PorterMatt/CherenkovDetector/PICAP (Jim Connell)/PICAP Documents/Soild State detector tests/IMG-20120413-00055.jpg

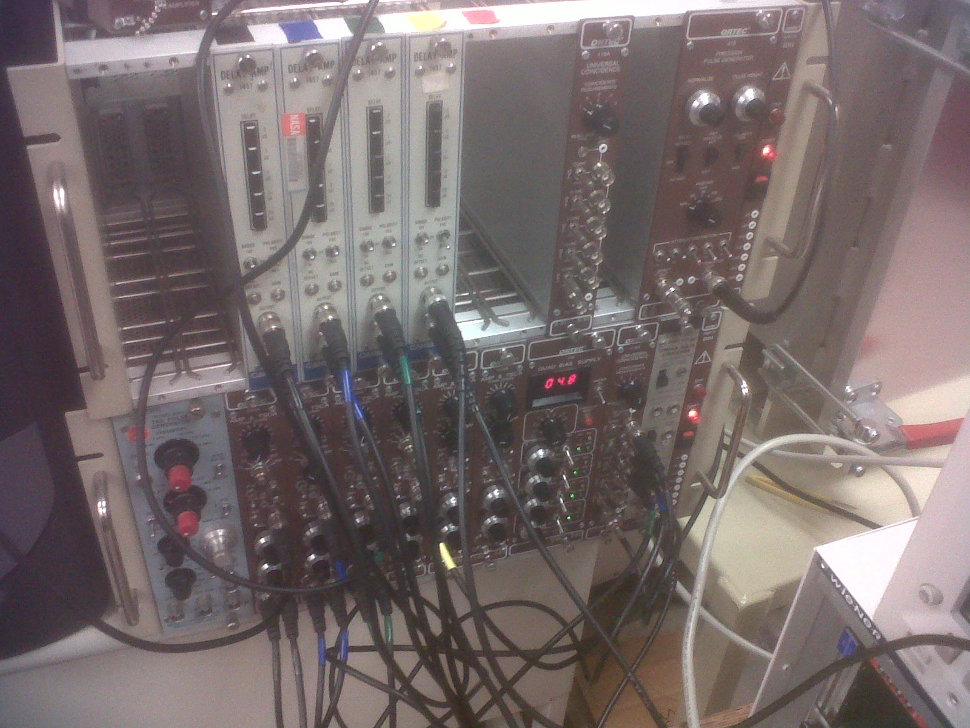
PICAP (Jim Connell)/PICAP Documents/Soild State detector tests/IMG-20120413-00055.jpg
