PorterMatt/CherenkovDetector/README.md

Cherenkov Light Detector. Matthew Porter
