PorterMatt/CherenkovDetector/PICAP (Jim Connell)/PICAP Documents/Reports and Presentations/PICAP review presentaion (2).pptx

## PICAP Design review

Brendan Bickford

## Outline

- Advisors
- Background
- Design specifications
- Concept Instrumentation
- Design Assemblies

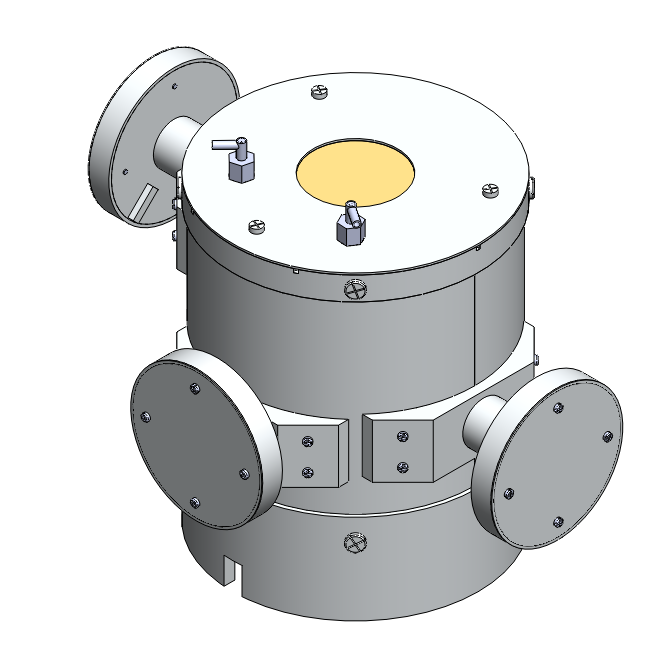
[picture p72: figure]

## Advisors

Advisors:
- Dr. May-Win Thein
- Dr. James Connell
- Dr. Clifford Lopate
Grad student:
Dan Tran

## Background

Positron Identification by Coincidental Annihilation Photons
- New design for detecting and distinguishing energetic particles (positions & negatrons)
- Project goal: Build and test a proof of principle prototype telescope

## Design Criteria and constrains

- Minimize mass within design constraints
- Specific placement and size for solid state detectors and scintillation material
- Provide efficient particle detection (structure limitations)
- Provide a working proof of principle prototype for this new detection method
- This means
- Faraday cage required
- Eliminate cross talk between scintillators
- Exclude light
- Purge ports for solid state detectors

## Flight vs. Prototype

- Conductive epoxy simple pieces rather then hog complex pieces from stock
- Custom off the self parts
- Minimize weight within budget, knowing this could be reproduced with less weight but at higher cost

## Instrument concept

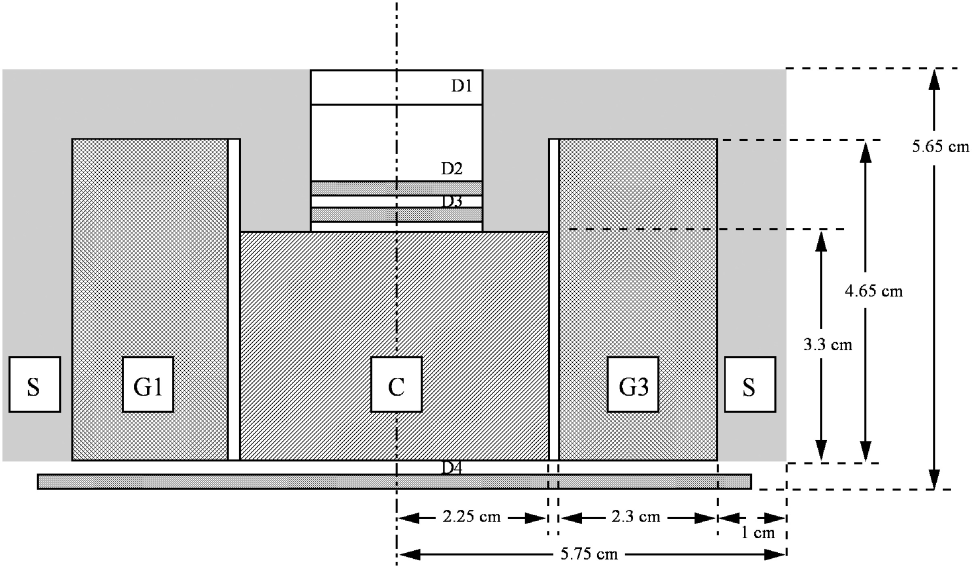
[picture p73: figure]

Cross section view of proposed design
C- Plastic scintillation material
G- Heavy scintillation material
D- Solid state detectors
S- Plastic scintillation material

## Instrument concept

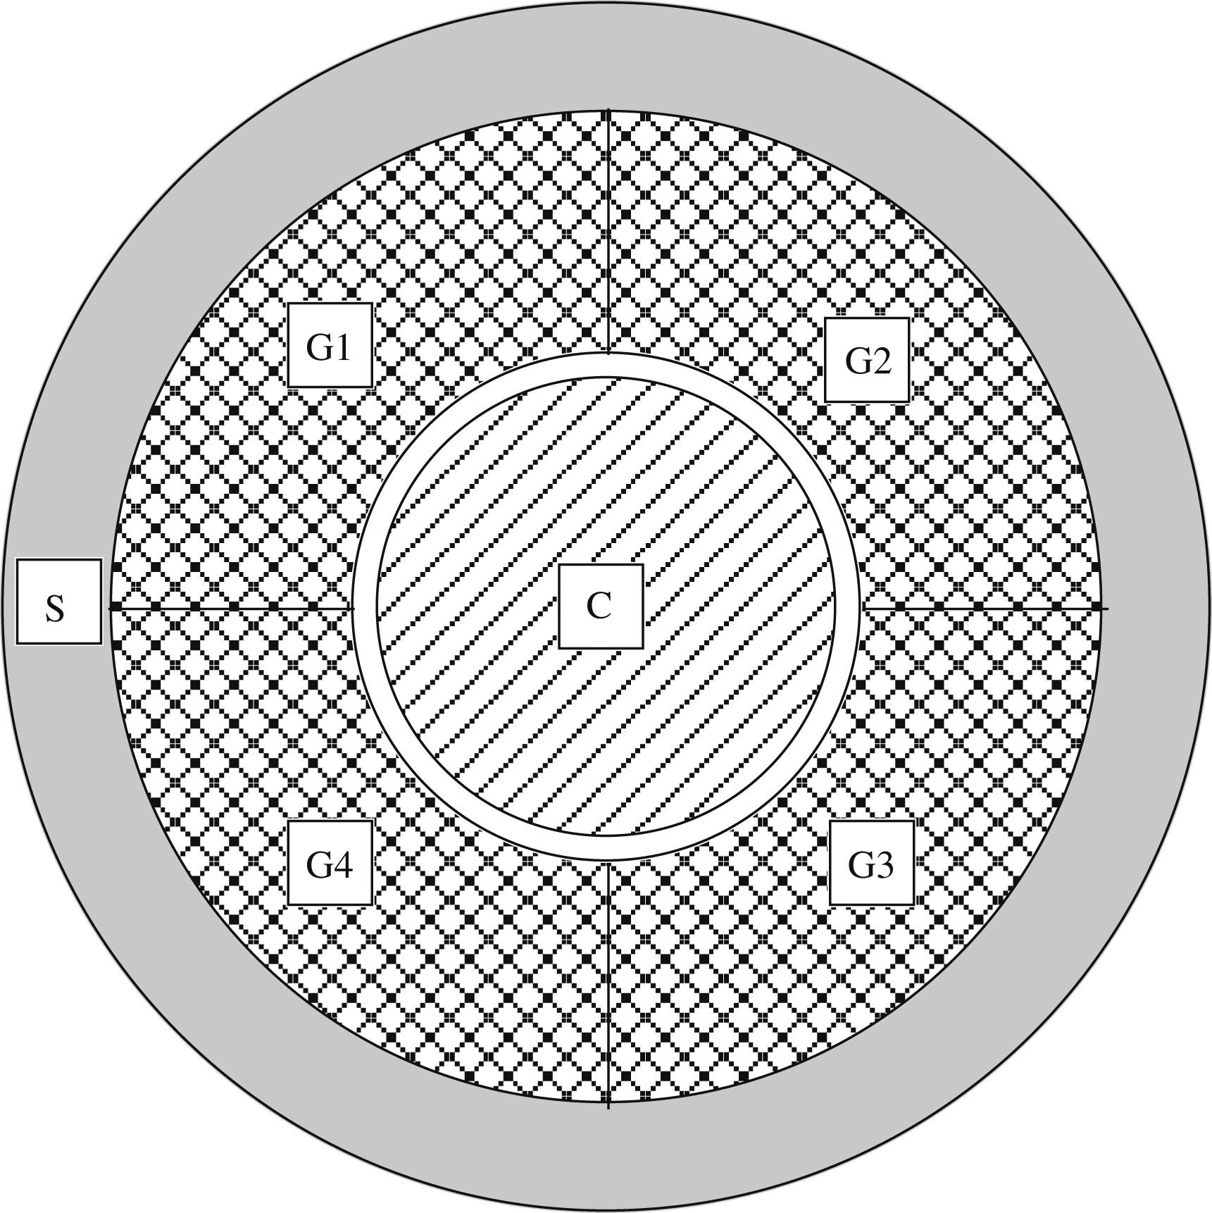
[picture p74: figure]

Top view proposed design
  - C- Plastic scintillation material
  - G- Heavy scintillation material
  - D- Solid state detectors
  - S- Plastic scintillation material

## Concept vs. Design

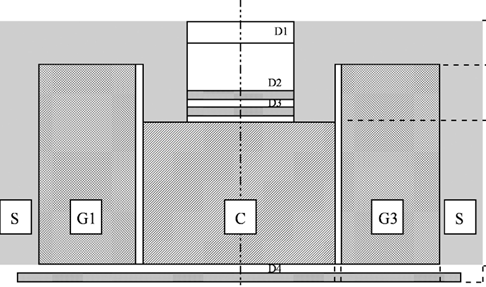
[picture p75: figure]

Cross section view
  - C- Plastic scintillation material
  - G- Heavy scintillation material
  - D- Solid state detectors
  - S- Plastic scintillation material

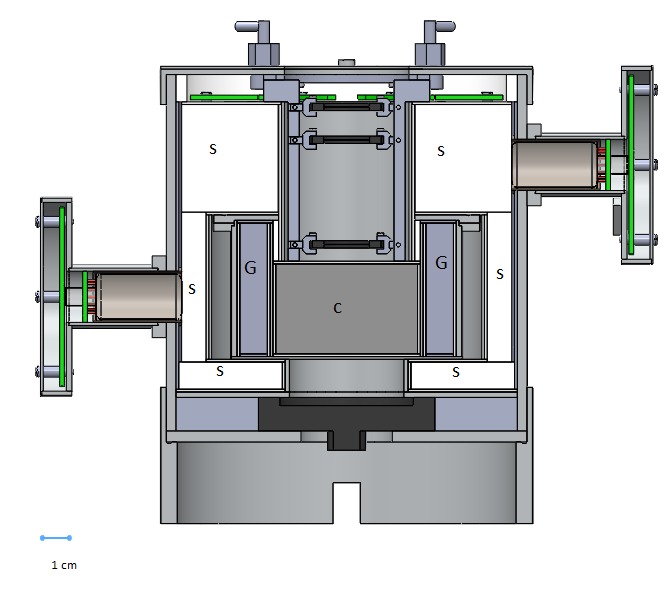
[picture p76: figure]

## Concept vs. Final design

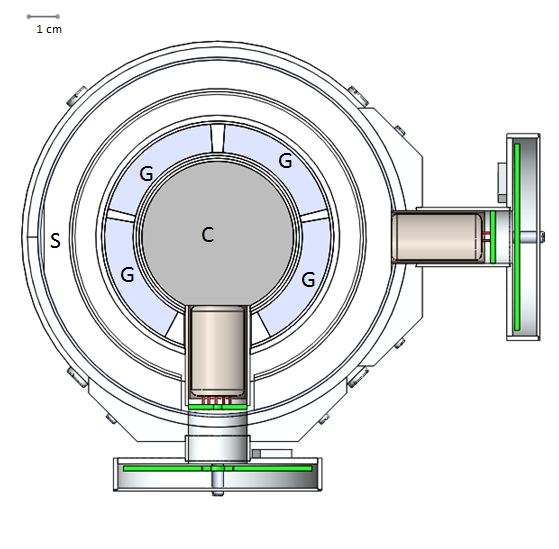
[picture p77: figure]

C- Plastic scintillation material
G- Heavy scintillation material
D- Solid state detectors
S- Plastic scintillation material

## Dimensions

Total Height | 16.78 cm
Total width | 22.47 cm
Total mass | 3.3 kg
Total Volume | 1985 cm^2

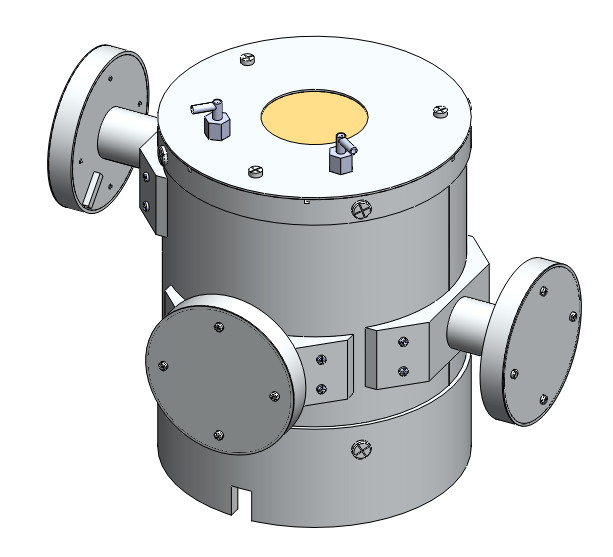
[picture p78: figure]

## Photomultiplier tube assembly

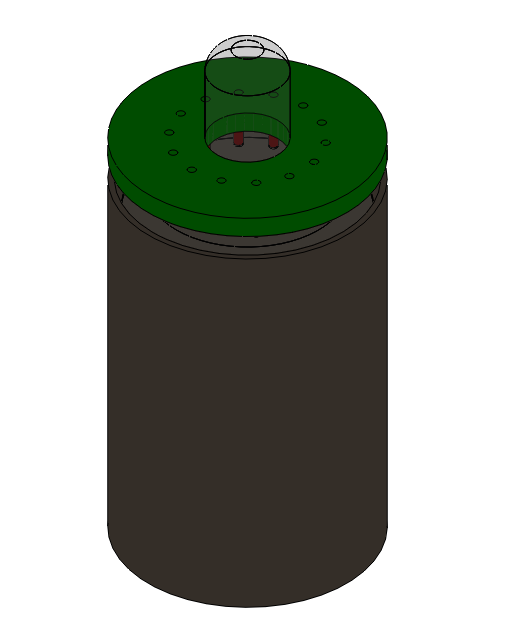
[picture p79: figure]

Red- Active components
Blue- Teflon
Black- Other

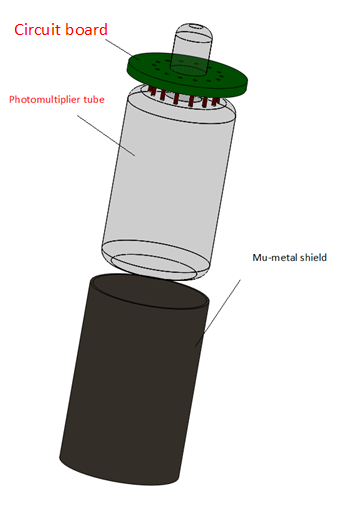
[picture p80: figure]

## Scintillator assembly

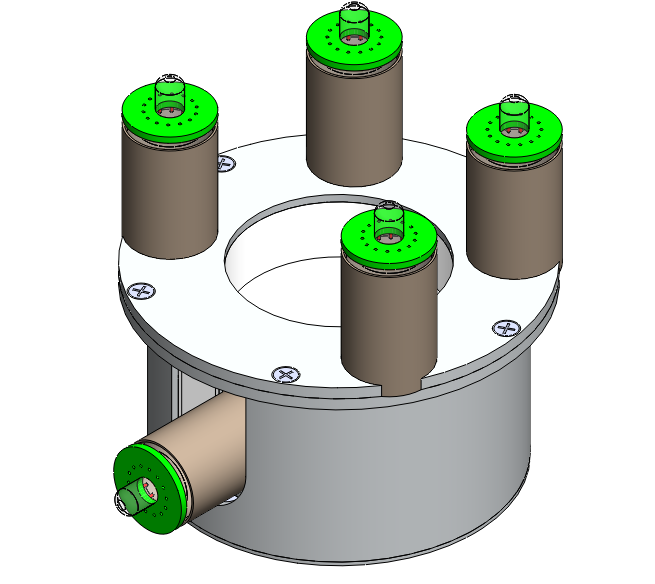
[picture p81: figure]

## Slide 14

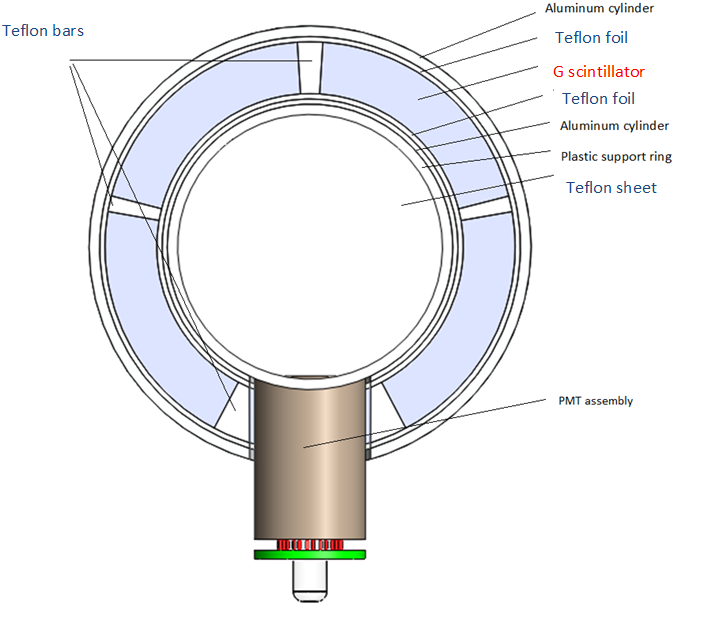
[picture p82: figure]

Scintillator assembly - top view cross section

## Slide 15

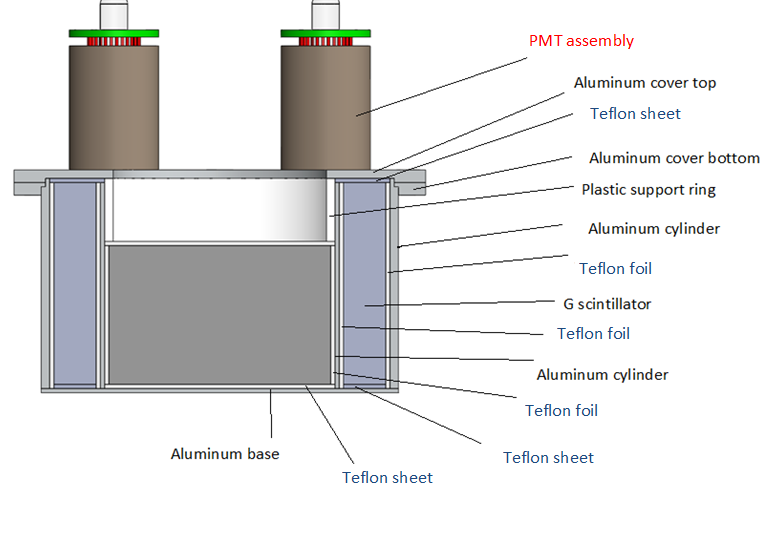
[picture p83: figure]

Scintillator assembly - center cross section

## Top Anti coincidence shield

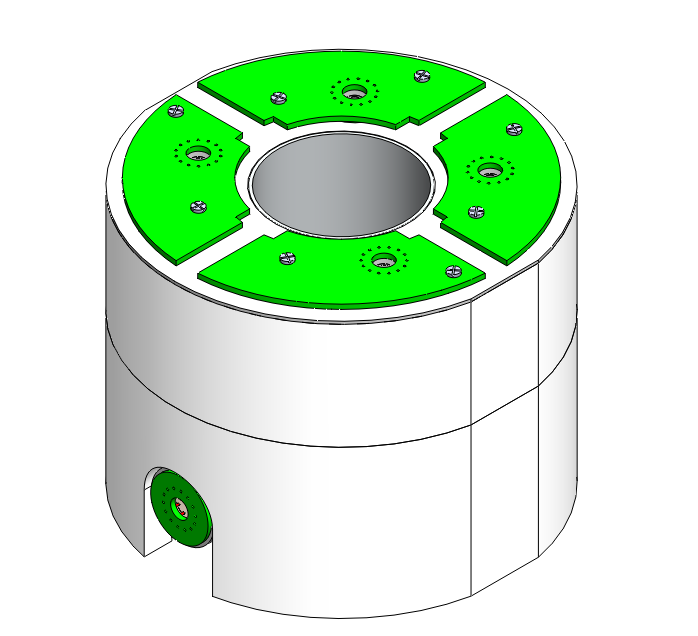
[picture p84: figure]

## Slide 17

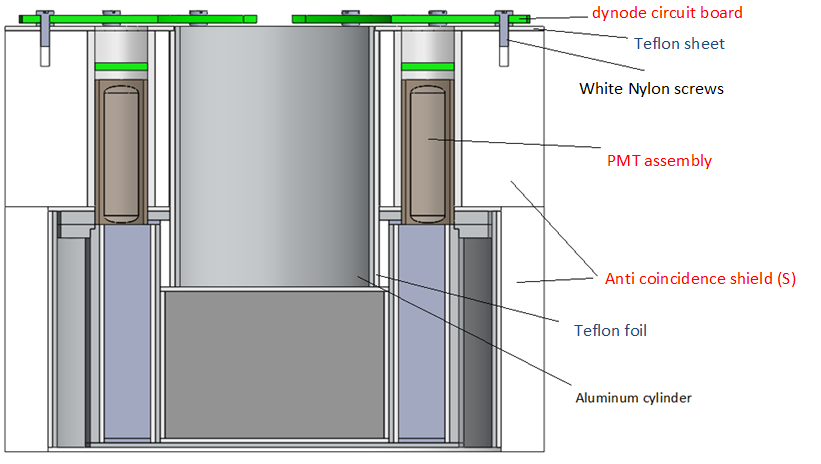
[picture p85: figure]

Anti coincidence shield – center cross section

## Slide 18

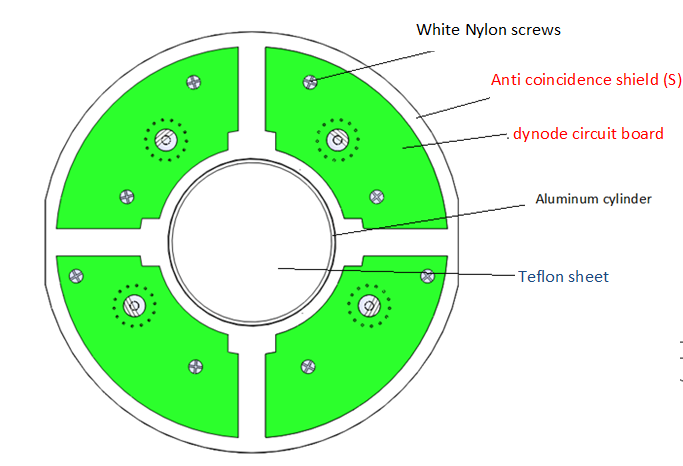
[picture p86: figure]

Anti coincidence shield - top view

Top view

## Cover assembly

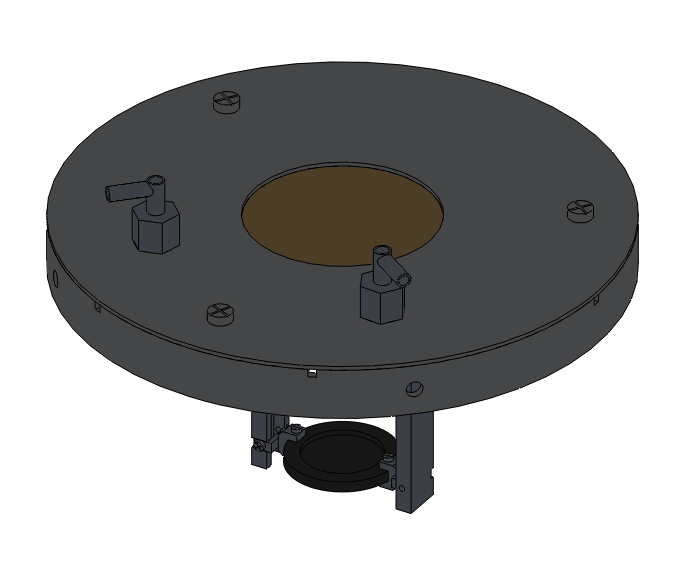
[picture p87: figure]

## Slide 20

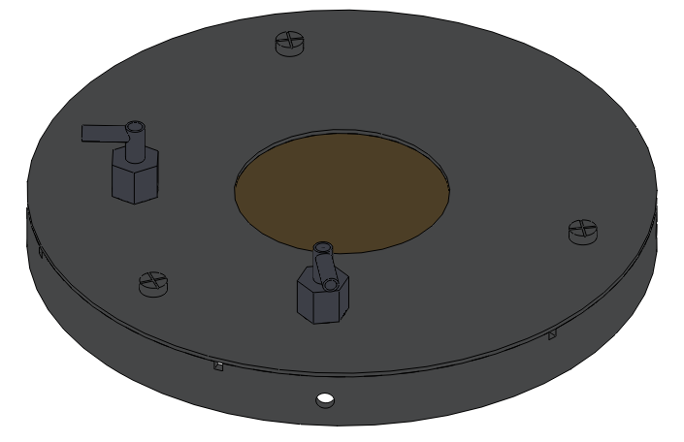
[picture p88: figure]

Cover and brass foil

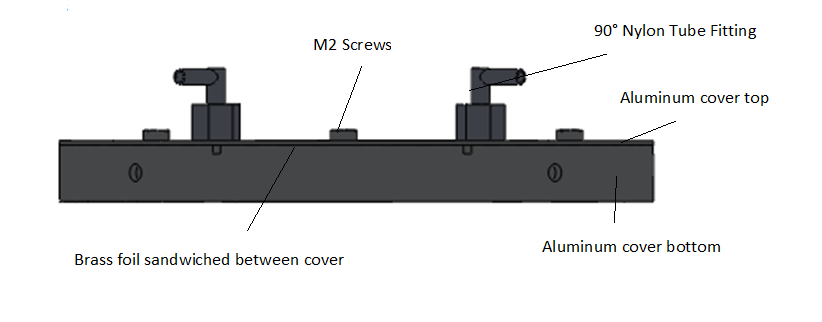
[picture p89: figure]

Cover and brass foil - side view

## Slide 21

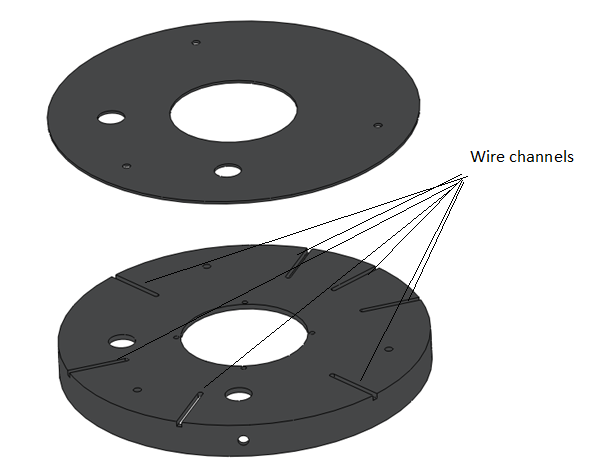
[picture p90: figure]

Cover - exploded view

## Slide 22

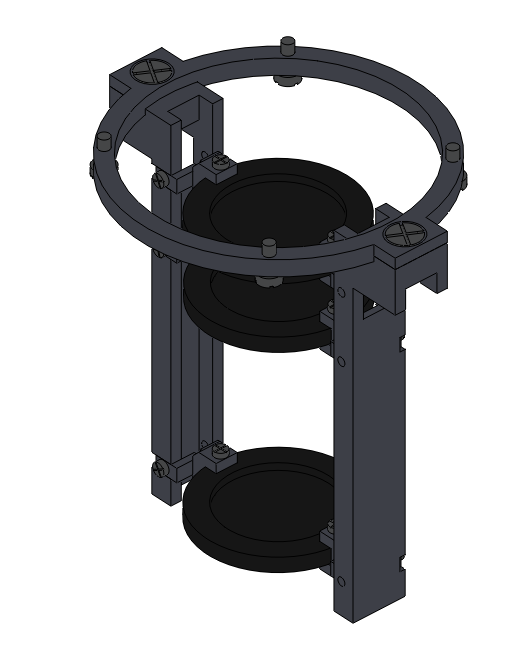
[picture p91: figure]

Solid state detector column assembly

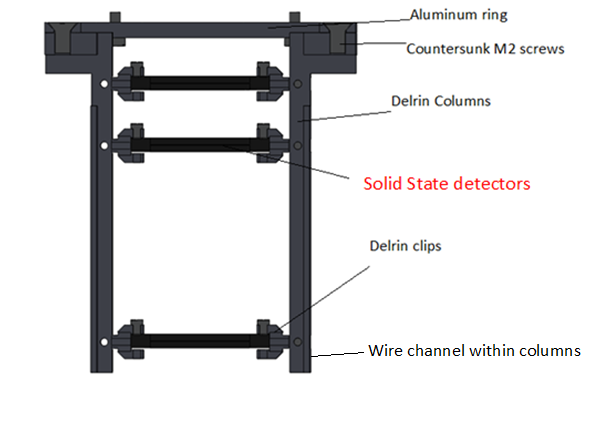
[picture p92: figure]

Center Cross section

## Base Assembly

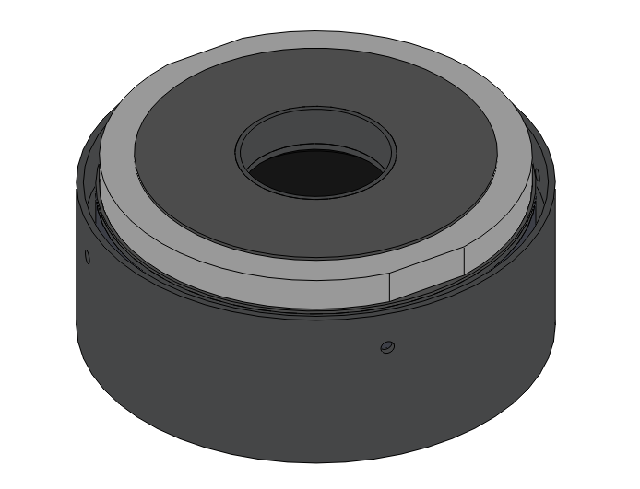
[picture p93: figure]

## Slide 24

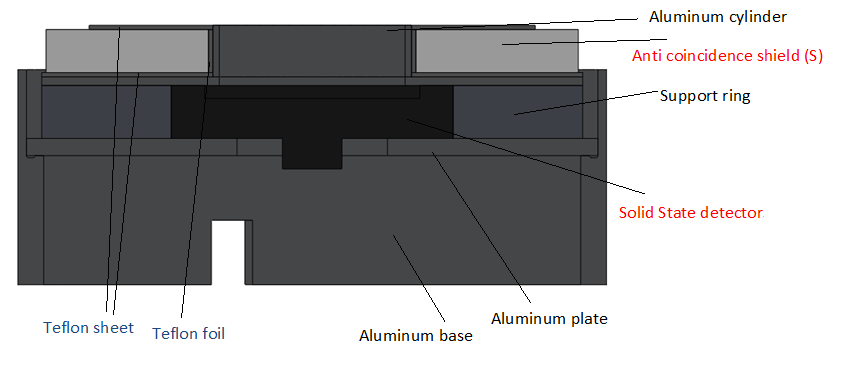
[picture p94: figure]

Base Assembly - center cross section

## Cylinder assembly

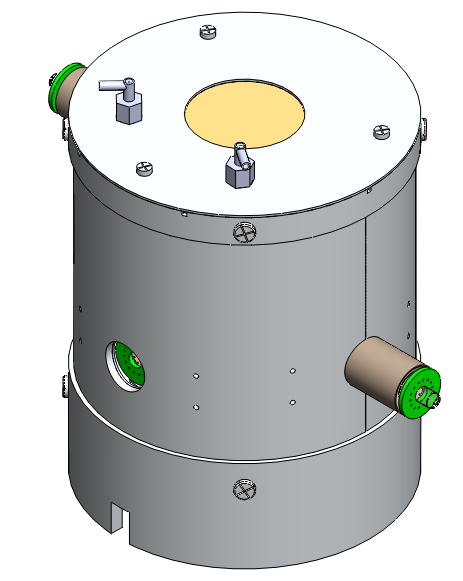
[picture p95: figure]

## Slide 26

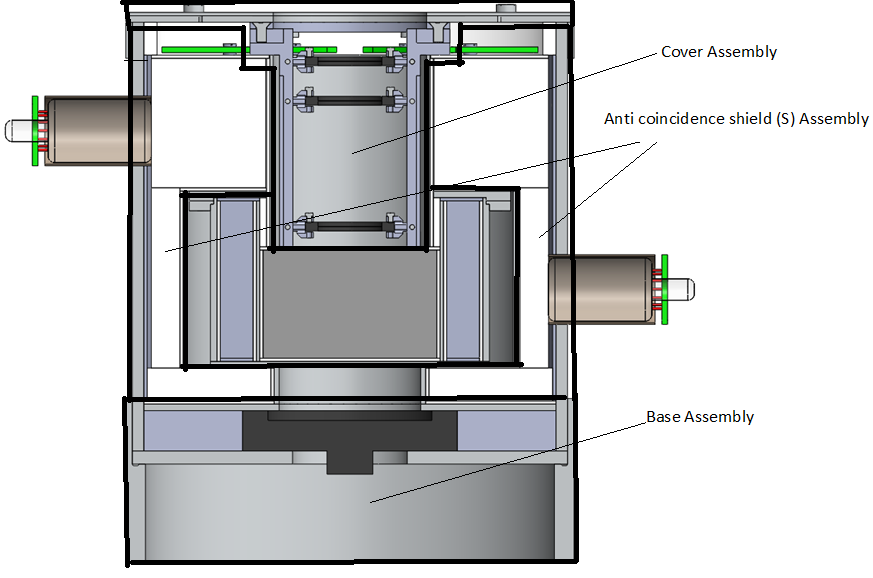
[picture p96: figure]

Cross section

Cylinder assembly - center cross section

## Photomultiplier tube support assembly

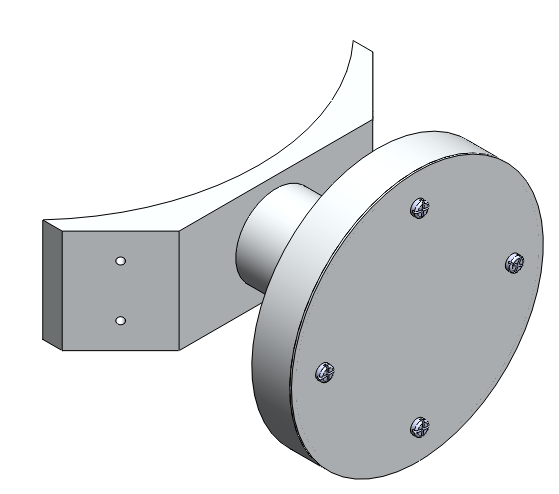
[picture p97: figure]

## Slide 28

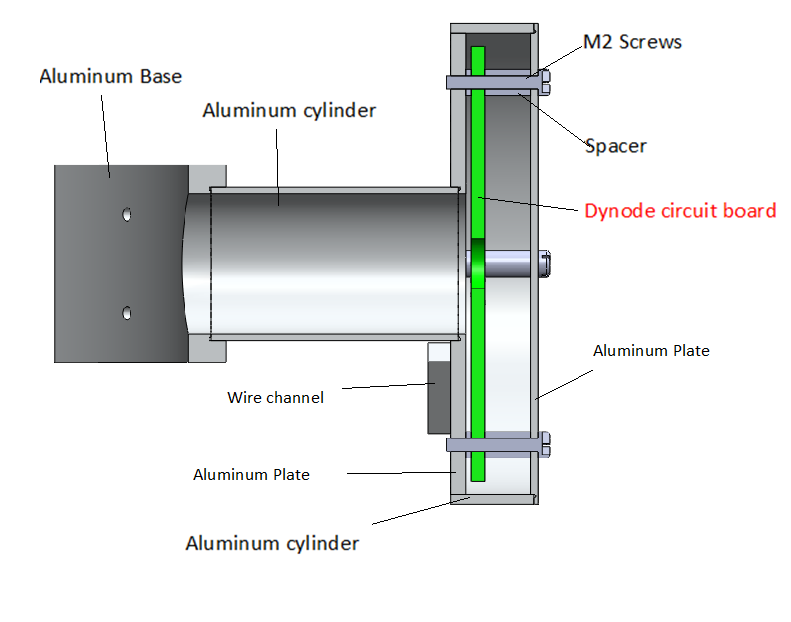
[picture p98: figure]

Photomultiplier tube support assembly – Center cross section

Top view

## Final assembly
