PorterMatt/CherenkovDetector/PICAP (Jim Connell)/PICAP Documents/Quotes/Proteus BGO.docx

Hello Brendan,

In our case, the tolerance change would only marginally affect the price, $2,050/piece. I am travelling, but will send a formal proposal over the weekend.

Thanks.

Best regards……….Philip

Philip Parkhurst

Proteus, Inc.

120 Senlac Hills Drive

Chagrin Falls, OH 44022 USA

440-247-1601

Cell: 216-470-2120

Fax:440-247-1602
