PorterMatt/CherenkovDetector/PICAP (Jim Connell)/PICAP Documents/Reports and Presentations/PICAP review presentaion.pdf

# PICAP

# Design review

# Brendan Bickford

# Outline

## - Advisors - Background - Design specifications

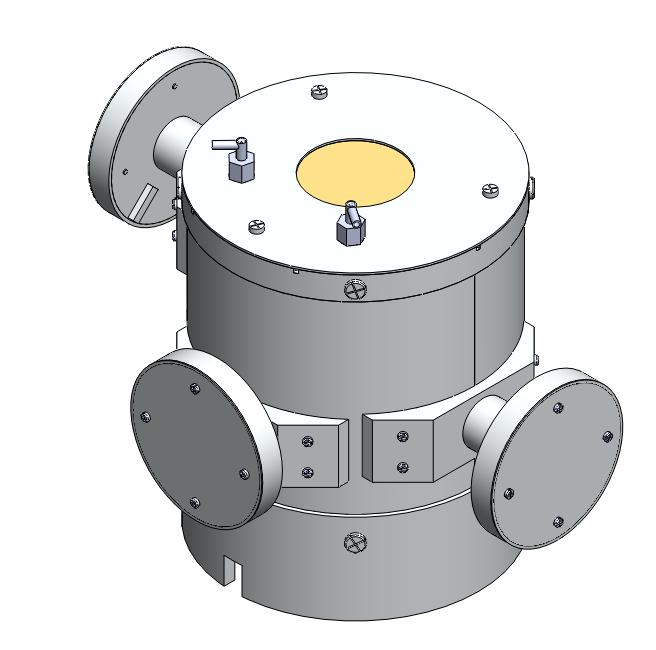
[picture p102: figure]

## - Concept Instrumentation - Design Assemblies

# Advisors

# Advisors: - Dr. May-Win Thein - Dr. James Connell - Dr. Clifford Lopate Grad student: Dan Tran

# Background

## Positron Identification by Coincidental Annihilation Photons

## - New design for detecting and distinguishing energetic particles (positrons & negatrons)

## - Project goal: Build and test a proof of principle prototype telescope

# Design Criteria and constrains

## - Minimize mass within design constraints - Specific placement and size for solid state detectors and scintillation material - Provide efficient particle detection (structure limitations) - Provide a working proof of principle prototype for this new detection method

## - This means - Faraday cage required - Eliminate cross talk between scintillators - Exclude light

- Purge ports for solid state detectors | 5

# Flight vs. Prototype

# - Conductive epoxy simple pieces rather then machine complex pieces from stock - Custom off the self parts - Minimize weight within budget, knowing this could be reproduced with less weight but at higher cost

# Instrument concept

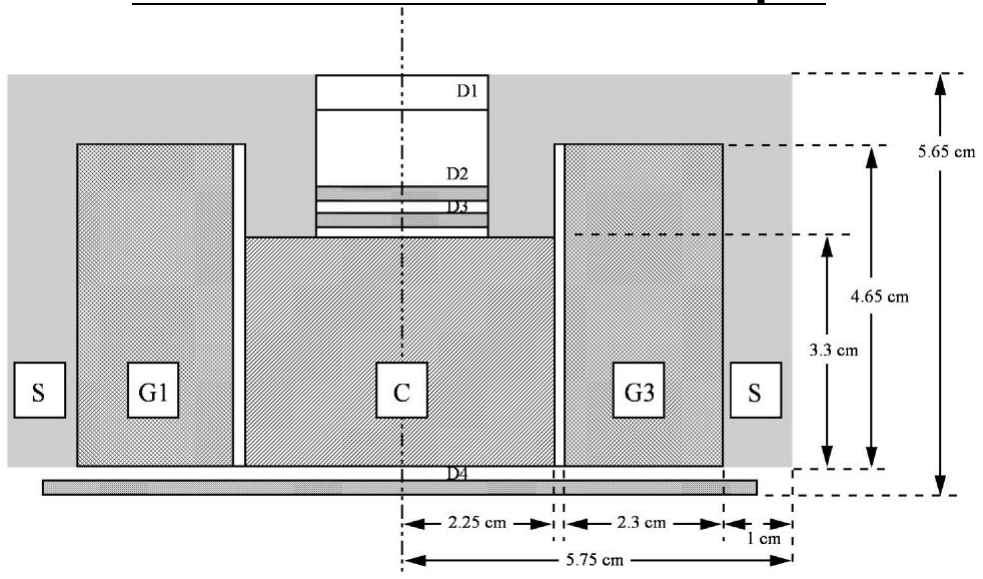
[picture p103: figure]

Cross section view of proposed design C- Plastic scintillation material G- Heavy scintillation material D- Solid state detectors
S- Plastic scintillation material

# Instrument concept

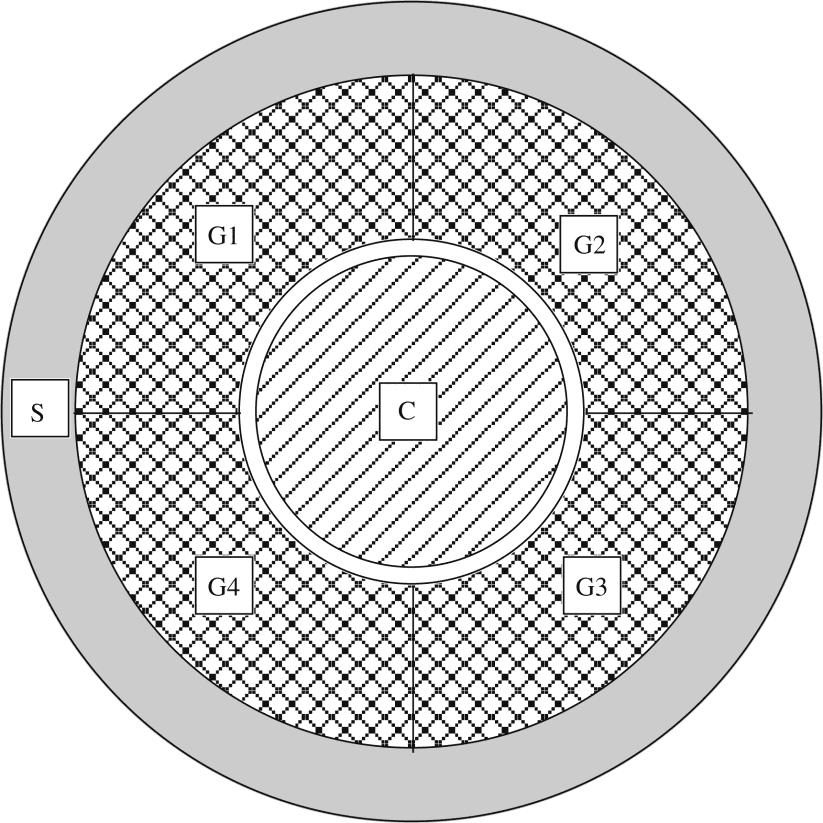
[picture p104: figure]

Top view proposed design
– C- Plastic scintillation material – G- Heavy scintillation material – D- Solid state detectors
– S- Plastic scintillation material

# Concept vs. Design

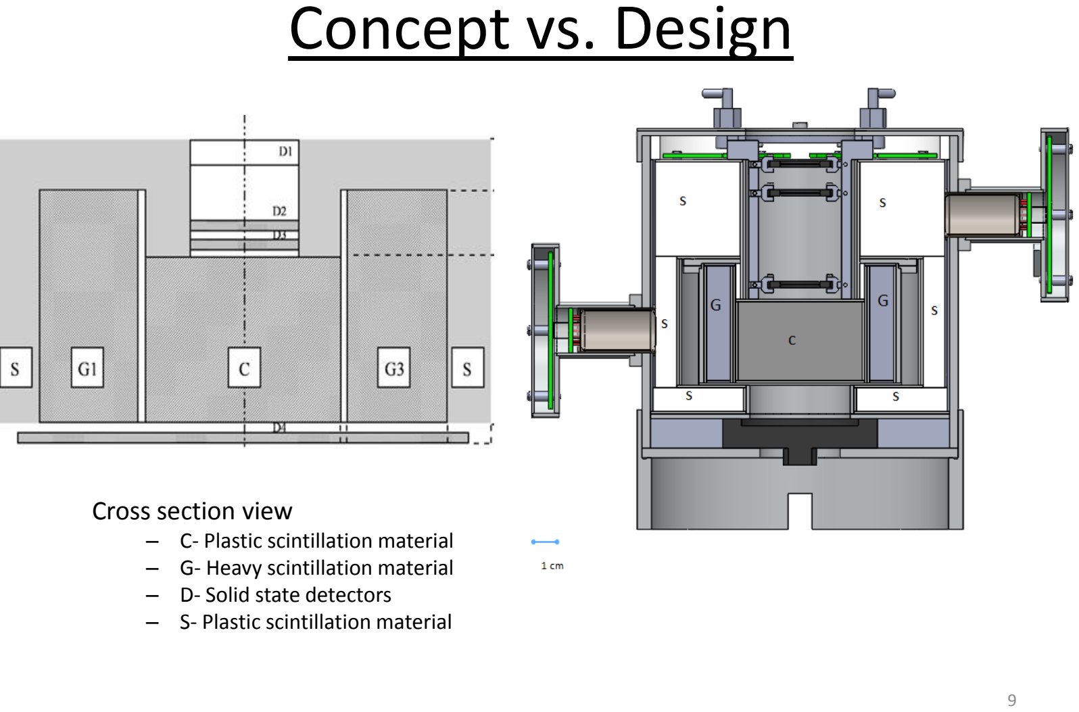
[picture p105: page 9]

Cross section view
– C- Plastic scintillation material – G- Heavy scintillation material – D- Solid state detectors
– S- Plastic scintillation material

# Concept vs. Final design

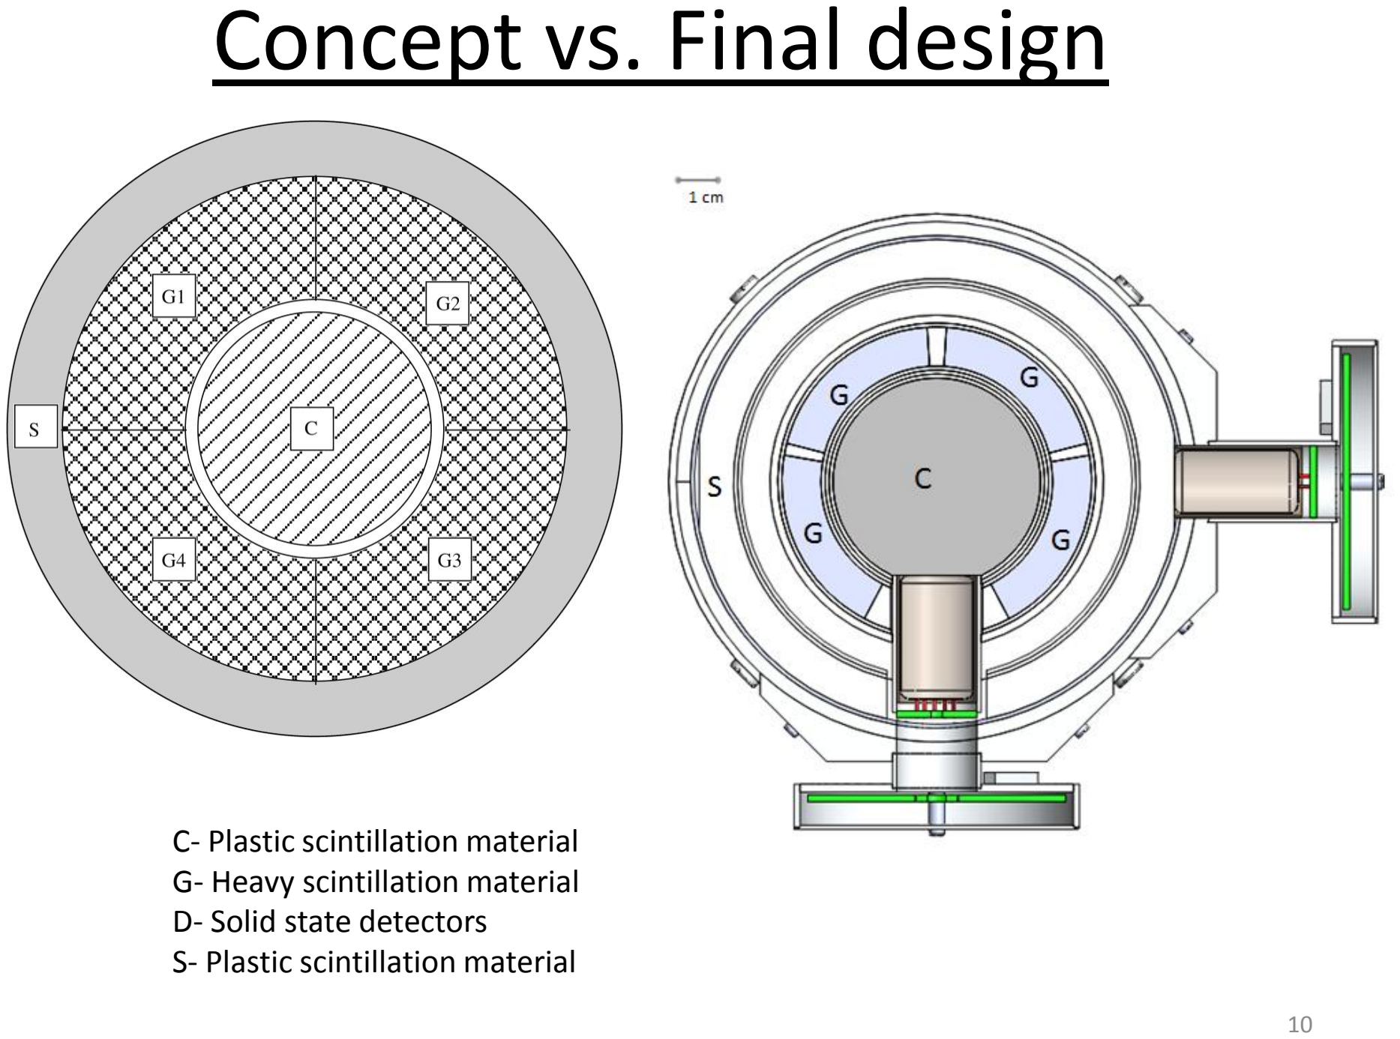
[picture p106: page 10]

C- Plastic scintillation material G- Heavy scintillation material D- Solid state detectors
S- Plastic scintillation material

# Dimensions

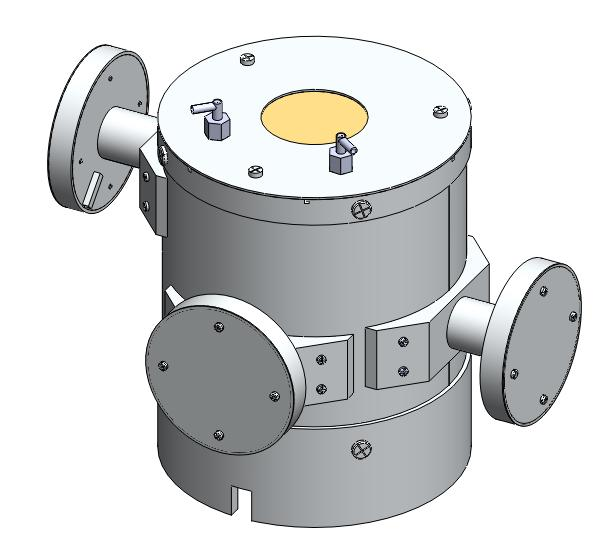
[picture p107: figure]

Total Height | 16.78 cm
Total width | 22.47 cm
Total mass | 3.3 kg
Total Volume | 1985 cm^3

# Photomultiplier tube assembly

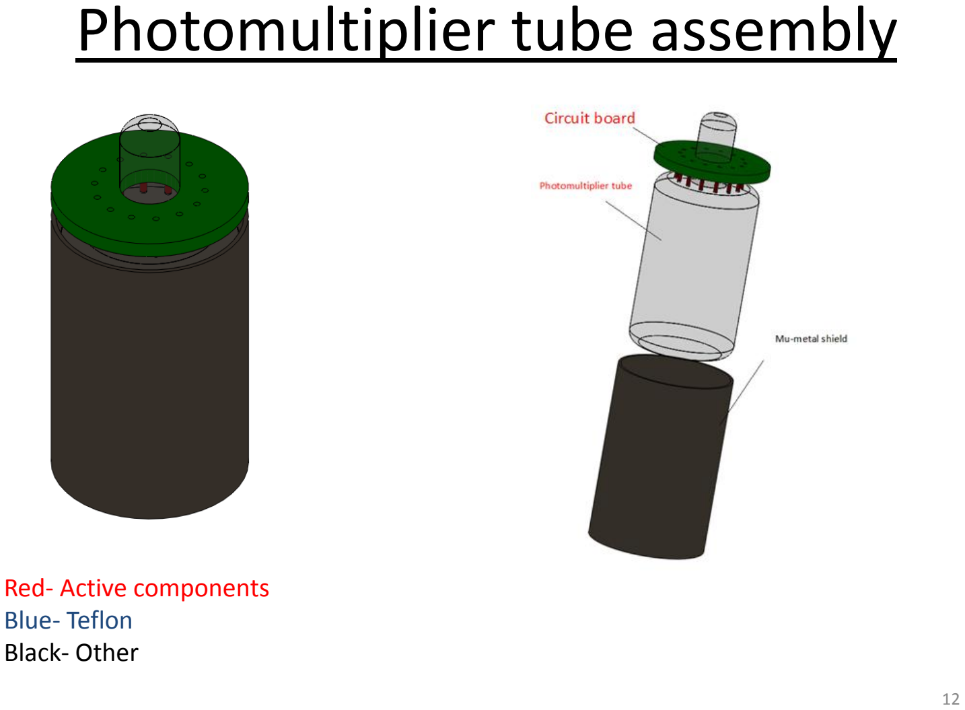
[picture p108: page 12]

Red- Active components
Blue- Teflon
Black- Other

# Scintillator assembly

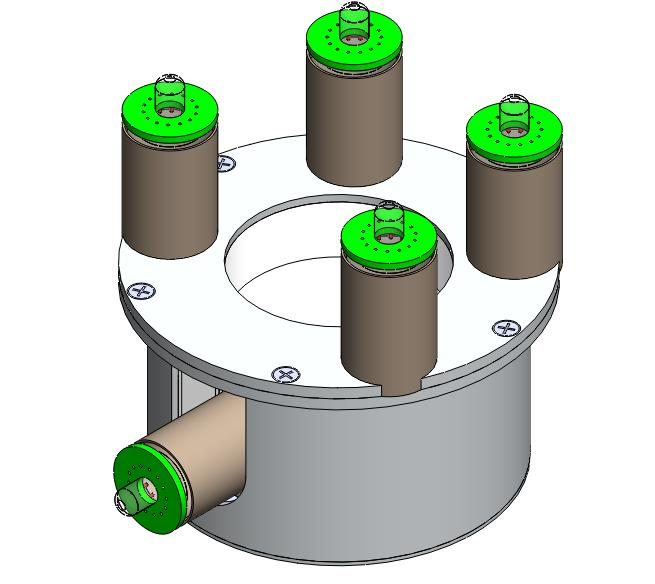
[picture p109: figure]
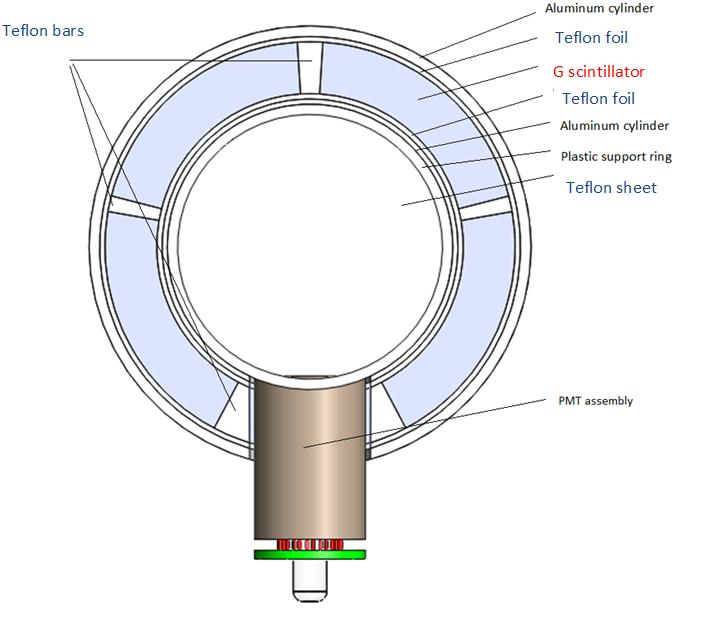
[picture p110: page 14]

Scintillator assembly - top view cross section | 14


Scintillator assembly - center cross section

# Top Anti coincidence shield

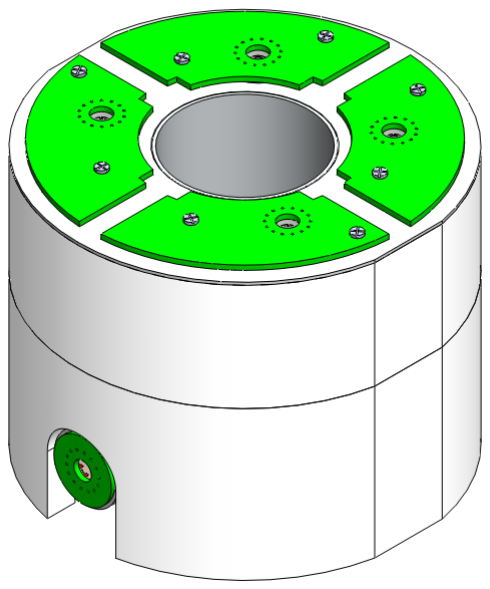
[picture p111: figure]


Anti coincidence shield – center cross section

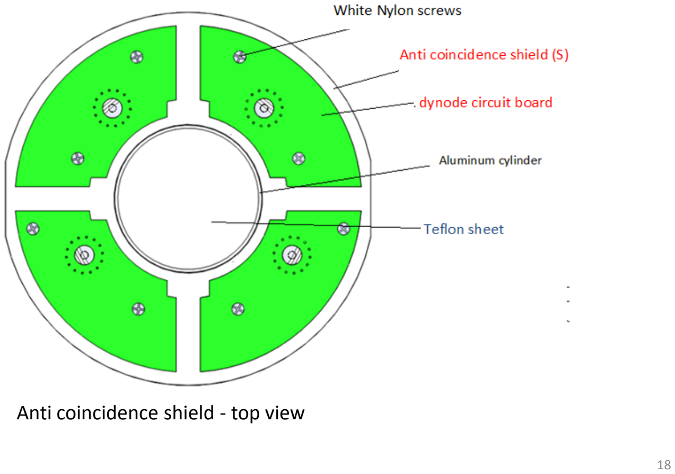
[picture p112: page 18]

Top view

Anti coincidence shield - top view

# Cover assembly

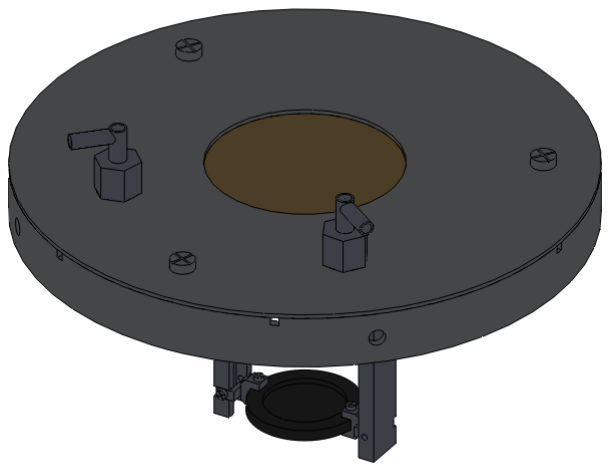
[picture p113: figure]
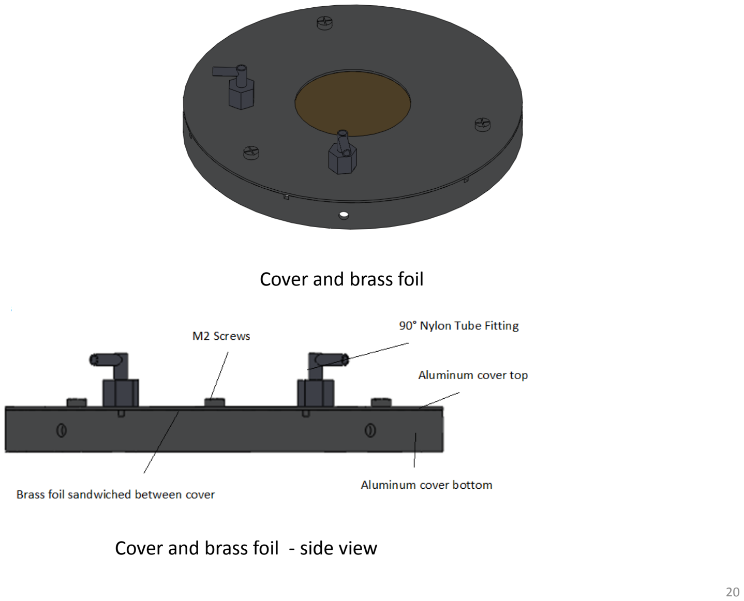
[picture p114: page 20]

Cover and brass foil - side view

Cover and brass foil

Cover

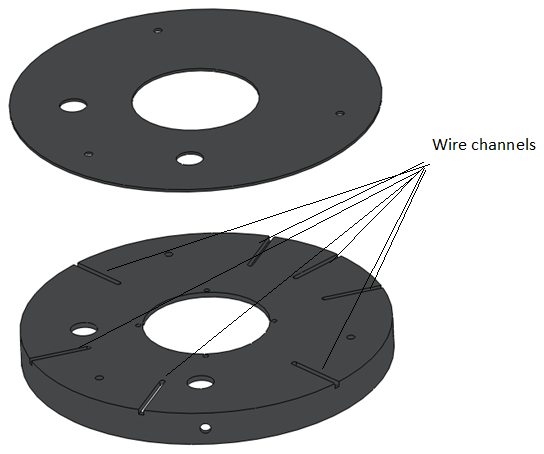
[picture p115: figure]

- exploded view

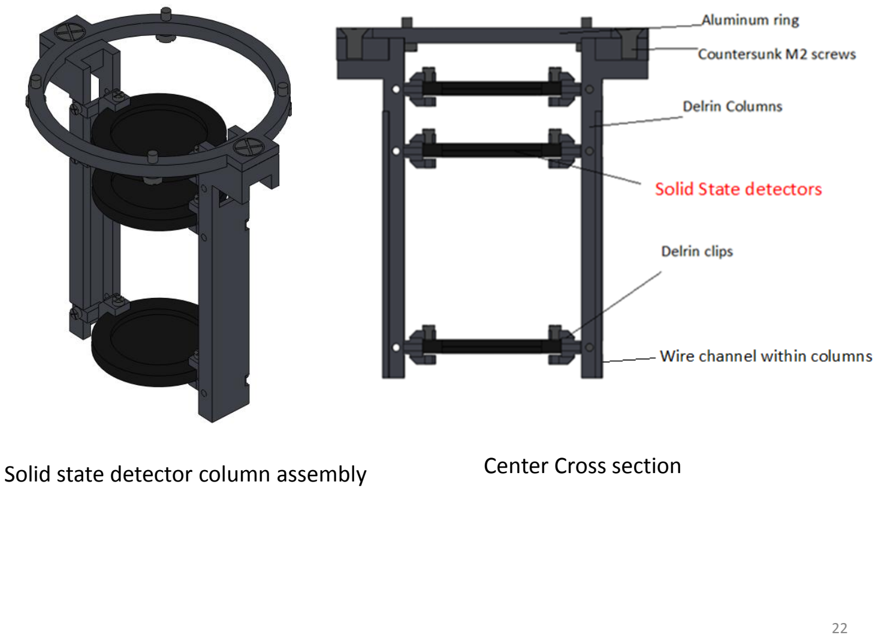
[picture p116: page 22]

Center Cross section
Solid state detector column assembly

# Base Assembly

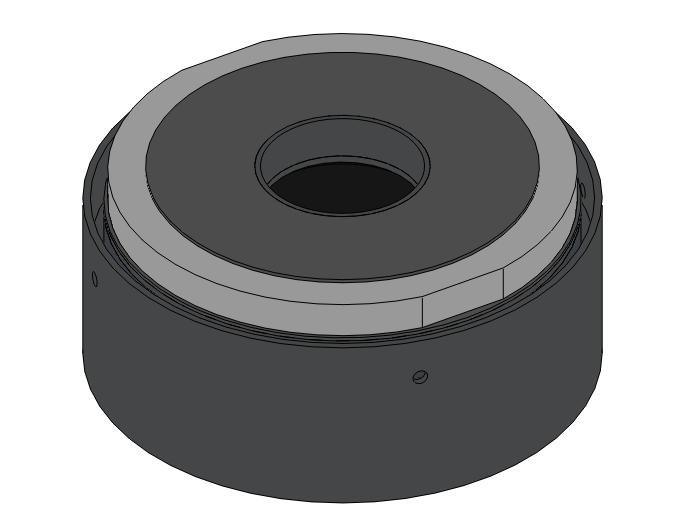
[picture p117: figure]


Base Assembly - center cross section

# Cylinder assembly

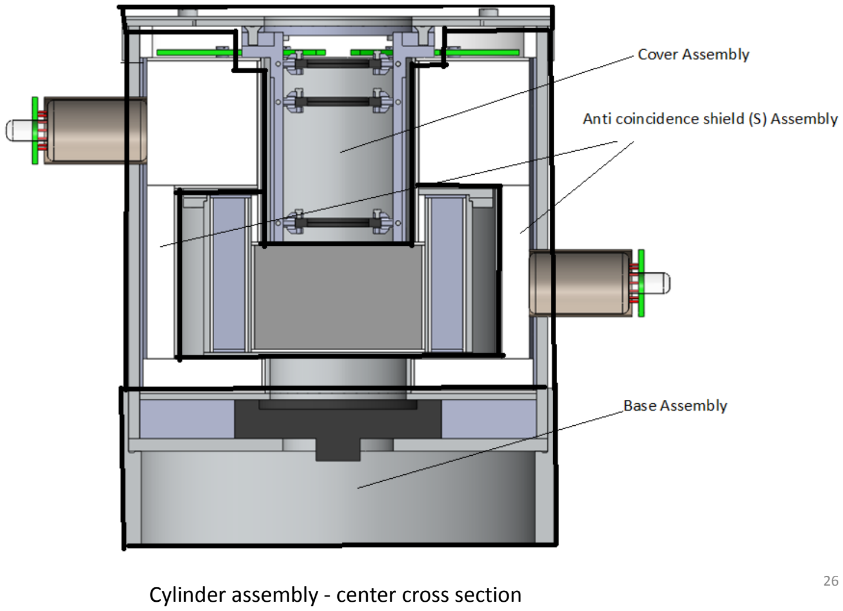
[picture p118: page 26]

Cross section

Cylinder assembly

- center cross section

# Photomultiplier tube support assembly

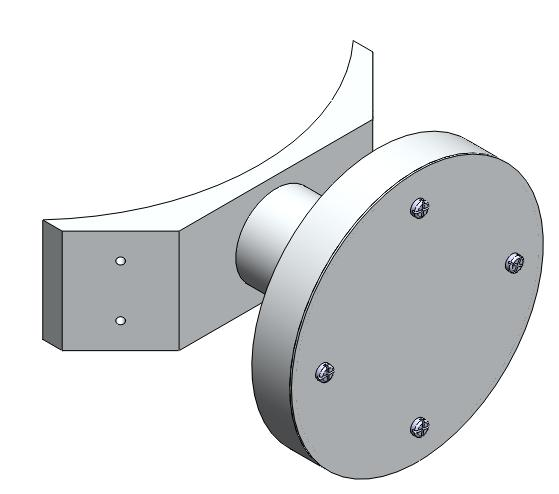
[picture p119: figure]
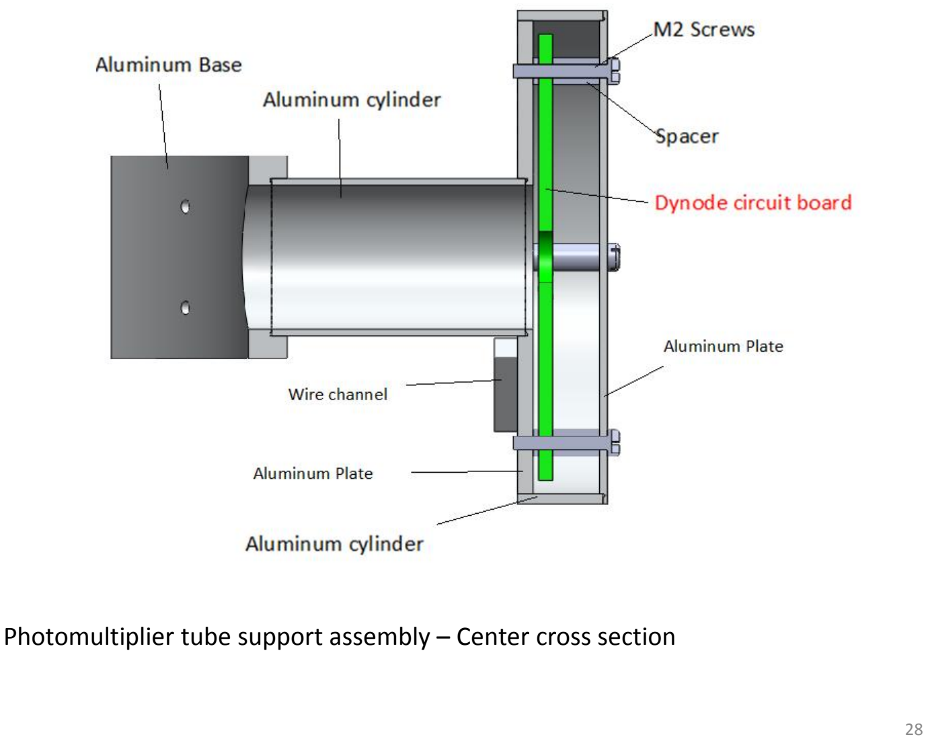
[picture p120: page 28]

Top view

Photomultiplier tube support assembly – Center cross section

# Final assembly
