PorterMatt/CherenkovDetector/Capture.JPG

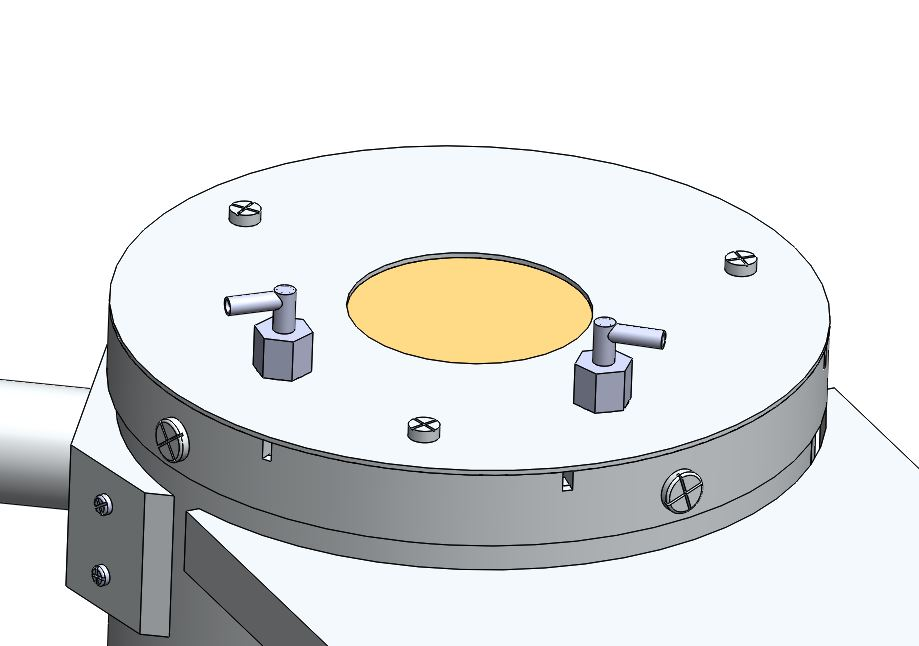
Capture.JPG
