PorterMatt/CherenkovDetector/Lightbox_1.JPG

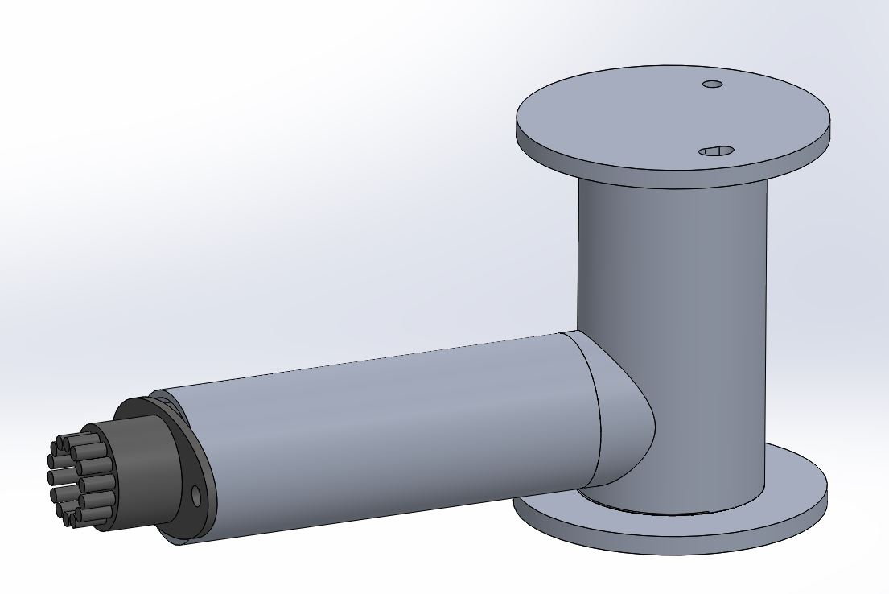
Lightbox_1.JPG
