PorterMatt/CherenkovDetector/Lightbox_2.JPG

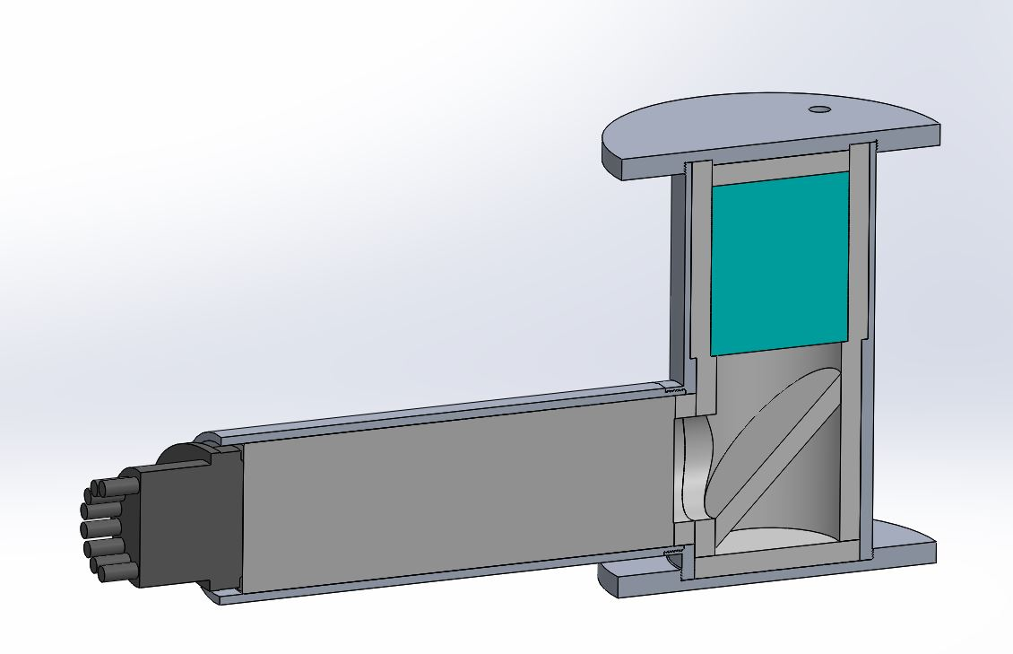
Lightbox_2.JPG
