PorterMatt/CherenkovDetector/Lightbox_3.JPG

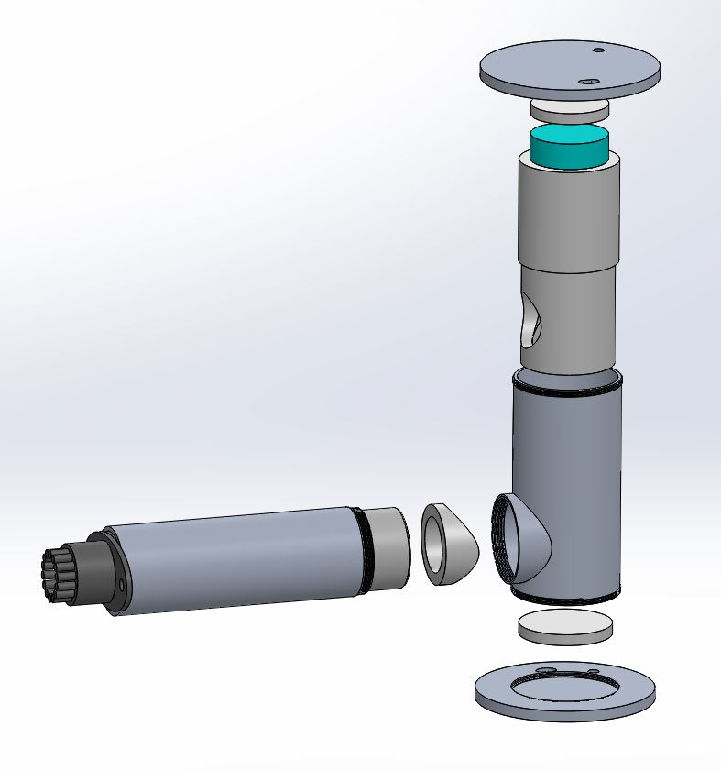
Lightbox_3.JPG
