PorterMatt/CherenkovDetector/LightPulser/Source_2/IMG_5587.jpg

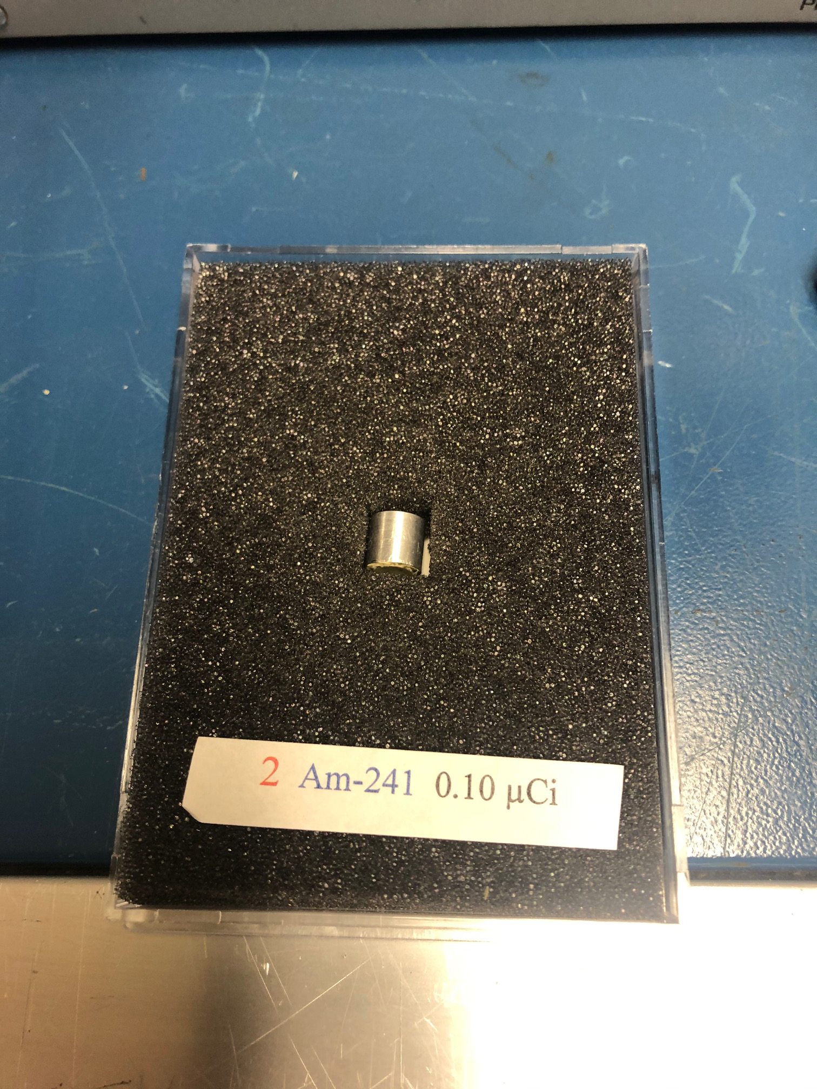
LightPulser/Source_2/IMG_5587.jpg
