PorterMatt/CherenkovDetector/LightPulser/Source_2/IMG_5588.jpg

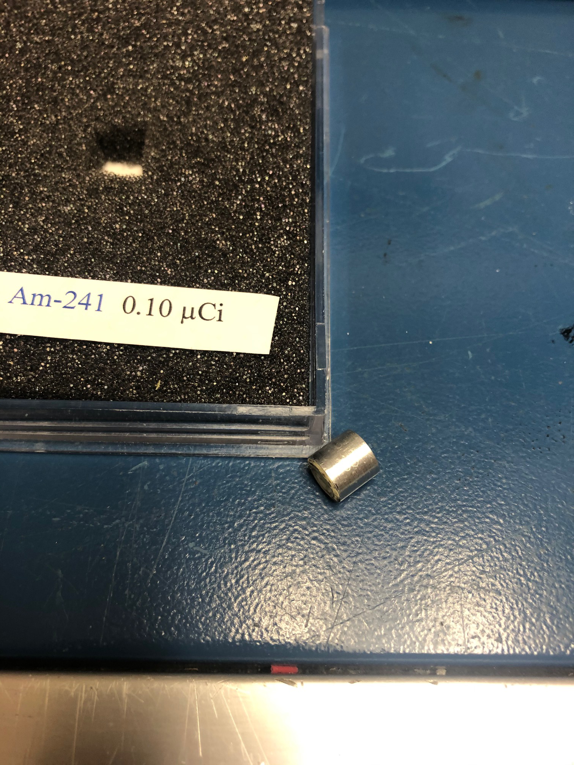
LightPulser/Source_2/IMG_5588.jpg
