PorterMatt/CherenkovDetector/LightPulser/Source_2/IMG_5589.jpg

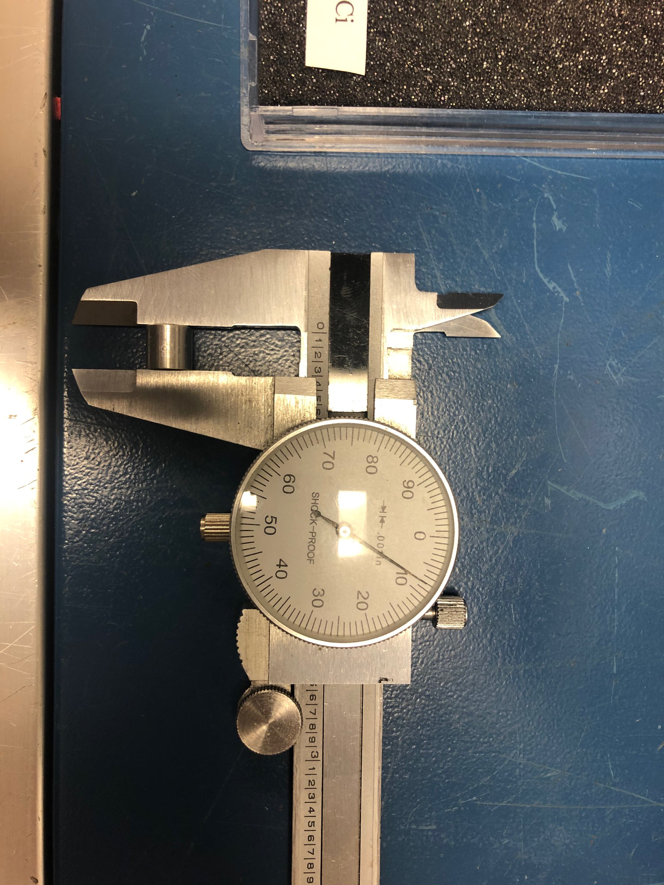
LightPulser/Source_2/IMG_5589.jpg
