PorterMatt/CherenkovDetector/LightPulser/Source_2/IMG_5590.jpg

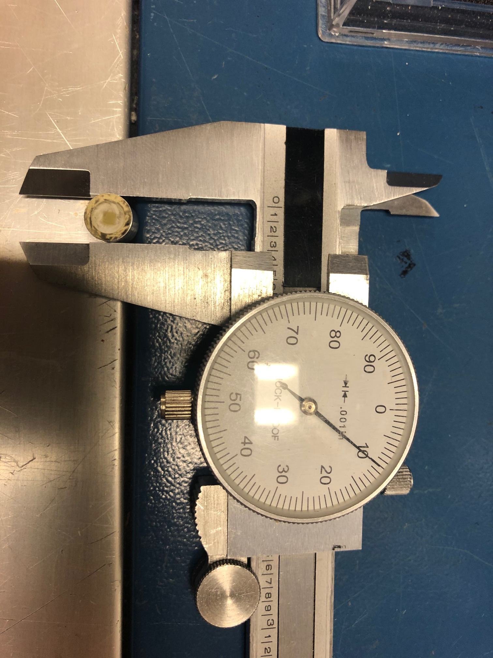
LightPulser/Source_2/IMG_5590.jpg
