PorterMatt/CherenkovDetector/LightPulser/Source_36/IMG_5591.jpg

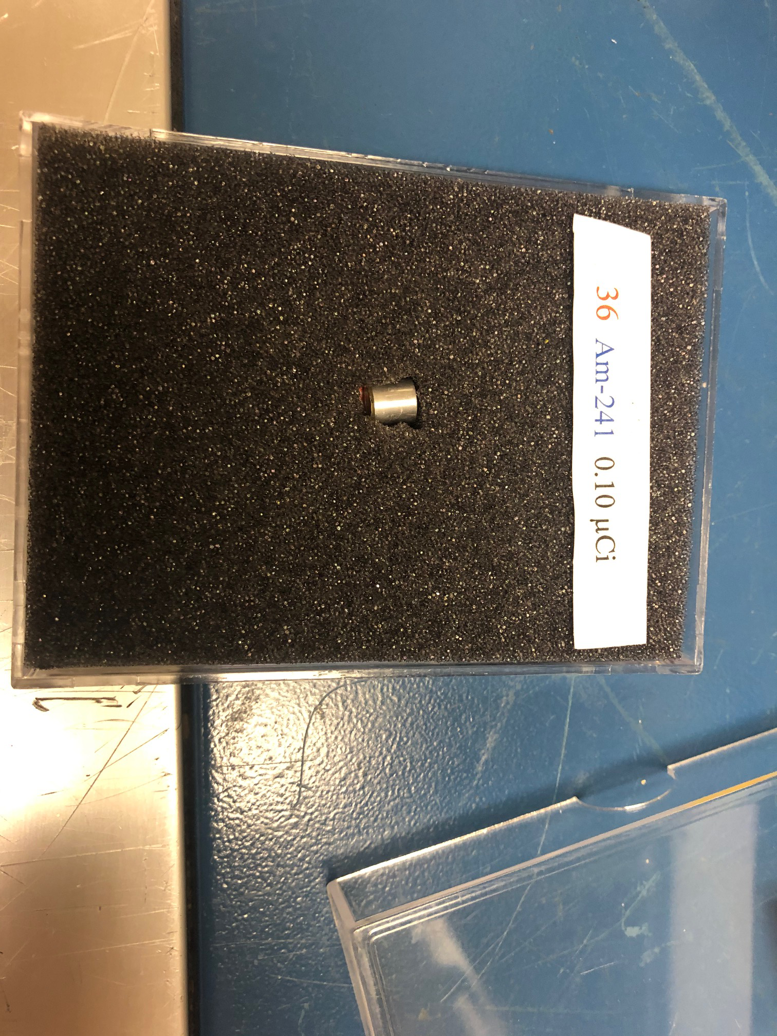
LightPulser/Source_36/IMG_5591.jpg
