PorterMatt/CherenkovDetector/LightPulser/Source_36/IMG_5592.jpg

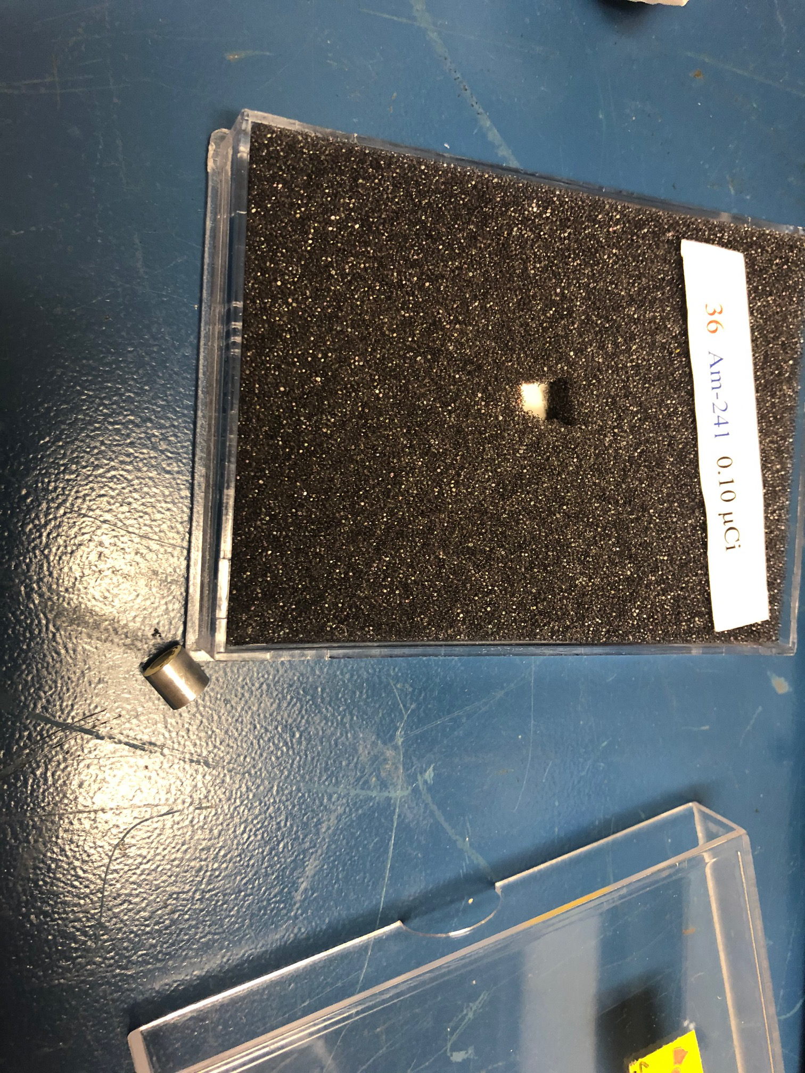
LightPulser/Source_36/IMG_5592.jpg
