PorterMatt/CherenkovDetector/LightPulser/Source_36/IMG_5593.jpg

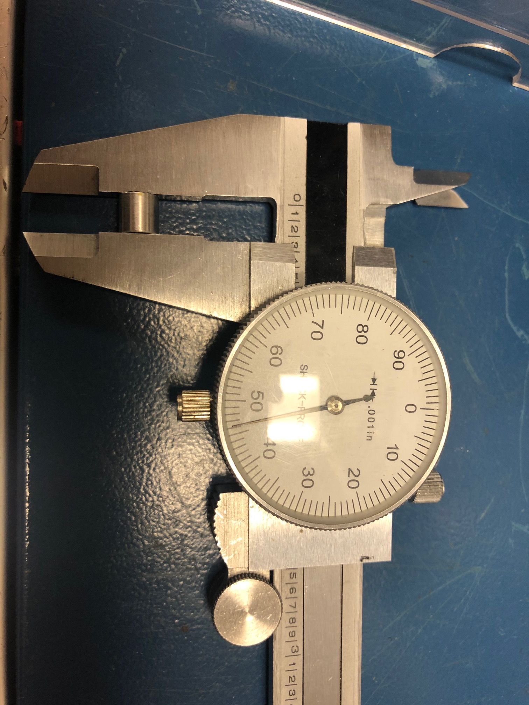
LightPulser/Source_36/IMG_5593.jpg
