PorterMatt/CherenkovDetector/LightPulser/Source_36/IMG_5594.jpg

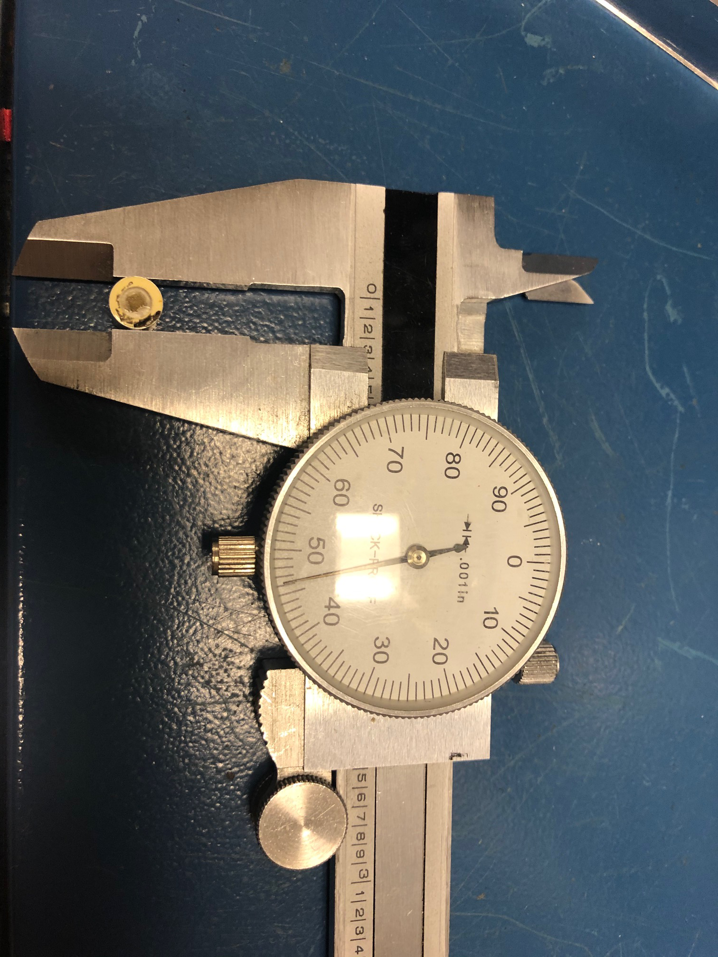
LightPulser/Source_36/IMG_5594.jpg
