PorterMatt/CherenkovDetector/LightPulser/Source_37/IMG_5596.jpg

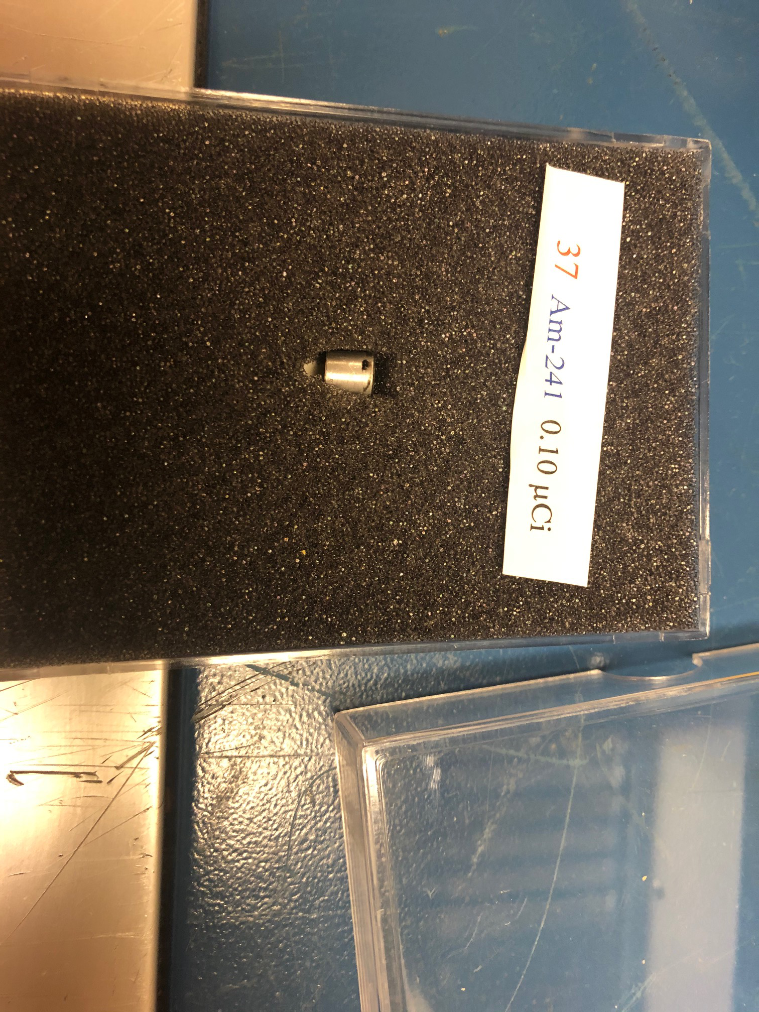
LightPulser/Source_37/IMG_5596.jpg
