PorterMatt/CherenkovDetector/LightPulser/Source_37/IMG_5597.jpg

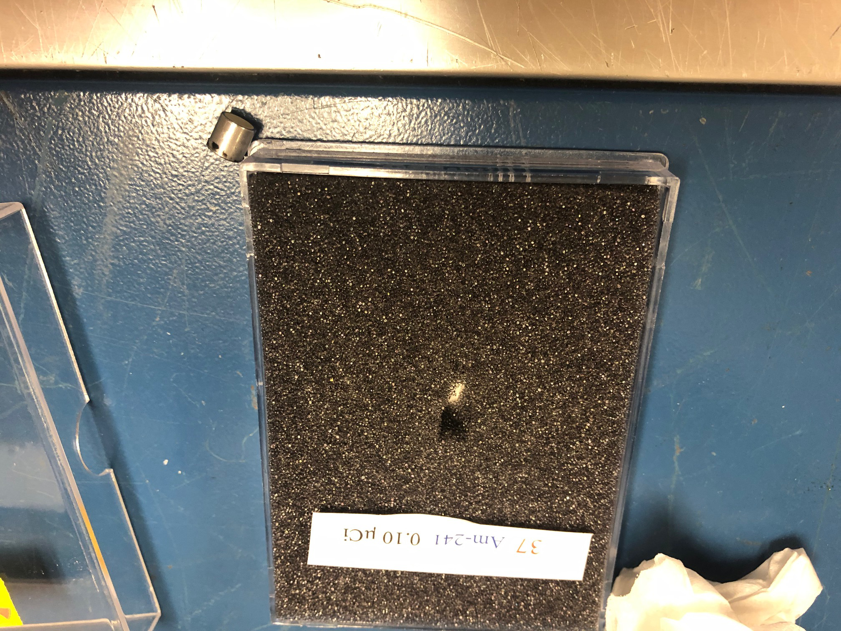
LightPulser/Source_37/IMG_5597.jpg
