PorterMatt/CherenkovDetector/LightPulser/Source_37/IMG_5598.jpg

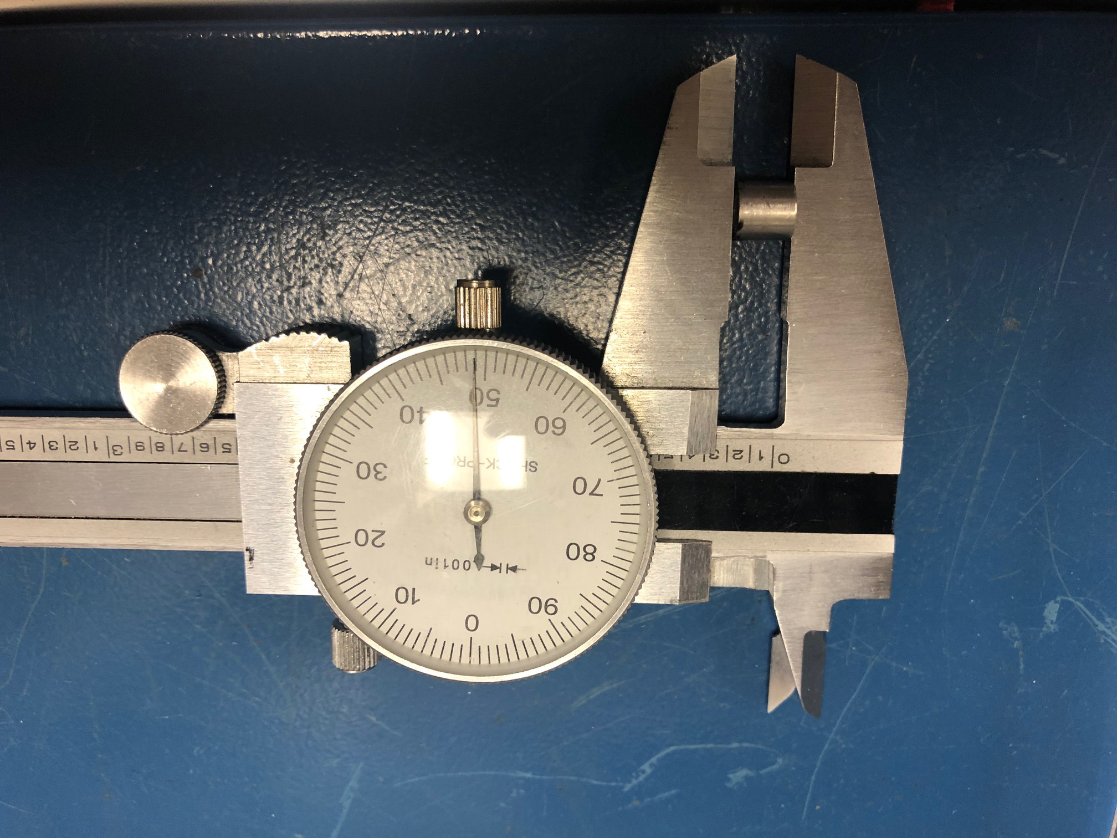
LightPulser/Source_37/IMG_5598.jpg
