PorterMatt/CherenkovDetector/LightPulser/Source_37/IMG_5599.jpg

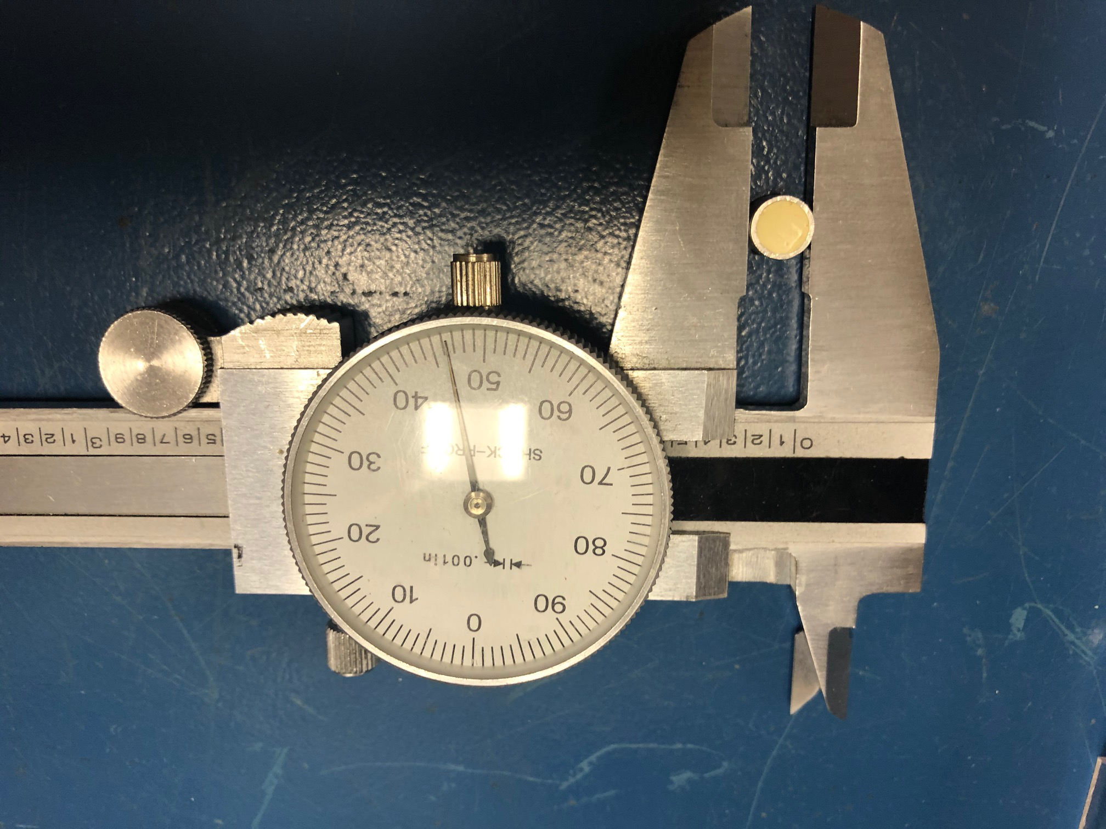
LightPulser/Source_37/IMG_5599.jpg
