PorterMatt/CherenkovDetector/PeerReview1.JPG

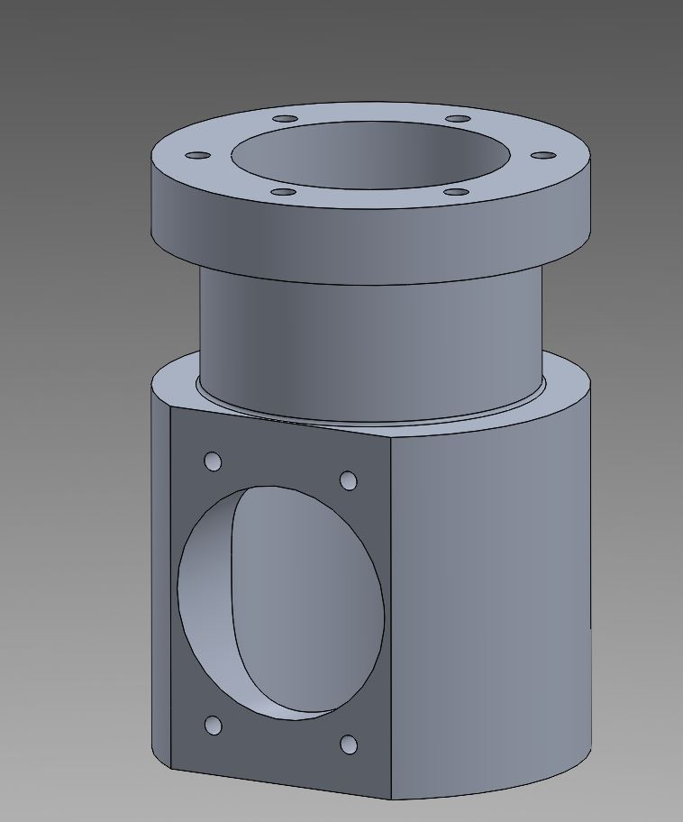
PeerReview1.JPG
