PorterMatt/CherenkovDetector/PeerReview2.JPG

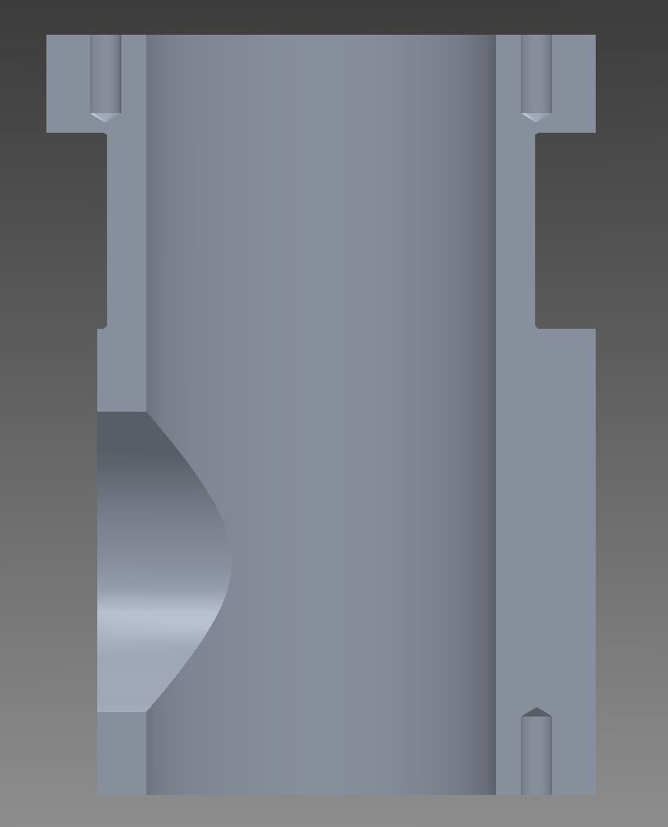
PeerReview2.JPG
