PorterMatt/CherenkovDetector/PeerReview3.JPG

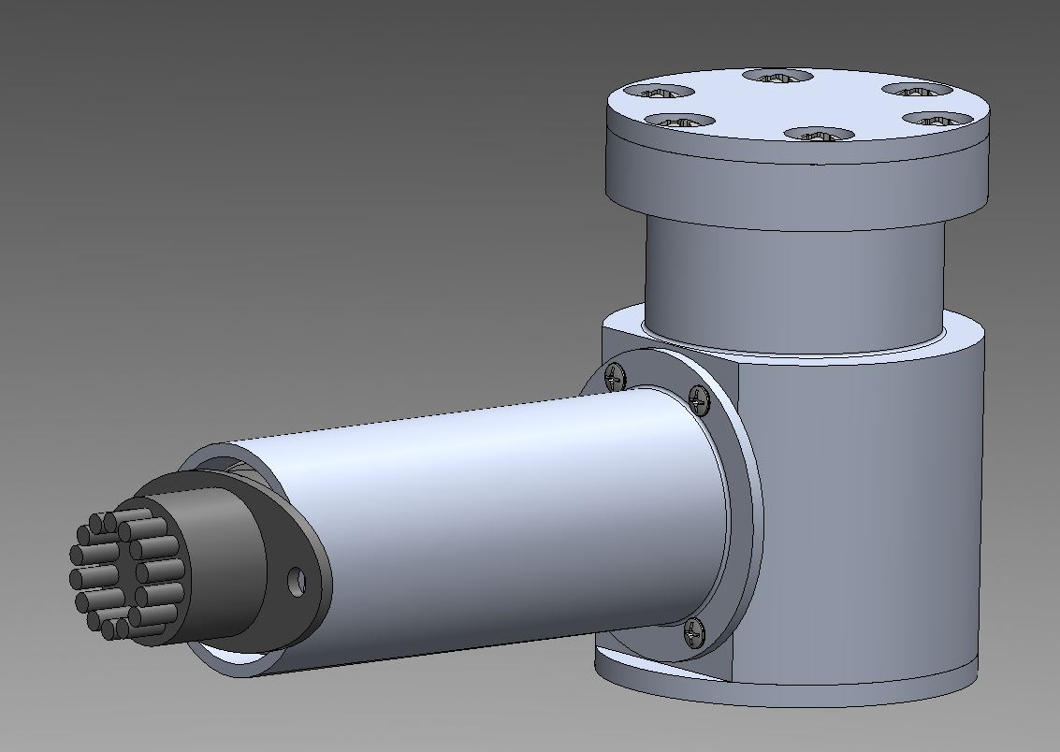
PeerReview3.JPG
