PorterMatt/CherenkovDetector/PeerReviewFinal1.JPG

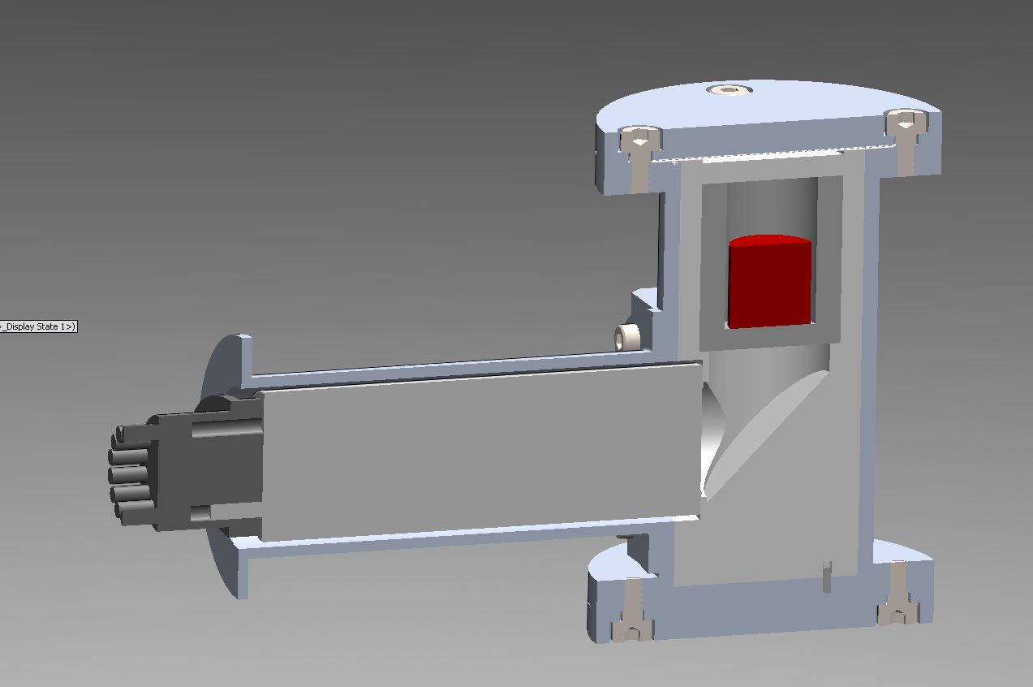
PeerReviewFinal1.JPG
