PorterMatt/CherenkovDetector/PeerReviewFinal2.JPG

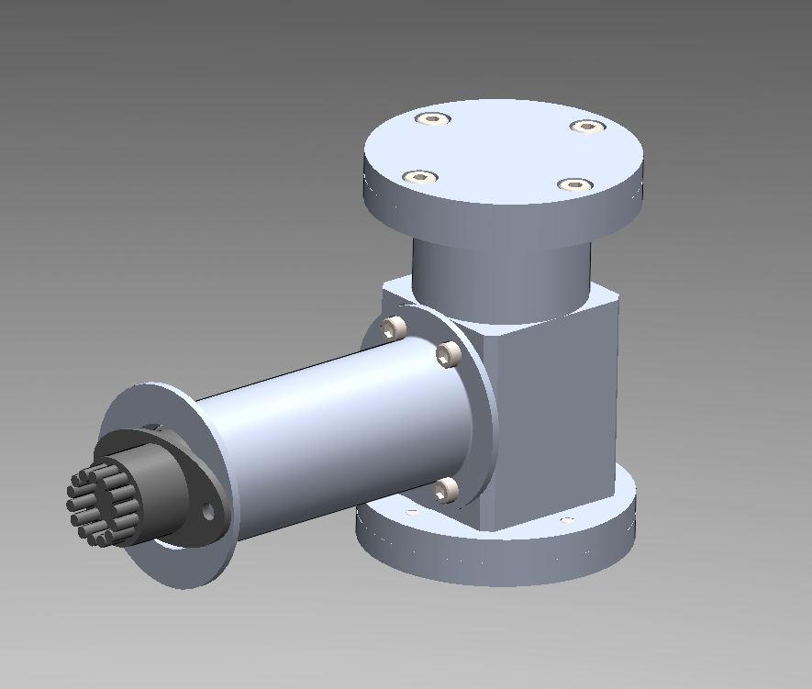
PeerReviewFinal2.JPG
