PorterMatt/CherenkovDetector/PICAP (Jim Connell)/PICAP Documents/PICAP PICS/IMAG0001.jpg

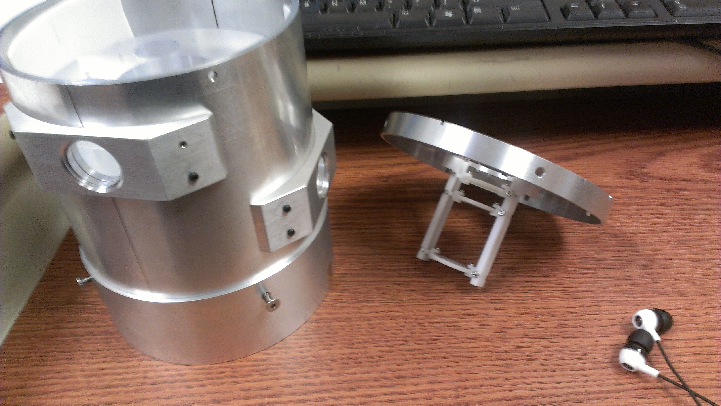
PICAP (Jim Connell)/PICAP Documents/PICAP PICS/IMAG0001.jpg
