PorterMatt/CherenkovDetector/PICAP (Jim Connell)/PICAP Documents/PICAP PICS/IMAG0002.jpg

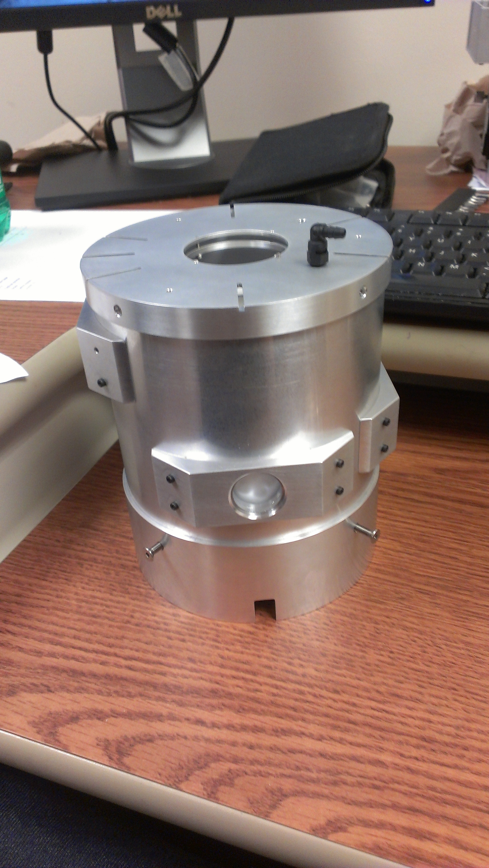
PICAP (Jim Connell)/PICAP Documents/PICAP PICS/IMAG0002.jpg
