PorterMatt/CherenkovDetector/PICAP (Jim Connell)/PICAP Documents/PICAP PICS/IMAG0003.jpg

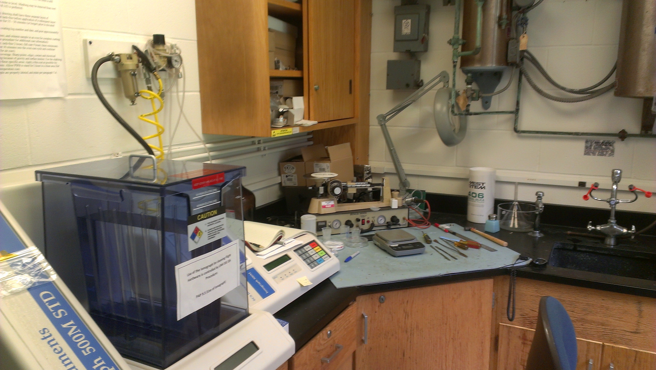
PICAP (Jim Connell)/PICAP Documents/PICAP PICS/IMAG0003.jpg
