PorterMatt/CherenkovDetector/PICAP (Jim Connell)/PICAP Documents/PICAP PICS/IMAG0004.jpg

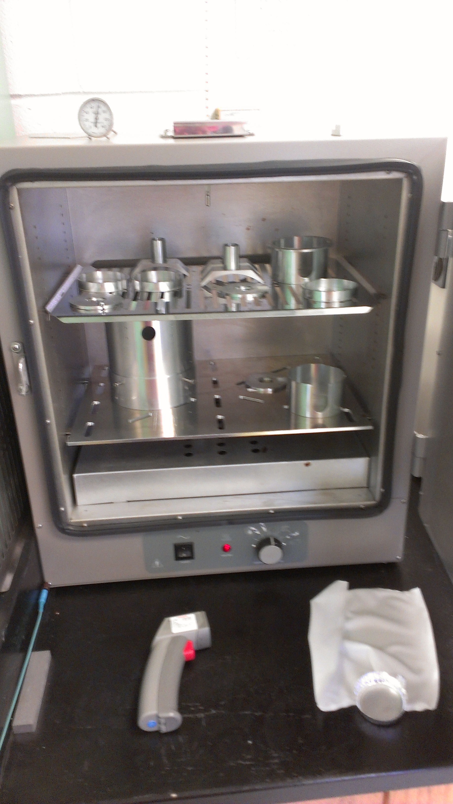
PICAP (Jim Connell)/PICAP Documents/PICAP PICS/IMAG0004.jpg
