PorterMatt/CherenkovDetector/PICAP (Jim Connell)/PICAP Documents/PICAP PICS/IMAG0005 (2).jpg

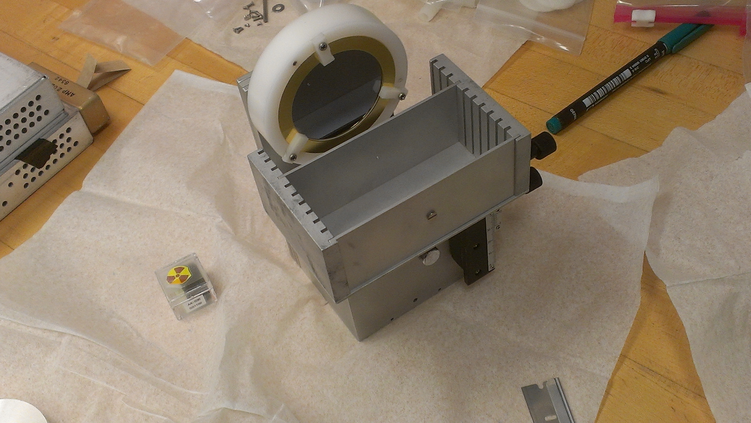
PICAP (Jim Connell)/PICAP Documents/PICAP PICS/IMAG0005 (2).jpg
