PorterMatt/CherenkovDetector/PICAP (Jim Connell)/PICAP Documents/PICAP PICS/IMAG0005.jpg

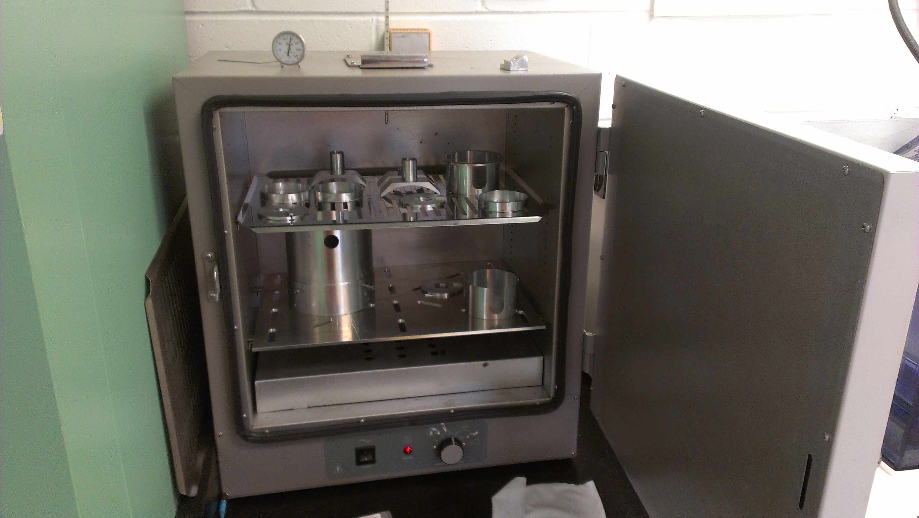
PICAP (Jim Connell)/PICAP Documents/PICAP PICS/IMAG0005.jpg
