PorterMatt/CherenkovDetector/PICAP (Jim Connell)/PICAP Documents/PICAP PICS/IMAG0006.jpg

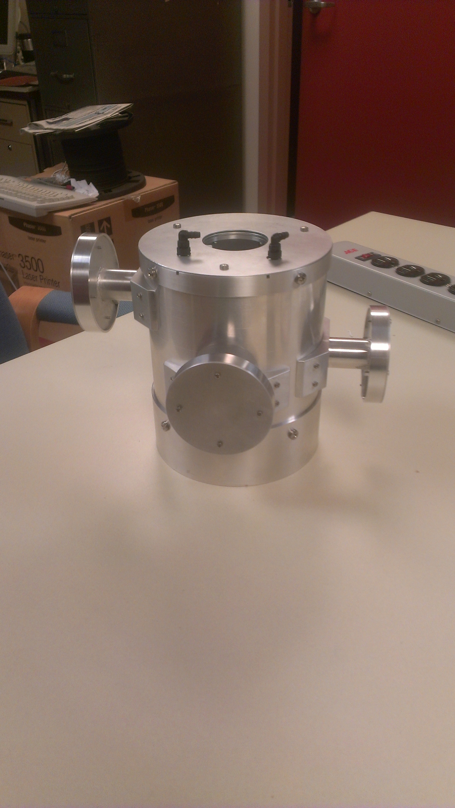
PICAP (Jim Connell)/PICAP Documents/PICAP PICS/IMAG0006.jpg
