PorterMatt/CherenkovDetector/PICAP (Jim Connell)/PICAP Documents/PICAP PICS/IMAG0007.jpg

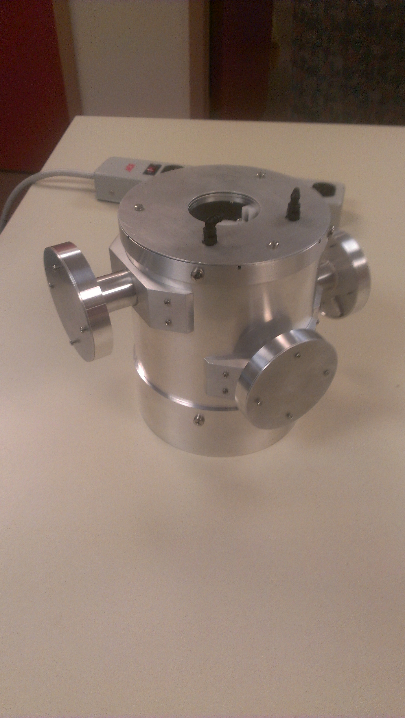
PICAP (Jim Connell)/PICAP Documents/PICAP PICS/IMAG0007.jpg
