PorterMatt/CherenkovDetector/PICAP (Jim Connell)/PICAP Documents/PICAP PICS/IMAG0008.jpg

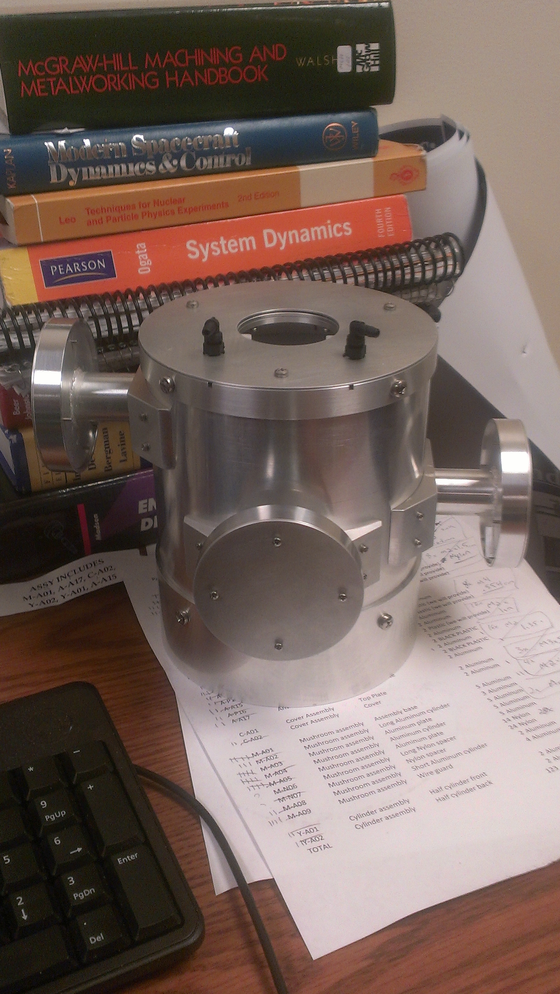
PICAP (Jim Connell)/PICAP Documents/PICAP PICS/IMAG0008.jpg
