PorterMatt/CherenkovDetector/PICAP (Jim Connell)/PICAP Documents/PICAP PICS/IMAG0009.jpg

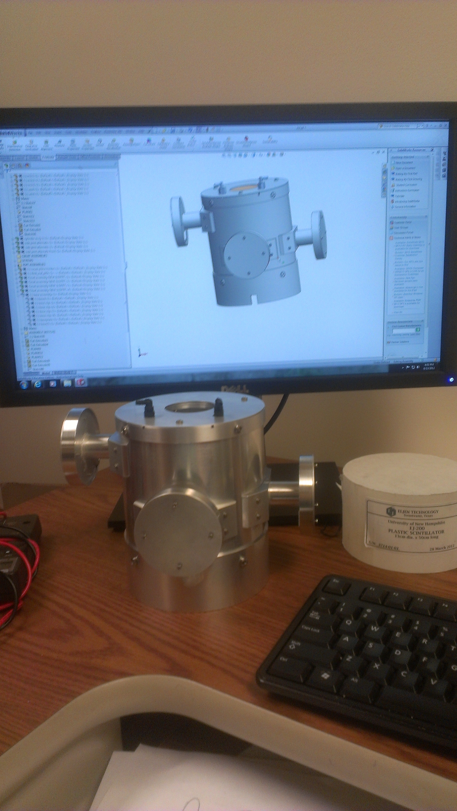
PICAP (Jim Connell)/PICAP Documents/PICAP PICS/IMAG0009.jpg
