PorterMatt/CherenkovDetector/PICAP (Jim Connell)/PICAP Documents/PICAP PICS/IMAG0010.jpg

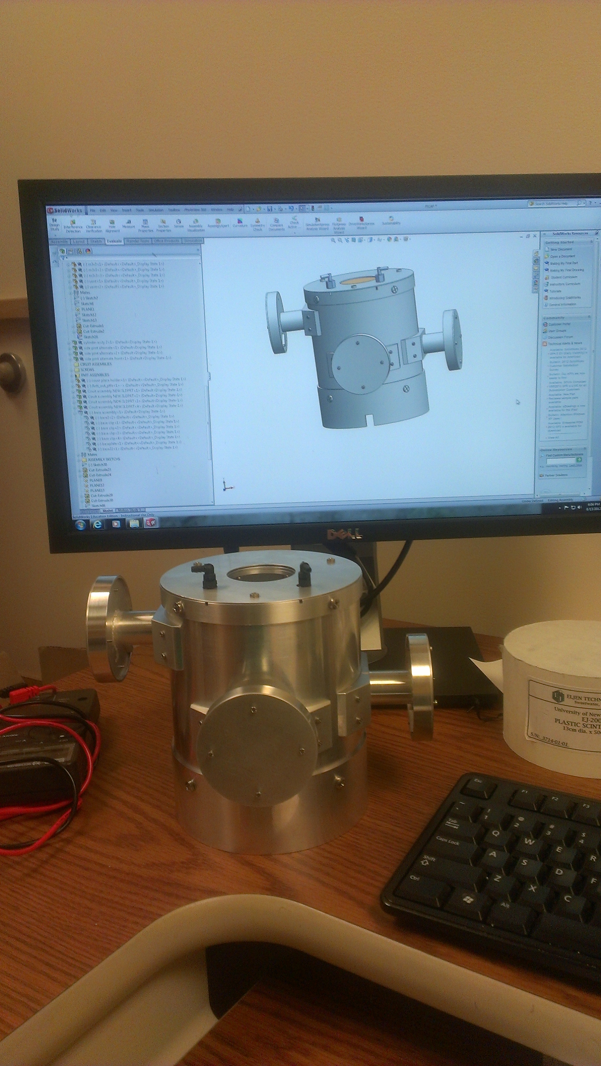
PICAP (Jim Connell)/PICAP Documents/PICAP PICS/IMAG0010.jpg
