PorterMatt/CherenkovDetector/PICAP (Jim Connell)/PICAP Documents/PICAP PICS/IMAG0011.jpg

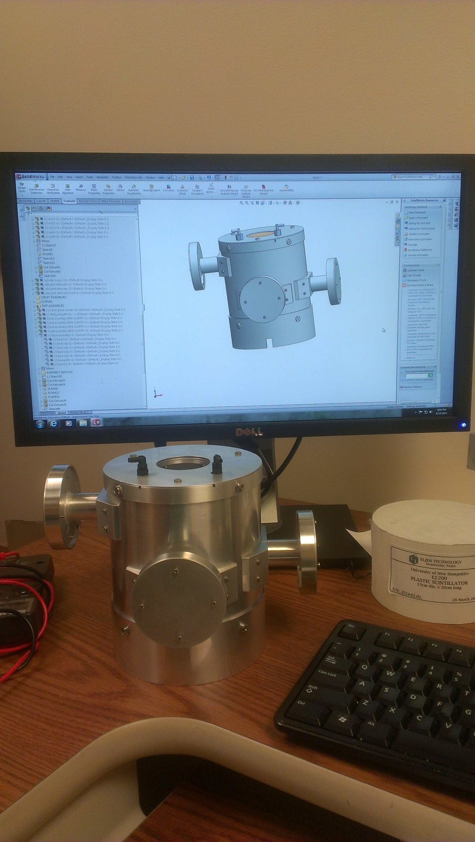
PICAP (Jim Connell)/PICAP Documents/PICAP PICS/IMAG0011.jpg
