PorterMatt/CherenkovDetector/PICAP (Jim Connell)/PICAP Documents/PICAP PICS/IMAG0012.jpg

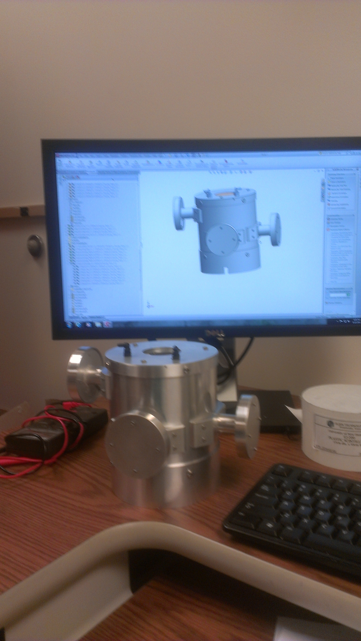
PICAP (Jim Connell)/PICAP Documents/PICAP PICS/IMAG0012.jpg
