PorterMatt/CherenkovDetector/PICAP (Jim Connell)/PICAP Documents/PICAP PICS/IMAG0013.jpg

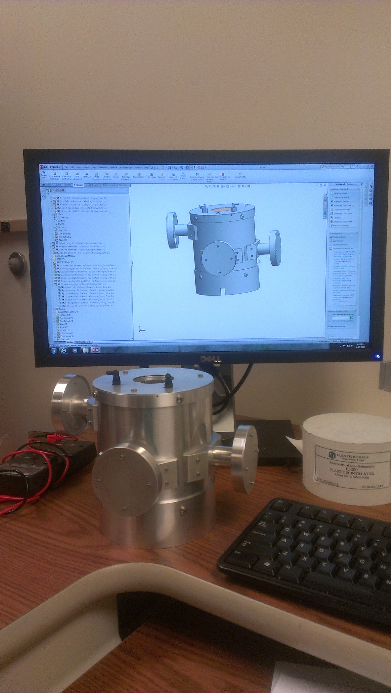
PICAP (Jim Connell)/PICAP Documents/PICAP PICS/IMAG0013.jpg
