PorterMatt/CherenkovDetector/PICAP (Jim Connell)/PICAP Documents/PICAP PICS/IMAG0014.jpg

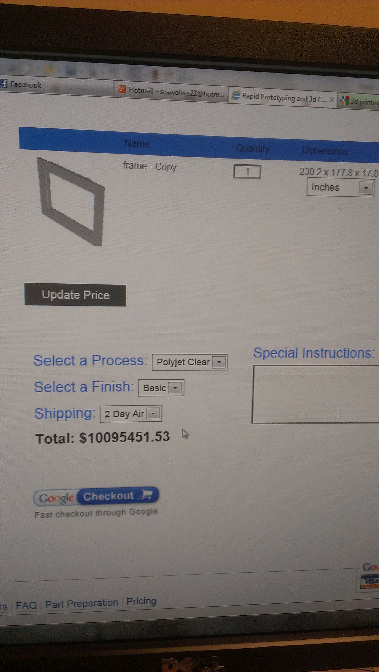
PICAP (Jim Connell)/PICAP Documents/PICAP PICS/IMAG0014.jpg
