PorterMatt/CherenkovDetector/PICAP (Jim Connell)/PICAP Documents/PICAP PICS/IMAG0015.jpg

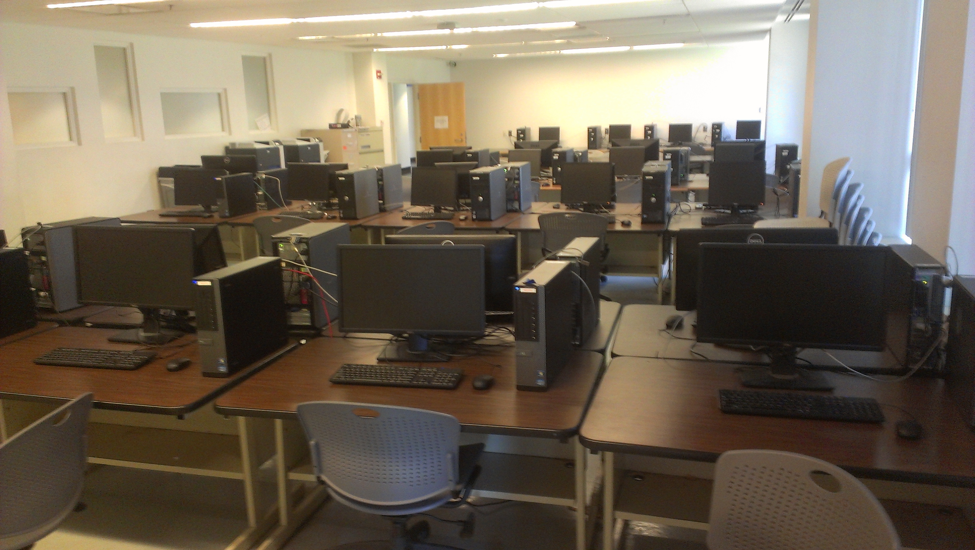
PICAP (Jim Connell)/PICAP Documents/PICAP PICS/IMAG0015.jpg
