PorterMatt/CherenkovDetector/PICAP (Jim Connell)/PICAP Documents/PICAP PICS/IMAG0016.jpg

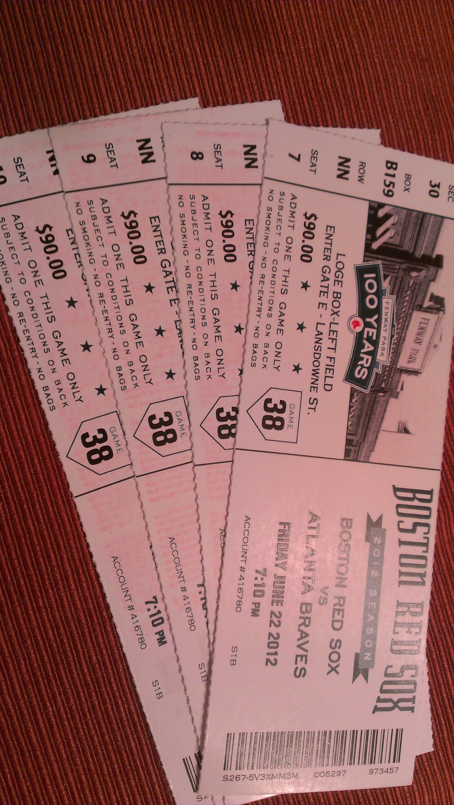
PICAP (Jim Connell)/PICAP Documents/PICAP PICS/IMAG0016.jpg
