PorterMatt/CherenkovDetector/PICAP (Jim Connell)/PICAP Documents/PICAP PICS/IMAG0017.jpg

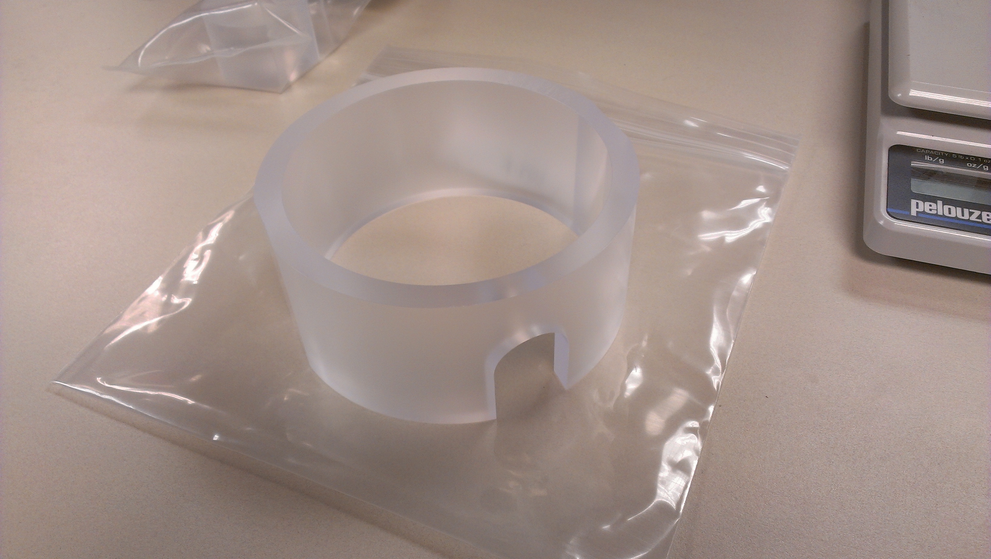
PICAP (Jim Connell)/PICAP Documents/PICAP PICS/IMAG0017.jpg
