PorterMatt/CherenkovDetector/PICAP (Jim Connell)/PICAP Documents/PICAP PICS/IMAG0018 (2).jpg

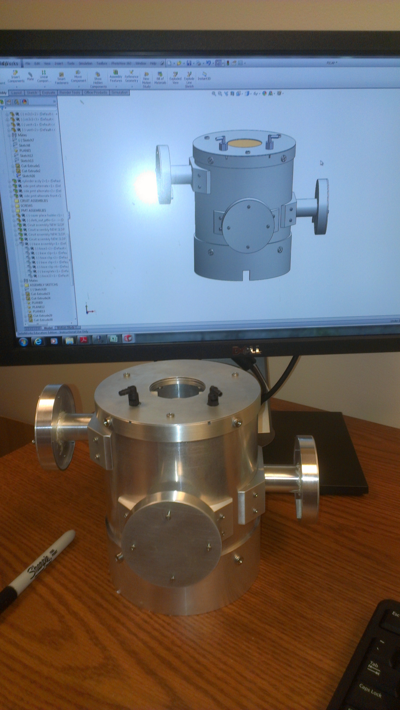
PICAP (Jim Connell)/PICAP Documents/PICAP PICS/IMAG0018 (2).jpg
