PorterMatt/CherenkovDetector/PICAP (Jim Connell)/PICAP Documents/PICAP PICS/IMAG0019.jpg

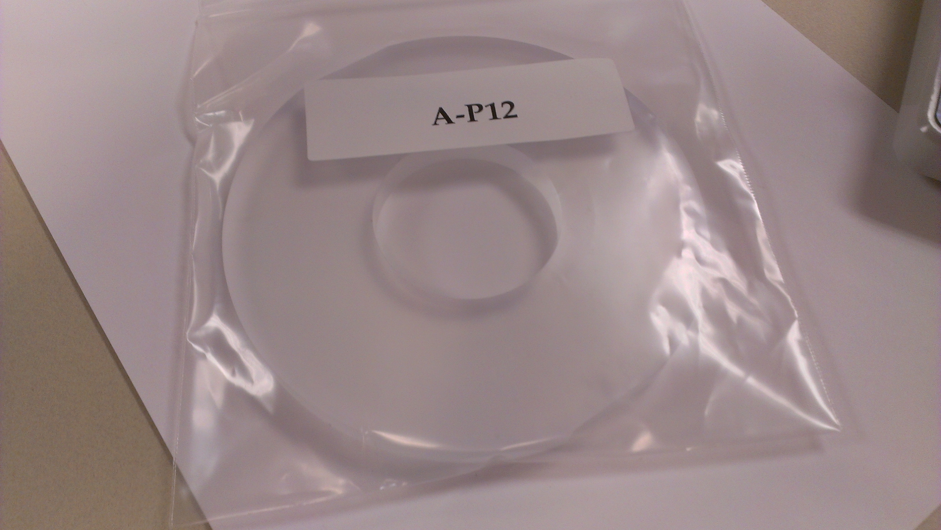
PICAP (Jim Connell)/PICAP Documents/PICAP PICS/IMAG0019.jpg
