PorterMatt/CherenkovDetector/PICAP (Jim Connell)/PICAP Documents/PICAP PICS/IMAG0020 (2).jpg

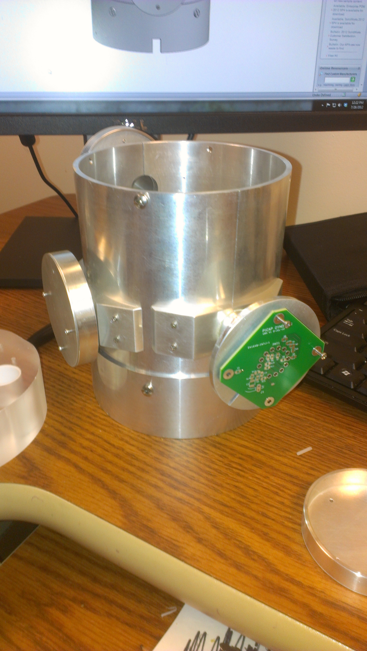
PICAP (Jim Connell)/PICAP Documents/PICAP PICS/IMAG0020 (2).jpg
