PorterMatt/CherenkovDetector/PICAP (Jim Connell)/PICAP Documents/PICAP PICS/IMAG0020 (3).jpg

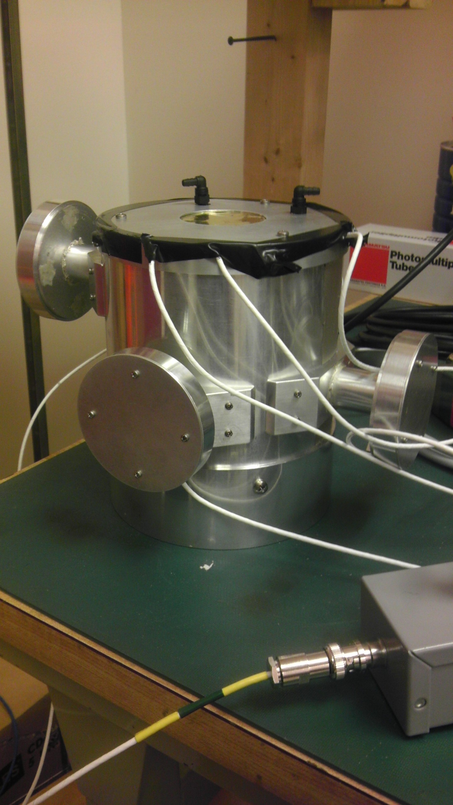
PICAP (Jim Connell)/PICAP Documents/PICAP PICS/IMAG0020 (3).jpg
