PorterMatt/CherenkovDetector/PICAP (Jim Connell)/PICAP Documents/PICAP PICS/IMAG0021 (2).jpg

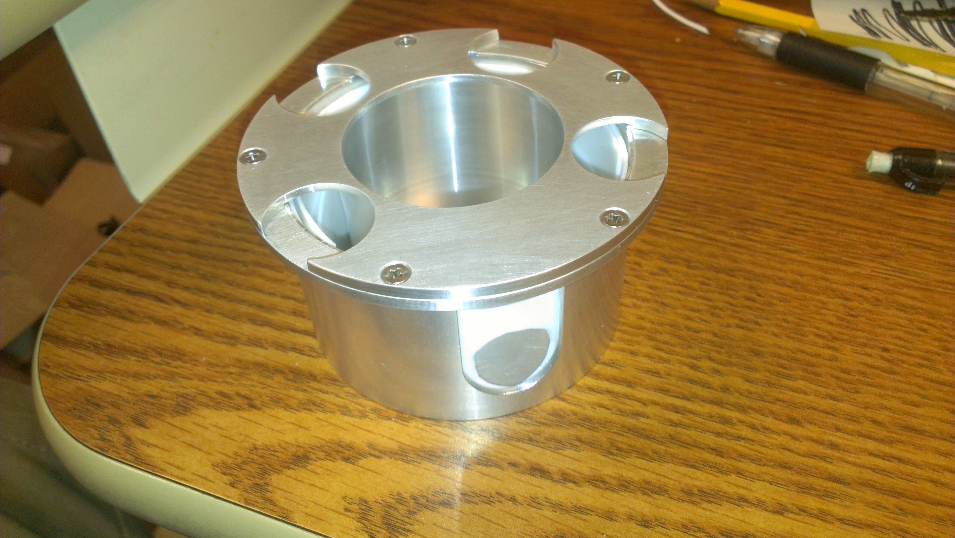
PICAP (Jim Connell)/PICAP Documents/PICAP PICS/IMAG0021 (2).jpg
