PorterMatt/CherenkovDetector/PICAP (Jim Connell)/PICAP Documents/PICAP PICS/IMAG0021.jpg

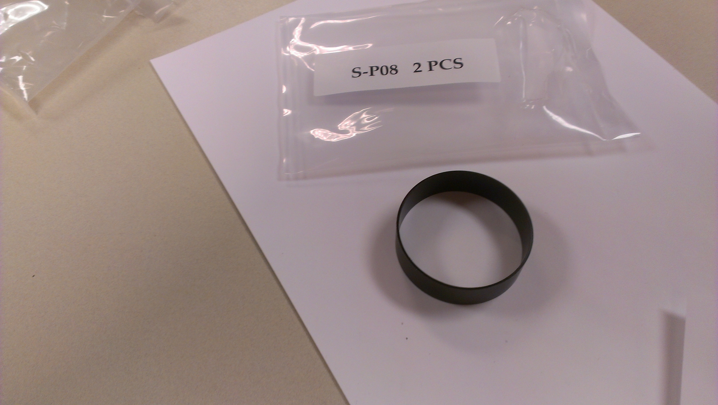
PICAP (Jim Connell)/PICAP Documents/PICAP PICS/IMAG0021.jpg
