PorterMatt/CherenkovDetector/PICAP (Jim Connell)/PICAP Documents/PICAP PICS/IMAG0022 (3).jpg

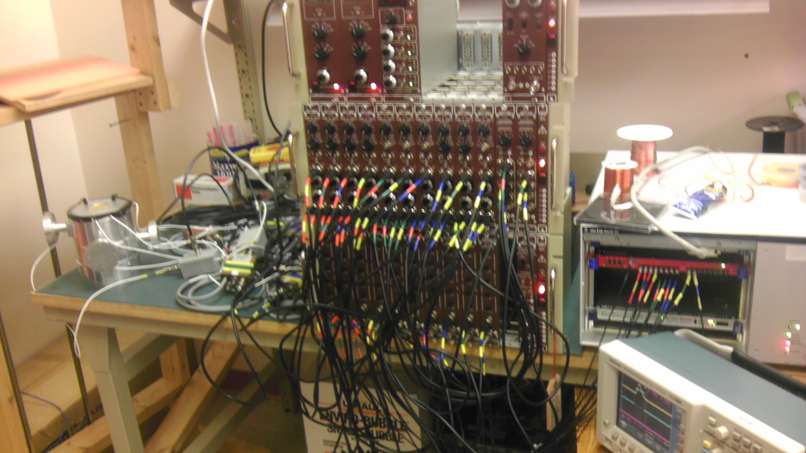
PICAP (Jim Connell)/PICAP Documents/PICAP PICS/IMAG0022 (3).jpg
