PorterMatt/CherenkovDetector/PICAP (Jim Connell)/PICAP Documents/PICAP PICS/IMAG0022.jpg

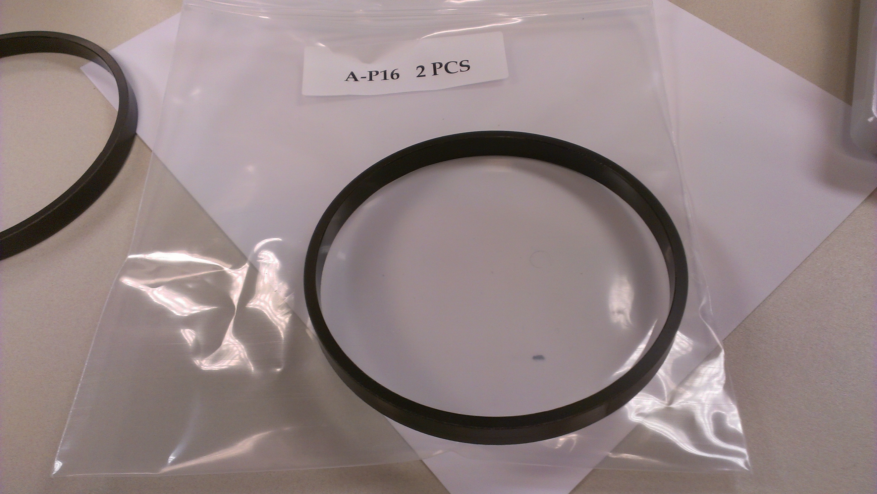
PICAP (Jim Connell)/PICAP Documents/PICAP PICS/IMAG0022.jpg
