PorterMatt/CherenkovDetector/PICAP (Jim Connell)/PICAP Documents/PICAP PICS/IMAG0023 (2).jpg

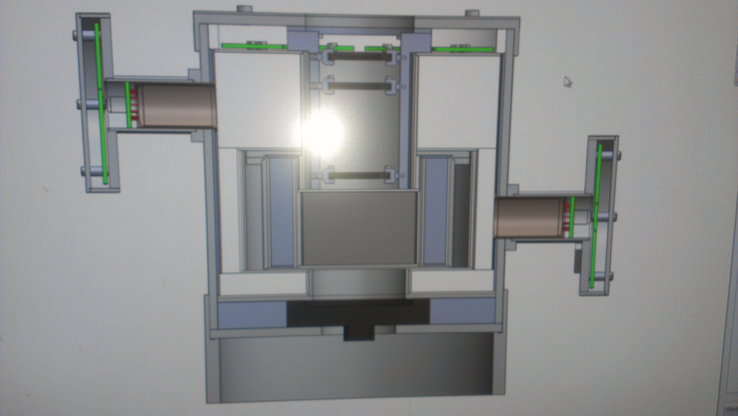
PICAP (Jim Connell)/PICAP Documents/PICAP PICS/IMAG0023 (2).jpg
