PorterMatt/CherenkovDetector/PICAP (Jim Connell)/PICAP Documents/PICAP PICS/IMAG0025.jpg

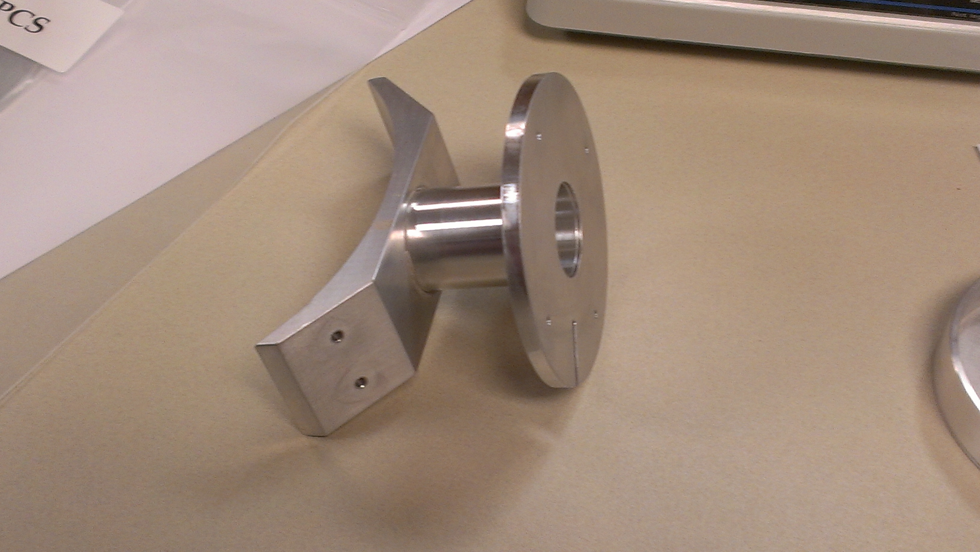
PICAP (Jim Connell)/PICAP Documents/PICAP PICS/IMAG0025.jpg
