PorterMatt/CherenkovDetector/PICAP (Jim Connell)/PICAP Documents/PICAP PICS/IMAG0026.jpg

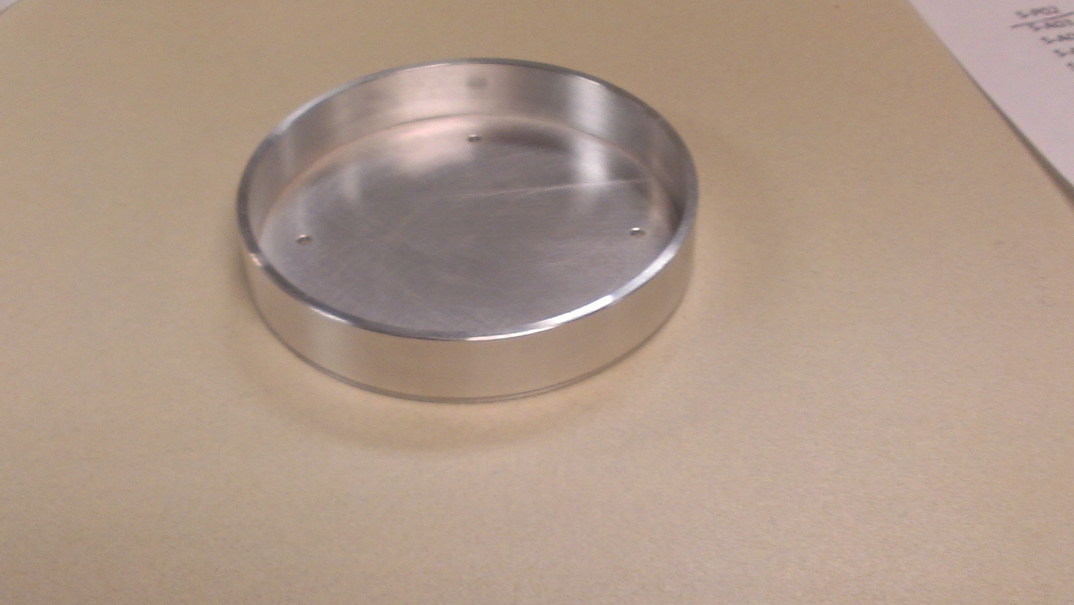
PICAP (Jim Connell)/PICAP Documents/PICAP PICS/IMAG0026.jpg
