PorterMatt/CherenkovDetector/PICAP (Jim Connell)/PICAP Documents/PICAP PICS/IMAG0027 (2).jpg

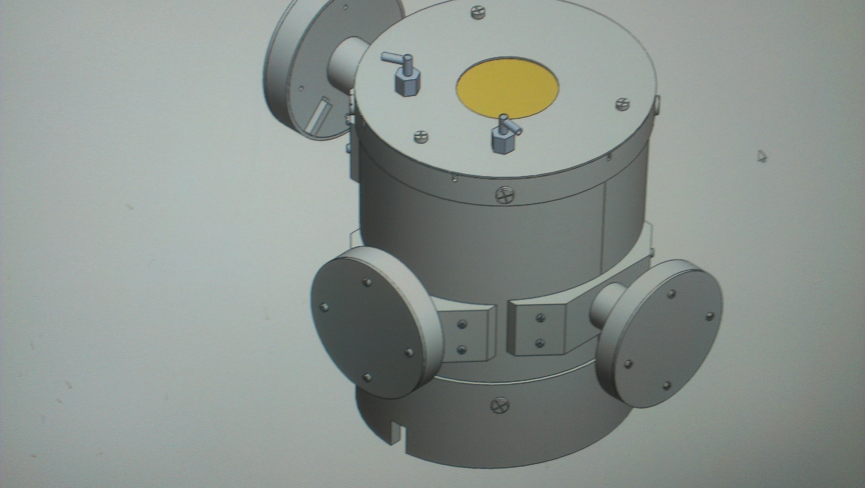
PICAP (Jim Connell)/PICAP Documents/PICAP PICS/IMAG0027 (2).jpg
