PorterMatt/CherenkovDetector/PICAP (Jim Connell)/PICAP Documents/PICAP PICS/IMAG0027.jpg

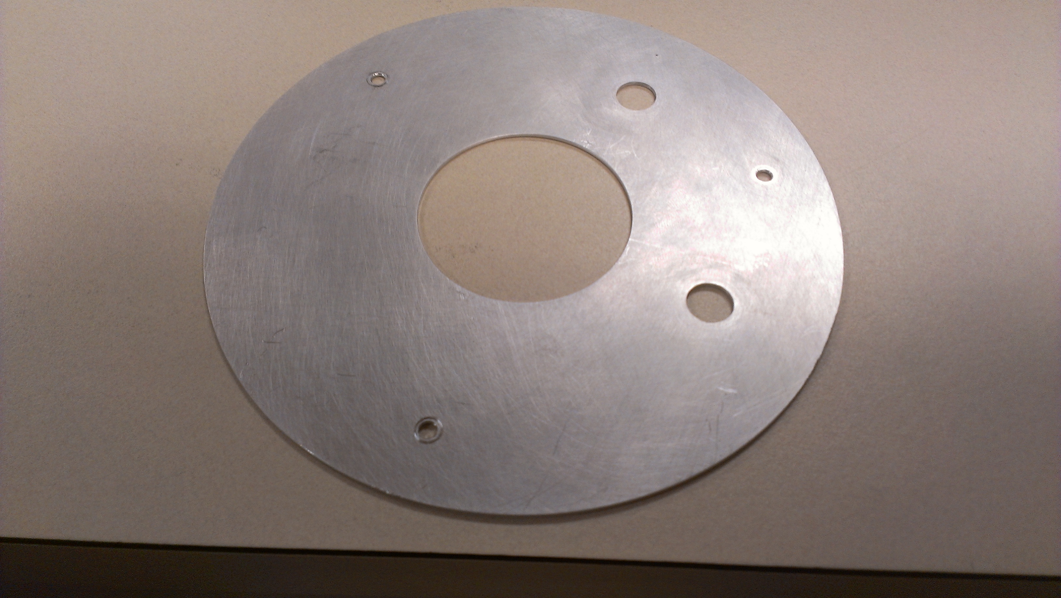
PICAP (Jim Connell)/PICAP Documents/PICAP PICS/IMAG0027.jpg
