PorterMatt/CherenkovDetector/PICAP (Jim Connell)/PICAP Documents/PICAP PICS/IMAG0028.jpg

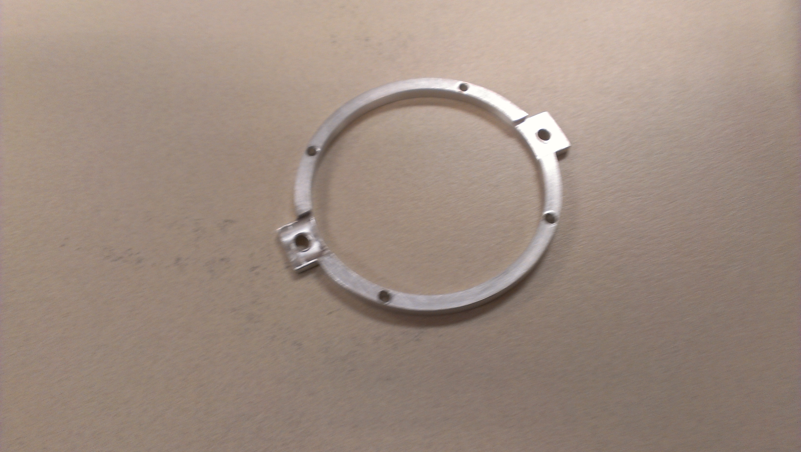
PICAP (Jim Connell)/PICAP Documents/PICAP PICS/IMAG0028.jpg
