PorterMatt/CherenkovDetector/PICAP (Jim Connell)/PICAP Documents/PICAP PICS/IMAG0029.jpg

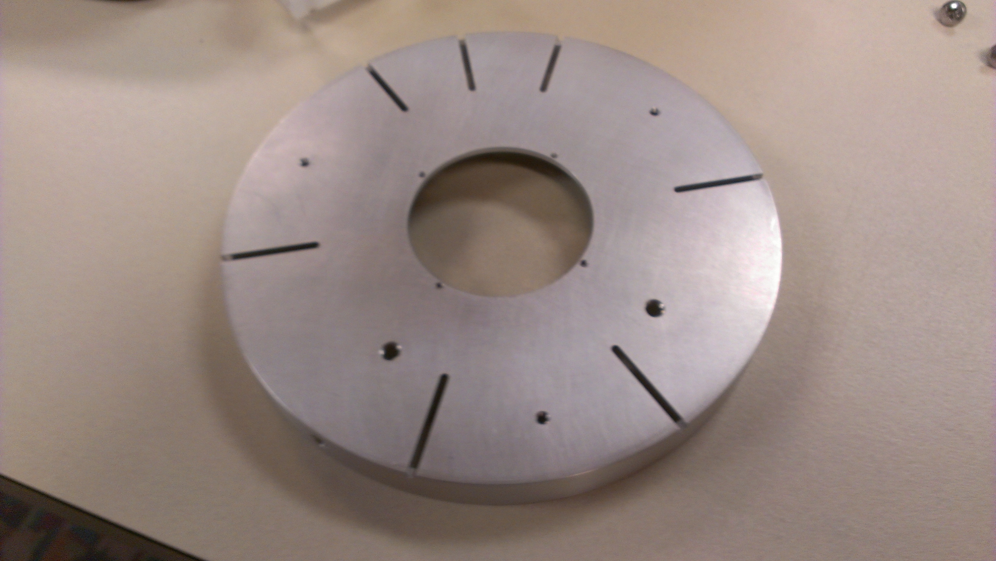
PICAP (Jim Connell)/PICAP Documents/PICAP PICS/IMAG0029.jpg
