PorterMatt/CherenkovDetector/PICAP (Jim Connell)/PICAP Documents/PICAP PICS/IMAG0030.jpg

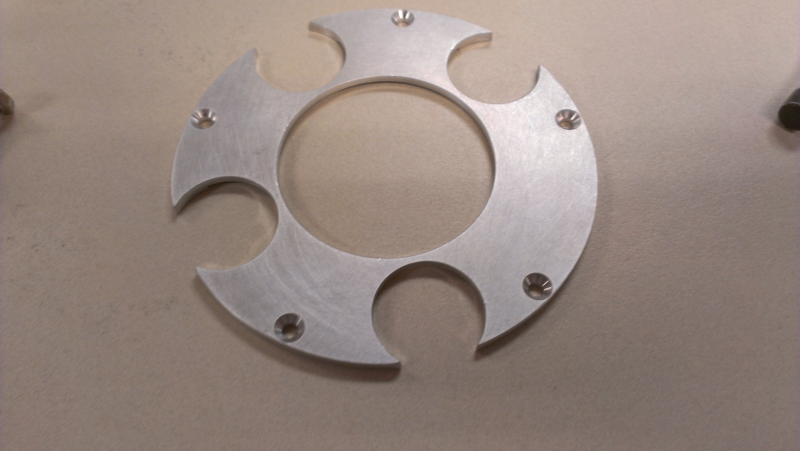
PICAP (Jim Connell)/PICAP Documents/PICAP PICS/IMAG0030.jpg
