PorterMatt/CherenkovDetector/PICAP (Jim Connell)/PICAP Documents/PICAP PICS/IMAG0031.jpg

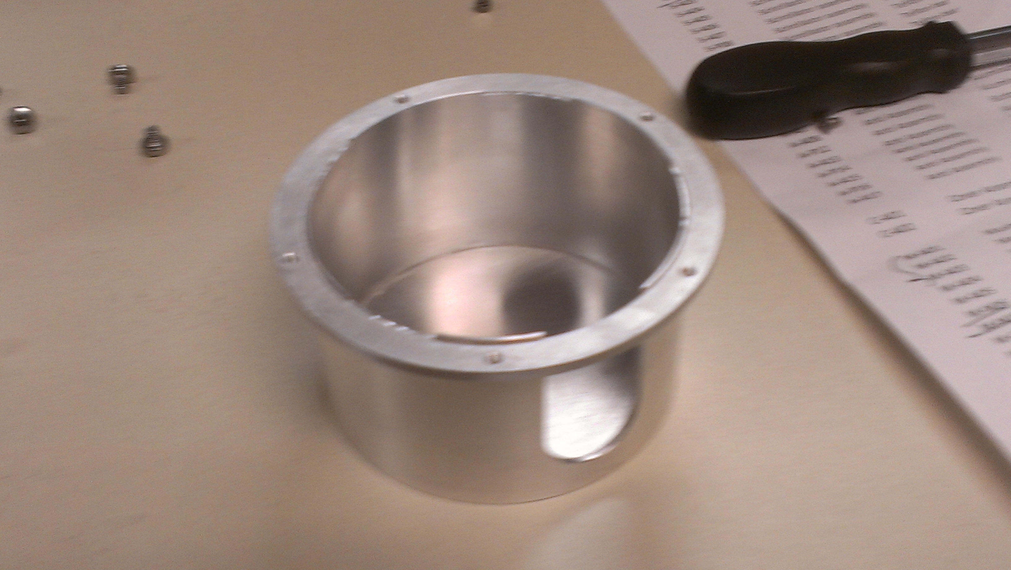
PICAP (Jim Connell)/PICAP Documents/PICAP PICS/IMAG0031.jpg
