PorterMatt/CherenkovDetector/PICAP (Jim Connell)/PICAP Documents/PICAP PICS/IMAG0035.jpg

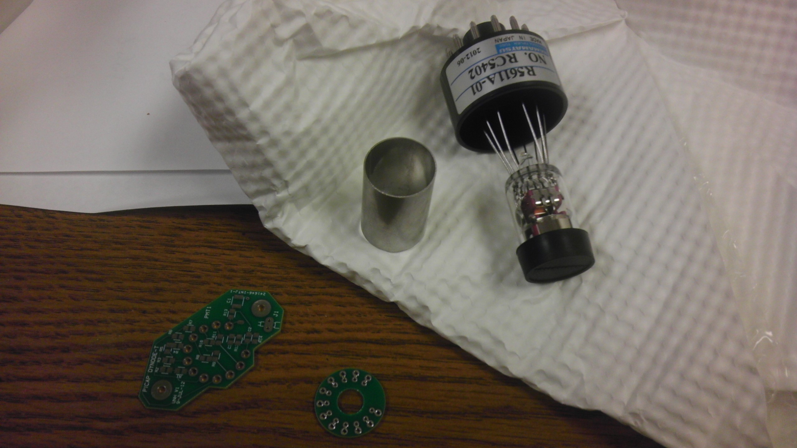
PICAP (Jim Connell)/PICAP Documents/PICAP PICS/IMAG0035.jpg
