PorterMatt/CherenkovDetector/PICAP (Jim Connell)/PICAP Documents/PICAP PICS/IMAG0041.jpg

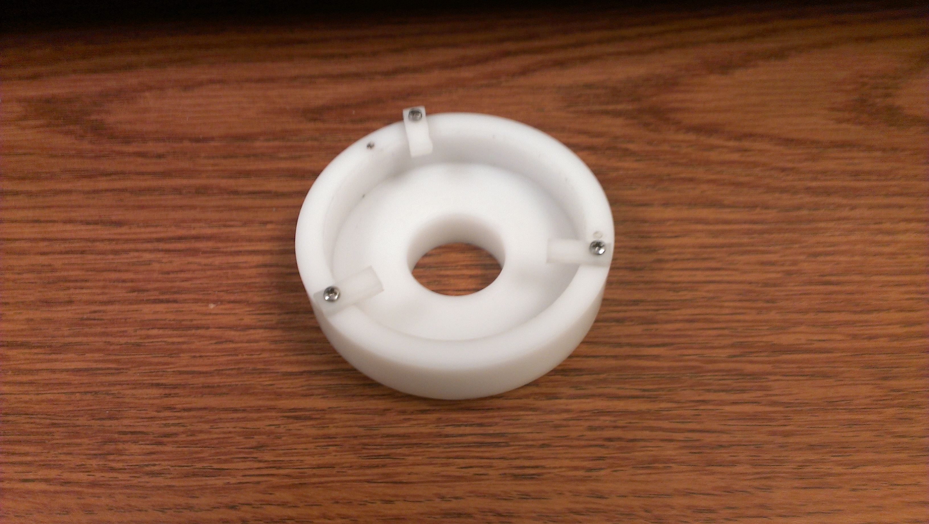
PICAP (Jim Connell)/PICAP Documents/PICAP PICS/IMAG0041.jpg
