PorterMatt/CherenkovDetector/PICAP (Jim Connell)/PICAP Documents/PICAP PICS/IMAG0042.jpg

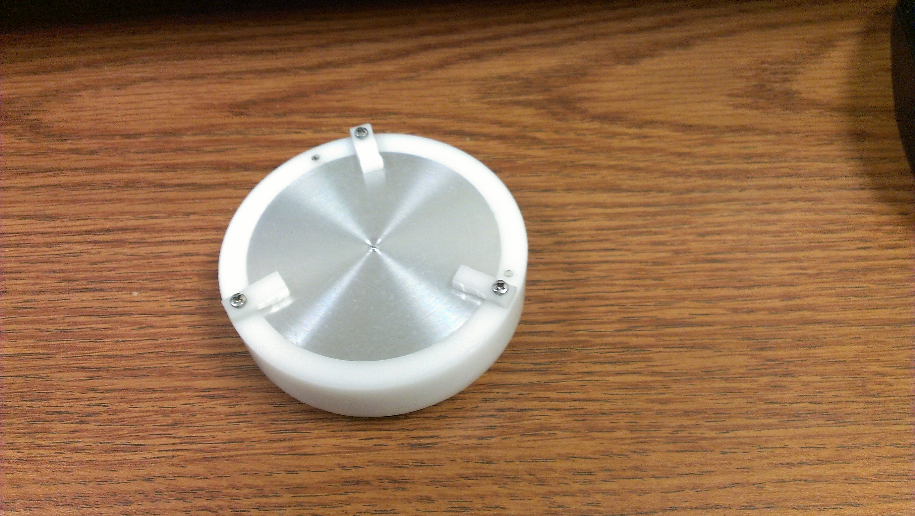
PICAP (Jim Connell)/PICAP Documents/PICAP PICS/IMAG0042.jpg
