PorterMatt/CherenkovDetector/PICAP (Jim Connell)/PICAP Documents/PICAP PICS/IMAG0043.jpg

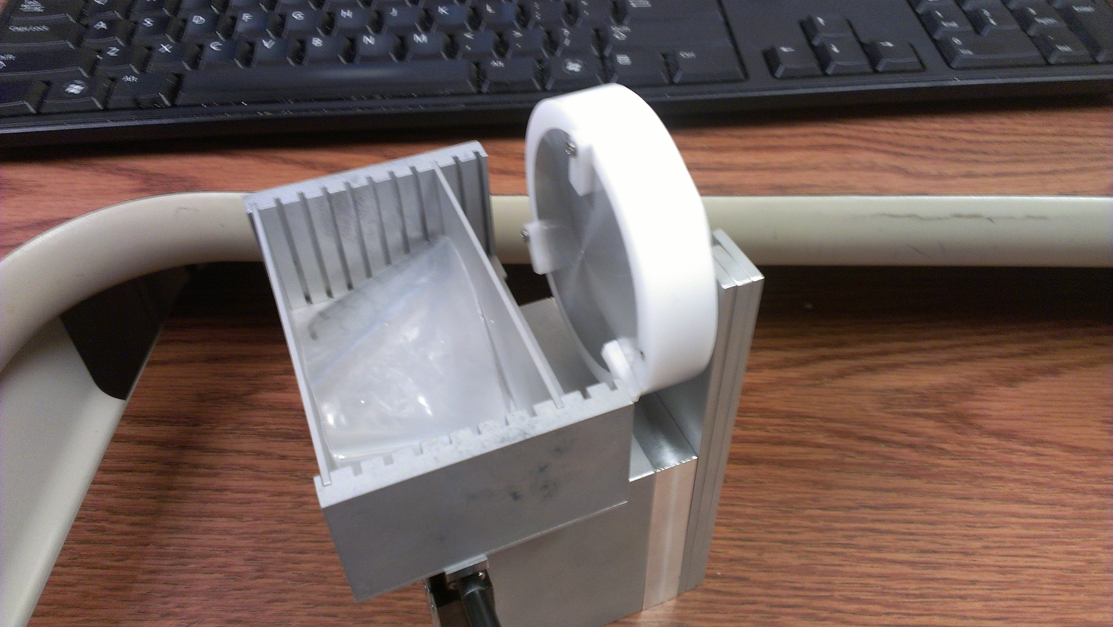
PICAP (Jim Connell)/PICAP Documents/PICAP PICS/IMAG0043.jpg
