PorterMatt/CherenkovDetector/PICAP (Jim Connell)/PICAP Documents/PICAP PICS/IMAG0044.jpg

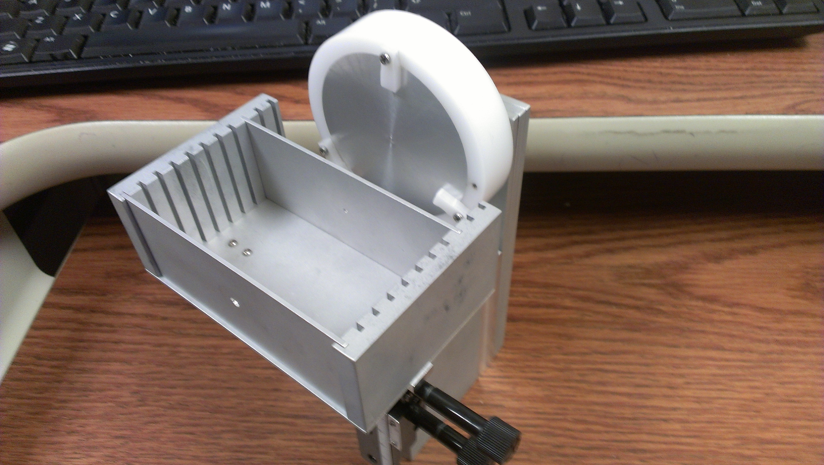
PICAP (Jim Connell)/PICAP Documents/PICAP PICS/IMAG0044.jpg
