PorterMatt/CherenkovDetector/PICAP (Jim Connell)/PICAP Documents/PICAP PICS/IMAG0045.jpg

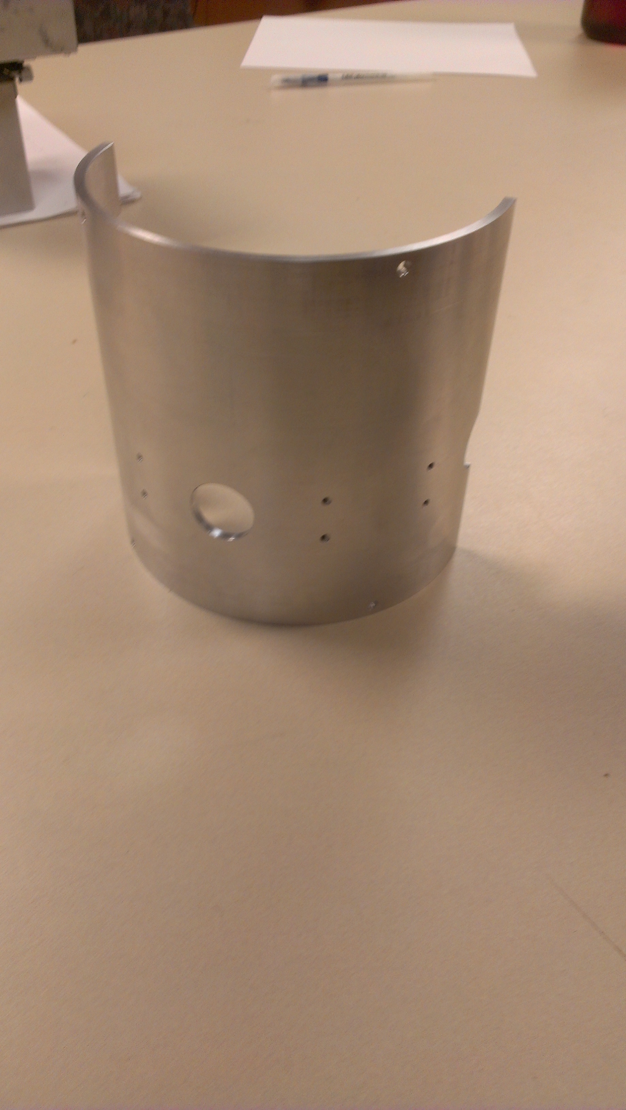
PICAP (Jim Connell)/PICAP Documents/PICAP PICS/IMAG0045.jpg
