PorterMatt/CherenkovDetector/PICAP (Jim Connell)/PICAP Documents/PICAP PICS/IMAG0046.jpg

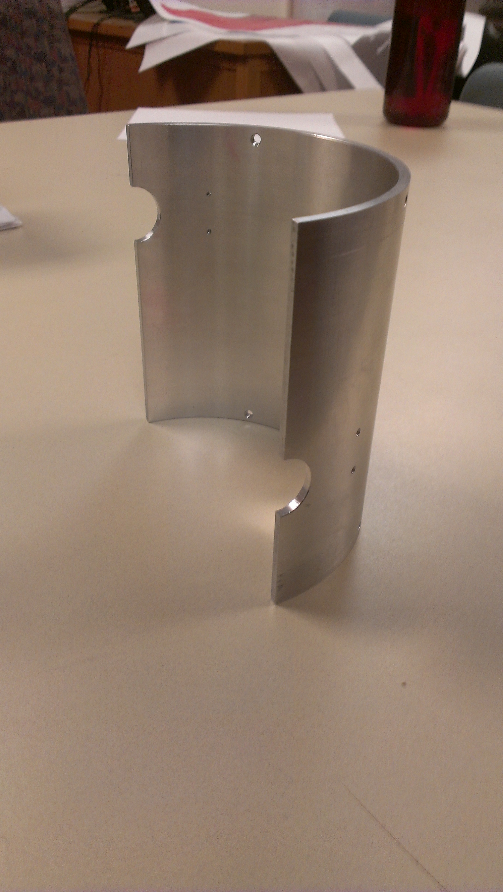
PICAP (Jim Connell)/PICAP Documents/PICAP PICS/IMAG0046.jpg
