PorterMatt/CherenkovDetector/PICAP (Jim Connell)/PICAP Documents/PICAP PICS/IMAG0047.jpg

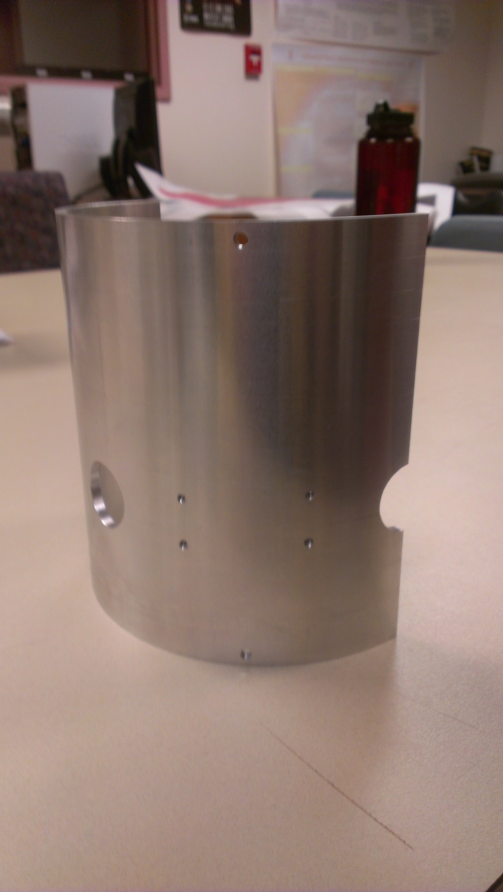
PICAP (Jim Connell)/PICAP Documents/PICAP PICS/IMAG0047.jpg
