PorterMatt/CherenkovDetector/PICAP (Jim Connell)/PICAP Documents/PICAP PICS/IMAG0048.jpg

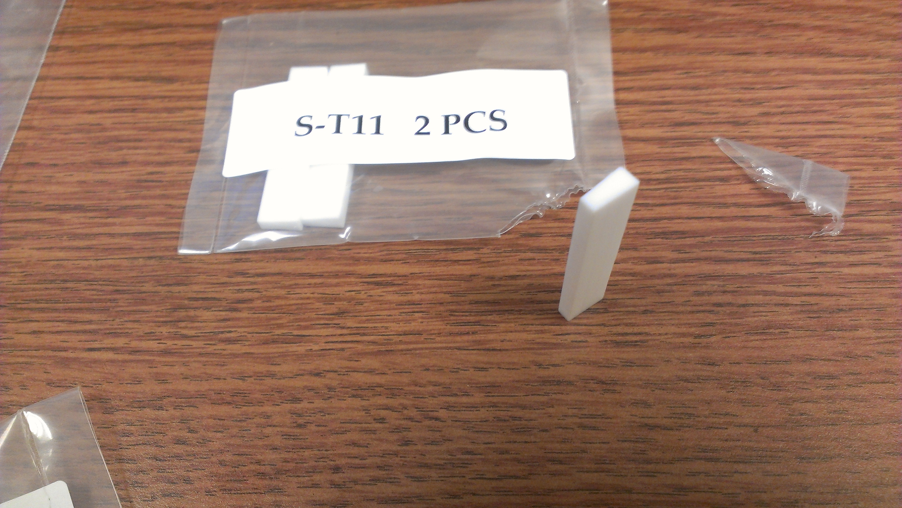
PICAP (Jim Connell)/PICAP Documents/PICAP PICS/IMAG0048.jpg
