PorterMatt/CherenkovDetector/PICAP (Jim Connell)/PICAP Documents/PICAP PICS/IMAG0049.jpg

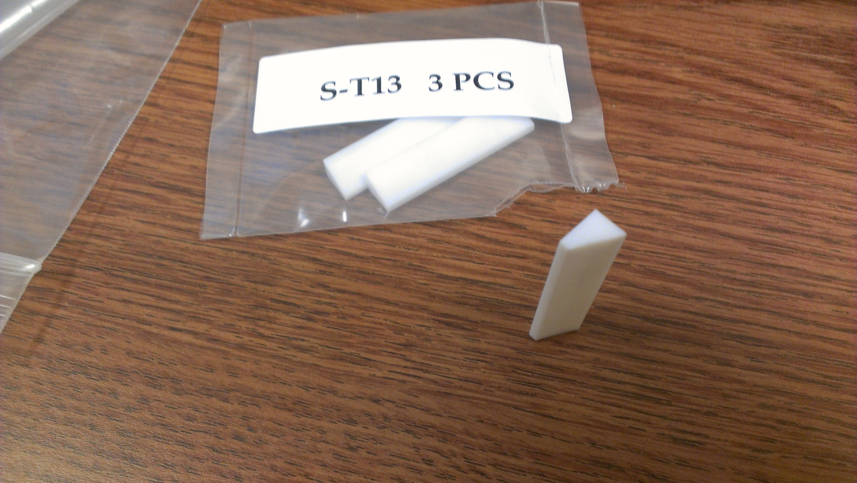
PICAP (Jim Connell)/PICAP Documents/PICAP PICS/IMAG0049.jpg
