PorterMatt/CherenkovDetector/PICAP (Jim Connell)/PICAP Documents/PICAP PICS/IMAG0050.jpg

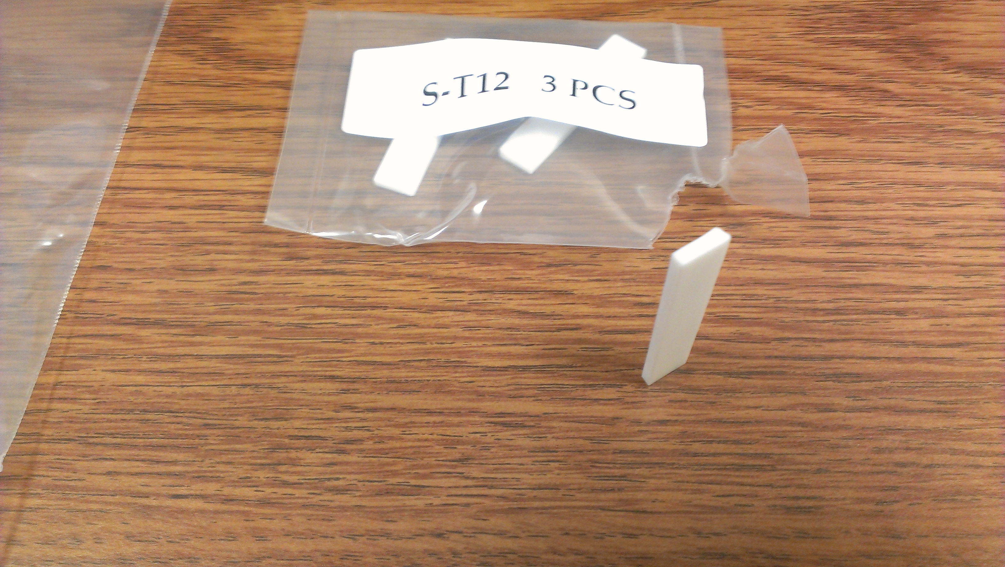
PICAP (Jim Connell)/PICAP Documents/PICAP PICS/IMAG0050.jpg
