PorterMatt/CherenkovDetector/PICAP (Jim Connell)/PICAP Documents/PICAP PICS/IMG-20120525-00066.jpg

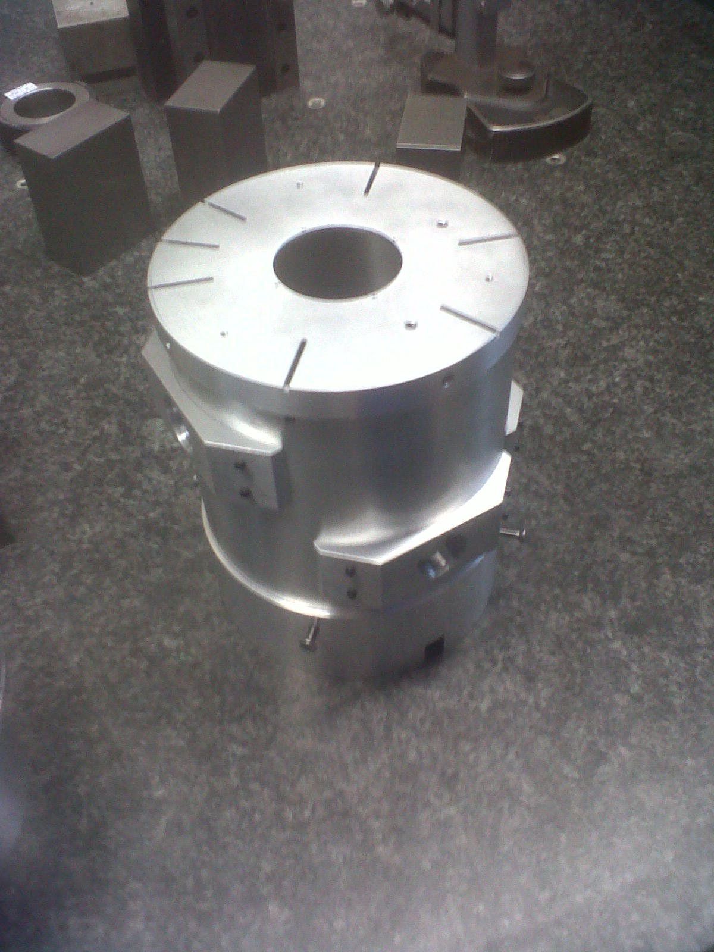
PICAP (Jim Connell)/PICAP Documents/PICAP PICS/IMG-20120525-00066.jpg
