PorterMatt/CherenkovDetector/PICAP (Jim Connell)/PICAP Documents/PICAP PICS/IMG-20120525-00068.jpg

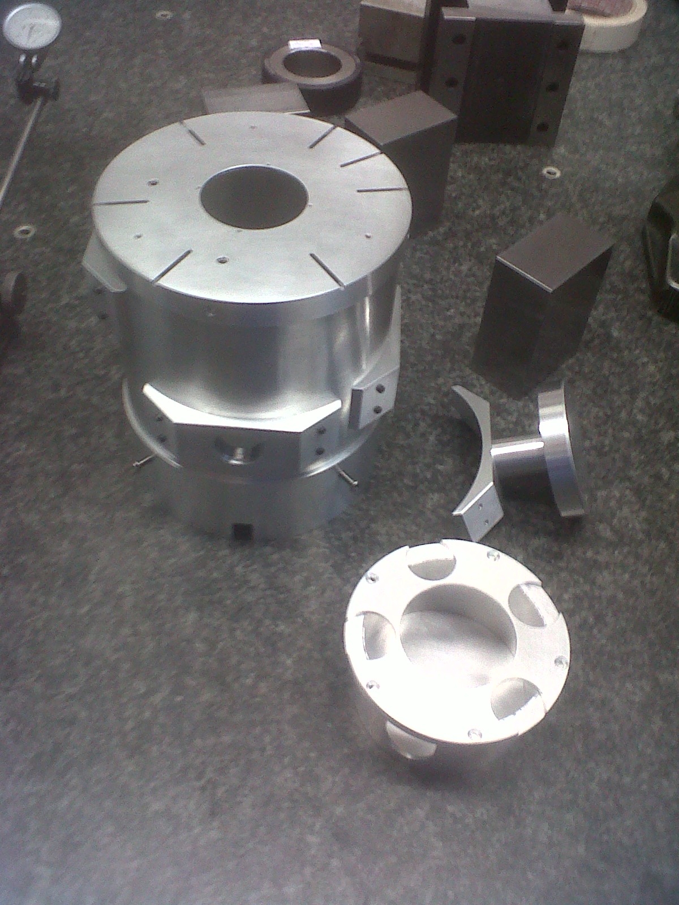
PICAP (Jim Connell)/PICAP Documents/PICAP PICS/IMG-20120525-00068.jpg
