PorterMatt/CherenkovDetector/PICAP (Jim Connell)/PICAP Documents/PICAP PICS/PICAP .JPG

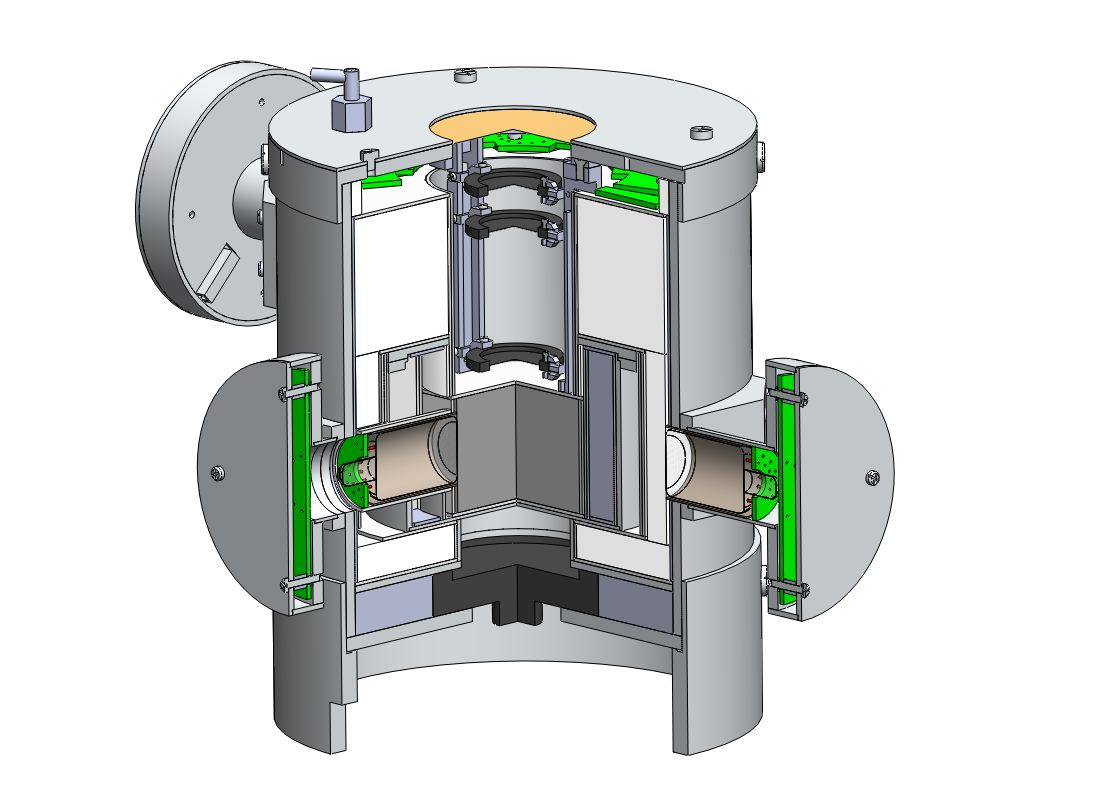
PICAP (Jim Connell)/PICAP Documents/PICAP PICS/PICAP .JPG
