PorterMatt/CherenkovDetector/PICAP (Jim Connell)/PICAP Documents/PICAP PICS/picap.PNG

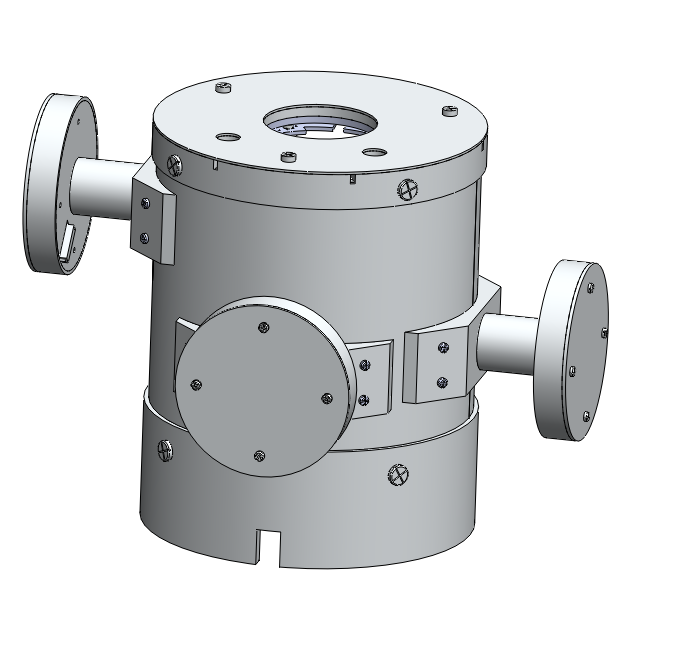
PICAP (Jim Connell)/PICAP Documents/PICAP PICS/picap.PNG
