PorterMatt/CherenkovDetector/Screenshots/Adhesive.JPG

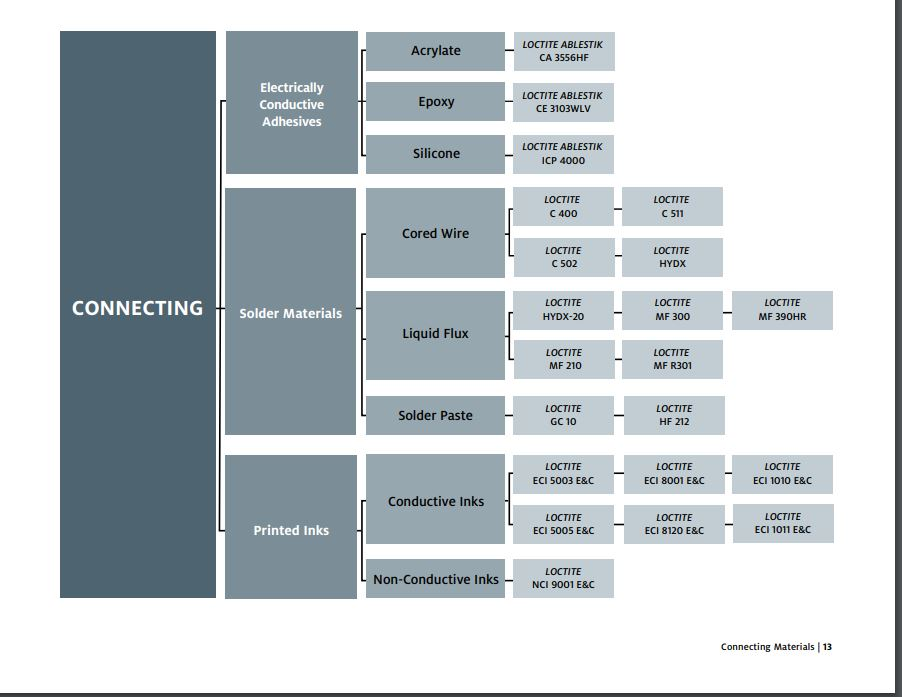
Screenshots/Adhesive.JPG
