PorterMatt/CherenkovDetector/Screenshots/Capture1.JPG

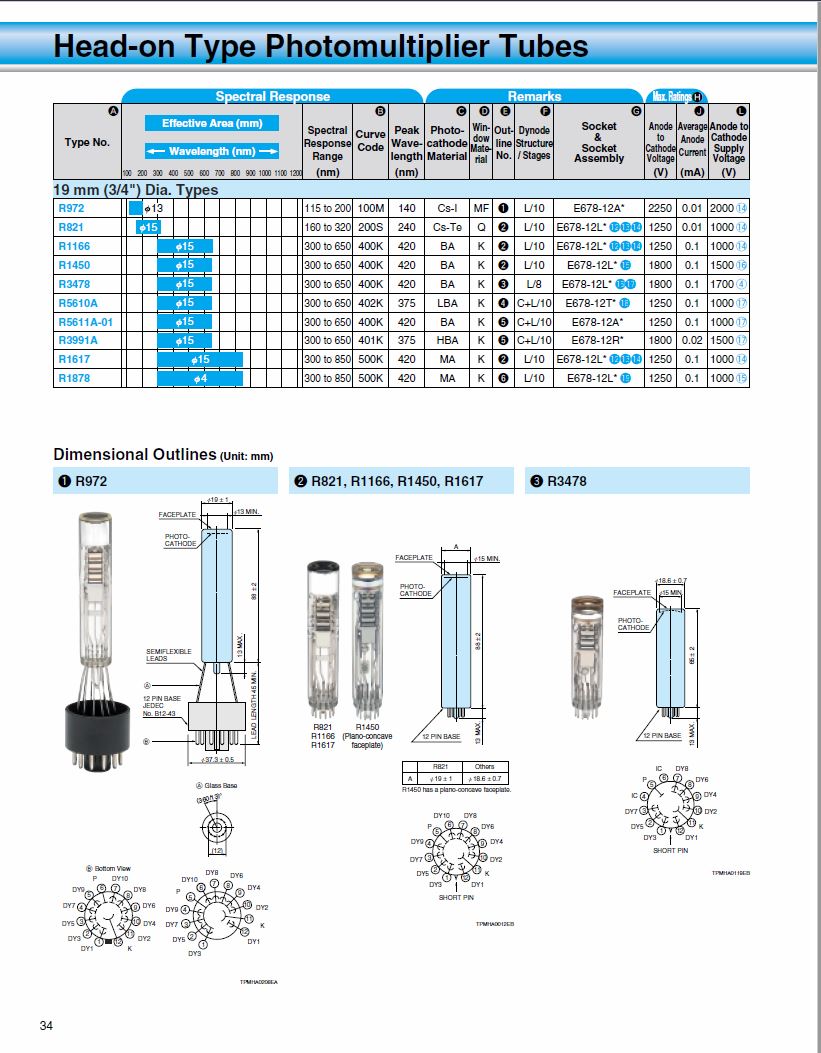
Screenshots/Capture1.JPG
