PorterMatt/CherenkovDetector/Screenshots/Capture3.JPG

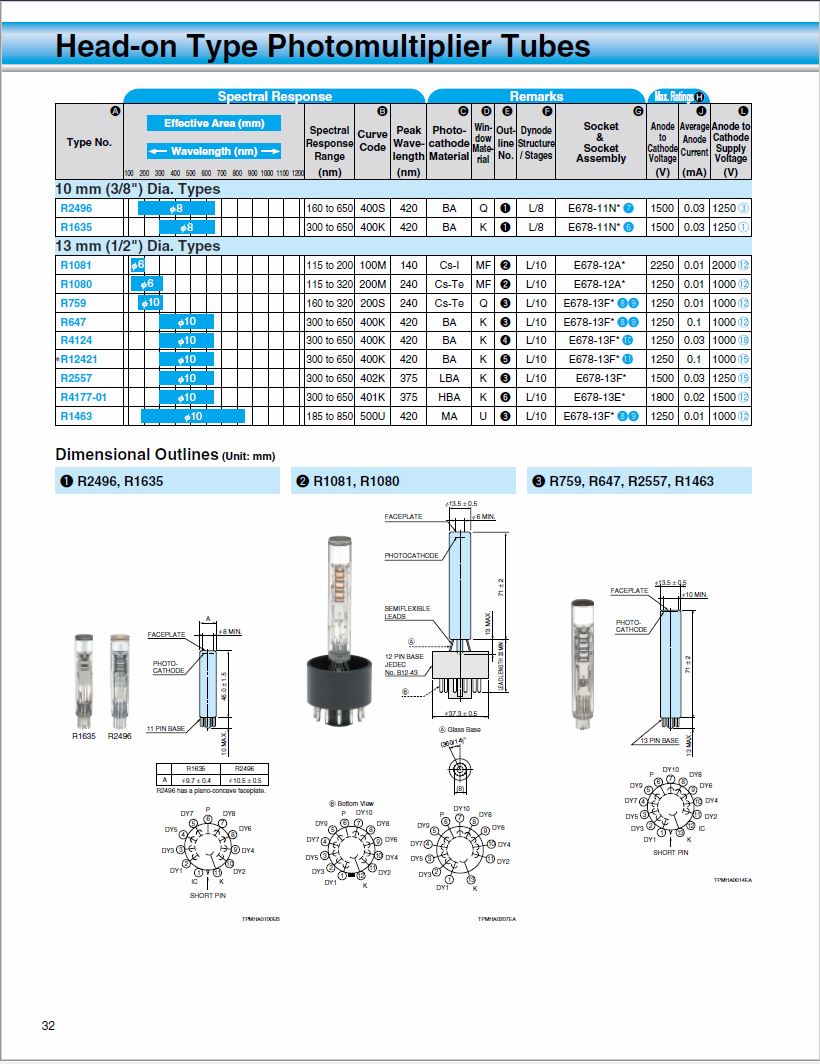
Screenshots/Capture3.JPG
