PorterMatt/CherenkovDetector/Screenshots/Capture.JPG

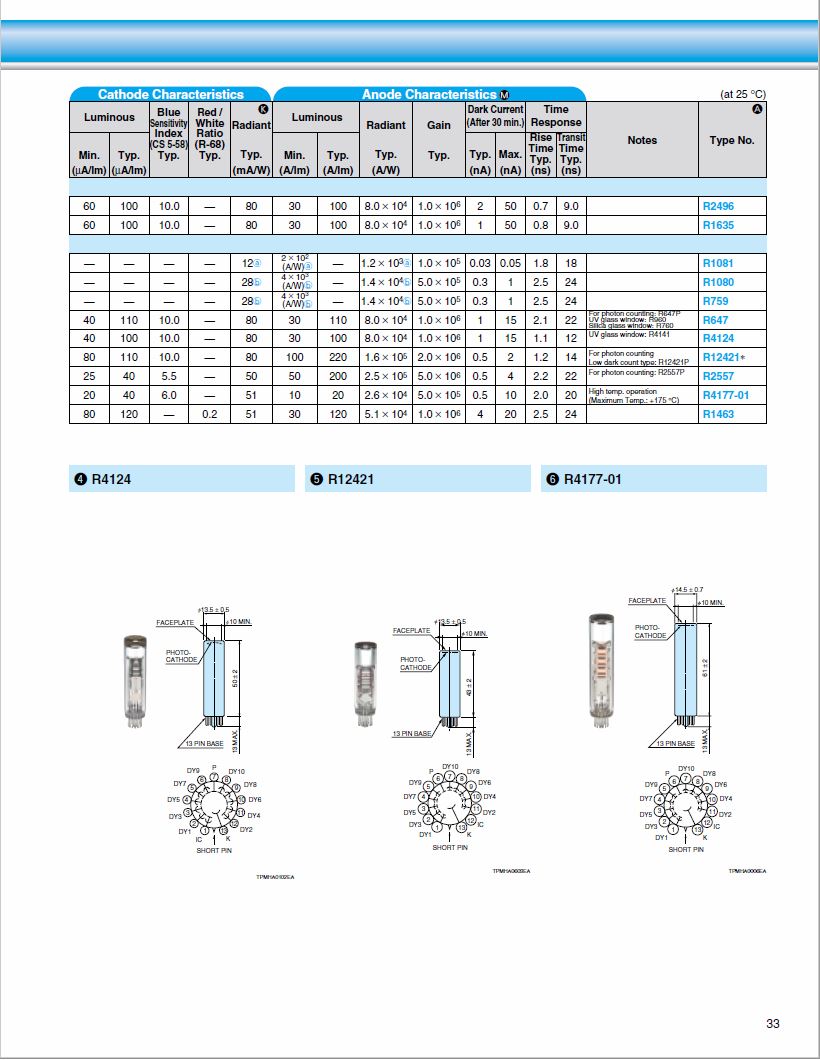
Screenshots/Capture.JPG
