PorterMatt/CherenkovDetector/Screenshots/LB1-1.JPG

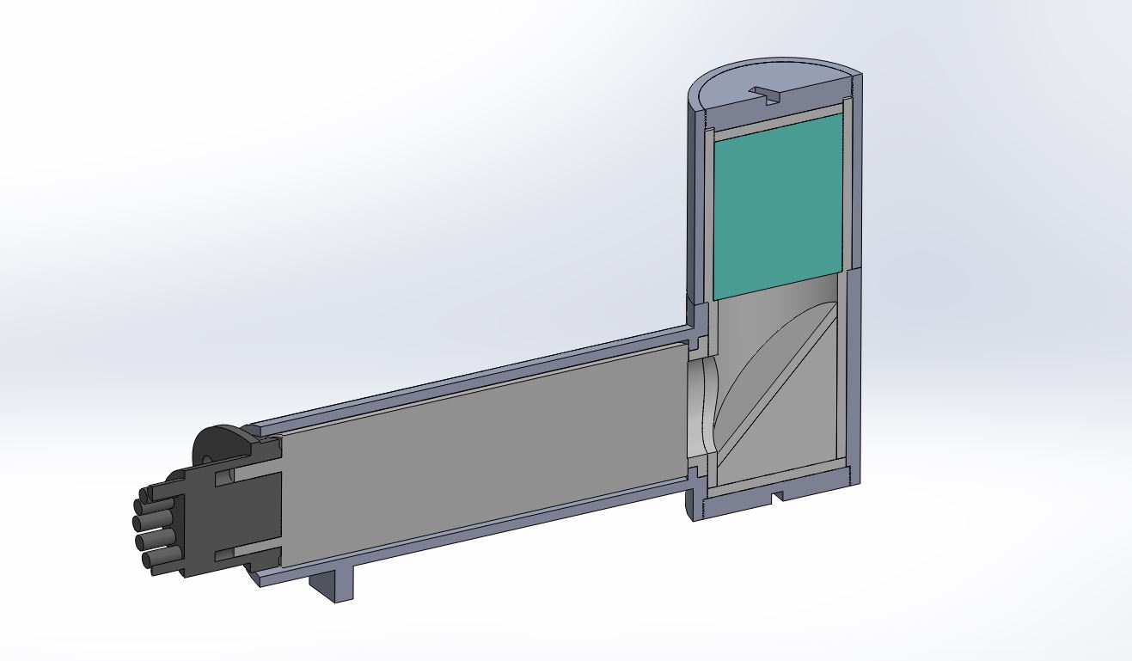
Screenshots/LB1-1.JPG
