PorterMatt/CherenkovDetector/Screenshots/LB1-2.JPG

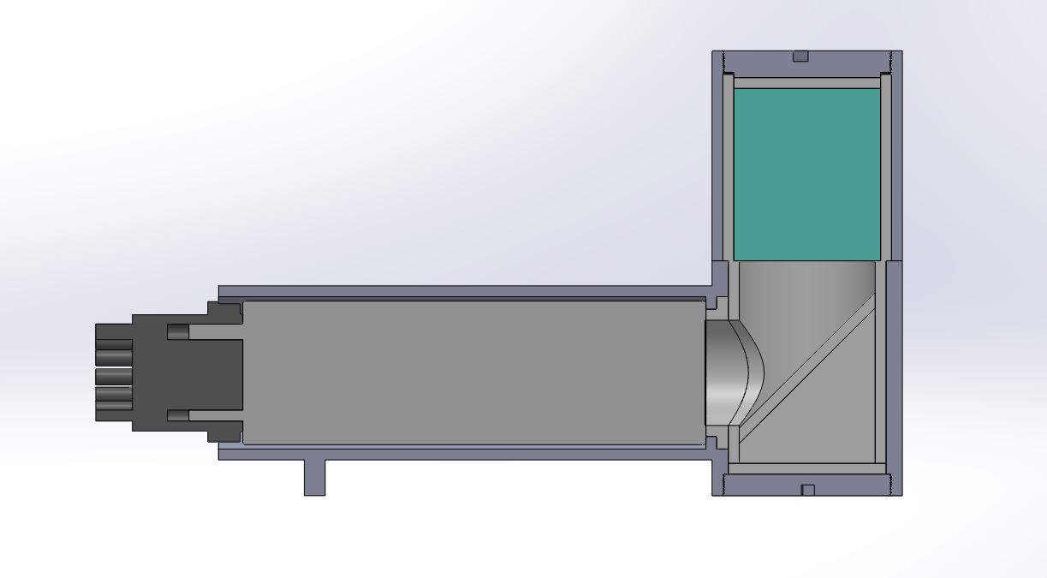
Screenshots/LB1-2.JPG
