PorterMatt/CherenkovDetector/Screenshots/LB1.JPG

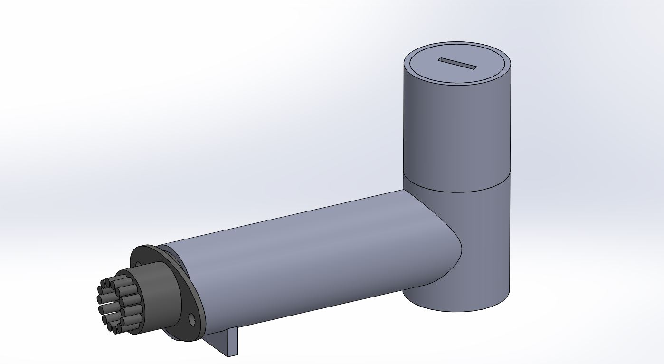
Screenshots/LB1.JPG
