PorterMatt/CherenkovDetector/Screenshots/LB2-1.JPG

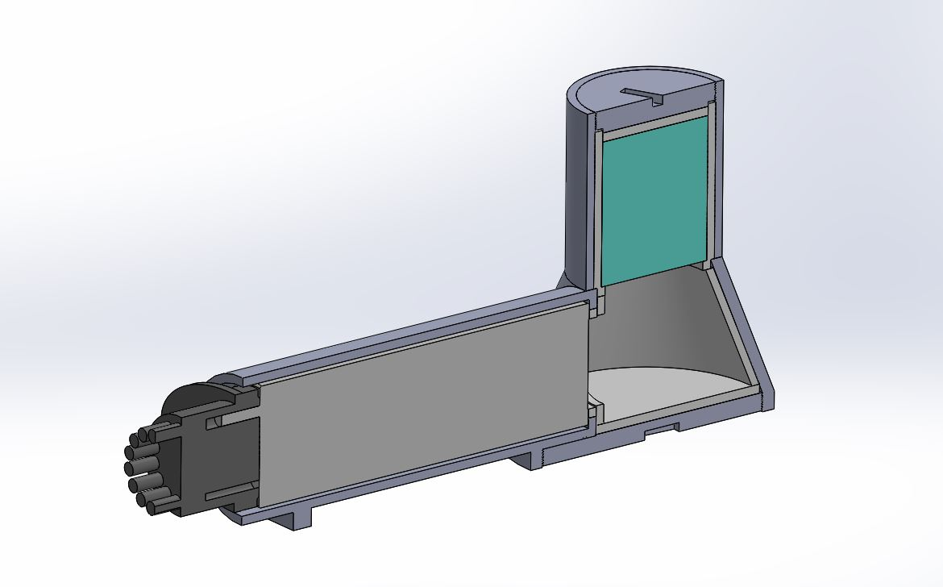
Screenshots/LB2-1.JPG
