PorterMatt/CherenkovDetector/Screenshots/LB2.JPG

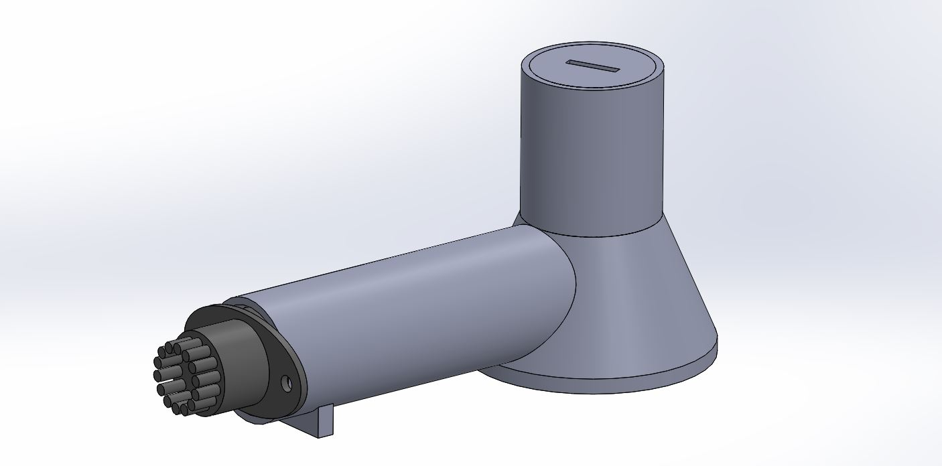
Screenshots/LB2.JPG
