PorterMatt/CherenkovDetector/Screenshots/Socket.JPG

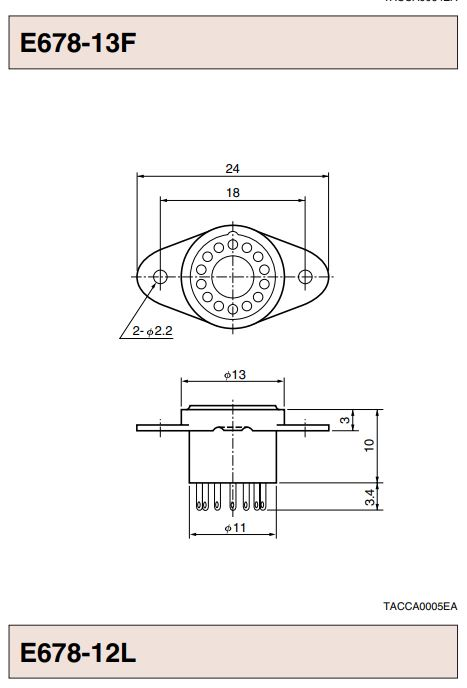
Screenshots/Socket.JPG
