PorterMatt/CherenkovDetector/Screenshots/SSD.JPG

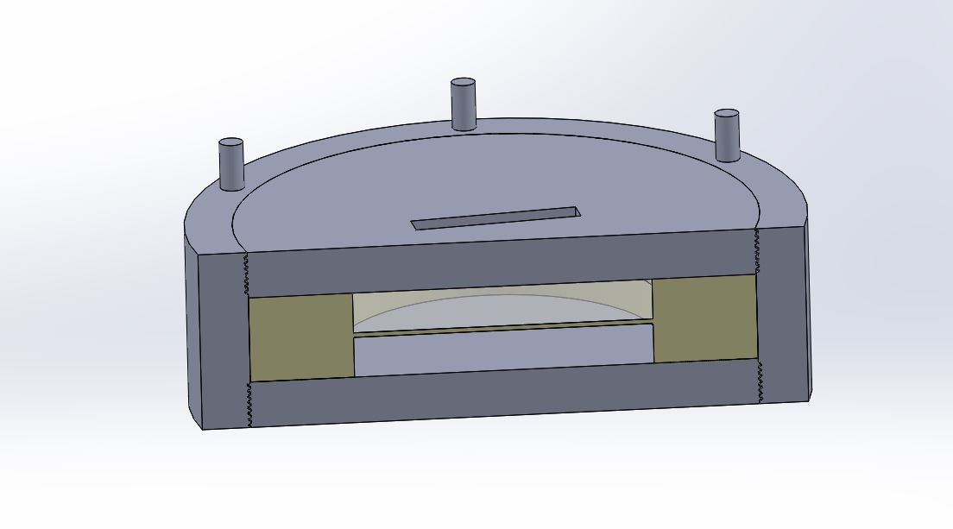
Screenshots/SSD.JPG
