PorterMatt/CherenkovDetector/Screenshots/Teflon_Price.JPG

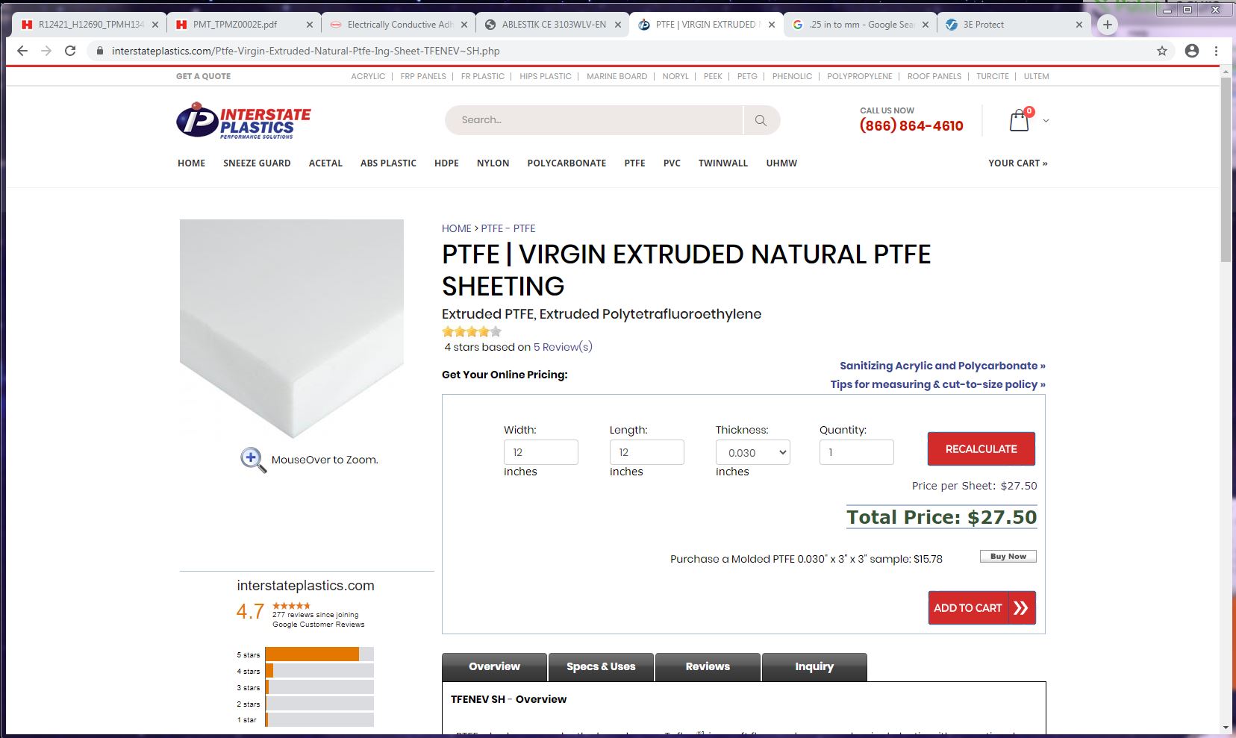
Screenshots/Teflon_Price.JPG
