PorterMatt/CherenkovDetector/Swirl.JPG

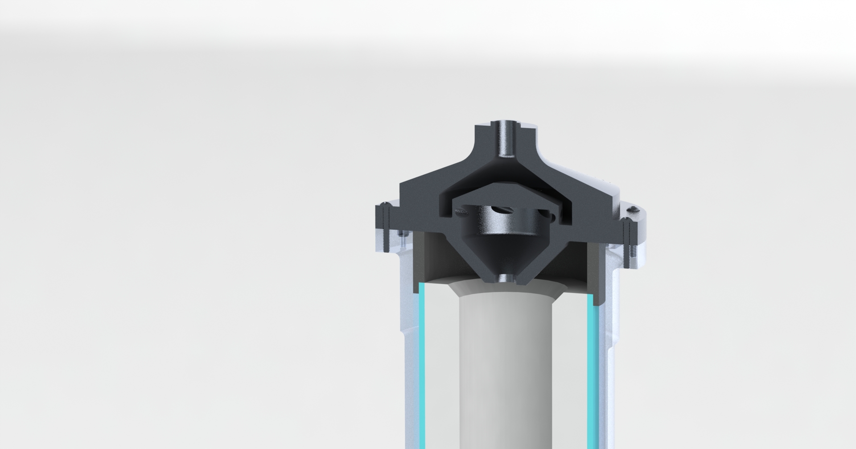
Swirl.JPG
