PorterMatt/CherenkovDetector/PICAP (Jim Connell)/PICAP drawings and BOM/Circuit Boards/Drawings/xy/Boards.docx

Top board assembly

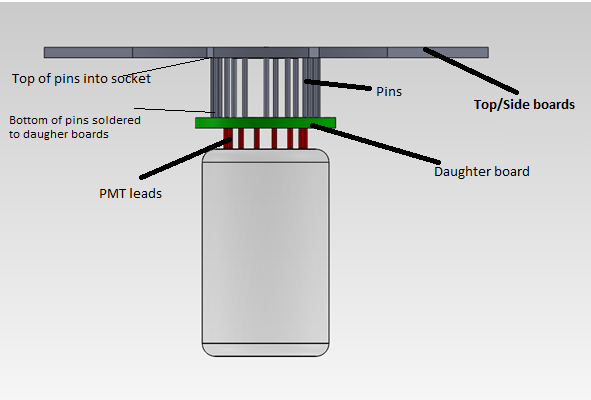
[picture p224: figure]
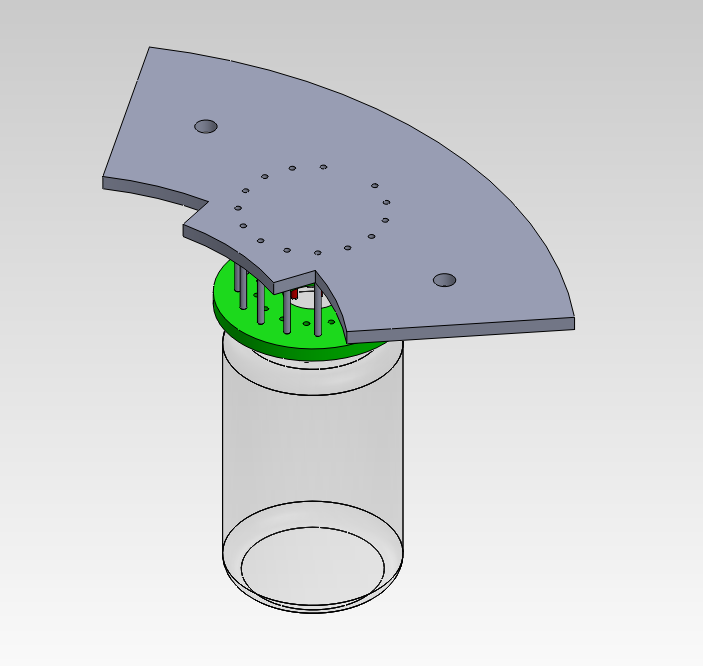
[picture p225: figure]
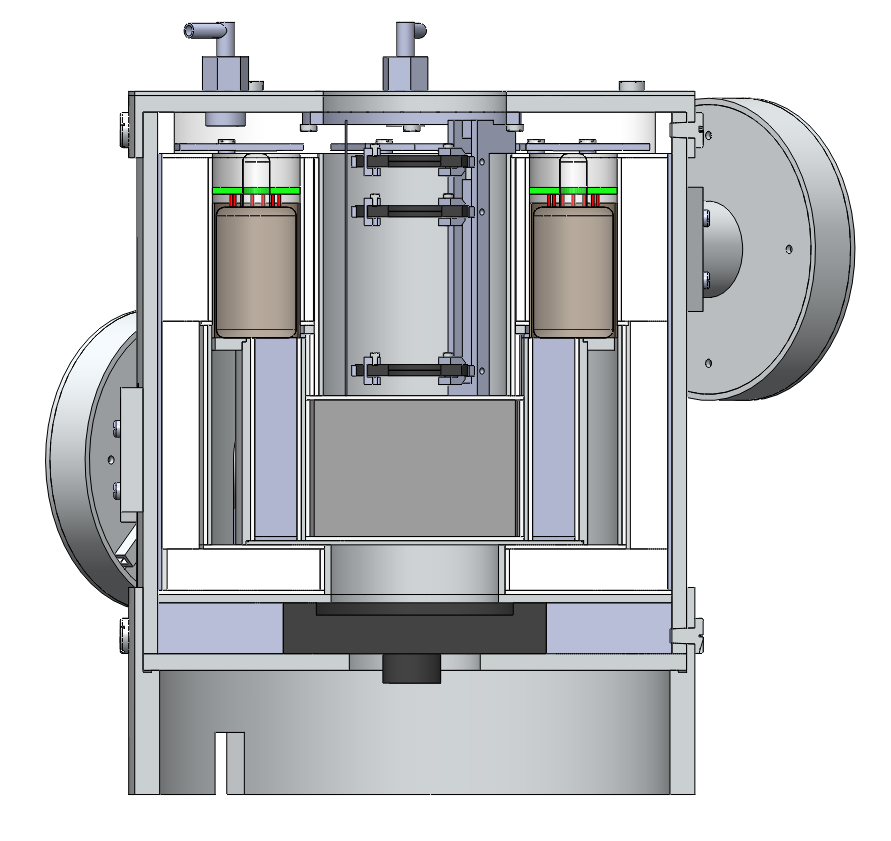
[picture p226: figure]
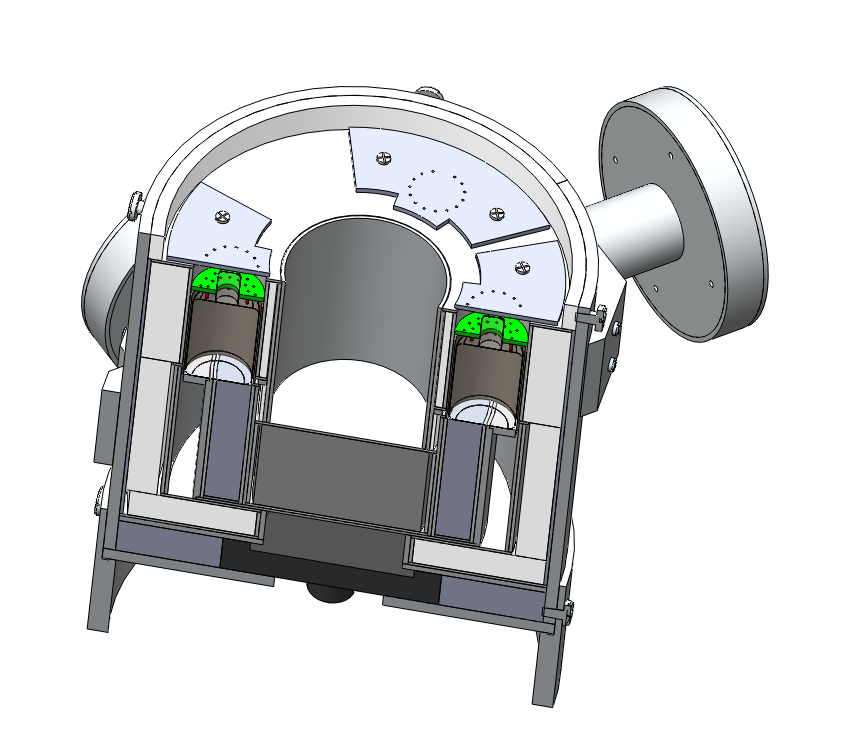
[picture p227: figure]

Side and Front board assembly

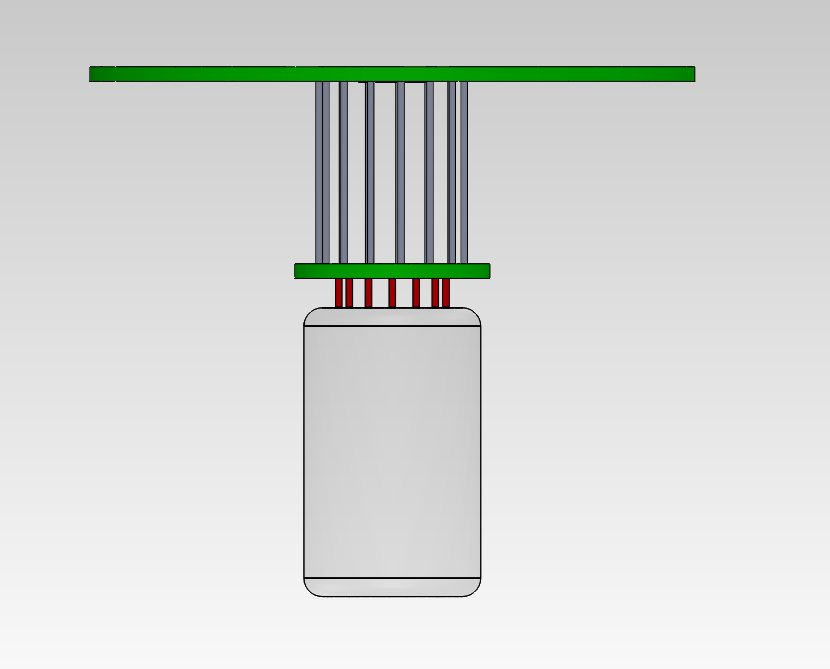
[picture p228: figure]
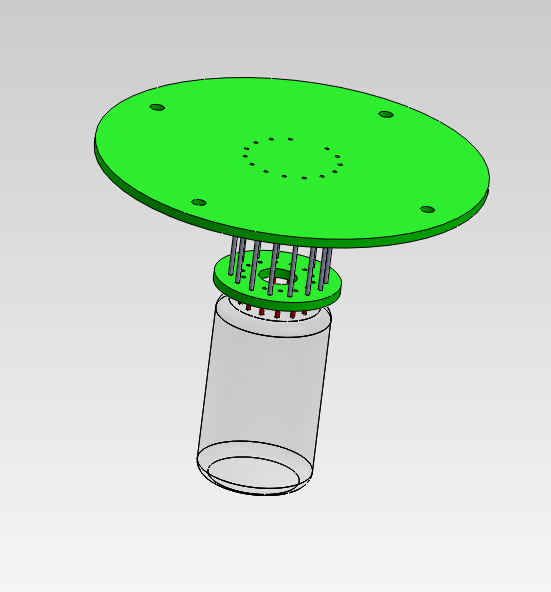
[picture p229: figure]
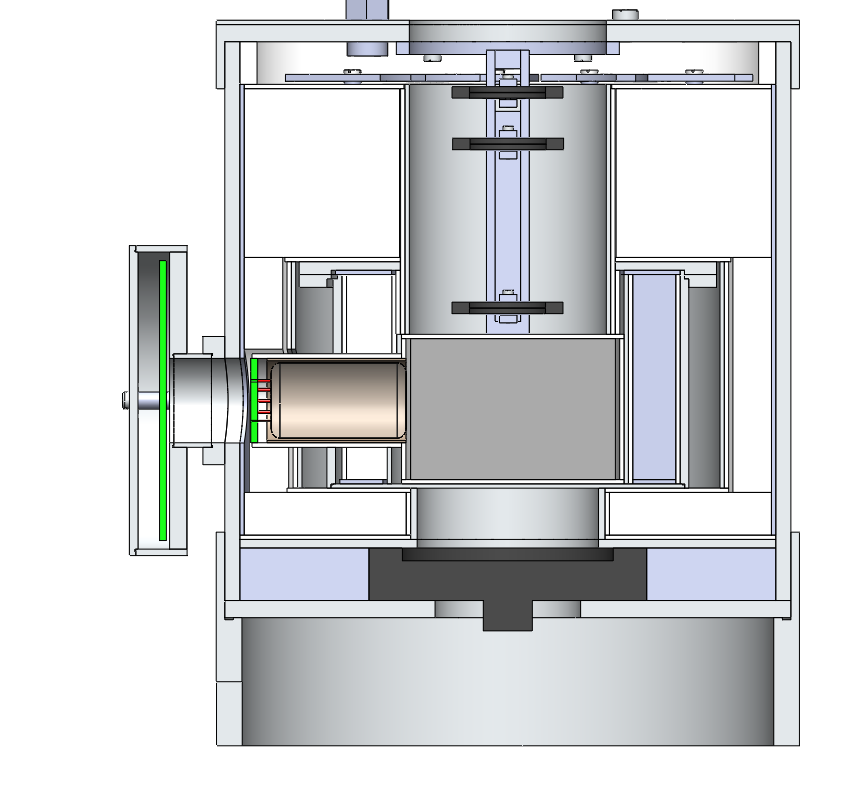
[picture p230: figure]
