PorterMatt/CherenkovDetector/LightPulser/R.A. SOURCE INVENTORY.xlsx

Sheet: R.A. SOURCE INVENTORY
ID | UNH EHS ID# | ISOTOPE | ACTIVITY ON PURCHASE DATE (µCi) | HALF LIFE (DAYS) | PURCHASE DATE | TODAY'S DATE | ACTIVITY ON TODAY'S DATE (µCi) | FORM | LOCATION | NOTE | ID | ISOTOPE | Manufacturer | Manufacturer Number(s)
1 | 1041 | Am-241 | 12.14 | 167170 | 1975-10-01 | 2020-08-19 | 11.34 | Button | MORSE 328 | rectangular plastic chip (red, 24 x 11 mm) | 1 | Am-241 | Amersham | R 0529
2 | 1058 | Am-241 | 0.10 | 167170 | 1981-10-01 | 2020-08-19 | 0.09 | NaI scint | MORSE 328 | in 8mm x 8mm cyl. housing, light pulse for PMT testing | 2 | Am-241
3 | 1105 | Am-241 | 1.00 | 167170 | 1995-01-15 | 2020-08-19 | 0.96 | plastic scint | MORSE 328 | IFC, tagged source, 10mm diam, 10mm thick | 3 | Am-241 | Isotope Products | Source No. 484-5-4; Catalog no.: Am-241
4 | 1106 | Am-241 | 1.00 | 167170 | 1995-01-15 | 2020-08-19 | 0.96 | plastic scint | MORSE 328 | IFC, tagged source, 10mm diam, 10mm thick | 4 | Am-241 | Isotope Products | Source No. 484-5-5; Catalog no.: Am-241
5 | 1109 | Am-241 | 1.00 | 167170 | 1995-01-15 | 2020-08-19 | 0.96 | plastic scint | MORSE 328 | IFC, tagged source, 10mm diam, 10mm thick | 5 | Am-241 | Isotope Products | Source No. 484-5-6; Catalog no.: Am-241
6 | 1013 | Am-241/Be | 10000 | 167170 | 1965-12-01 | 2020-08-19 | 9204.75 | Bucket | MORSE 328 | neutron source in 1" diam metal bucket, stored in 9" cyl army-green can | 6 | Am-241/Be | Monsanto
7 | 1016 | Am-241/Be | 50000 | 167170 | 1965-12-01 | 2020-08-19 | 46023.76 | Bucket | MORSE 328 | neutron source in 1" diam metal bucket, stored in 9" cyl army-green can | 7 | Am-241/Be | Monsanto
9 | 1043 | Ba-133 | 11.58 | 3653 | 1975-10-01 | 2020-08-19 | 0.52 | Button | MORSE 328 | rectangular plastic chip (white, 24 x 11 mm) | 9 | Ba-133 | Amersham | R 0529
11 | 1110 | Ba-133 | 99.30 | 3653 | 1995-02-01 | 2020-08-19 | 16.90 | disk | MORSE 328 | 1 inch diam. orange plastic diskl (calibrated +/- 3.2%) | 11 | Ba-133 | Isotope Products | Source no.: 472-61-1; Catalog no.: GF-133
12 | 1112 | Cd-109 | 183.20 | 462.59 | 1995-02-01 | 2020-08-19 | 0.0001549833899 | disk | MORSE 328 | 1 inch diam. metal disk, gold label (calibrated +/- 3.6%) | 12 | Cd-109 | Isotope Products | Source no.: 472-61-3; Catalog no.: GF-109
14 | 1040 | Co-60 | 12.03 | 1921 | 1975-10-01 | 2020-08-19 | 0.03 | Button | MORSE 328 | rectangular plastic chip (light green, 24 x 11 mm) | 14 | Co-60 | Amersham | R 0529
15 | 1059 | Co-60 | 0.06 | 1921 | 1981-10-01 | 2020-08-19 | 0.0003748284352 | plastic scint | MORSE 328 | 10mm diam, 5 mm thick, painted white | 15 | Co-60
16 | 1060 | Co-60 | 0.03 | 1921 | 1981-10-01 | 2020-08-19 | 0.00015 | plastic scint | MORSE 328 | 10mm diam, 5 mm thick, painted white | 16 | Co-60
17 | 1090 | Co-60 | 7.20 | 1921 | 1992-08-15 | 2020-08-19 | 0.18 | Button | MORSE 328 | rectangular plastic chip (clear, green lettering, 24 x 11 mm) | 17 | Co-60
18 | 1103 | Co-60 | 1.00 | 1921 | 1995-01-15 | 2020-08-19 | 0.03428 | plastic scint | MORSE 328 | IFC, tagged source, 10mm diam, 10mm thick | 18 | Co-60 | Isotope Products | Source No. 484-5-1; Catalog no.: PSC-060
19 | 1104 | Co-60 | 1.00 | 1921 | 1995-01-15 | 2020-08-19 | 0.03 | plastic scint | MORSE 328 | IFC, tagged source, 10mm diam, 10mm thick | 19 | Co-60 | Isotope Products | Source No. 484-5-2; Catalog no.: PSC-060
20 | 1107 | Co-60 | 1.00 | 1921 | 1995-01-15 | 2020-08-19 | 0.03 | plastic scint | MORSE 328 | IFC, tagged source, 10mm diam, 10mm thick | 20 | Co-60 | Isotope Products | Source No. 484-5-3; Catalog no.: PSC-060
21 | 1042 | Cs-137 | 11.18 | 10958 | 1975-10-01 | 2020-08-19 | 3.96 | Button | MORSE 328 | rectangular plastic chip (yellow, 24 x 11 mm) | 21 | Cs-137 | Amersham | R 0529
22 | 1091 | Cs-137 | 9.30 | 10957.5 | 1992-08-15 | 2020-08-19 | 4.87 | Button | MORSE 328 | rectangular plastic chip (yellow, 24 x 11 mm) | 22 | Cs-137 | Amersham | code: CDR151; number: 25618
25 | 1057 | Na-22 | 1000 | 942 | 1981-09-01 | 2020-08-19 | 0.03 | SS rod | MORSE 328 | 0.3" diam 4" long SS rod | 25 | Na-22
26 | 1079 | Na-22 | 2000 | 942 | 1989-03-01 | 2020-08-19 | 0.42 | Alum Screw | MORSE 328 | 1" long 10-32 screw with 3/8" hex head | 26 | Na-22
27 | 1080 | Na-24 | 50000 | 1 | 1989-03-01 | 2020-08-19 | 0.00 | Alum Screw | MORSE 328 | 1" long 10-32 screw with 3/8" hex head, mislabeled as Na-23 | 27 | Na-24
35 | 1078 | Na-24 | 10000 | 1 | 1989-03-01 | 2020-08-19 | 0.00 | Alum Screw | MORSE 328 | 1" long 10-32 screw with 3/8" hex head, mislabeled as Na-23 | 35 | Na-24
36 | 1061 | Am-241 | 0.10 | 167170 | 1981-10-01 | 2020-08-19 | 0.09 | NaI scint. | MORSE 328 | in 6mm x 6mm cyl. housing, light pulse for PMT testing | 36 | Am-241
37 | 1062 | Am-241 | 0.10 | 167170 | 1981-10-01 | 2020-08-19 | 0.09 | NaI scint. | MORSE 328 | in 6mm x 6mm cyl. housing, light pulse for PMT testing | 37 | Am-241
38 | 1118 | Co-57 | 199.9 | 271.79 | 1996-02-01 | 2020-08-19 | 2.342325649e-08 | brass disk | MORSE 328 | point source active 0.005 inch diam. in 0.5 inch diam brass disk (calibrated +/- 3.1%) | 38 | Co-57 | Isotope Products | Source No.: 473-49; Catalog no.: GF-0105
39 | 1119 | Am-241 | 2000 | 167170 | 1996-12-20 | 2020-08-19 | 1929.59 | SS pin | MORSE 328 | point source active 1mm diam in 2mm diam 10mm long SS cyl | 39 | Am-241 | Amersham | source model no.: AMC.P3; catalog model no.: AMC.21; serial/batch no.: 0297LQ
40 | 1120 | Cs-137 | 1000 | 10958 | 1997-10-01 | 2020-08-19 | 589.38 | SS pin | MORSE 328 | point source active 1mm diam in 3mm diam 10mm long SS cyl | 40 | Cs-137 | Isotope Products | Source no.: LL-542; Catalog no.: PHI-137-1M; Capsule type: A3224-01
41 | 1121 | Co-60 | 197.1 | 1921 | 1998-01-01 | 2020-08-19 | 9.98 | disk | MORSE 328 | 1 inch diam green plastic disk, 5mm active diam (calibrated +/- 3.0%) | 41 | Co-60 | Isotope Products | Source No.: 579-90; Catalog no.: GF-060-200U
42 | 1122 | Am-241 | 1.00 | 167170 | 1998-06-01 | 2020-08-19 | 0.97 | plastic scint | MORSE 328 | IFC, tagged source, 10mm diam, 10mm thick | 42 | Am-241 | Isotope Products | Lot #: 614-10-1; Catalog no.: PSC-241
43 | 1123 | Am-241 | 1.00 | 167170 | 1998-06-01 | 2020-08-19 | 0.97 | plastic scint | MORSE 328 | IFC, tagged source, 10mm diam, 10mm thick | 43 | Am-241 | Isotope Products | Lot #: 614-10-1; Catalog no.: PSC-241
44 | 1125 | Am-241 | 1.00 | 167170 | 1998-06-01 | 2020-08-19 | 0.97 | plastic scint | MORSE 328 | IFC, tagged source, 10mm diam, 10mm thick | 44 | Am-241 | Isotope Products | Lot #: 614-10-1; Catalog no.: PSC-241
45 | 1126 | Am-241 | 1.00 | 167170 | 1998-06-01 | 2020-08-19 | 0.97 | plastic scint | MORSE 328 | IFC, tagged source, 10mm diam, 10mm thick | 45 | Am-241 | Isotope Products | Lot #: 614-10-1; Catalog no.: PSC-241
46 | 1127 | Am-241 | 1.00 | 167170 | 1998-06-01 | 2020-08-19 | 0.97 | plastic scint | MORSE 328 | IFC, tagged source, 10mm diam, 10mm thick | 46 | Am-241 | Isotope Products | Lot #: 614-10-1; Catalog no.: PSC-241
47 | 1128 | Am-241 | 1.00 | 167170 | 1998-06-01 | 2020-08-19 | 0.97 | plastic scint | MORSE 328 | IFC, tagged source, 10mm diam, 10mm thick | 47 | Am-241 | Isotope Products | Lot #: 614-10-1; Catalog no.: PSC-241
48 | 1129 | Am-241 | 1.00 | 167170 | 1998-06-01 | 2020-08-19 | 0.97 | plastic scint | MORSE 328 | IFC, tagged source, 10mm diam, 10mm thick | 48 | Am-241 | Isotope Products | Lot #: 614-10-1; Catalog no.: PSC-241
49 | 1124 | Am-241 | 0.10 | 167170 | 1998-06-01 | 2020-08-19 | 0.10 | plastic scint | MORSE 328 | IFC, tagged source, 10mm diam, 10mm thick | 49 | Am-241 | Isotope Products | Lot #: 614-10-2; Catalog no.: PSC-241
50 | 1130 | Am-241 | 0.10 | 167170 | 1998-06-01 | 2020-08-19 | 0.10 | plastic scint | MORSE 328 | IFC, tagged source, 10mm diam, 10mm thick | 50 | Am-241 | Isotope Products | Lot #: 614-10-2; Catalog no.: PSC-241
51 | 1131 | Am-241 | 0.10 | 167170 | 1998-06-01 | 2020-08-19 | 0.10 | plastic scint | MORSE 328 | IFC, tagged source, 10mm diam, 10mm thick | 51 | Am-241 | Isotope Products | Lot #: 614-10-2; Catalog no.: PSC-241
52 | 1132 | Am-241 | 0.10 | 167170 | 1998-06-01 | 2020-08-19 | 0.10 | plastic scint | MORSE 328 | IFC, tagged source, 10mm diam, 10mm thick | 52 | Am-241 | Isotope Products | Lot #: 614-10-2; Catalog no.: PSC-241
53 | 1133 | Am-241 | 0.10 | 167170 | 1998-06-01 | 2020-08-19 | 0.10 | plastic scint | MORSE 328 | IFC, tagged source, 10mm diam, 10mm thick | 53 | Am-241 | Isotope Products | Lot #: 614-10-2; Catalog no.: PSC-241
54 | 1134 | Co-57 | 800 | 271.79 | 1998-07-15 | 2020-08-19 | 9.225362166e-07 | brass disk | MORSE 328 | point source active 0.011 inch diam. in 0.5 inch diam brass disk | 54 | Co-57 | Isotope Products | Source No.: 533-37; Catalog no.: GF-057
55 | 1135 | Fe-55 | 78 | 997.1325 | 1998-11-05 | 2020-08-19 | 0.31 | disk | MORSE 328 | 1 inch diam metal disk, blue label | 55 | Fe-55 | Du Pont Pharma | Source type: NES-441; S/N: S441025; Isotope Lot no.: 0497FE
56 | 1146 | Fe-55 | 2000 | 997.1325 | 2000-08-15 | 2020-08-19 | 12.43 | SS disk | MORSE 328 | SS disk, 12.7 mm diam, 10 mm active diam., 0.005 in. Ni backing | 56 | Fe-55 | Isotope Products | IPL type A3215 capsule, S/N TT-829; Catalog no.: ES1SPR03
57 | 1160 | Sr-90 | 100 | 10409.625 | 2004-02-23 | 2020-08-19 | 66.96 | SS button | MORSE 328 | SS cylinder 5 mm height x 8 mm diam with evaporated Strontium in ceramic matrix | 57 | Sr-90 | Isotope Products | IPL type A3203 capsule; Catalog no.: SR032030100U
58 | 1161 | Co-57 | 244 | 271.79 | 2004-05-01 | 2020-08-19 | 6.218132769e-05 | lexan disk | MORSE 328 | point source active 0.011 inch diam. in 0.5 inch diam lexan disk (calibrated +/- 3.0%) | 58 | Co-57 | Isotope Products | IPL catalog #: GF-057-RFQ265, IPL source #: 1046-58
59 | 1029 | Co-60 | 130 | 1921 | 1970-10-19 | 2020-08-19 | 0.18 | 5/8" dia. rod blue | MORSE 328 | plastic BAR-BLUE (#12 from Ed Chupp inventory 1 Feb 2006) | 59 | Co-60 | New England Nuclear
60 | 1021 | I-129 | 3 | 5734425000 | 1967-10-01 | 2020-08-19 | 3.00 | DISC-BLUE | MORSE 328 | DISC-BLUE (#22 from Ed Chupp inventory 1 Feb 2006) | 60 | I-129 | New England Nuclear
61 | 1011 | Ba-133 | 11.5 | 3653 | 1965-07-01 | 2020-08-19 | 0.25 | 5/8" dia. rod black | MORSE 328 | plastic BAR-BLACK (#23 from Ed Chupp inventory 1 Feb 2006) | 61 | Ba-133 | New England Nuclear
62 | 1051 | Cs-137 | 29.71 | 10958 | 1978-10-01 | 2020-08-19 | 11.29 | 1 in. plastic disk orange | MORSE 328 | plastic DISC-ORANGE (#27 from Ed Chupp inventory 1 Feb 2006) | 62 | Cs-137 | Isotope Products
63 | 1035 | Cs-137 | 10.1 | 10958 | 1972-05-01 | 2020-08-19 | 3.31 | 5/8" dia. rod green | MORSE 328 | plastic BAR-GREEN (#28 from Ed Chupp inventory 1 Feb 2006) | 63 | Cs-137 | New England Nuclear
64 | 1012 | Cs-137 | 11.3 | 10958 | 1965-06-01 | 2020-08-19 | 3.16 | 5/8" dia. rod green | MORSE 328 | plastic BAR-GREEN (#29 from Ed Chupp inventory 1 Feb 2006) | 64 | Cs-137 | New England Nuclear
66 | 1049 | Th-228 | 31.39 | 698.72325 | 1978-10-01 | 2020-08-19 | 8.056030184e-06 | 1 in. plastic disk orange | MORSE 328 | plastic DISC-ORANGE (#34 from Ed Chupp inventory 1 Feb 2006) | 66 | Th-228 | Isotope Products
67 | 1048 | Am-241 | 12.91 | 167170 | 1978-10-01 | 2020-08-19 | 12.12 | 1 in. plastic disk orange | MORSE 328 | plastic DISC-ORANGE (#37 from Ed Chupp inventory 1 Feb 2006) | 67 | Am-241 | Isotope Products
68 | 1025 | Am-241 | 5.9 | 167170 | 1969-06-01 | 2020-08-19 | 5.46 | 5/8" dia. rod black | MORSE 328 | plastic BAR-BLACK (#38 from Ed Chupp inventory 1 Feb 2006) | 68 | Am-241 | New England Nuclear
69 | 1002 | Am-241 | 360 | 167170 | unknown | 2020-08-19 |  | plastic scint | MORSE 328 | unknown (#39 from Ed Chupp inventory 1 Feb 2006) | 69 | Am-241 | unknown
70 | 1044 | Am-241 | unknown | 167170 | unknown | 2020-08-19 |  | 3/4" dia. Scint. can | MORSE 328 | 3/4" DIA. HARSHAW CAN (#50 from Ed Chupp inventory 1 Feb 2006) | 70 | Am-241 | unknown
71 | 1071 | Co-60 | 10 | 1921 | 1987-07-01 | 2020-08-19 | 0.13 | 1 in. plastic disk orange | MORSE 328 | plastic DISC-ORANGE (#52 from Ed Chupp inventory 1 Feb 2006) | 71 | Co-60 | Isotope Products
73 | 1072 | Th-228 | 100 | 698.72325 | 1987-09-01 | 2020-08-19 | 0.0006493299673 | 1 in. plastic disk orange | MORSE 328 | plastic DISC-ORANGE (#56 from Ed Chupp inventory 1 Feb 2006) | 73 | Th-228 | Isotope Products
74 | 1006 | Am-241 | unknown | 167170 | unknown | 2020-08-19 |  | plastic scint | MORSE 328 | plastic LIGHT-PULSER (#58 from Ed Chupp inventory 1 Feb 2006) | 74 | Am-241 | unknown
75 | 1101 | Cd-109 | 10 | 462 | 1994-02-01 | 2020-08-19 | 4.804132311e-06 | 1 in. plastic disk green | MORSE 328 | plastic DISC-green (#60A from Ed Chupp inventory 1 Feb 2006) | 75 | Cd-109 | Oxford
77 | 1023 | Am-241 | 0.0040 | 167170 | 1968-04-02 | 2020-08-19 | 0.0037 | 3 in. NaI/PMT Assy | MORSE 328 | Harshaw 3 inch Nai(Tl) / PMT assembly | 77 | Am-241 | Harshaw
78 | 1190 | Cf-252 | 2733.6 | 965 | 2008-05-28 | 2020-08-19 | 110.61 | Zircalloy Stud | MORSE A438 | .37" diameter, 1.5" length stud with 10-32 stud on end | 78 | Cf-252 | Frontier Technology Inc | Model: Z100 SN: FTC-CF-Z1503
79 | 1192 | Co-57 | 2200.0 | 271.77 | 2008-09-04 | 2020-08-19 | 0.03 | SS Pin | MORSE 328 | .117" dia x .198" length ss pin .040" active dia | 79 | Co-57 | North American Scientific | Model: IND1403
80 | 1193 | Cd-109 | 106.4 | 462 | 2009-05-01 | 2020-08-19 | 0.22 | 1" Disk | MORSE 328 | 25.4mm x 2.18mm disk Aluminized Mylar and Kapton | 80 | Cd-109 | Eckert & Ziegler | GF-109-M
81 | 1203 | Cs-137 | 0.0957 | 10957.5 | 2012-04-01 | 2020-08-19 | 0.0789 | 1" Disk | MORSE 328 | 25.4mm x 2.18mm disk Aluminized Mylar and Kapton | 81 | Cs-137 | Eckert & Ziegler | BF-137-A
82 | 1209 | Co-57 | 1000.0 | 271.77 | 2013-06-10 | 2020-08-19 | 1.23 | SS Pin | MORSE 328 | .117" dia x .198" length ss pin .040" active dia | 82 | Co-57 | Eckert & Ziegler | Model: PHI-057
83 | 1214 | Am-241 | 0.046 | 167170 | 2013-09-01 | 2020-08-19 | 0.045 | A-2 Disk | MORSE 328 | 12.7mm OD x 6.35mm THK | 83 | Am-241 | Eckert & Ziegler | Model A-2
84 | 1216 | Cd-109 | 113.8 | 462 | 2013-12-01 | 2020-08-19 | 2.87 | 1" Disk | MORSE 328 | 25.4mm x 2.18mm disk Aluminized Mylar and Kapton | 84 | Cd-109 | Eckert & Ziegler | GF-109-M
85 | 1218 | Co-57 | 25000.0 | 271.77 | 2015-03-01 | 2020-08-19 | 153.69 | SS Pin | MORSE 328 | .120" dia x .4" length ss pin .030" active dia | 85 | Co-57 | Eckert & Ziegler | Model: A3807
86 | 1219 | Co-57 | 25000.0 | 271.77 | 2015-03-01 | 2020-08-19 | 153.69 | SS Pin | MORSE 328 | .120" dia x .4" length ss pin .030" active dia | 86 | Co-57 | Eckert & Ziegler | Model: A3807
87 | 1221 | Cf-252 | 2690.0 | 965 | 2016-05-13 | 2020-08-19 | 878.33 | Zircalloy Stud | MORSE A438 | .37" diameter, 1.5" length stud with 10-32 stud on end | 87 | Cf-252 | Frontier Technology Inc | Model: Z100 SN: FTC-CF-Z1503
88 | 1225 | Co-57 | 25000.0 | 271.77 | 2019-09-01 | 2020-08-19 | 10165.36 | SS Pin | MORSE 328 | .120" dia x .4" length ss pin .030" active dia | 88 | Co-57 | Eckert & Ziegler | Model: A3807
89 | 1226 | Co-57 | 25000.0 | 271.77 | 2019-09-01 | 2020-08-19 | 10165.36 | SS Pin | MORSE 328 | .120" dia x .4" length ss pin .030" active dia | 89 | Co-57 | Eckert & Ziegler | Model: A3807
90 | 1228 | Am-241 | 25000.0 | 167170 | 2020-06-22 | 2020-08-19 | 24994.01 | SS Pin | MORSE 328 | .173" dia x .394" length ss pin .130" active dia | 90 | Am-241 | Eckert & Ziegler | AM1P080025
end |  |  |  |  |  |  |  |  |  |  | end | 0
total activity |  |  | 264.55 | m.Ci. | total activity |  | 104.55 | m.Ci.
 |  |  |  | (at purchase date) |  |  |  | (currently) |  |  |  |  |  | 2018 Campaign
 |  |  |  |  |  |  |  |  |  |  |  |  |  | Source Numbers
 |  |  |  |  |  |  |  |  |  |  |  |  |  | 41, 18, 62, 67, 26
 |  |  |  |  |  |  |  |  |  |  |  |  |  | total activity microCi
 |  |  |  |  |  |  |  |  |  |  |  |  |  | 33.84859
 |  |  | n/s |  |  |  |  | Amounts On Hand and |  |  |  |  |  | mCi
 |  | CF-251(1) | 477533.4425 |  |  |  |  | Proposed Limits for Ryan/Legere Permit |  |  |  |  |  | 0.03384859475
 |  | CF-251(2) | 3791879.003 |  |  |  |  | Prepared by Jason Legere, May 2008
 |  |  |  |  |  |  |  |  | AMOUNT | Current | Current
 |  |  |  |  |  |  |  | ISOTOPE | ON HAND | LIMIT | LIMIT
 |  |  |  |  |  |  |  |  | (mCi) | (µCi) | (mCi)
 |  |  |  |  |  |  |  | Am-241 (alpha) | 4.52006223e-05 | 2000 | 2.0
 |  |  |  |  |  |  |  | Am-241(gamma) | 26.96 | 2000 | 2.0
 |  |  |  |  |  |  |  | Am-241/Be (n) | 55.23 | 60000 | 60.0
 |  |  |  |  |  |  |  | Ba-133 | 0.018 | 1100 | 1.1
 |  |  |  |  |  |  | x | Bi-207 | 0 | 1000 | 1.0
 |  |  |  |  |  |  |  | Cd-109 | 0.00309 | 3000 | 3.0
 |  |  |  |  |  |  |  | Cf-252 | 1.0 | 4000 | 4.0
 |  |  |  |  |  |  |  | Co-57 | 20.6394 | 55000 | 55.0
 |  |  |  |  |  |  |  | Co-60 | 0.0106 | 2000 | 2.0
 |  |  |  |  |  |  |  | Cs-137 | 0.616 | 2000 | 2.0
 |  |  |  |  |  |  |  | Fe-55 | 0.0127 | 2000 | 2.0
 |  |  |  |  |  |  |  | I-129 | 0.0030 | 10.00 | 0.01
 |  |  |  |  |  |  | x | Mn-54 | 0 | 5000 | 5.0
 |  |  |  |  |  |  |  | Na-22 | 0.0005 | 4000 | 4.0
 |  |  |  |  |  |  |  | Na-24 | 0.000 | 25000 | 25.0
 |  |  |  |  |  |  | x | Sn-113 | 0 | 5000 | 5.0
 |  |  |  |  |  |  |  | Sr-90 | 0.067 | 3000 | 3.0
 |  |  |  |  |  |  |  | Th-228 | 0 | 900 | 0.9
 |  |  |  |  |  |  | x | Y-88 | 0 | 5000 | 5.0
 |  |  |  |  |  |  |  | TOTALS | 104.55 |  | 182.0
 |  |  |  |  |  |  |  |  | (mCi) |  | (mCi)

Sheet: Proposed Limits
Amounts On Hand and
Proposed Limits for Ryan/Macri Permit
Prepared by John Macri, 1 Oct 2004
 | AMOUNT | PROPOSED | PROPOSED
ISOTOPE | ON HAND | LIMIT | LIMIT
 | (µCi) | (µCi) | (mCi)
Am-241 (alpha) | 0 | 2000 | 2.0
Am-241(gamma) | 1951.355402 | 2000 | 2.0
Am-241/Be (n) | 55228.50671 | 60000 | 60.0
Ba-133 | 17.41875239 | 1100 | 1.1
Bi-207 | 0 | 1000 | 1.0
Cd-109 | 0.0001549833899 | 3000 | 3.0
Co-57 | 6.312728717e-05 | 5000 | 5.0
Co-60 | 10.3 | 2000 | 2.0
Cs-137 | 598.2155038 | 2000 | 2.0
Fe-55 | 12.7387951 | 2000 | 3.0
Mn-54 | 0 | 5000 | 5.0
Na-22 | 0.5 | 4000 | 4.0
Na-24 | 0 | 25000 | 60.0
Sn-113 | 0 | 5000 | 5.0
Sr-90 | 67.0 | 3000 | 3.0
Th-228 | 0 | 1000 | 1.0
Y-88 | 0 | 5000 | 5.0
TOTALS | 57.89 |  | 164.1
 | (mCi) |  | (mCi)
