PorterMatt/CherenkovDetector/PICAP (Jim Connell)/PICAP drawings and BOM/Part list.xlsx

Part number | Folder location | Description | Count | Material
S-P02 | Scintillator assembly | C Scintillator | 1 | Plastic (we will provide)
S-A03 | Scintillator assembly | Aluminum inner cylinder | 2 | Aluminum
S-A04 | Scintillator assembly | Aluminum outer cylinder | 4 | Aluminum
S-A05 | Scintillator assembly | Aluminum bottom plate | 4 | Aluminum
S-A06 | Scintillator assembly | Aluminum top plate | 2 | Aluminum
S-A07 | Scintillator assembly | Aluminum Cover | 2 | Aluminum
S-P08 | Scintillator assembly | Support ring | 2 | BLACK PLASTIC
S-T11 | Scintillator assembly | Teflon bar | 2 | Teflon (we will provide)
S-T12 | Scintillator assembly | Teflon bar | 3 | Teflon (we will provide)
S-T13 | Scintillator assembly | Teflon bar | 3 | Teflon (we will provide)
A-A01 | Anti Assembly | Aluminum Cylinder | 2 | Aluminum
A-P03 | Anti Assembly | Side Anti Scintillator | 2 | Plastic (we will provide)
A-P04 | Anti Assembly | Top Anti Scintillator | 3 | Plastic (we will provide)
A-A07 | Anti Assembly | Aluminum Cylinder | 2 | Aluminum
A-A08 | Anti Assembly | Aluminum Cylinder | 2 | Aluminum
A-P12 | Anti Assembly | Bottom Anti Scintillator | 2 | Plastic (we will provide)
A-A13 | Anti Assembly | Aluminum Plate | 2 | Aluminum
A-P14 | Anti Assembly | Support ring | 2 | BLACK PLASTIC
A-A15 | Anti Assembly | Aluminum Base | 2 | Aluminum
A-P16 | Anti Assembly | Support ring | 2 | BLACK PLASTIC
A-A17 | Anti Assembly | Aluminum plate | 2 | Aluminum
C-A01 | Cover Assembly | Top Plate | 2 | Aluminum
C-A02 | Cover Assembly | Cover | 2 | Aluminum
M-A01 | Mushroom assembly | Assembly base | 5 | Aluminum
M-A02 | Mushroom assembly | Long Aluminum cylinder | 3 | Aluminum
M-A03 | Mushroom assembly | Aluminum plate | 5 | Aluminum
M-A04 | Mushroom assembly | Aluminum cylinder | 5 | Aluminum
M-A05 | Mushroom assembly | Aluminum plate | 5 | Aluminum
M-N06 | Mushroom assembly | Long Nylon spacer | 14 | Nylon
M-N07 | Mushroom assembly | Nylon spacer | 24 | Nylon
M-A08 | Mushroom assembly | Short Aluminum cylinder | 2 | Aluminum
M-A09 | Mushroom assembly | Wire guard | 4 | Aluminum
Y-A01 | Cylinder assembly | Half cylinder front | 2 | Aluminum
Y-A02 | Cylinder assembly | Half cylinder back | 2 | Aluminum
TOTAL |  |  | 123
