PorterMatt/CherenkovDetector/PICAP (Jim Connell)/PICAP drawings and BOM/Circuit Boards/Drawings/pins.docx

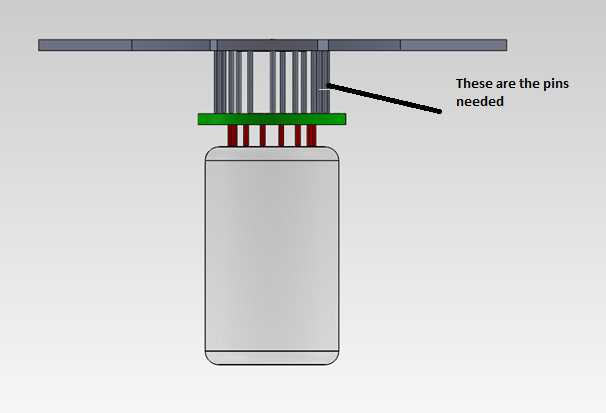
[picture p231: figure]
