PorterMatt/CherenkovDetector/PICAP (Jim Connell)/PICAP drawings and BOM/Circuit Boards/Drawings/Board directions.pdf

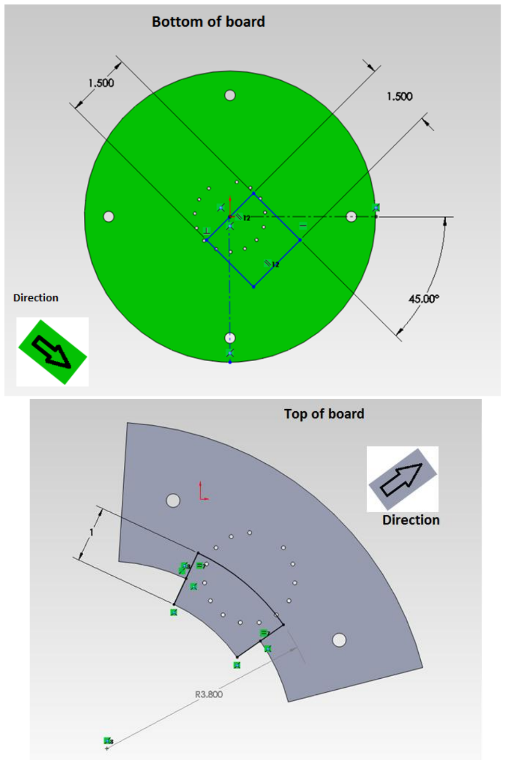
[picture p232: page 1]
