PorterMatt/CherenkovDetector/PICAP (Jim Connell)/PICAP drawings and BOM/Circuit Boards/Drawings/xy/R5611A-01 dim.pdf

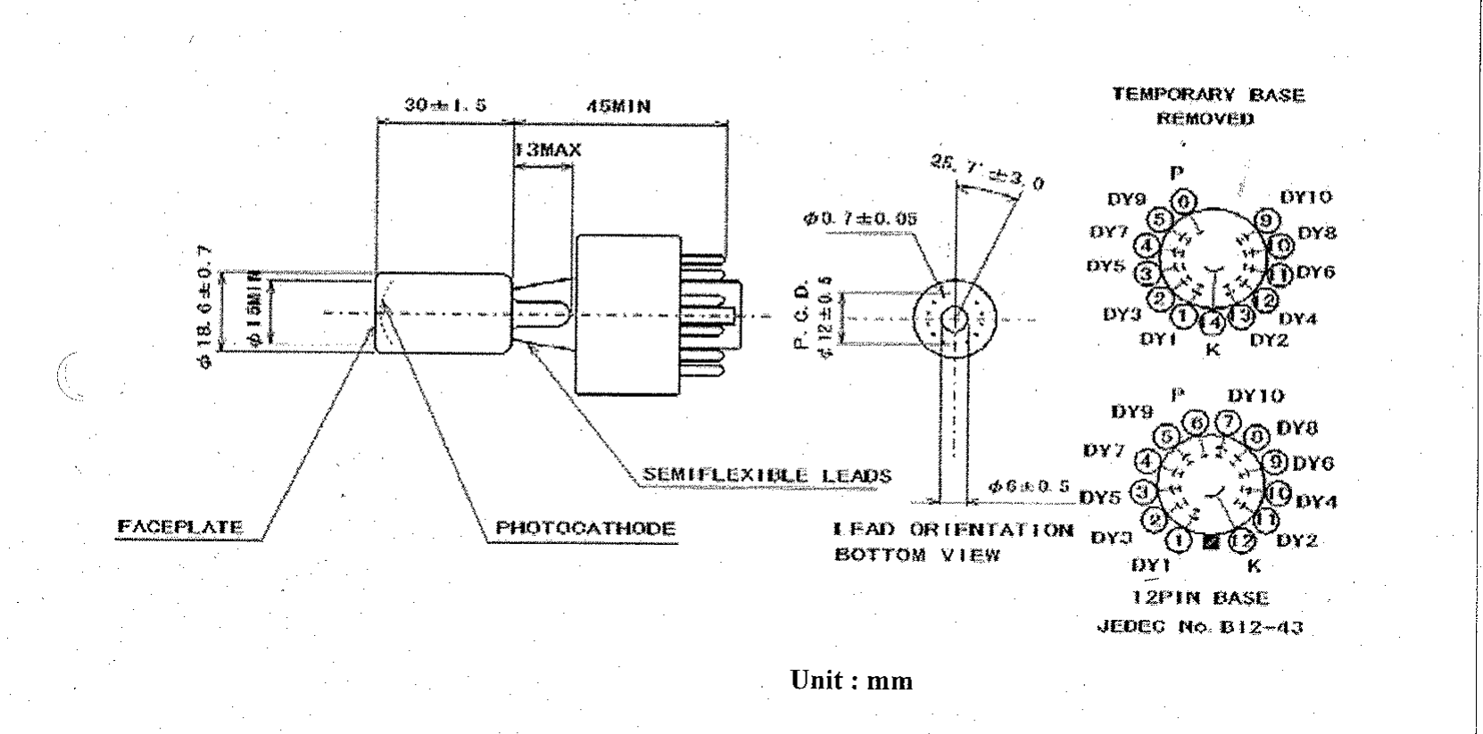
[picture p233: page 1]
