PorterMatt/CherenkovDetector/PICAP (Jim Connell)/PICAP drawings and BOM/Circuit Boards/Soildworks/circuit assembly 2.SLDASM

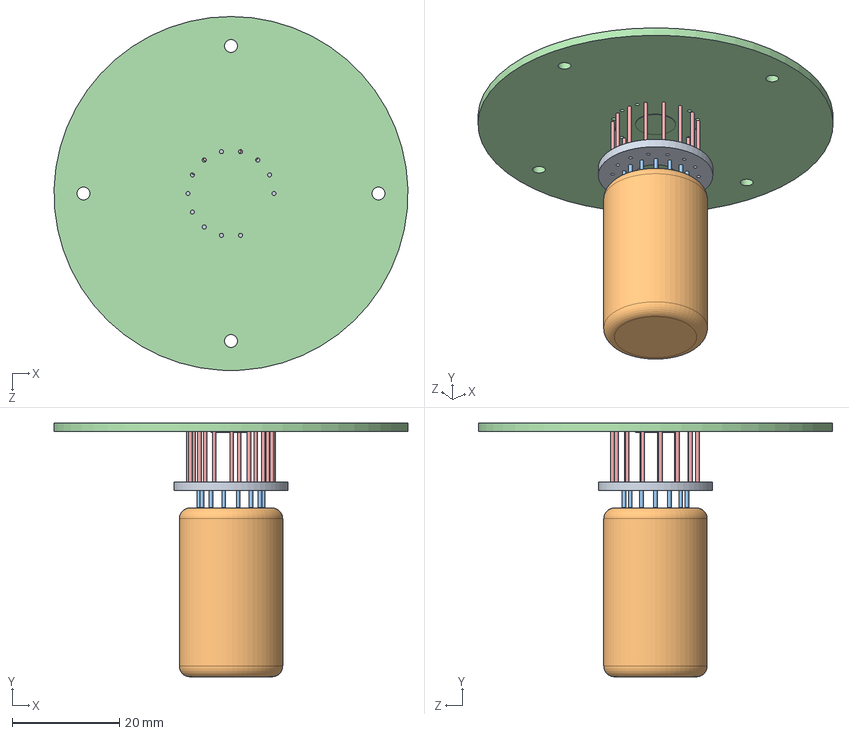
[picture p234: CAD file, 2021-06-03]
PICAP (Jim Connell)/PICAP drawings and BOM/Circuit Boards/Soildworks/circuit assembly 2.SLDASM
66.0 x 47.3 x 66.0 mm
side cir boards 2
PMT
PMT leads
side cir boards
leads.93
