PorterMatt/CherenkovDetector/PICAP (Jim Connell)/PICAP drawings and BOM/mushroom assembly/M-A03/side pmt mount full.SLDPRT

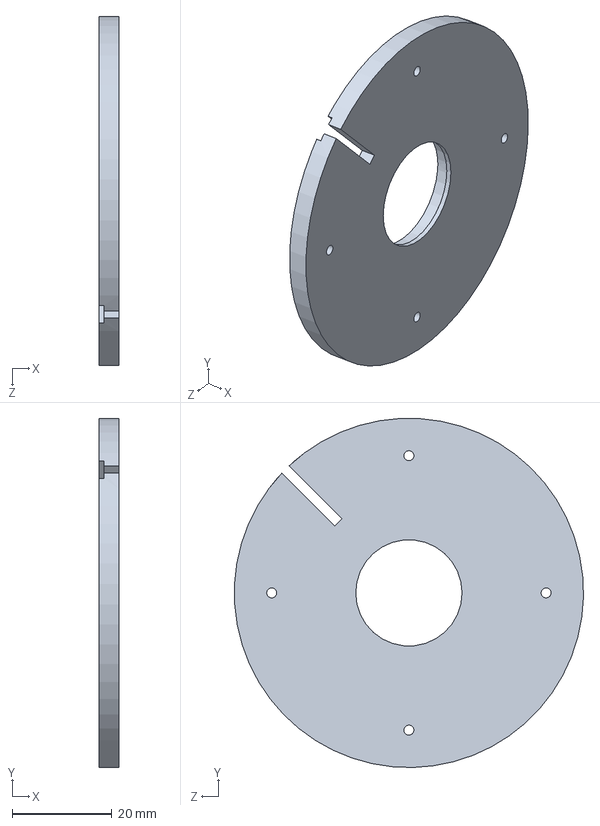
[picture p235: CAD file, 2021-06-03]
PICAP (Jim Connell)/PICAP drawings and BOM/mushroom assembly/M-A03/side pmt mount full.SLDPRT
4.00 x 69.9 x 69.9 mm
