PorterMatt/CherenkovDetector/PICAP (Jim Connell)/PICAP drawings and BOM/mushroom assembly/M-A04/side pmt tube full.SLDPRT

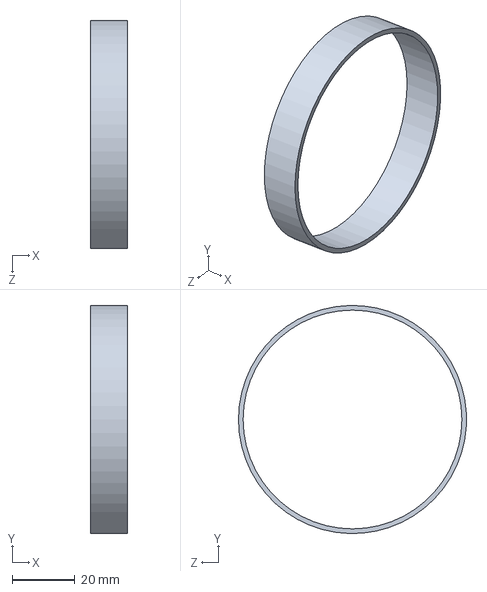
[picture p236: CAD file, 2021-06-03]
PICAP (Jim Connell)/PICAP drawings and BOM/mushroom assembly/M-A04/side pmt tube full.SLDPRT
12.0 x 73.0 x 73.0 mm
