PorterMatt/CherenkovDetector/PICAP (Jim Connell)/PICAP drawings and BOM/mushroom assembly/M-A05/side pmt cover full.SLDPRT

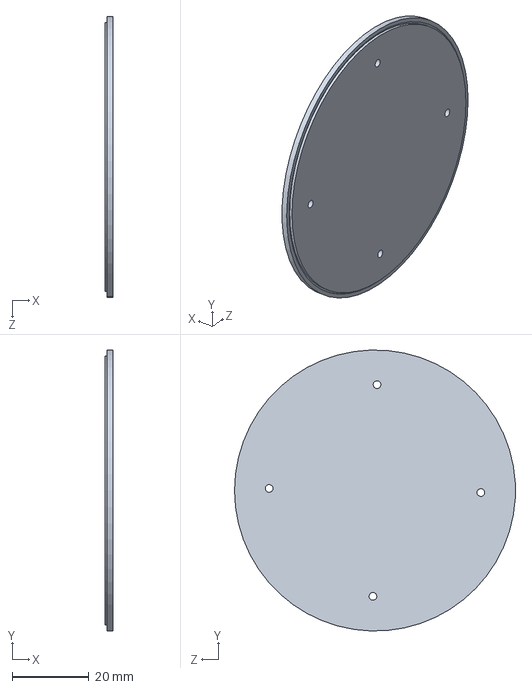
[picture p237: CAD file, 2021-06-03]
PICAP (Jim Connell)/PICAP drawings and BOM/mushroom assembly/M-A05/side pmt cover full.SLDPRT
2.00 x 73.0 x 73.0 mm
