PorterMatt/CherenkovDetector/PICAP (Jim Connell)/PICAP solidworks/D4Testholder.SLDASM

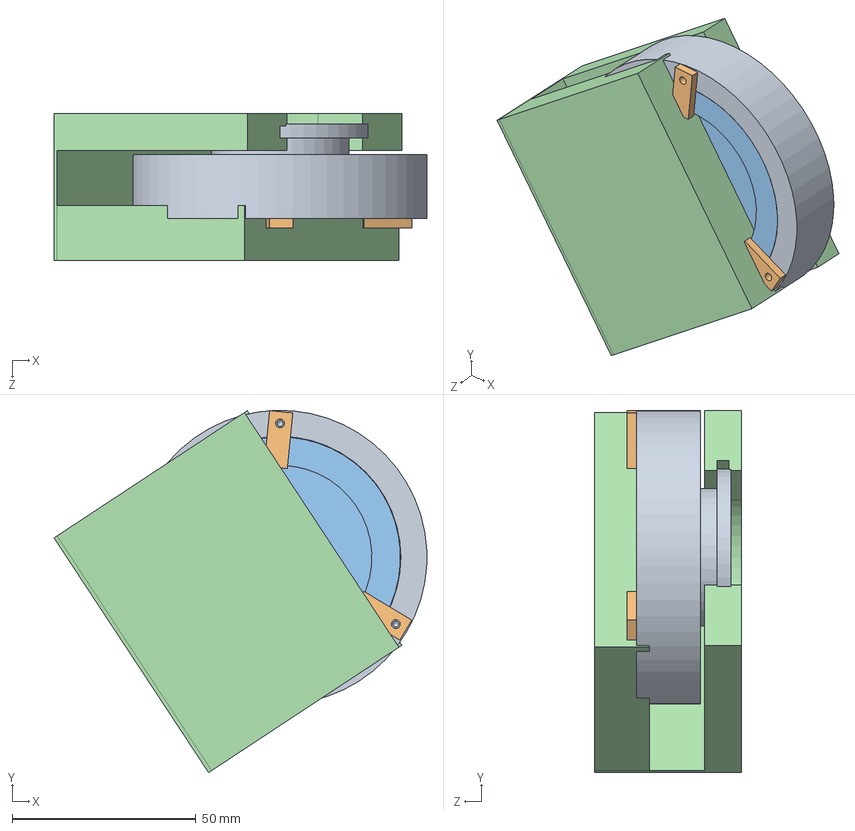
[picture p238: CAD file, 2021-06-07]
PICAP (Jim Connell)/PICAP solidworks/D4Testholder.SLDASM
101.5 x 98.6 x 40.0 mm
d4testholer
D4slider x 3
SS_D4
