PorterMatt/CherenkovDetector/PICAP (Jim Connell)/PICAP solidworks/Revised Mushroom assembly drawings/mushroom revised.SLDASM

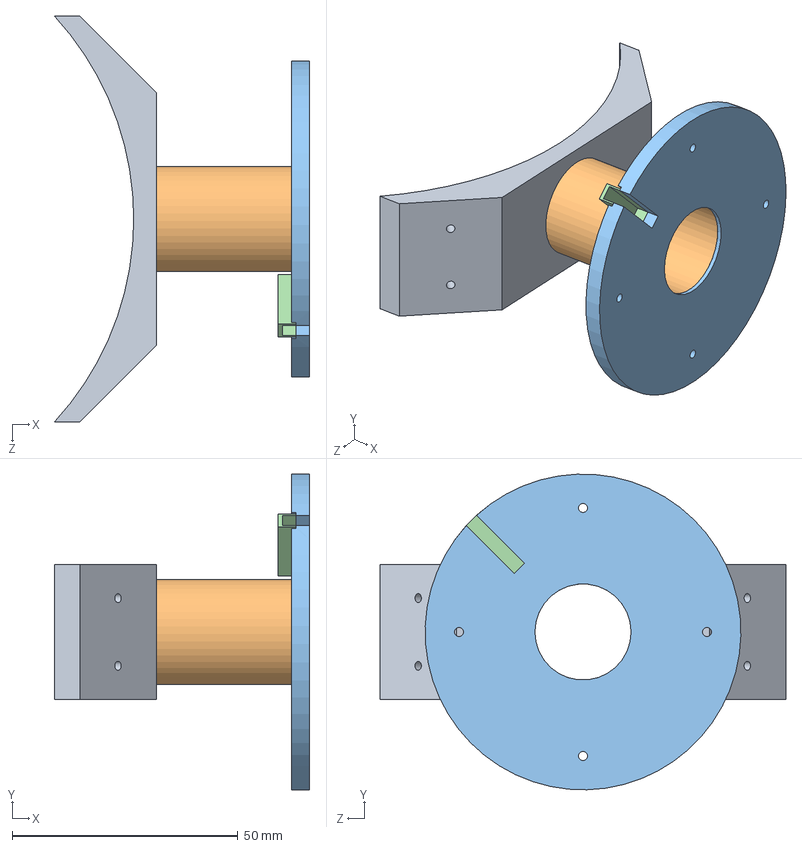
[picture p239: CAD file, 2021-06-03]
PICAP (Jim Connell)/PICAP solidworks/Revised Mushroom assembly drawings/mushroom revised.SLDASM
56.6 x 70.0 x 90.0 mm
plate revised
side pmt holder 1 revised
side pmt mount full revised
Wire guard revised
