PorterMatt/CherenkovDetector/Solidworks Assemblies/Telescope Assembly Parallel/Module_1_Plastic.SLDASM

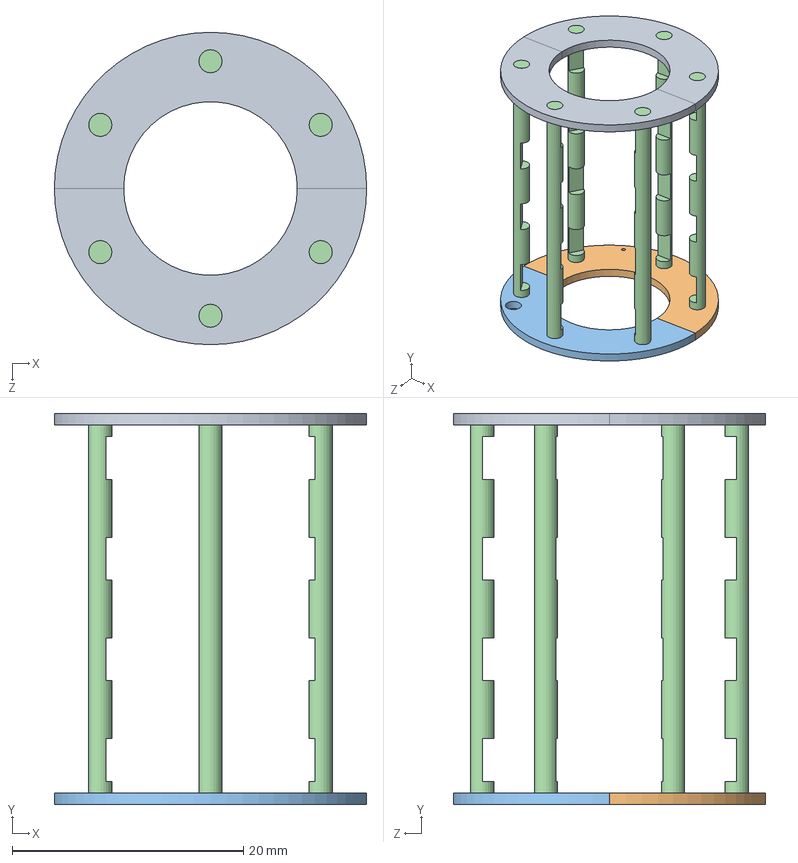
[picture p240: CAD file, 2021-05-11]
Solidworks Assemblies/Telescope Assembly Parallel/Module_1_Plastic.SLDASM
27.0 x 33.8 x 27.0 mm
Module_Plastic_Base_Empty x 2
Module_Plastic_Base_Nitrogen
Module_Plastic_Base_Wire
Module_1_Plastic_Stand x 6
