PorterMatt/CherenkovDetector/Solidworks Assemblies/Telescope Assembly Un-Parallel/Module_1_UnParallel.SLDASM

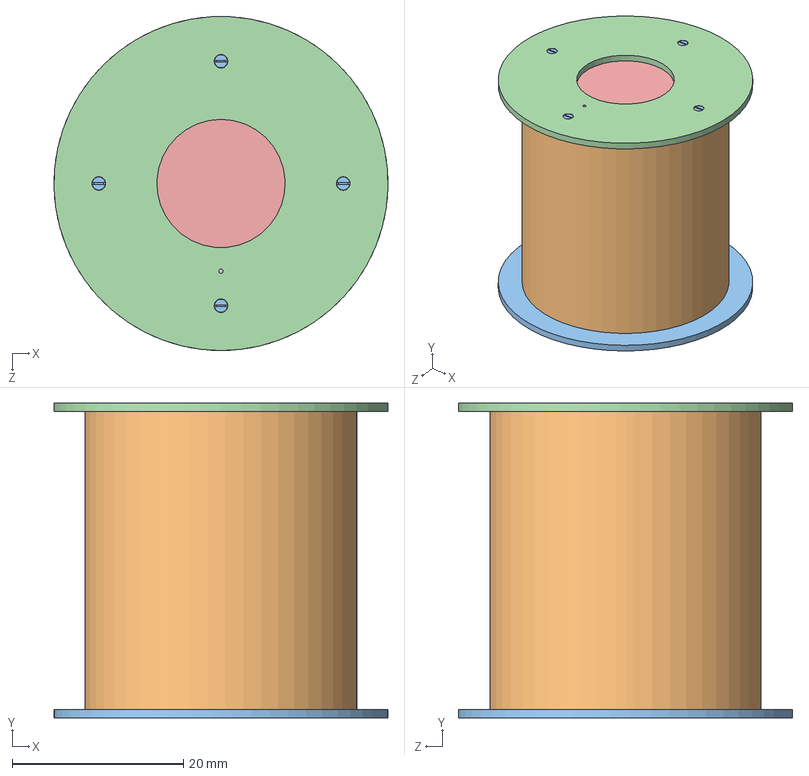
[picture p241: CAD file, 2020-10-16]
Solidworks Assemblies/Telescope Assembly Un-Parallel/Module_1_UnParallel.SLDASM
39.0 x 36.8 x 39.1 mm
Solid_State_Detector x 4
Module_1_Shell_UnParallel
Module_1_Lid_Bottom_UnParallel
Module_1_Lid_Top_UnParallel
Module_1_Brass_Holder_UnParallel
Module_1_Brass_UnParallel
Module_Plastic_Base_Nitrogen x 2
Module_Plastic_Base_Wire
Module_Plastic_Base_Empty
Module_1_Plastic_Stand x 6
91430A145_18-8 STAINLESS STEEL SLOTTED SCREWS x 8
