PorterMatt/CherenkovDetector/Solidworks Parts/SSD Parts/Assemblies/Lightbox1_Module_V3.SLDASM

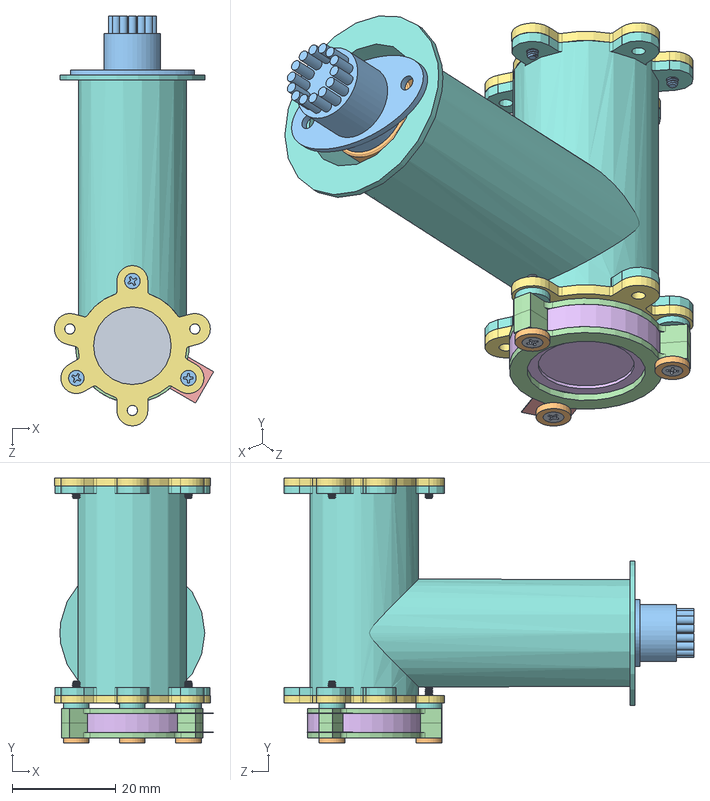
[picture p242: CAD file, 2022-01-09]
Solidworks Parts/SSD Parts/Assemblies/Lightbox1_Module_V3.SLDASM
30.8 x 51.2 x 79.2 mm
Lightbox_Foil x 2
PMT_R12421
PMT_Socket
SSD_Clasp_V3 x 2
SSD_Contact_Stack_V2 x 2
SSD_Model
Lightbox_Cap_V3 x 2
SSD_Washer x 3
Teflon_Lid_Top
Teflon_MainHousing_Top
Stack_of_Diamond
Teflon_Main Housing_V2
Delrin_Diamond_Mount
Teflon_Bottom_Flat
Delrin_Mount_Bottom x 2
Lightbox_MainHousing_V4
M1.6 12mm Countersunk Bolt x 3
Lightbox_Washer x 3
M1.6 4mm Countersunk Bolt x 3
