PorterMatt/CherenkovDetector/PICAP (Jim Connell)/PICAP drawings and BOM/Circuit Boards/Soildworks/circuit assembly.SLDASM

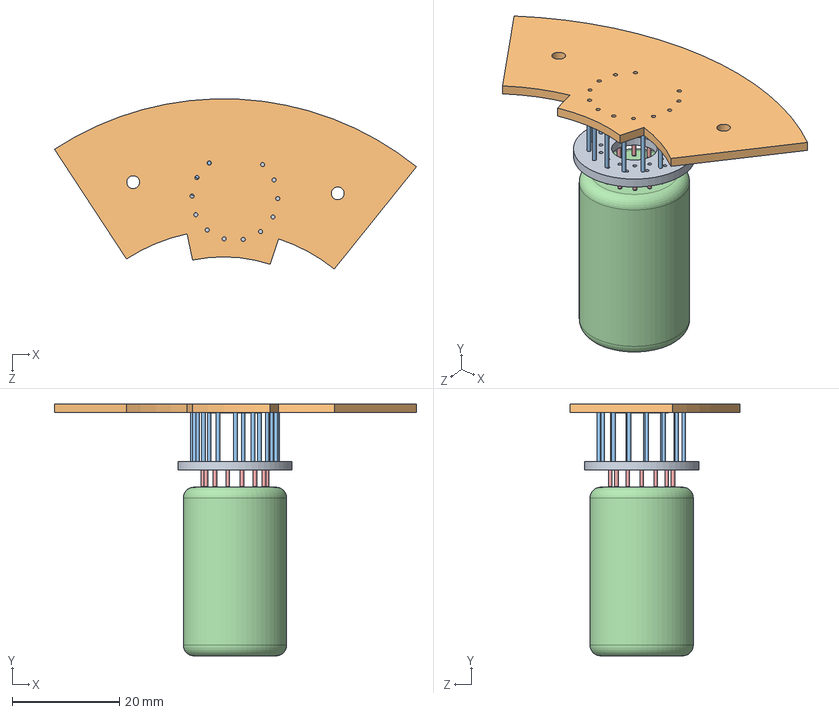
[picture p243: CAD file, 2021-06-03]
PICAP (Jim Connell)/PICAP drawings and BOM/Circuit Boards/Soildworks/circuit assembly.SLDASM
67.6 x 47.0 x 31.8 mm
side cir boards 2
Ciruitboar_new
boardleads.9
PMT
PMT leads
