PorterMatt/CherenkovDetector/Solidworks Assemblies/Telescope Assembly Parallel/Module_2_Plastic.SLDASM

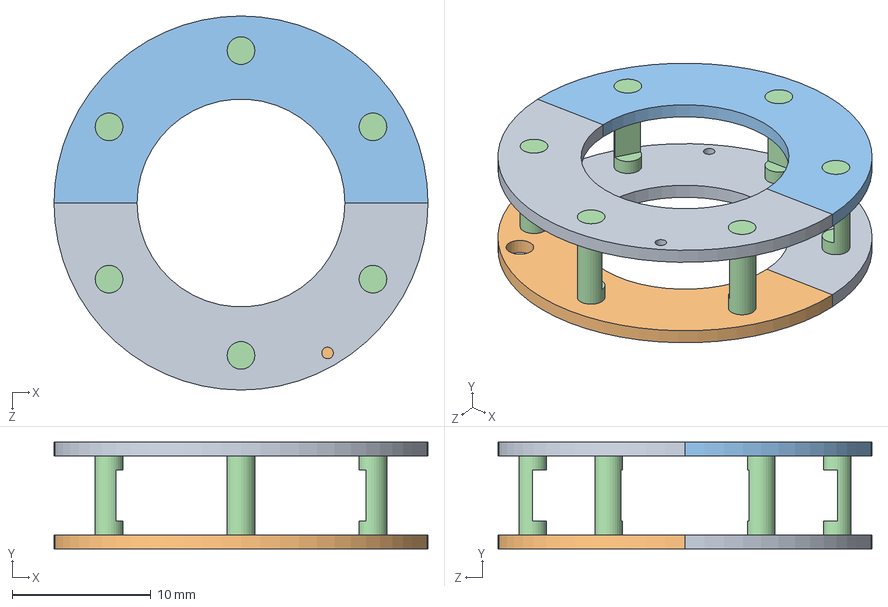
[picture p244: CAD file, 2021-05-11]
Solidworks Assemblies/Telescope Assembly Parallel/Module_2_Plastic.SLDASM
27.0 x 7.70 x 27.0 mm
Module_Plastic_Base_Nitrogen x 2
Module_Plastic_Base_Wire
Module_Plastic_Base_Empty
Module_2_Plastic_Stand x 6
