PorterMatt/CherenkovDetector/Solidworks Assemblies/Telescope Assembly Un-Parallel/Module_2_UnParallel.SLDASM

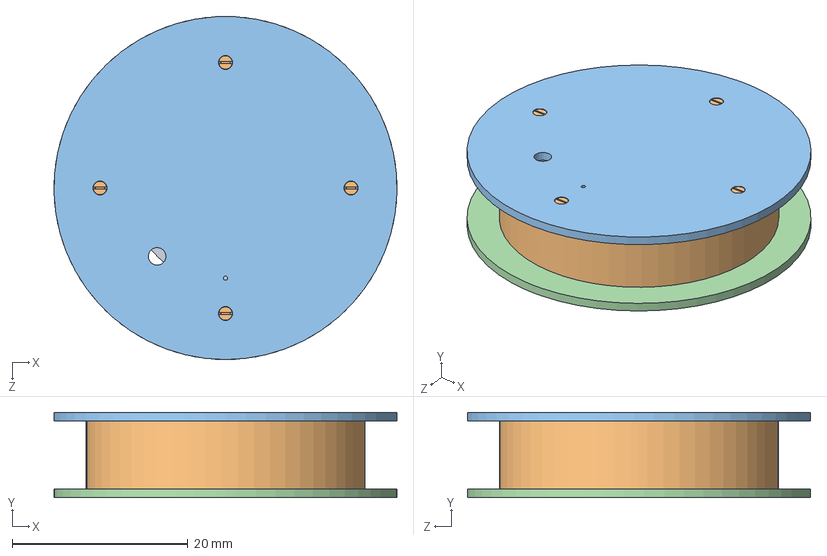
[picture p245: CAD file, 2020-10-16]
Solidworks Assemblies/Telescope Assembly Un-Parallel/Module_2_UnParallel.SLDASM
39.0 x 9.70 x 39.1 mm
Solid_State_Detector
Module_2_Shell_UnParallel
Module_2_Lid_Top_UnParallel
Module_2_Lid_Bottom_UnParallel
Module_Plastic_Base_Nitrogen
Module_Plastic_Base_Nitrogen_and_Wire
Module_Plastic_Base_Wire
Module_Plastic_Base_Empty
Module_2_Plastic_Stand x 6
91430A145_18-8 STAINLESS STEEL SLOTTED SCREWS x 8
