PorterMatt/CherenkovDetector/Solidworks Parts/SSD Parts/Parts/Lightbox_MainHousing_V4.SLDPRT

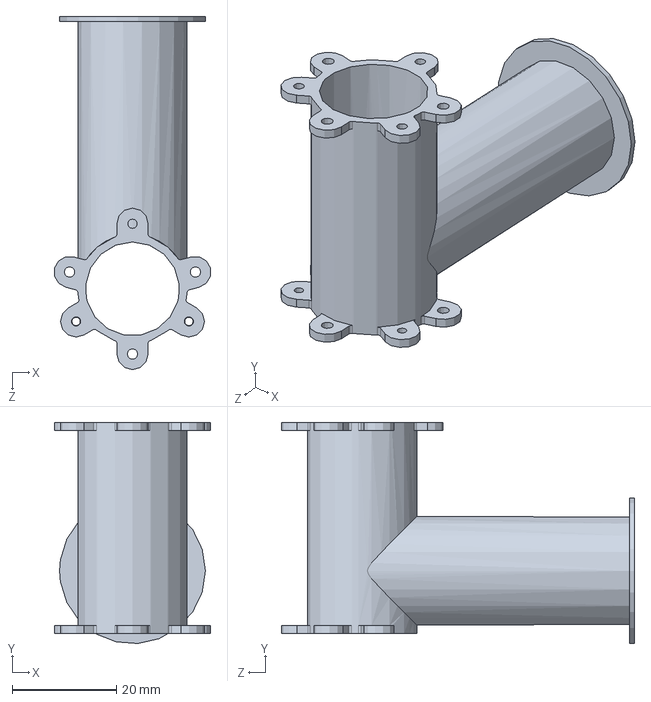
[picture p246: CAD file, 2022-01-09]
Solidworks Parts/SSD Parts/Parts/Lightbox_MainHousing_V4.SLDPRT
29.9 x 42.4 x 67.8 mm
