PorterMatt/CherenkovDetector/Solidworks Assemblies/Telescope Assembly Parallel/Telescope_Assembly_Parallel.SLDASM

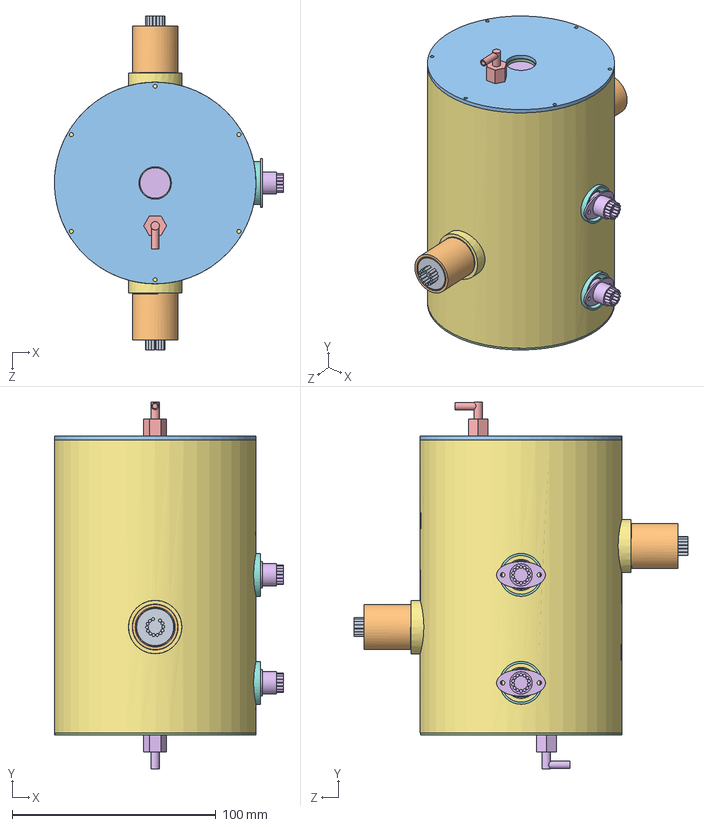
[picture p247: CAD file, 2021-05-11]
Solidworks Assemblies/Telescope Assembly Parallel/Telescope_Assembly_Parallel.SLDASM
112.6 x 180.1 x 164.0 mm
Solid_State_Detector x 6
Module_1_Shell
Module_1_Lid_Bottom
Module_1_Lid_Top
Module_1_Brass_Holder
Module_1_Brass
Module_Plastic_Base_Empty x 4
Module_Plastic_Base_Nitrogen x 5
Module_Plastic_Base_Wire x 3
Module_1_Plastic_Stand x 6
92095A321_BUTTON HEAD HEX DRIVE SCREW x 24
Teflon_Main Housing_Combined x 2
PMT_R12421 x 2
PMT_Socket x 2
Lightbox_Main_Housing_Telescope_CombinedSSD x 2
PMT_R12421_Frame_Telescope x 2
Stack_of_Diamond x 2
Teflon_Lid_Top x 2
Teflon_Lid_Bottom_Flat_Combined x 2
Teflon_MainHousing_Top x 2
socket head cap screw_am x 8
Teflon_Main Housing_Combined_Bottom x 2
Module_2_Plastic_Stand x 12
Module_2_Lid_Bottom_Combined x 2
Module_2_Lid_Top_Combined x 2
Teflon_Anti_Inner_Sleeve
Teflon_Anti_PMT x 2
Teflon_Anti_Outer_Sleeve
Anticoincidence_Plastic
Teflon_Anti_Lid_Top
Telescope_Outer_Shell
Teflon_Anti_PMT_Gap_Fill x 2
PMT_R5610A x 2
PMT_R5610A_Frame x 2
Telescope_Outer_Lid_Top
Telescope_Outer_Lid_Bottom
Vent_Top
Vent_Bottom
Metal_Columns x 3
Teflon_Anti_Lid_Bottom
