PorterMatt/CherenkovDetector/Solidworks Assemblies/Telescope Assembly Un-Parallel/Module_3_UnParallel.SLDASM

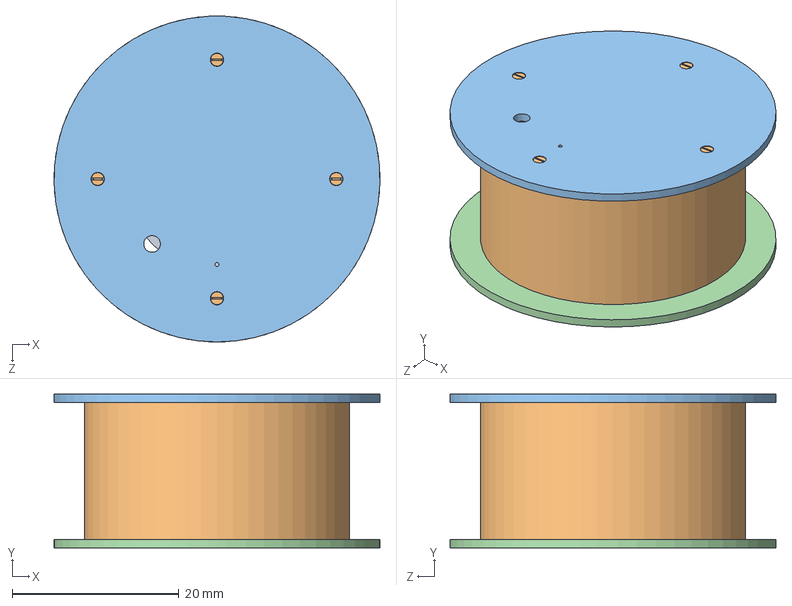
[picture p248: CAD file, 2020-10-16]
Solidworks Assemblies/Telescope Assembly Un-Parallel/Module_3_UnParallel.SLDASM
39.0 x 18.4 x 39.1 mm
Solid_State_Detector x 2
Module_3_Shell_UnParallel
Module_3_Lid_Top_UnParallel
Module_3_Lid_Bottom_UnParallel
Module_Plastic_Base_Nitrogen
Module_Plastic_Base_Nitrogen_and_Wire
Module_Plastic_Base_Wire
Module_Plastic_Base_Empty
Module_3_Plastic_Stand x 6
91430A145_18-8 STAINLESS STEEL SLOTTED SCREWS x 8
