PorterMatt/CherenkovDetector/Solidworks Parts/SSD Parts/Assemblies/SSD_Module_V3.SLDASM

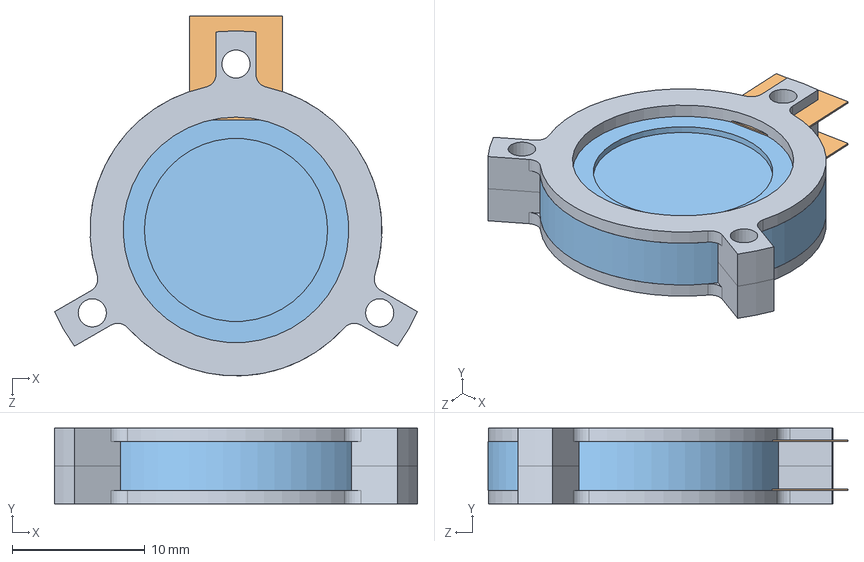
[picture p249: CAD file, 2022-01-09]
Solidworks Parts/SSD Parts/Assemblies/SSD_Module_V3.SLDASM
27.4 x 5.70 x 27.1 mm
SSD_Clasp_V3 x 2
SSD_Contact_Stack_V2 x 2
SSD_Model
