PorterMatt/CherenkovDetector/PICAP (Jim Connell)/PICAP drawings and BOM/Circuit Boards/Soildworks/circuit assembly 3.SLDASM

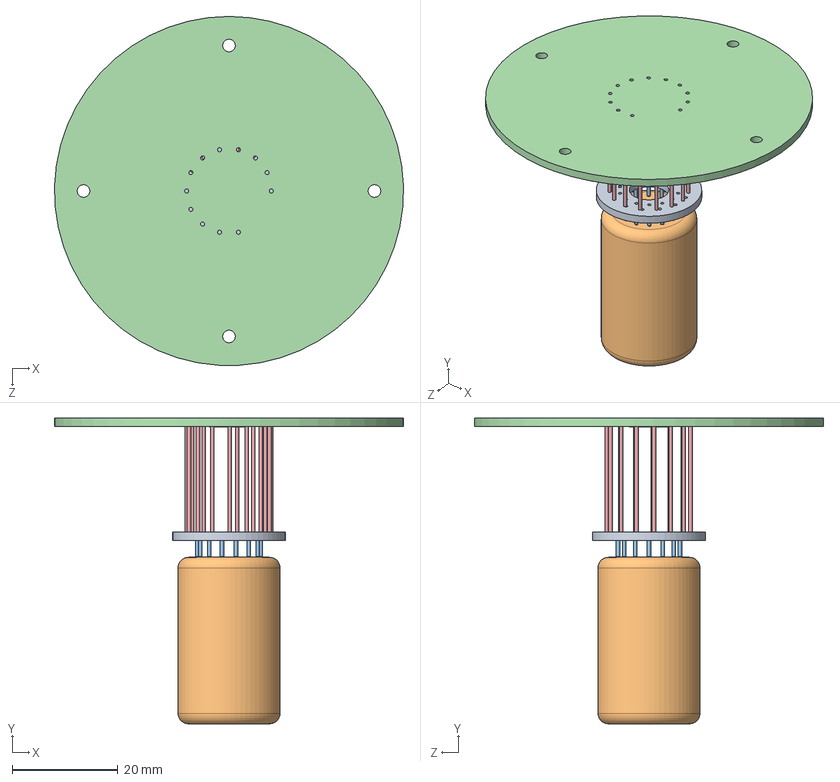
[picture p250: CAD file, 2021-06-03]
PICAP (Jim Connell)/PICAP drawings and BOM/Circuit Boards/Soildworks/circuit assembly 3.SLDASM
66.0 x 57.8 x 66.0 mm
side cir boards 2
PMT
PMT leads
side cir boards
leads.98
