PorterMatt/CherenkovDetector/PICAP (Jim Connell)/PICAP drawings and BOM/EOS drawings/Column assembly.SLDASM

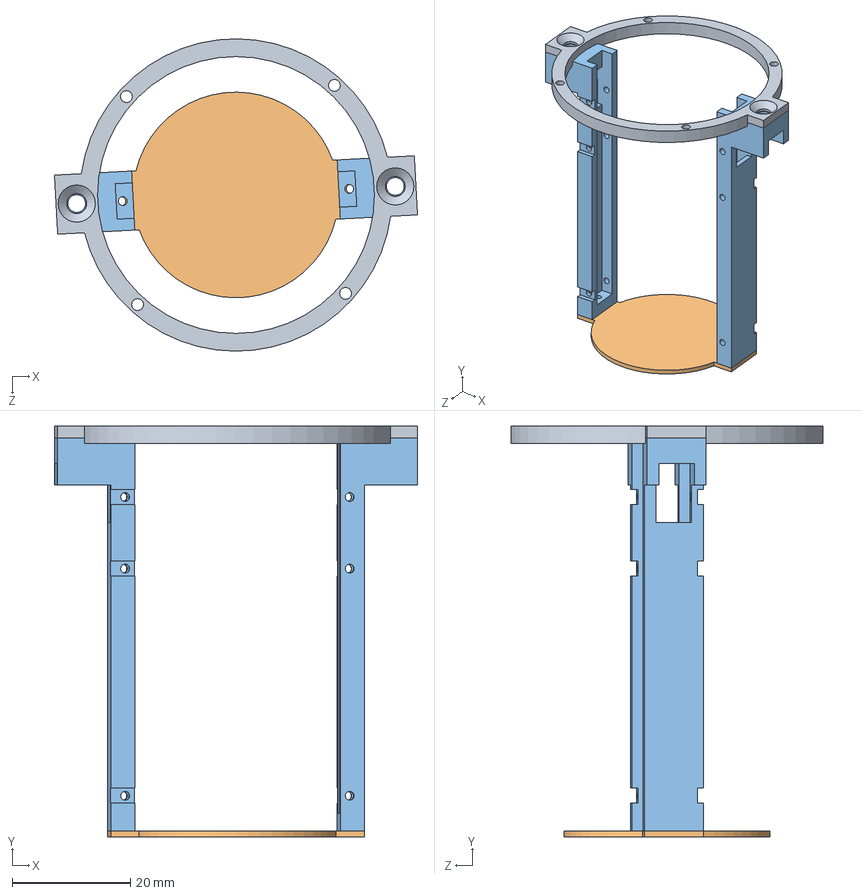
[picture p251: CAD file, 2021-06-03]
PICAP (Jim Connell)/PICAP drawings and BOM/EOS drawings/Column assembly.SLDASM
61.4 x 69.5 x 52.8 mm
cover ring 2
Columnbase
columnsTest x 2
