PorterMatt/CherenkovDetector/Solidworks Assemblies/Teflon_MainHousing_Top.SLDPRT

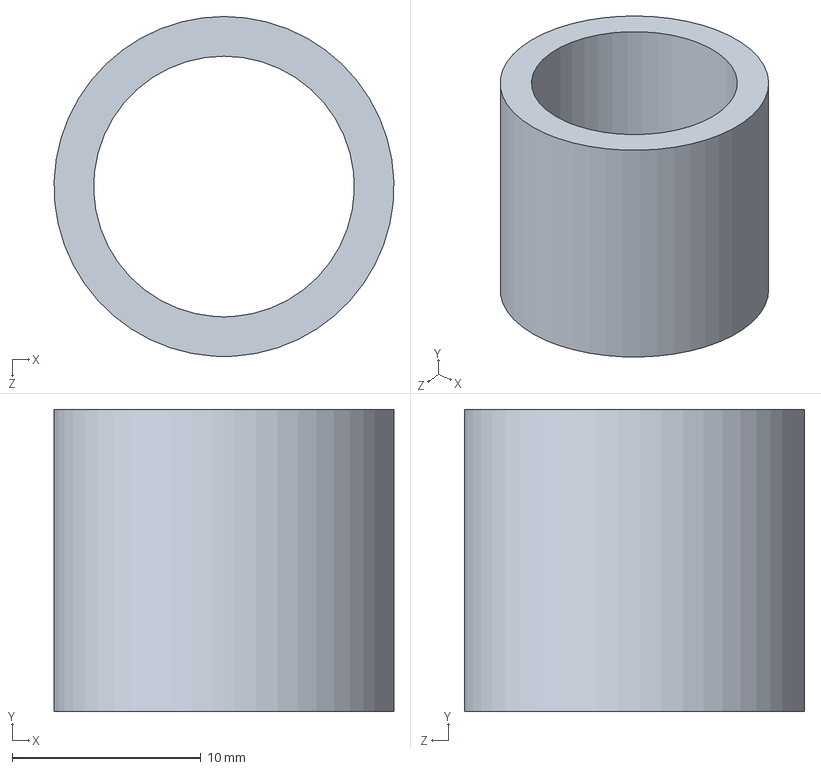
[picture p252: CAD file, 2021-11-19]
Solidworks Assemblies/Teflon_MainHousing_Top.SLDPRT
18.0 x 16.0 x 18.0 mm
