PorterMatt/CherenkovDetector/Solidworks Assemblies/Telescope Assembly Parallel/Module_1.SLDASM

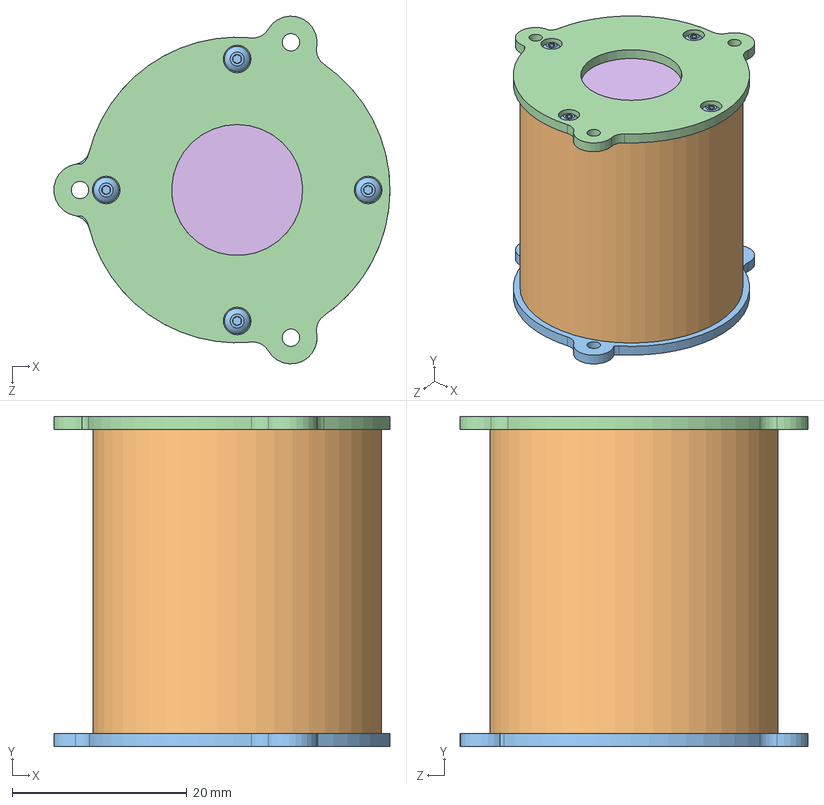
[picture p253: CAD file, 2021-05-11]
Solidworks Assemblies/Telescope Assembly Parallel/Module_1.SLDASM
38.5 x 37.8 x 39.8 mm
Solid_State_Detector x 4
Module_1_Shell
Module_1_Lid_Bottom
Module_1_Lid_Top
Module_1_Brass_Holder
Module_1_Brass
Module_Plastic_Base_Empty x 2
Module_Plastic_Base_Nitrogen
Module_Plastic_Base_Wire
Module_1_Plastic_Stand x 6
92095A321_BUTTON HEAD HEX DRIVE SCREW x 8
