PorterMatt/CherenkovDetector/Solidworks Assemblies/Telescope Assembly Un-Parallel/Telescope_w_Base - Copy.SLDASM

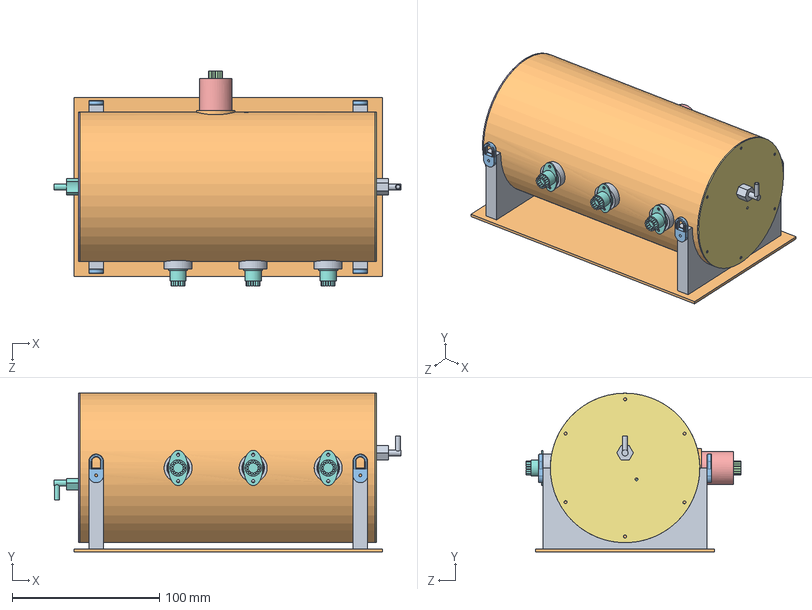
[picture p254: CAD file, 2020-10-16]
Solidworks Assemblies/Telescope Assembly Un-Parallel/Telescope_w_Base - Copy.SLDASM
235.8 x 107.8 x 146.0 mm
Telescope_Base_UnParallel x 2
Solid_State_Detector x 8
Module_1_Shell
Module_1_Lid_Bottom
Module_1_Lid_Top
Module_1_Brass_Holder
Module_1_Brass
Module_Plastic_Base_Nitrogen x 5
Module_Plastic_Base_Wire x 4
Module_Plastic_Base_Empty x 4
Module_1_Plastic_Stand x 6
91430A145_18-8 STAINLESS STEEL SLOTTED SCREWS x 32
Lightbox_Main_Housing x 3
Teflon_PMT_Gap_Fill x 3
PMT_R12421 x 3
PMT_Socket x 3
PMT_R12421_Frame x 3
Teflon_Main Housing x 3
Stack_of_Diamond x 3
Teflon_Lid_Top x 3
Lightbox_Lid_Top x 3
Lightbox_Lid_Bottom x 3
Teflon_Reflector_45 x 3
Teflon_Lid_Bottom x 3
Lightbox_Main_Housing_Insert x 3
Lightbox_Teflon_Support x 3
Module_2_Shell x 2
Module_2_Lid_Top x 2
Module_2_Lid_Bottom x 2
Module_Plastic_Base_Nitrogen_and_Wire x 3
Module_2_Plastic_Stand x 12
Module_3_Shell
Module_3_Lid_Top
Module_3_Lid_Bottom
Module_3_Plastic_Stand x 6
Teflon_Anti_Inner_Sleeve
Teflon_Anti_PMT x 3
Teflon_Anti_Outer_Sleeve
Anticoincidence_Plastic
Teflon_Anti_Lid_Bottom
Teflon_Anti_Lid_Top
Telescope_Outer_Shell
Teflon_Anti_PMT_Gap_Fill
PMT_R5610A
PMT_R5610A_Frame
Telescope_Outer_Lid_Top
Telescope_Outer_Lid_Bottom
Vent_Top
Vent_Bottom
Base_Bottom_UnParallel
Base_Clip_UnParallel x 4
