PorterMatt/CherenkovDetector/Solidworks Parts/SSD Parts/Assemblies/SSD_Stack_Full_V5.SLDASM

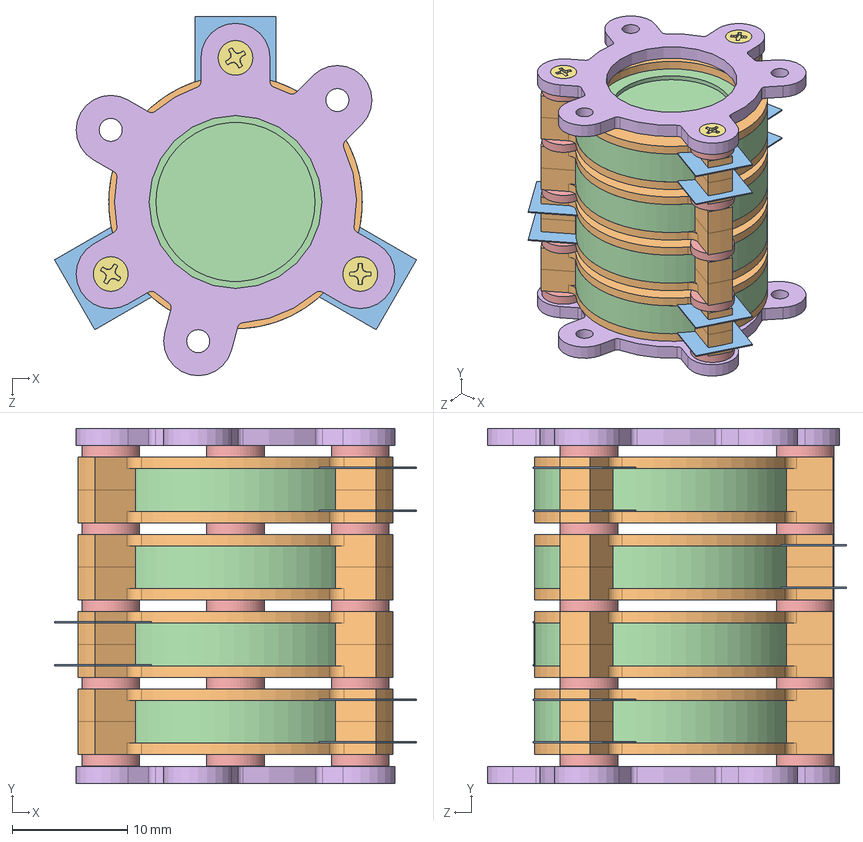
[picture p255: CAD file, 2022-01-09]
Solidworks Parts/SSD Parts/Assemblies/SSD_Stack_Full_V5.SLDASM
31.4 x 30.8 x 31.2 mm
SSD_Tension_Rod x 3
SSD_Clasp_V3 x 8
SSD_Contact_Stack_V2 x 8
SSD_Model x 4
SSD_Washer x 15
Lightbox_Cap_V3 x 2
M1.6 4mm Countersunk Bolt x 6
