PorterMatt/CherenkovDetector/Solidworks Assemblies/PMT_Assembly_wSocket.SLDASM

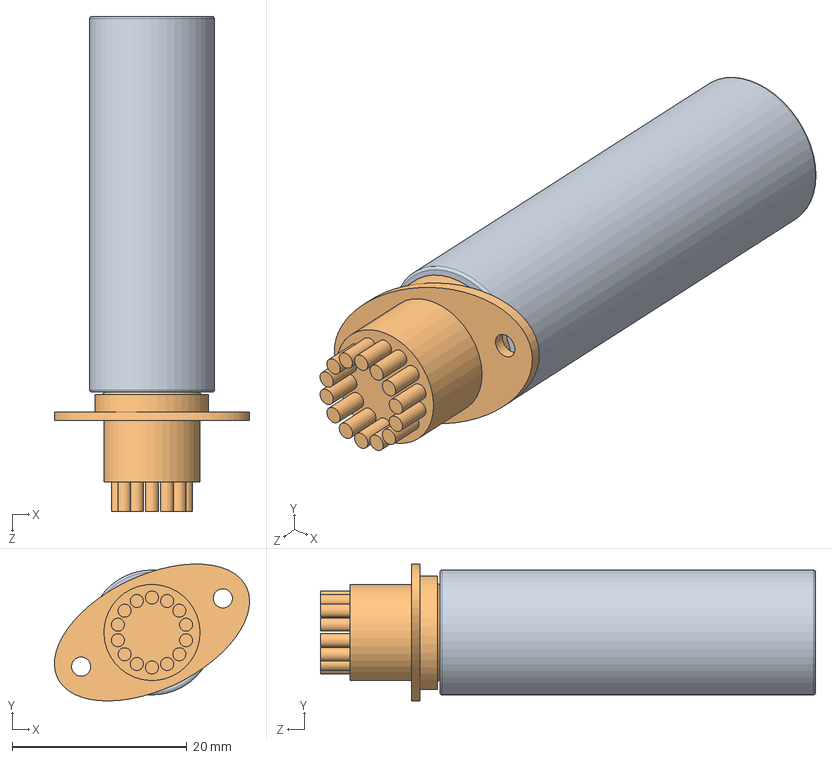
[picture p256: CAD file, 2021-10-08]
Solidworks Assemblies/PMT_Assembly_wSocket.SLDASM
22.3 x 15.7 x 56.7 mm
PMT_R12421
PMT_Socket
