PorterMatt/CherenkovDetector/Solidworks Assemblies/Telescope Assembly Parallel/Module_2.SLDASM

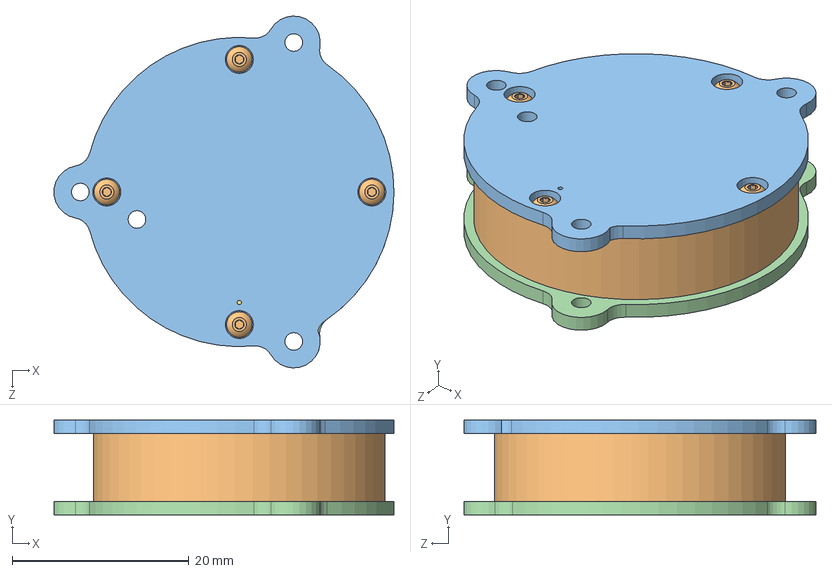
[picture p257: CAD file, 2021-04-13]
Solidworks Assemblies/Telescope Assembly Parallel/Module_2.SLDASM
38.5 x 10.7 x 39.8 mm
Solid_State_Detector
Module_2_Shell
Module_2_Lid_Top
Module_2_Lid_Bottom
Module_Plastic_Base_Nitrogen
Module_Plastic_Base_Nitrogen_and_Wire
Module_Plastic_Base_Wire
Module_Plastic_Base_Empty
Module_2_Plastic_Stand x 6
92095A321_BUTTON HEAD HEX DRIVE SCREW x 8
