PorterMatt/CherenkovDetector/Solidworks Assemblies/Telescope Assembly Un-Parallel/PMT_Assembly_Anti - Copy.SLDASM

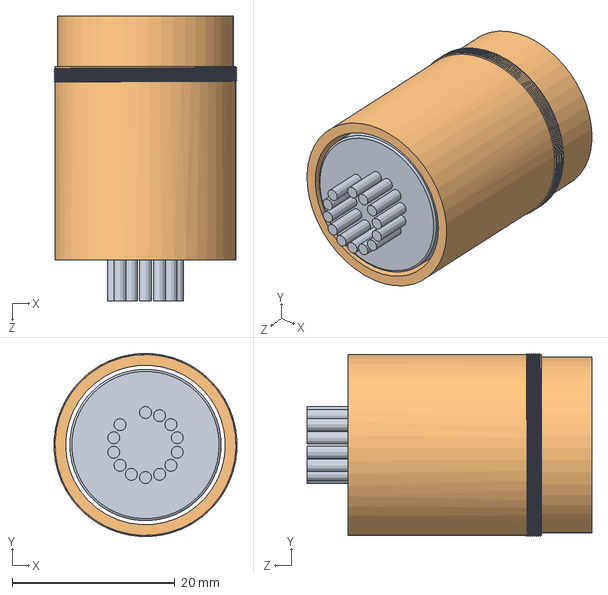
[picture p258: CAD file, 2020-10-07]
Solidworks Assemblies/Telescope Assembly Un-Parallel/PMT_Assembly_Anti - Copy.SLDASM
22.5 x 22.5 x 35.0 mm
PMT_R5610A
PMT_R5610A_Frame
