PorterMatt/CherenkovDetector/Solidworks Assemblies/Teflon_Main Housing.SLDPRT

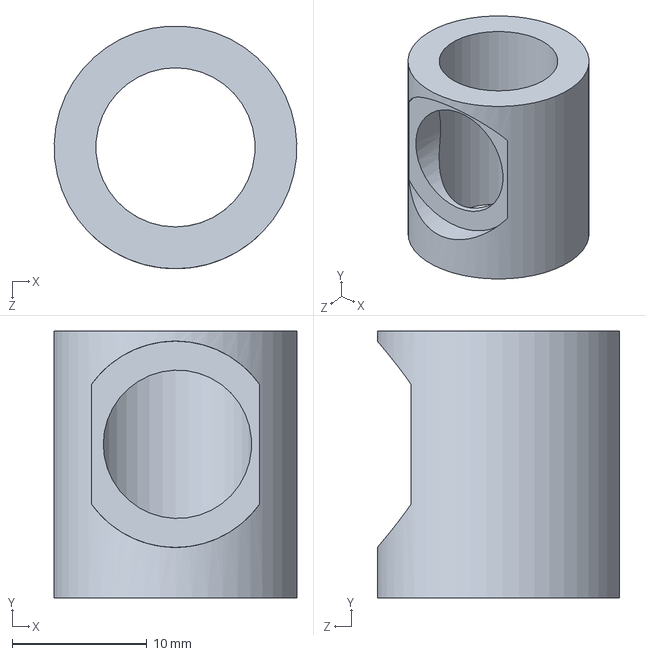
[picture p259: CAD file, 2021-10-08]
Solidworks Assemblies/Teflon_Main Housing.SLDPRT
18.0 x 19.8 x 18.0 mm
