PorterMatt/CherenkovDetector/Solidworks Assemblies/Telescope Assembly Parallel/Module_3.SLDASM

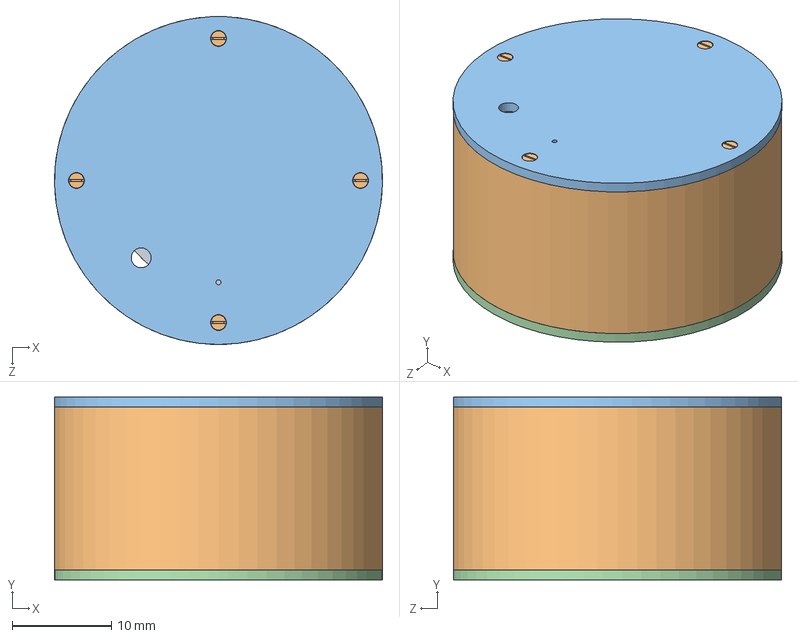
[picture p260: CAD file, 2021-03-24]
Solidworks Assemblies/Telescope Assembly Parallel/Module_3.SLDASM
33.0 x 18.4 x 33.0 mm
Solid_State_Detector x 2
Module_3_Shell
Module_3_Lid_Top
Module_3_Lid_Bottom
Module_Plastic_Base_Nitrogen
Module_Plastic_Base_Nitrogen_and_Wire
Module_Plastic_Base_Wire
Module_Plastic_Base_Empty
Module_3_Plastic_Stand x 6
91430A145_18-8 STAINLESS STEEL SLOTTED SCREWS x 8
