PorterMatt/CherenkovDetector/Solidworks Assemblies/Telescope Assembly Un-Parallel/Module_3_Plastic_UnParallel.SLDASM

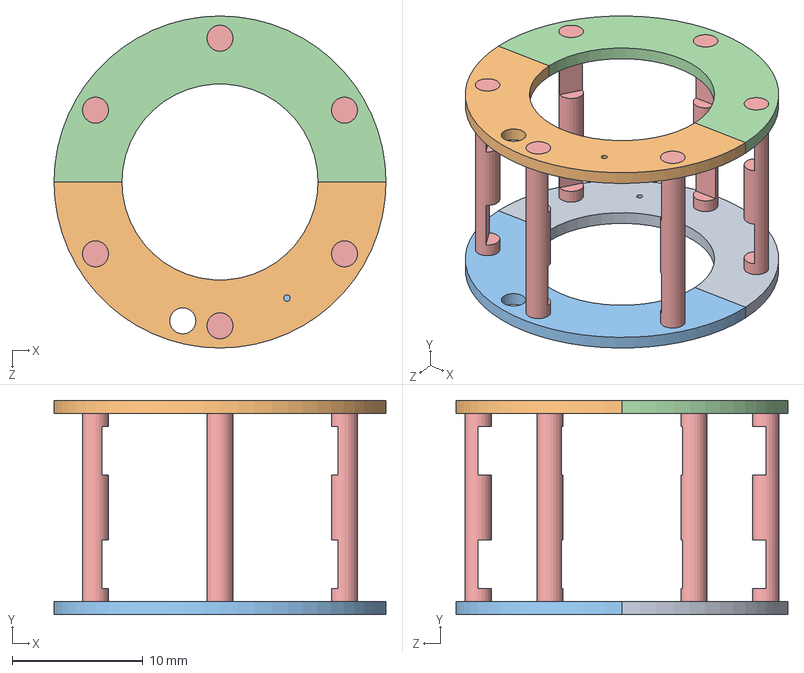
[picture p261: CAD file, 2020-10-07]
Solidworks Assemblies/Telescope Assembly Un-Parallel/Module_3_Plastic_UnParallel.SLDASM
25.4 x 16.4 x 25.4 mm
Module_Plastic_Base_Nitrogen
Module_Plastic_Base_Nitrogen_and_Wire
Module_Plastic_Base_Wire
Module_Plastic_Base_Empty
Module_3_Plastic_Stand x 6
