PorterMatt/CherenkovDetector/Solidworks Parts/SSD Parts/Assemblies/Telescope_Full_Assembly_V1.SLDASM

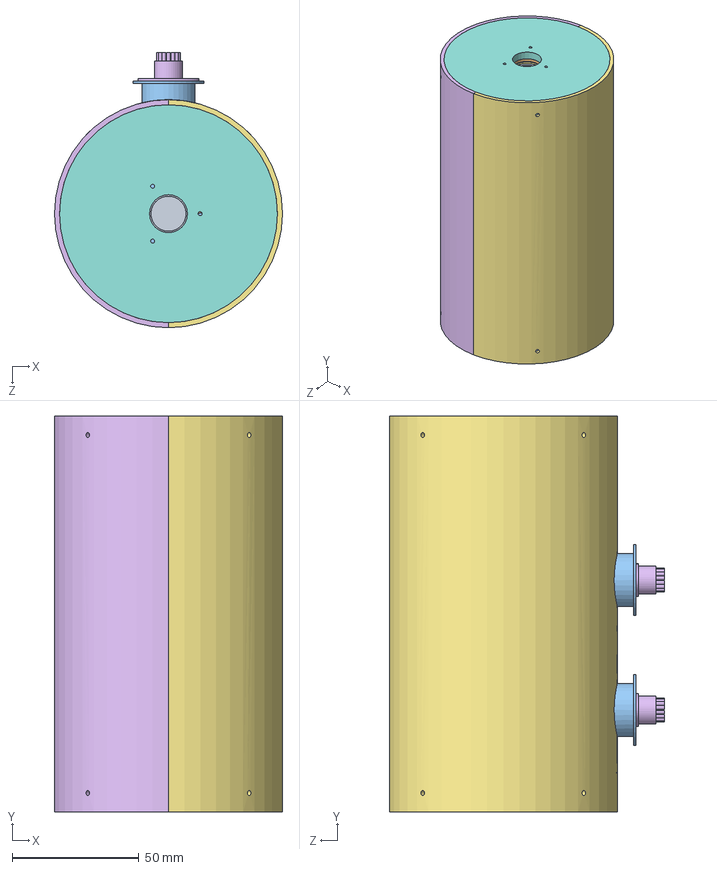
[picture p262: CAD file, 2022-01-09]
Solidworks Parts/SSD Parts/Assemblies/Telescope_Full_Assembly_V1.SLDASM
90.0 x 156.3 x 108.7 mm
Telescope Bottom Clasp
Telescope_Tension_Rod x 3
SSD_Standoff_V1
Lightbox_Foil x 4
PMT_R12421 x 2
PMT_Socket x 2
SSD_Clasp_V3 x 12
SSD_Contact_Stack_V2 x 12
SSD_Model x 6
Lightbox_Cap_V3 x 6
SSD_Washer x 21
Teflon_Lid_Top x 2
Teflon_MainHousing_Top x 2
Stack_of_Diamond x 2
Teflon_Main Housing_V2 x 2
Delrin_Diamond_Mount x 2
Teflon_Bottom_Flat x 2
Delrin_Mount_Bottom x 4
Lightbox_MainHousing_V4 x 2
M1.6 12mm Countersunk Bolt x 6
Lightbox_Washer x 6
M1.6 4mm Countersunk Bolt x 12
SSD_Tension_Rod x 3
Teflon_Telescope_Base
Teflon_BottomOuter
Teflon_MidOuter
Teflon_TopOuter
Teflon_Telescope_Top
Teflon_BottomInner
Aluminum_RightOuterShell
Aluminum_LeftOuterShell
Telescope_Top_Clasp
Scintillator_Base
Scintillator_BottomInner
Teflon_MidInner
Teflon_TopInner
Scintillator_TopInner
Scintillator_MidInner
