PorterMatt/CherenkovDetector/PICAP (Jim Connell)/PICAP solidworks/columnsTest1.SLDPRT.SLDASM

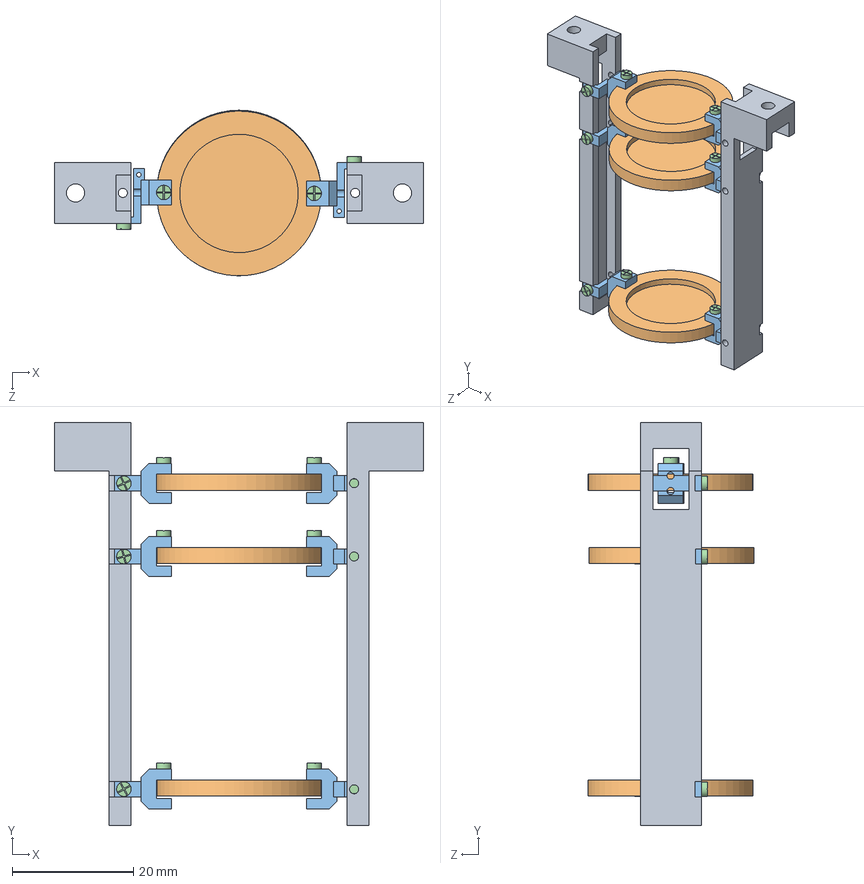
[picture p263: CAD file, 2021-06-03]
PICAP (Jim Connell)/PICAP solidworks/columnsTest1.SLDPRT.SLDASM
60.9 x 66.5 x 27.3 mm
columnsTest x 2
Active area test x 3
clip x 6
clipscrews x 12
