PorterMatt/CherenkovDetector/Solidworks Assemblies/Lightbox_1_Assembly_Flat.SLDASM

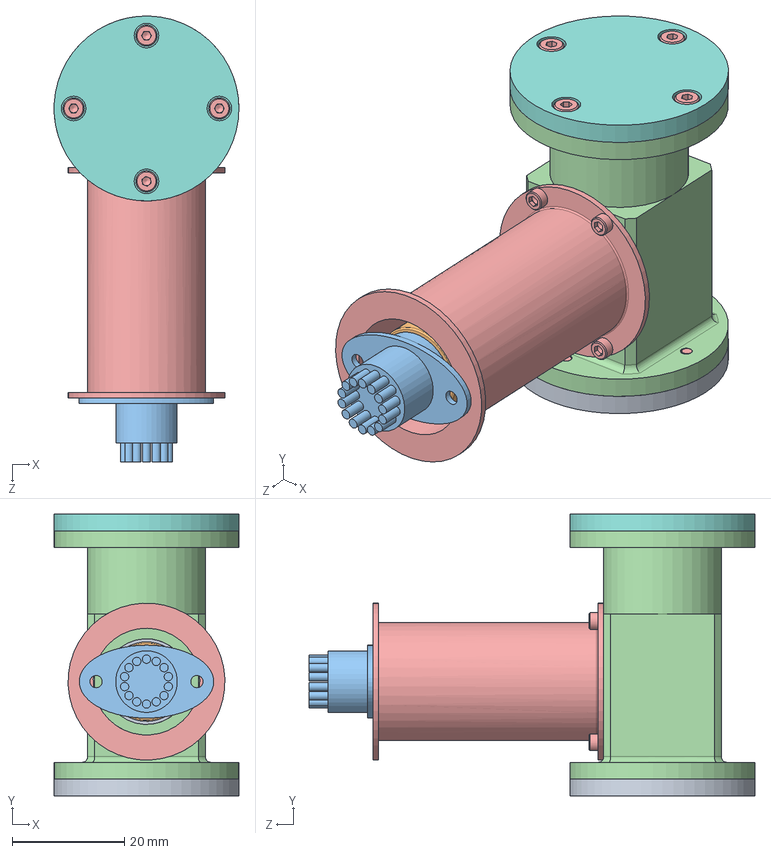
[picture p264: CAD file, 2021-10-08]
Solidworks Assemblies/Lightbox_1_Assembly_Flat.SLDASM
33.0 x 50.3 x 79.6 mm
Teflon_Main Housing
PMT_R12421
PMT_Socket
Lightbox_Main_Housing
Transparent_Plastic_Source_2
Teflon_Lid_Top
Lightbox_Lid
Lightbox_Lid_Bottom
Teflon_Lid_Bottom
Source_2
Teflon_MainHousing_Top
socket head cap screw_am x 12
