PorterMatt/CherenkovDetector/Solidworks Assemblies/Telescope Assembly Un-Parallel/Module_1_Plastic_UnParallel.SLDASM

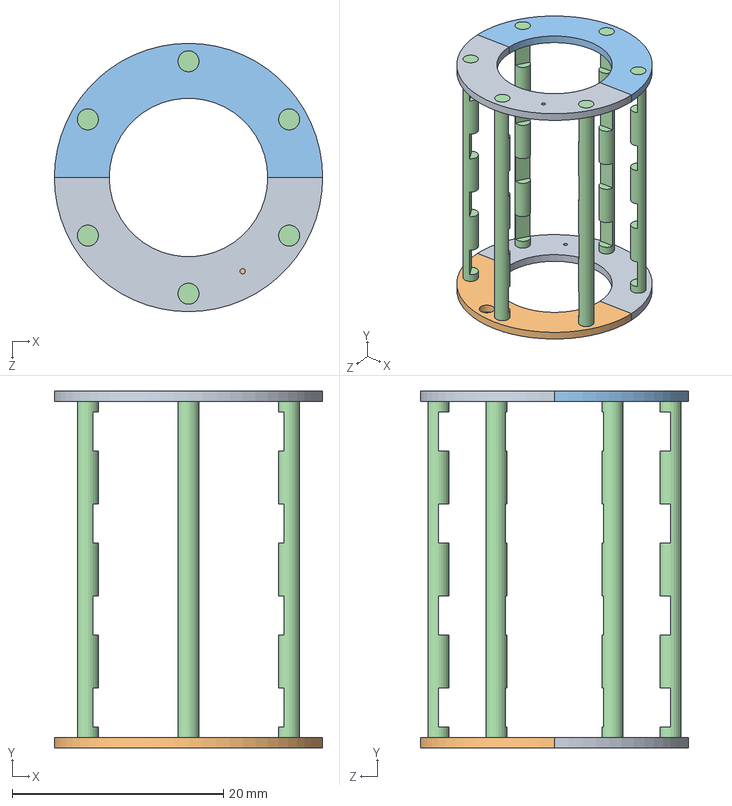
[picture p267: CAD file, 2020-10-07]
Solidworks Assemblies/Telescope Assembly Un-Parallel/Module_1_Plastic_UnParallel.SLDASM
25.4 x 33.8 x 25.4 mm
Module_Plastic_Base_Nitrogen x 2
Module_Plastic_Base_Wire
Module_Plastic_Base_Empty
Module_1_Plastic_Stand x 6
