PorterMatt/CherenkovDetector/Solidworks Parts/SSD Parts/Assemblies/Telescope_Size_Reference_V5.SLDASM

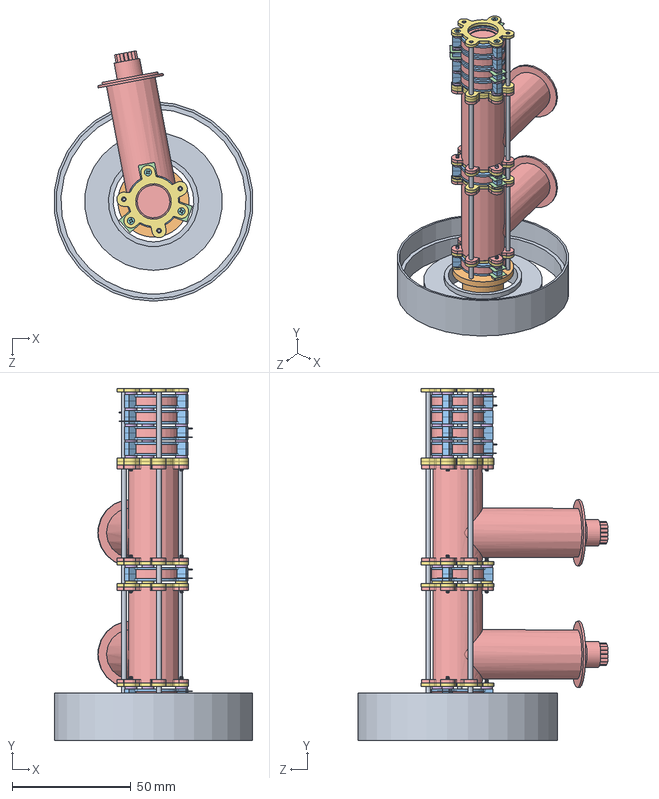
[picture p268: CAD file, 2022-01-09]
Solidworks Parts/SSD Parts/Assemblies/Telescope_Size_Reference_V5.SLDASM
83.5 x 148.2 x 105.5 mm
Reference Size for Stack
SSD_Tension_Rod x 3
SSD_Clasp_V3 x 12
SSD_Contact_Stack_V2 x 12
SSD_Model x 6
SSD_Washer x 21
Lightbox_Cap_V3 x 6
M1.6 4mm Countersunk Bolt x 12
Telescope_Tension_Rod x 3
SSD_Standoff_V1
Lightbox_Foil x 4
PMT_R12421 x 2
PMT_Socket x 2
Teflon_Lid_Top x 2
Teflon_MainHousing_Top x 2
Stack_of_Diamond x 2
Teflon_Main Housing_V2 x 2
Delrin_Diamond_Mount x 2
Teflon_Bottom_Flat x 2
Delrin_Mount_Bottom x 4
Lightbox_MainHousing_V4 x 2
M1.6 12mm Countersunk Bolt x 6
Lightbox_Washer x 6
M1.6 12mm Bolt x 5
