PorterMatt/CherenkovDetector/PICAP (Jim Connell)/PICAP solidworks/base assembly.SLDASM

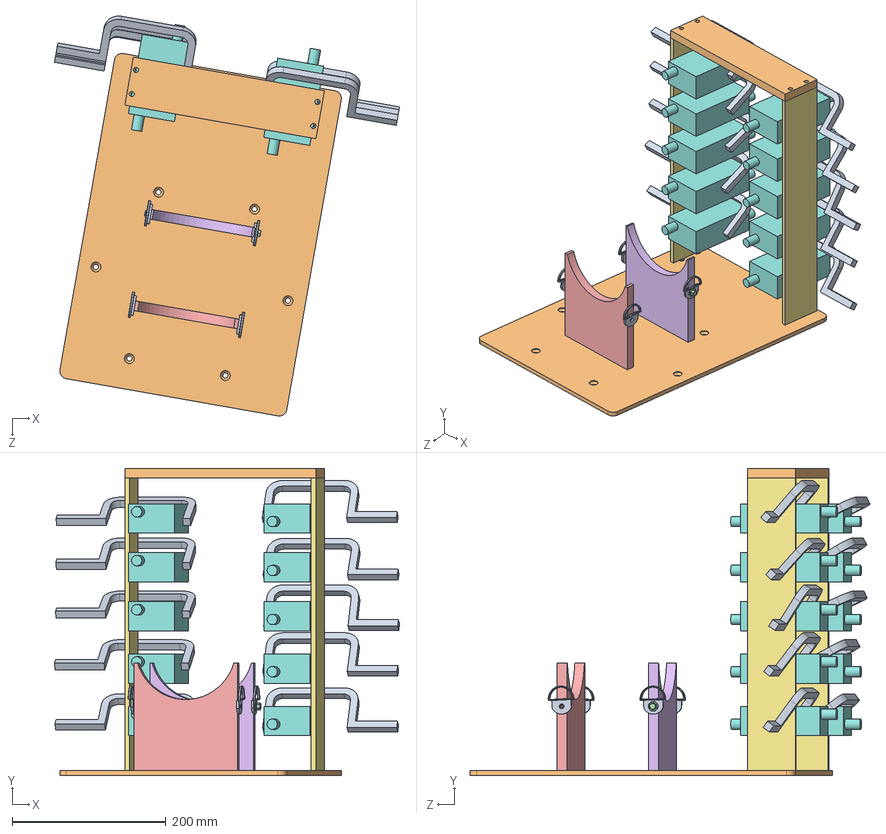
[picture p269: CAD file, 2021-06-03]
PICAP (Jim Connell)/PICAP solidworks/base assembly.SLDASM
449.5 x 400.0 x 520.9 mm
base clip x 4
baseplate
socket head cap screw_ai
hex flange machine screw_am
bas222
bas222 2
BaseColumn x 2
PreAmp x 10
cclamp x 10
Top
