PorterMatt/CherenkovDetector/Solidworks Assemblies/Telescope Assembly Parallel/Lightbox_Volume_Outside.SLDASM

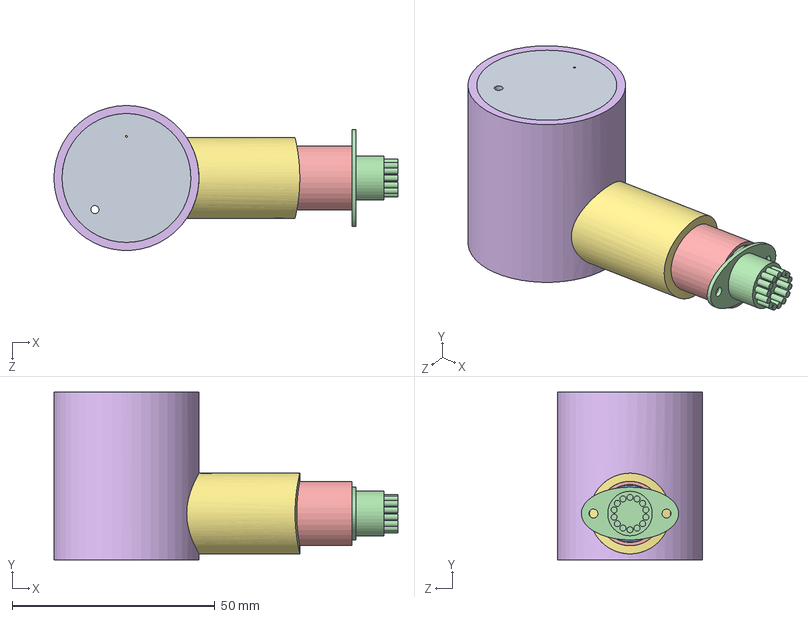
[picture p270: CAD file, 2020-10-07]
Solidworks Assemblies/Telescope Assembly Parallel/Lightbox_Volume_Outside.SLDASM
84.8 x 41.3 x 35.8 mm
Lightbox_Main_Housing
Teflon_PMT_Gap_Fill
PMT_R12421
PMT_Socket
PMT_R12421_Frame
Teflon_Main Housing
Stack_of_Diamond
Teflon_Lid_Top
Lightbox_Lid_Top
Lightbox_Lid_Bottom
Teflon_Reflector_45
Teflon_Lid_Bottom
Lightbox_Main_Housing_Insert
Teflon_Anti_Inner_Sleeve
Teflon_Anti_PMT
