PorterMatt/CherenkovDetector/Solidworks Parts/SSD Parts/Assemblies/Epoxy_Test_Assembly.SLDASM

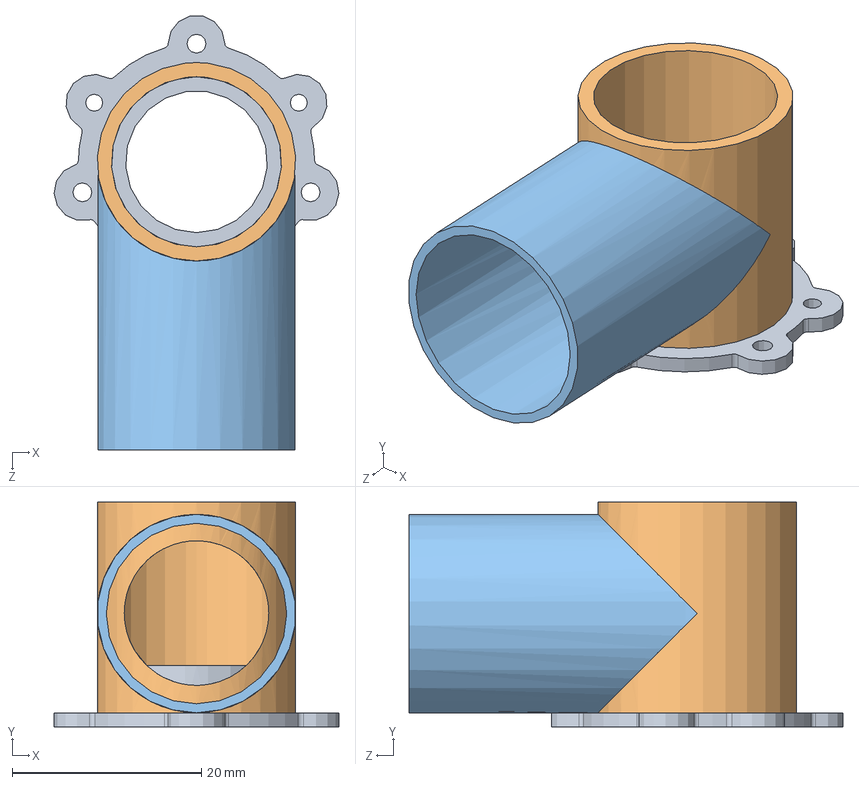
[picture p271: CAD file, 2021-11-19]
Solidworks Parts/SSD Parts/Assemblies/Epoxy_Test_Assembly.SLDASM
30.1 x 23.8 x 45.9 mm
Lightbox_Cap_V2_3DPrint
Lightbox_MainHousing_TestVersion
PMT_Housing_TestVersion
