PorterMatt/CherenkovDetector/Solidworks Parts/SSD Parts/Assemblies/SSD_Test_Assembly.SLDASM

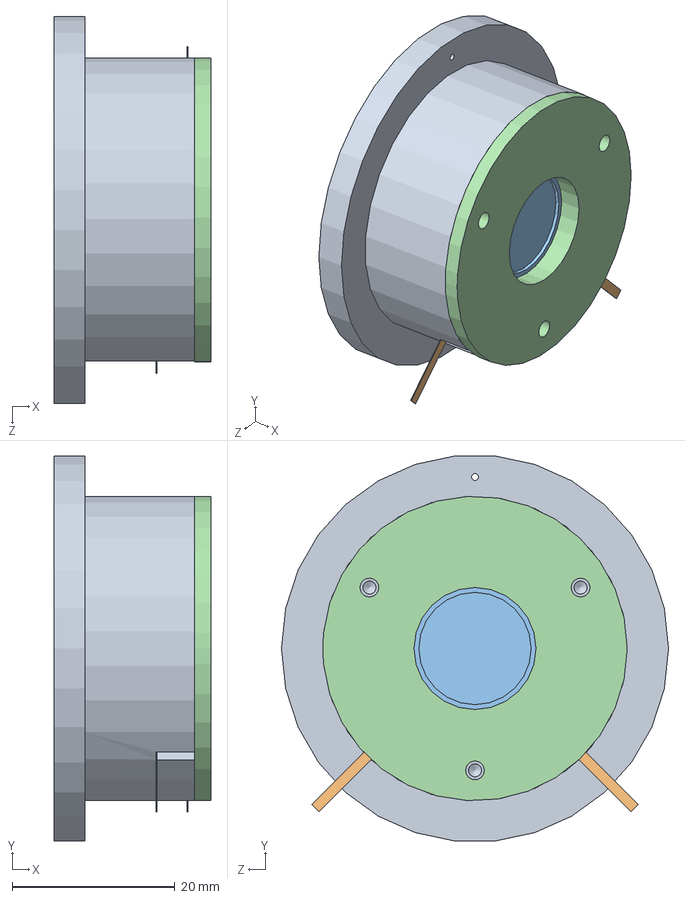
[picture p272: CAD file, 2021-10-12]
Solidworks Parts/SSD Parts/Assemblies/SSD_Test_Assembly.SLDASM
19.3 x 47.3 x 47.6 mm
Lightbox_TestMount_V2
SSD_Contact_Test_Mount x 2
SSD_Model
