PorterMatt/CherenkovDetector/Solidworks Assemblies/Lightbox_Main_Housing_Telescope_CombinedSSD.SLDPRT

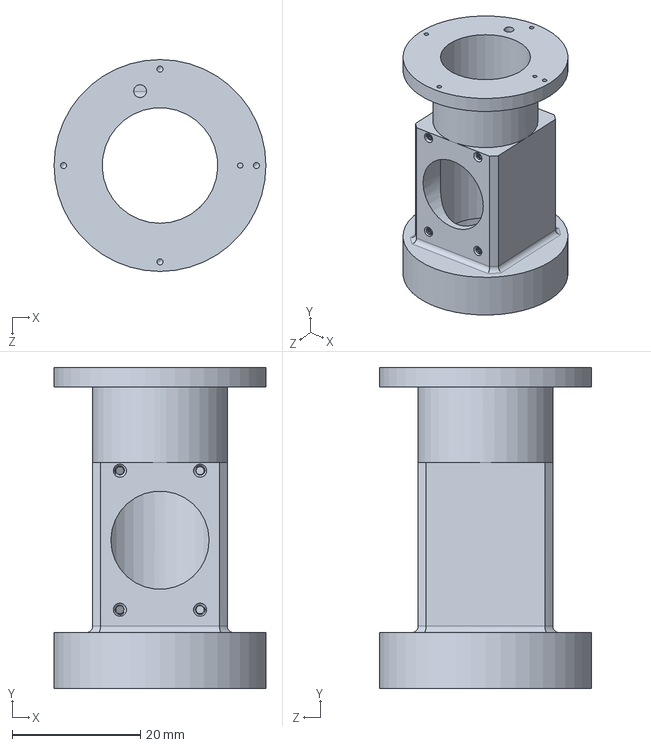
[picture p273: CAD file, 2021-05-11]
Solidworks Assemblies/Lightbox_Main_Housing_Telescope_CombinedSSD.SLDPRT
33.0 x 50.0 x 33.0 mm
