PorterMatt/CherenkovDetector/Solidworks Assemblies/Lightbox_1_Assembly_Telescope_CombinedSSD.SLDASM

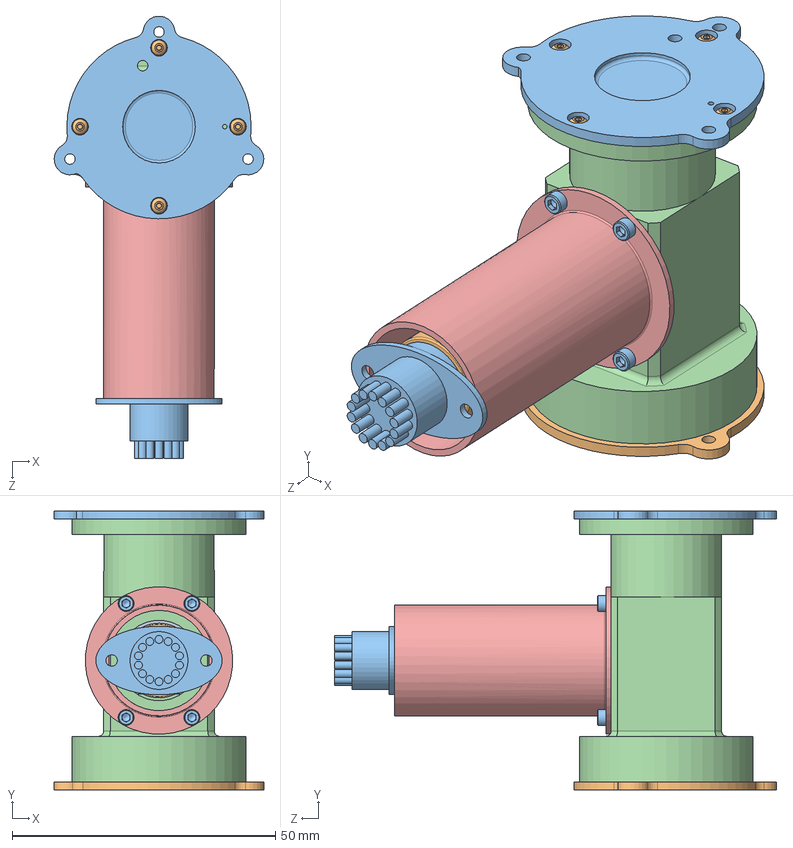
[picture p274: CAD file, 2021-05-11]
Solidworks Assemblies/Lightbox_1_Assembly_Telescope_CombinedSSD.SLDASM
39.8 x 53.0 x 84.1 mm
Teflon_Main Housing_Combined
PMT_R12421
PMT_Socket
Lightbox_Main_Housing_Telescope_CombinedSSD
PMT_R12421_Frame_Telescope
Stack_of_Diamond
Teflon_Lid_Top
Teflon_Lid_Bottom_Flat_Combined
Teflon_MainHousing_Top
92095A321_BUTTON HEAD HEX DRIVE SCREW x 7
socket head cap screw_am x 4
Teflon_Main Housing_Combined_Bottom
Module_Plastic_Base_Nitrogen x 2
Module_Plastic_Base_Wire
Module_Plastic_Base_Empty
Module_2_Plastic_Stand x 6
Solid_State_Detector
Module_2_Lid_Bottom_Combined
Module_2_Lid_Top_Combined
