PorterMatt/CherenkovDetector/Solidworks Parts/Telescope Parts/Telescope_Assembly_Parallel_Volume_Mod1.SLDPRT

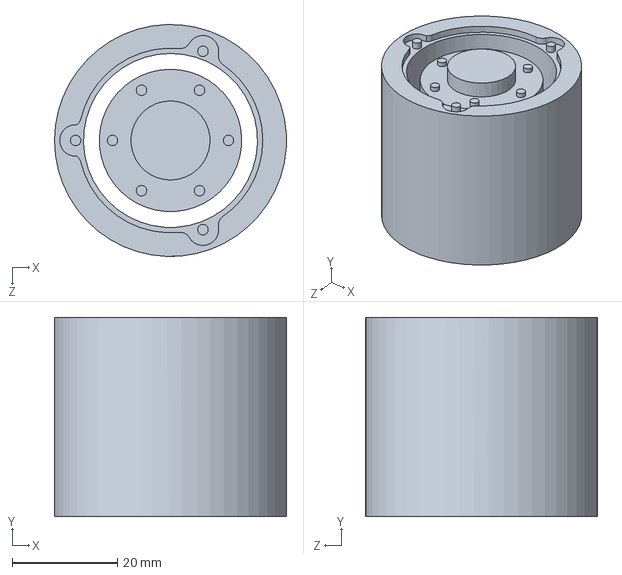
[picture p275: CAD file, 2021-05-05]
Solidworks Parts/Telescope Parts/Telescope_Assembly_Parallel_Volume_Mod1.SLDPRT
44.0 x 37.8 x 44.0 mm
