PorterMatt/CherenkovDetector/Solidworks Assemblies/Lightbox_2_Assembly.SLDASM

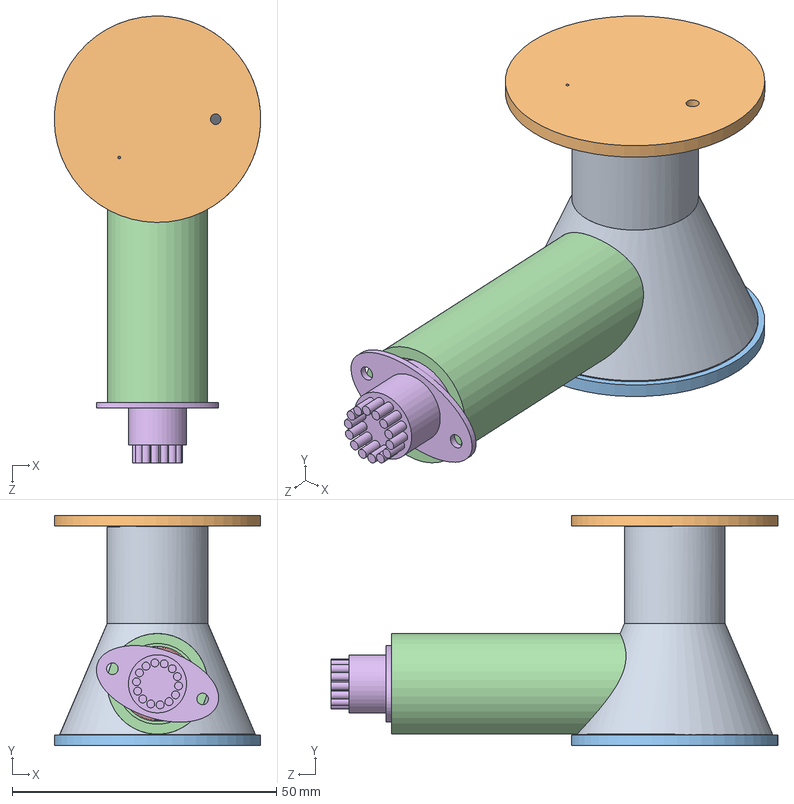
[picture p276: CAD file, 2021-04-18]
Solidworks Assemblies/Lightbox_2_Assembly.SLDASM
39.1 x 43.6 x 84.6 mm
Lightbox_2_Revolve
Teflon_2_Insert_Bottom
Teflon_2_Bottom Cover
Teflon_2_Ring
PMT_R12421
PMT_Socket
Teflon_2_Insert_Top
Stack_of_Diamond
Lightbox_2_Frame_Top
Lightbox_2_Lid_Top
Lightbox_2_Lid_Bottom
Lightbox_2_PMT_Frame
Teflon_Lid_Top
