PorterMatt/CherenkovDetector/PICAP (Jim Connell)/PICAP solidworks/side pmt alternate.SLDASM

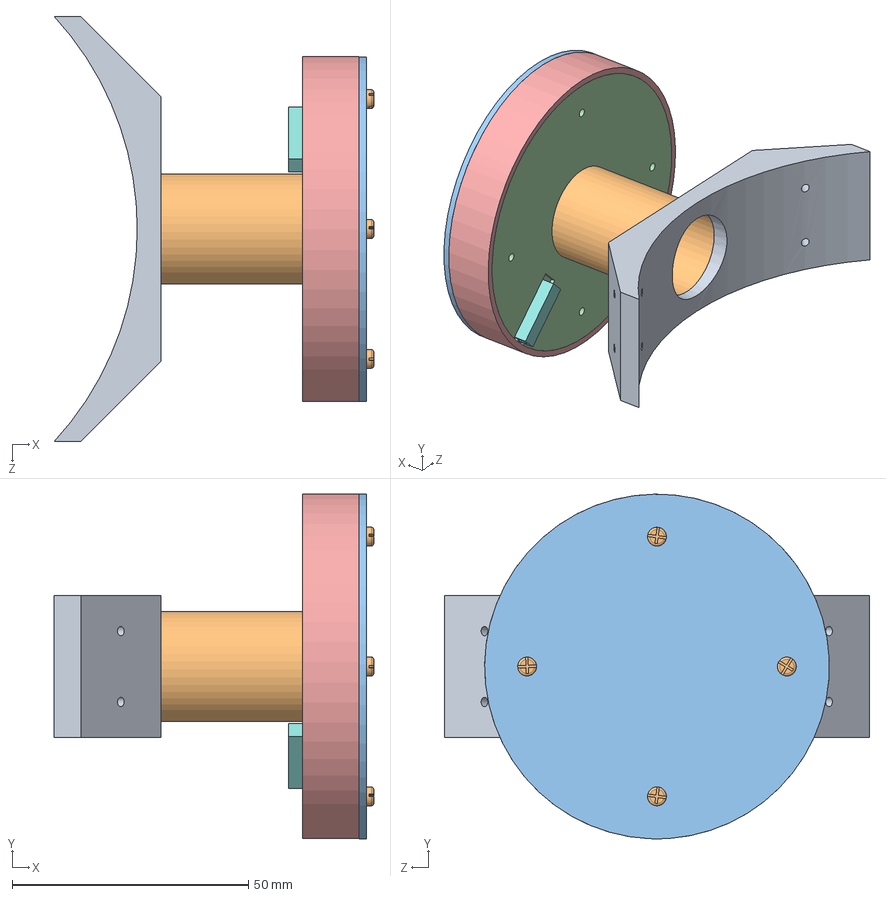
[picture p277: CAD file, 2021-06-03]
PICAP (Jim Connell)/PICAP solidworks/side pmt alternate.SLDASM
67.7 x 73.0 x 90.0 mm
plate
side pmt holder 1
side pmt cover full
side pmt mount full
side pmt tube full
side cir boards
spacer x 4
Wire guard
spacer_.61 x 4
m2x1.2 x 4
