PorterMatt/CherenkovDetector/Solidworks Assemblies/Lightbox_1_Assembly_Telescope.SLDASM

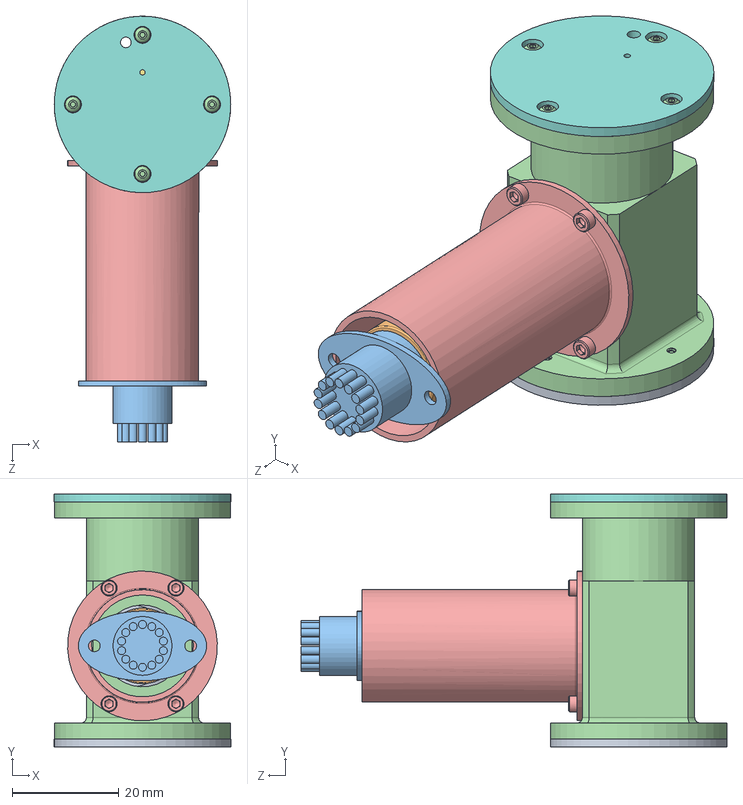
[picture p278: CAD file, 2021-04-13]
Solidworks Assemblies/Lightbox_1_Assembly_Telescope.SLDASM
33.0 x 47.3 x 79.6 mm
Teflon_Main Housing
PMT_R12421
PMT_Socket
Lightbox_Main_Housing_Telescope
PMT_R12421_Frame_Telescope
Stack_of_Diamond
Teflon_Lid_Top
Lightbox_Lid_Telescope
Lightbox_Lid_Bottom_Telescope
Teflon_Lid_Bottom_Flat
Teflon_MainHousing_Top
92095A321_BUTTON HEAD HEX DRIVE SCREW x 8
socket head cap screw_am x 4
