PorterMatt/CherenkovDetector/Solidworks Assemblies/Teflon_Main Housing_Combined.SLDPRT

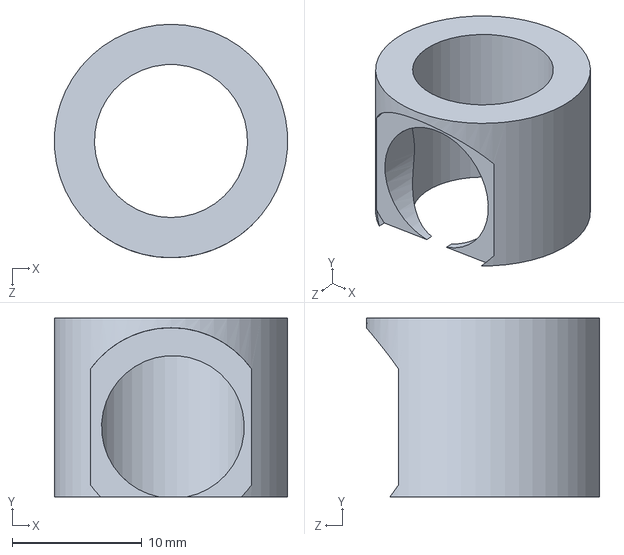
[picture p279: CAD file, 2021-04-12]
Solidworks Assemblies/Teflon_Main Housing_Combined.SLDPRT
18.0 x 13.8 x 18.0 mm
