PorterMatt/CherenkovDetector/Solidworks Assemblies/Teflon_Main Housing_Combined_Bottom.SLDPRT

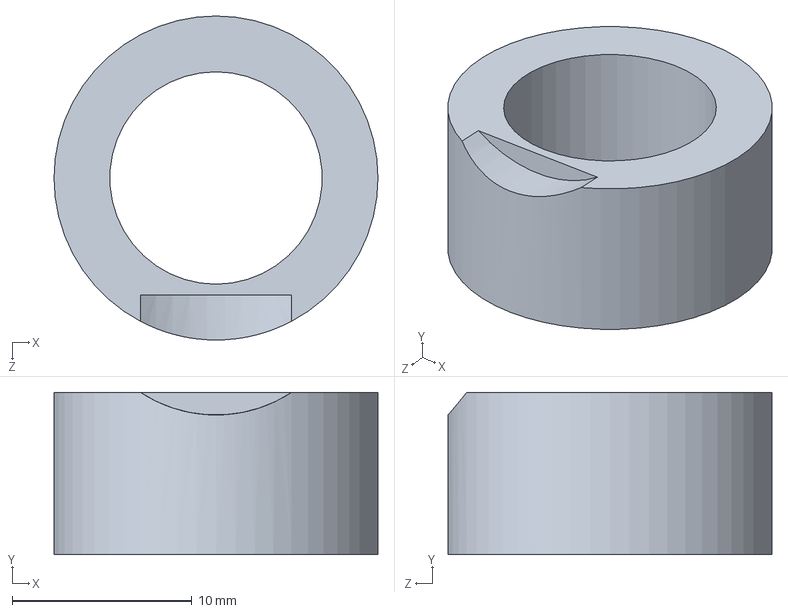
[picture p281: CAD file, 2021-04-12]
Solidworks Assemblies/Teflon_Main Housing_Combined_Bottom.SLDPRT
18.0 x 9.00 x 18.0 mm
