PorterMatt/CherenkovDetector/Solidworks Parts/SSD Parts/Assemblies/SSD_Stack_Full_Assembly_V1.SLDASM

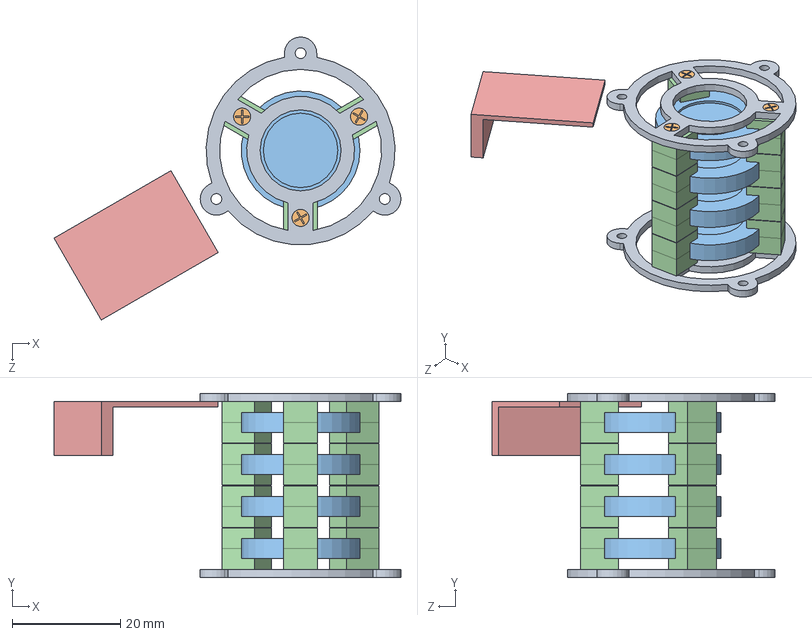
[picture p282: CAD file, 2021-07-27]
Solidworks Parts/SSD Parts/Assemblies/SSD_Stack_Full_Assembly_V1.SLDASM
64.2 x 34.1 x 52.4 mm
SSD_Stack_Cap x 2
SSD_Stack_#0_Bolt x 3
SSD_Model x 4
SSD_LClasp x 24
SSD_Shield_V1
