PorterMatt/CherenkovDetector/Solidworks Parts/SSD Parts/Assemblies/SSD_Stack_Alternate_Assembly_V1.SLDASM

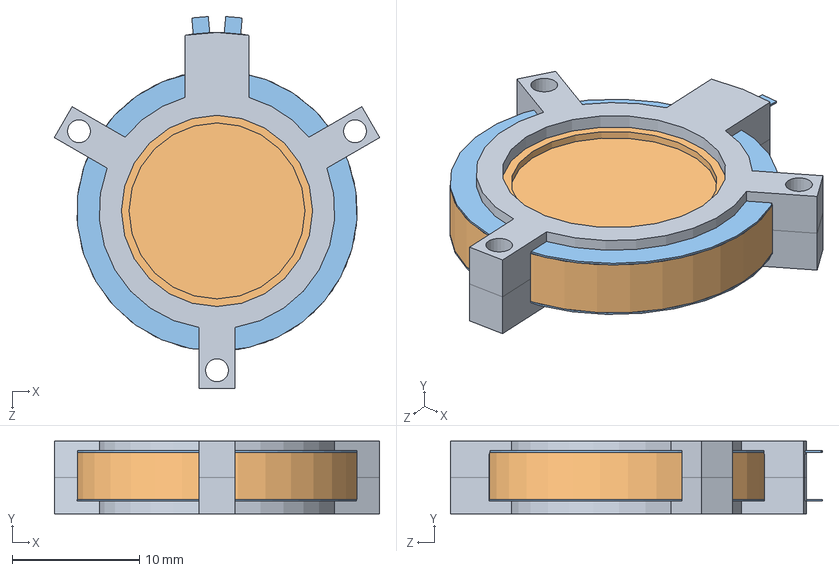
[picture p283: CAD file, 2021-07-27]
Solidworks Parts/SSD Parts/Assemblies/SSD_Stack_Alternate_Assembly_V1.SLDASM
25.5 x 5.70 x 29.2 mm
SSD_Clasp_V2 x 2
SSD_Model
SSD_BrassContact_Short x 2
