PorterMatt/CherenkovDetector/PICAP (Jim Connell)/PICAP solidworks/Columnassembly2.SLDASM

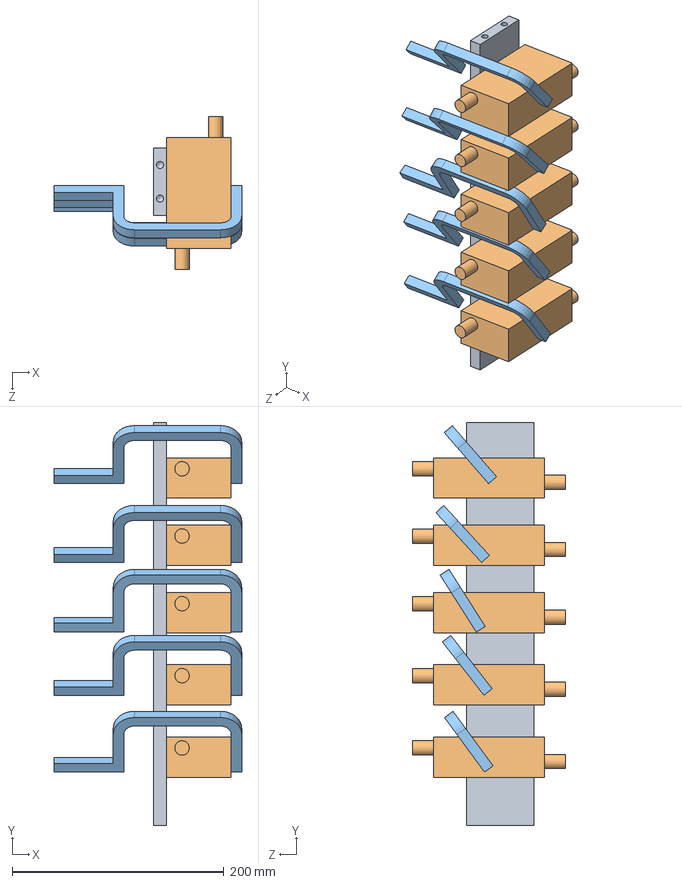
[picture p284: CAD file, 2021-06-03]
PICAP (Jim Connell)/PICAP solidworks/Columnassembly2.SLDASM
177.4 x 381.0 x 144.8 mm
BaseColumn
PreAmp x 5
cclamp x 5
