PorterMatt/CherenkovDetector/Solidworks Assemblies/Lightbox_Main_Housing.SLDPRT

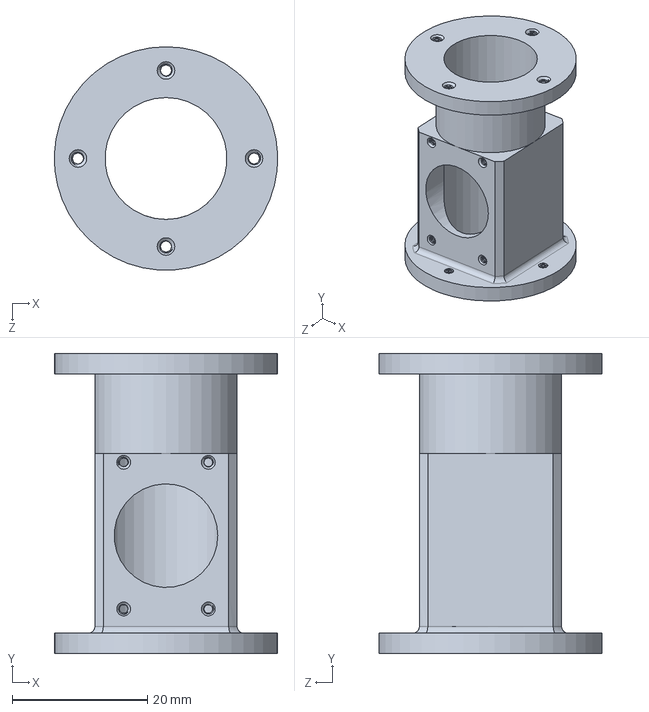
[picture p285: CAD file, 2021-04-07]
Solidworks Assemblies/Lightbox_Main_Housing.SLDPRT
33.0 x 44.3 x 33.0 mm
