PorterMatt/CherenkovDetector/Solidworks Assemblies/Lightbox_2_Top.SLDASM

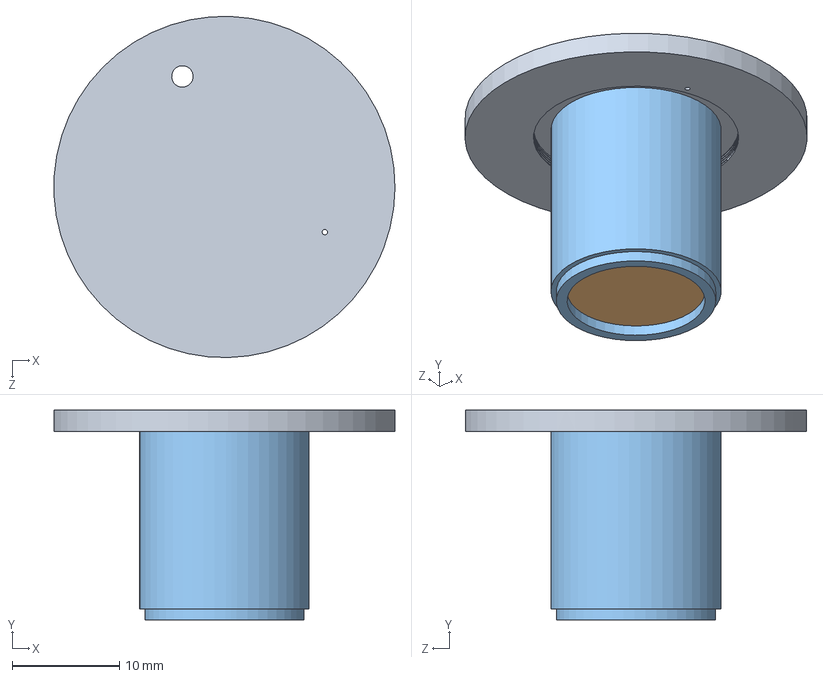
[picture p286: CAD file, 2021-01-27]
Solidworks Assemblies/Lightbox_2_Top.SLDASM
31.7 x 19.5 x 31.7 mm
Lightbox_Lid_Top
Stack_of_Diamond
Teflon_2_Insert_Top
