PorterMatt/CherenkovDetector/PICAP (Jim Connell)/PICAP solidworks/PICAP_5_Top_scintillator_assembly.SLDASM

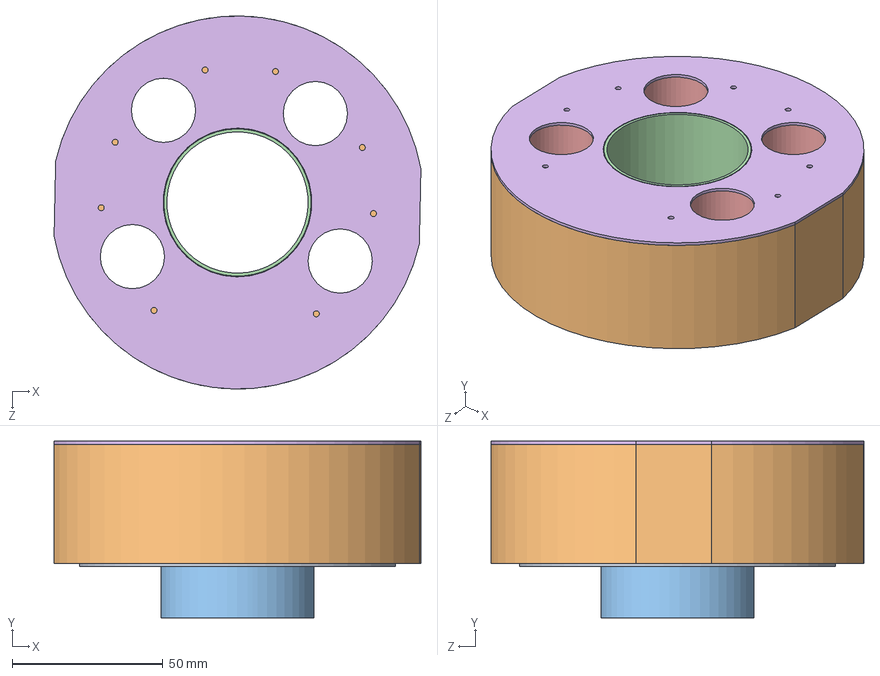
[picture p287: CAD file, 2021-06-03]
PICAP (Jim Connell)/PICAP solidworks/PICAP_5_Top_scintillator_assembly.SLDASM
121.6 x 58.5 x 123.6 mm
ANTItop_PTFE_bottom
Anti_top
ANTItop_PTFE_inner
AL_inner_topAnti
MU_PTFE x 4
ANTItop_PTFE_top
