PorterMatt/CherenkovDetector/Solidworks Assemblies/PMT_Assembly_H12690.SLDASM

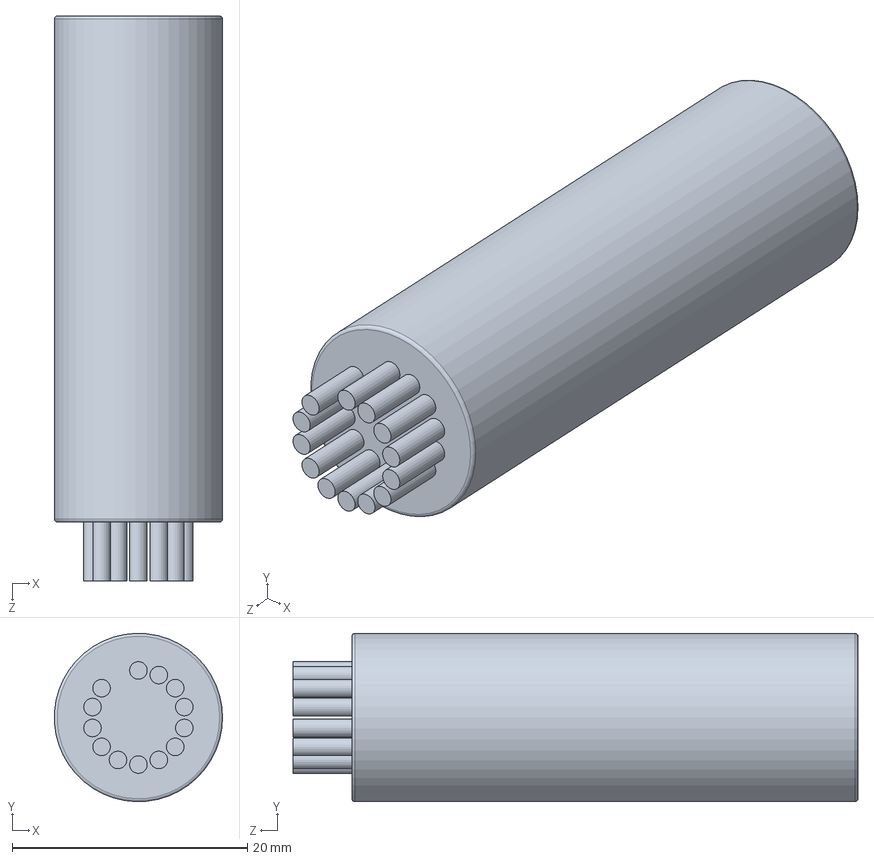
[picture p288: CAD file, 2020-10-07]
Solidworks Assemblies/PMT_Assembly_H12690.SLDASM
14.3 x 14.3 x 48.0 mm
