PorterMatt/CherenkovDetector/Solidworks Parts/SSD Parts/Parts/Teflon_Main Housing_V2.SLDPRT

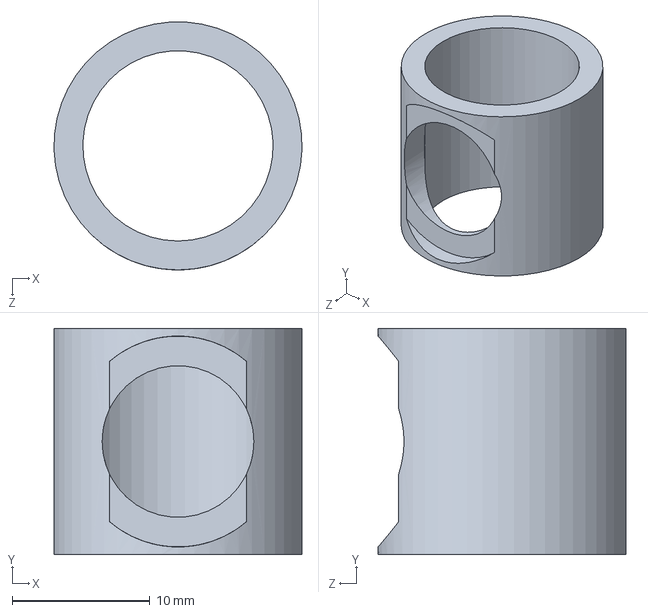
[picture p289: CAD file, 2021-11-19]
Solidworks Parts/SSD Parts/Parts/Teflon_Main Housing_V2.SLDPRT
18.0 x 16.4 x 18.0 mm
