PorterMatt/CherenkovDetector/PICAP (Jim Connell)/PICAP solidworks/PMT.SLDASM

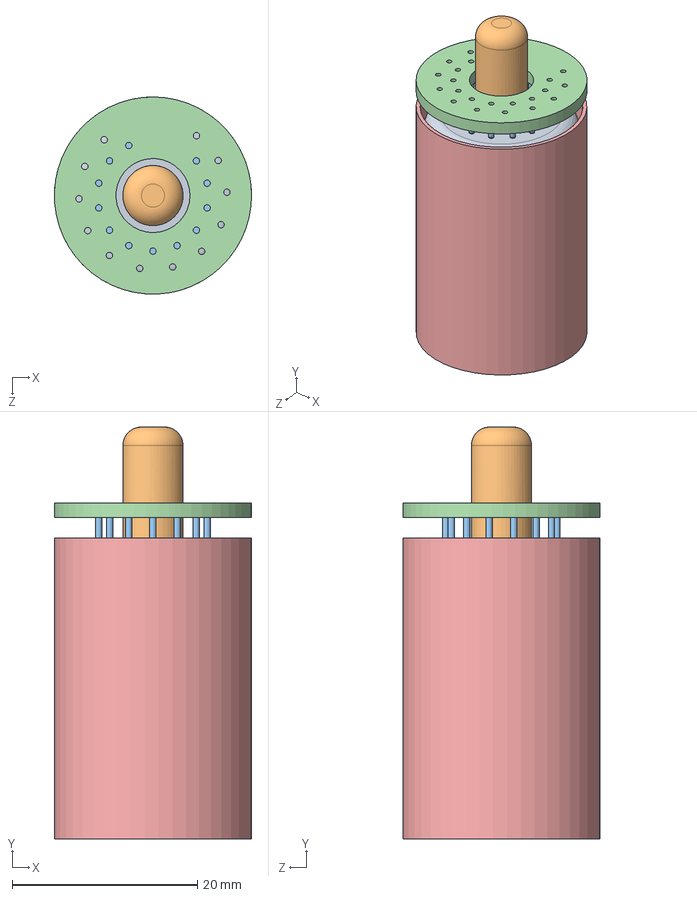
[picture p290: CAD file, 2021-06-03]
PICAP (Jim Connell)/PICAP solidworks/PMT.SLDASM
21.3 x 44.5 x 21.3 mm
PMT
PMT_lead
PMT leads
side cir boards 2
Mu_metal
