PorterMatt/CherenkovDetector/Solidworks Parts/SSD Parts/Parts/Lightbox_MainHousing_TestVersion.SLDPRT

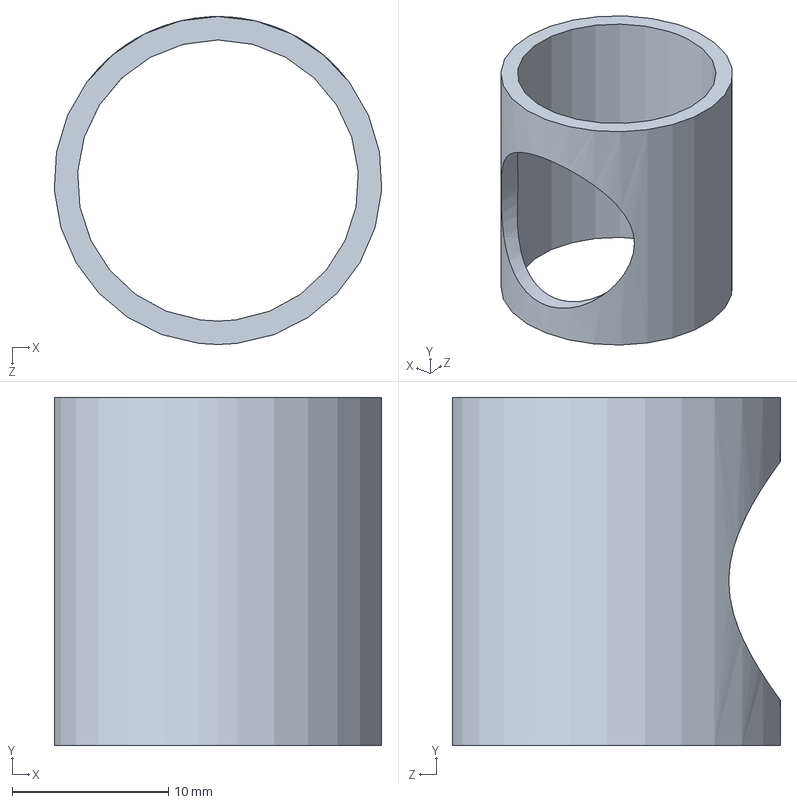
[picture p291: CAD file, 2021-11-19]
Solidworks Parts/SSD Parts/Parts/Lightbox_MainHousing_TestVersion.SLDPRT
21.0 x 22.3 x 21.0 mm
