PorterMatt/CherenkovDetector/PICAP (Jim Connell)/PICAP solidworks/PICAPRotatorPlate.SLDPRT.SLDASM

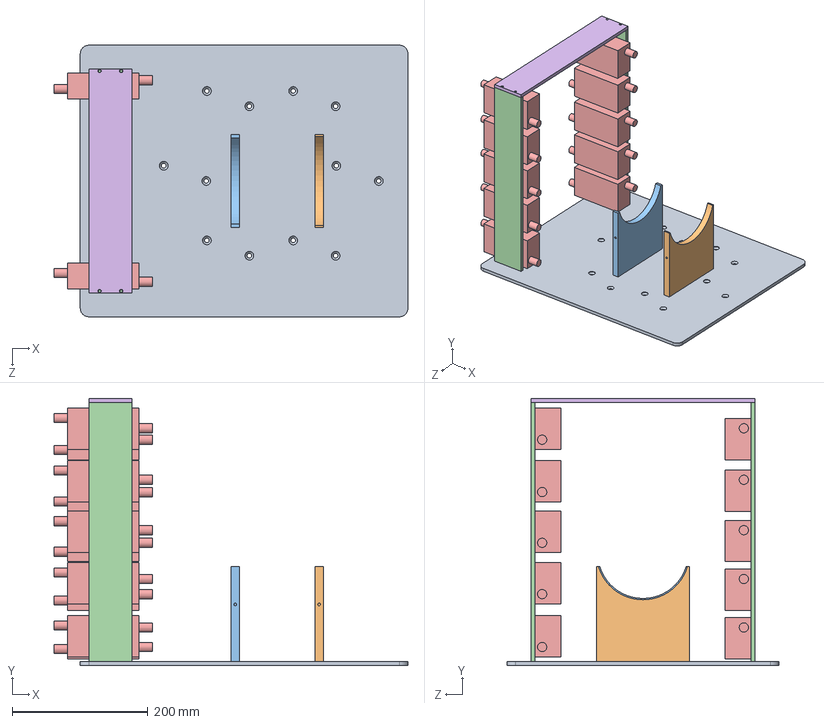
[picture p292: CAD file, 2021-06-03]
PICAP (Jim Connell)/PICAP solidworks/PICAPRotatorPlate.SLDPRT.SLDASM
521.1 x 393.7 x 400.0 mm
PICAPTurnPlate
bas222 2
bas222
BaseColumn x 2
PreAmp x 10
TopBar
