PorterMatt/CherenkovDetector/PICAP (Jim Connell)/PICAP solidworks/PICAP_5_sintillator_assemly.SLDASM

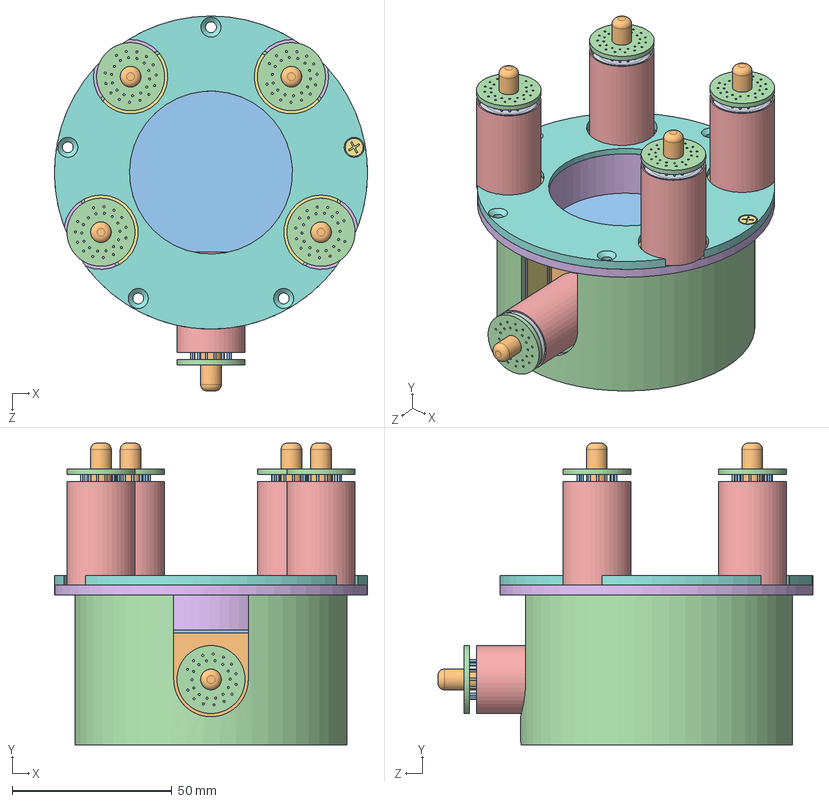
[picture p293: CAD file, 2021-06-03]
PICAP (Jim Connell)/PICAP solidworks/PICAP_5_sintillator_assemly.SLDASM
98.0 x 94.5 x 117.4 mm
C5
C_PTFE_side
C_PTFE_TB x 2
AL_intube
G_PTFE_inside
G_PTFE_outside
G_PTFE_PMT x 2
G_sint5 x 4
G_PTFE_centerSIDE x 2
G_PTFE_centerT
G_PTFE_bottom
AL_outter
AL_bottom
C_placeholder5
AL_G_cover
PMT x 5
PMT_lead x 5
PMT leads x 5
side cir boards 2 x 5
Mu_metal x 5
