PorterMatt/CherenkovDetector/PICAP (Jim Connell)/PICAP solidworks/cylinder assly 2.SLDASM

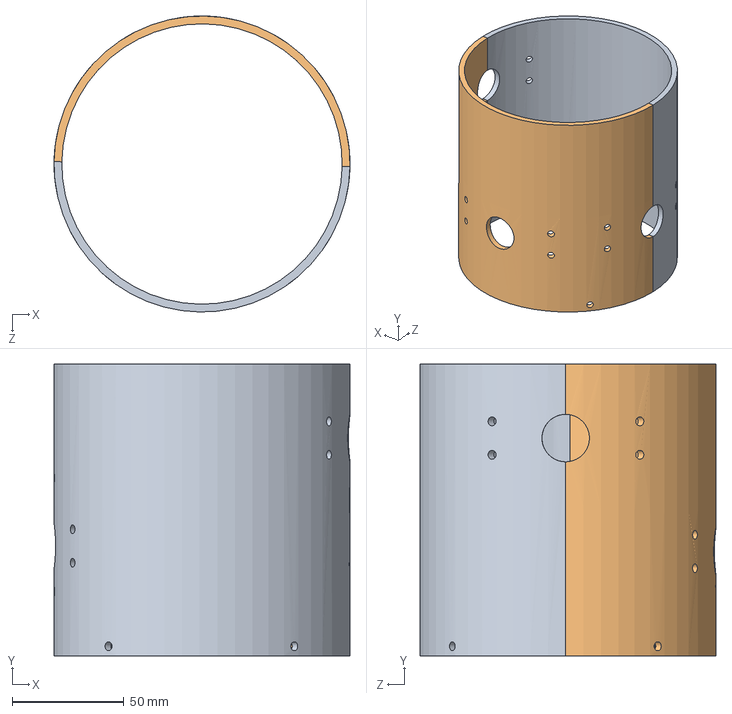
[picture p294: CAD file, 2021-06-03]
PICAP (Jim Connell)/PICAP solidworks/cylinder assly 2.SLDASM
132.7 x 130.8 x 132.7 mm
Cylinder1 side mounts
Cylinder2 sidemounts
