PorterMatt/CherenkovDetector/Solidworks Parts/Telescope Unparallel Parts/Telescope_Assembly_UnParallel.SLDASM

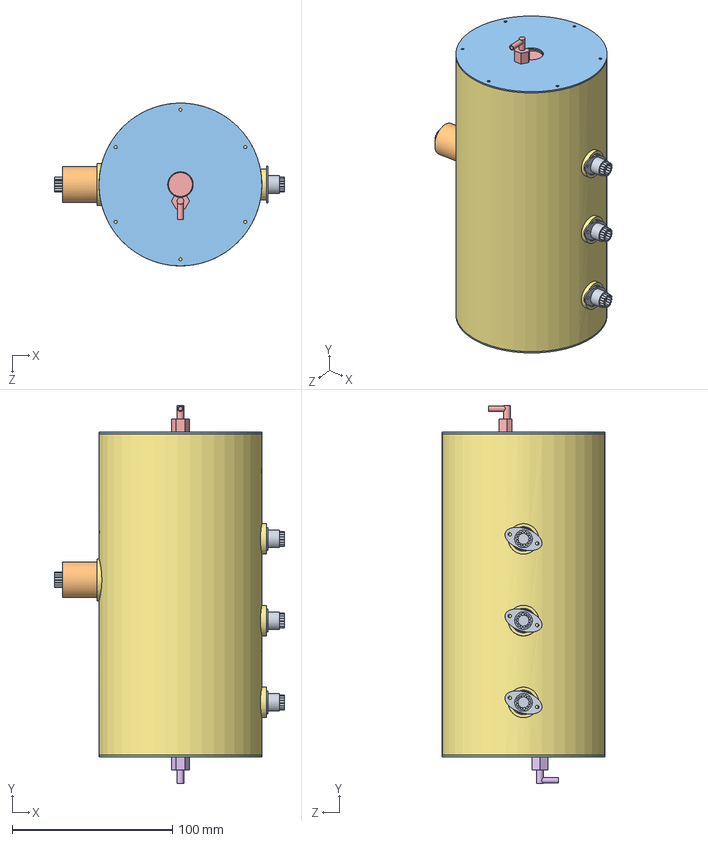
[picture p295: CAD file, 2020-10-14]
Solidworks Parts/Telescope Unparallel Parts/Telescope_Assembly_UnParallel.SLDASM
143.8 x 235.8 x 101.6 mm
Solid_State_Detector x 8
Module_1_Shell
Module_1_Lid_Bottom
Module_1_Lid_Top
Module_1_Brass_Holder
Module_1_Brass
Module_Plastic_Base_Nitrogen x 5
Module_Plastic_Base_Wire x 4
Module_Plastic_Base_Empty x 4
Module_1_Plastic_Stand x 6
91430A145_18-8 STAINLESS STEEL SLOTTED SCREWS x 32
Lightbox_2_Revolve x 3
Teflon_2_Insert_Bottom x 3
Teflon_2_Bottom Cover x 3
Teflon_2_Ring x 3
PMT_R12421 x 3
PMT_Socket x 3
Teflon_2_Insert_Top x 3
Stack_of_Diamond x 3
Lightbox_2_Frame_Top x 3
Lightbox_2_Lid_Top x 3
Lightbox_2_Lid_Bottom x 3
Lightbox_2_PMT_Frame x 3
Module_2_Shell x 2
Module_2_Lid_Top x 2
Module_2_Lid_Bottom x 2
Module_Plastic_Base_Nitrogen_and_Wire x 3
Module_2_Plastic_Stand x 12
Module_3_Shell
Module_3_Lid_Top
Module_3_Lid_Bottom
Module_3_Plastic_Stand x 6
Teflon_Anti_Inner_Sleeve
Teflon_Anti_PMT x 3
Teflon_Anti_Outer_Sleeve
Anticoincidence_Plastic
Teflon_Anti_Lid_Bottom
Teflon_Anti_Lid_Top
Telescope_Outer_Shell
Teflon_Anti_PMT_Gap_Fill
PMT_R5610A
PMT_R5610A_Frame
Telescope_Outer_Lid_Top
Telescope_Outer_Lid_Bottom
Vent_Top
Vent_Bottom
