PorterMatt/CherenkovDetector/PICAP (Jim Connell)/PICAP solidworks/Al_rign.SLDASM

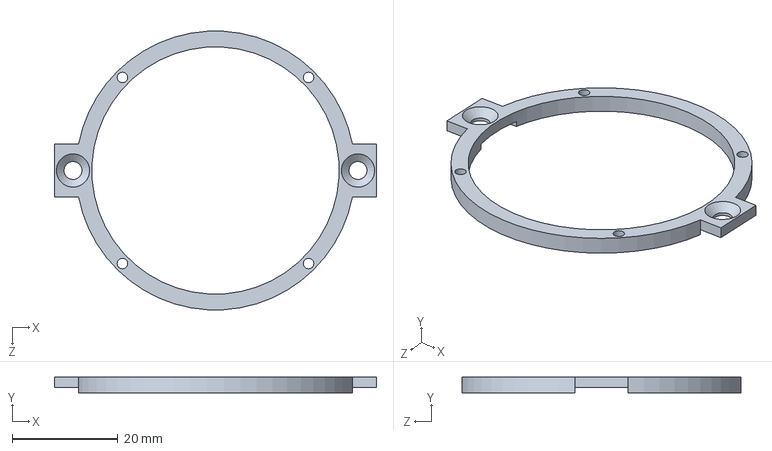
[picture p296: CAD file, 2021-06-03]
PICAP (Jim Connell)/PICAP solidworks/Al_rign.SLDASM
60.9 x 3.00 x 52.7 mm
