PorterMatt/CherenkovDetector/PICAP (Jim Connell)/PICAP solidworks/Ciruit assembly 4.SLDPRT.SLDASM

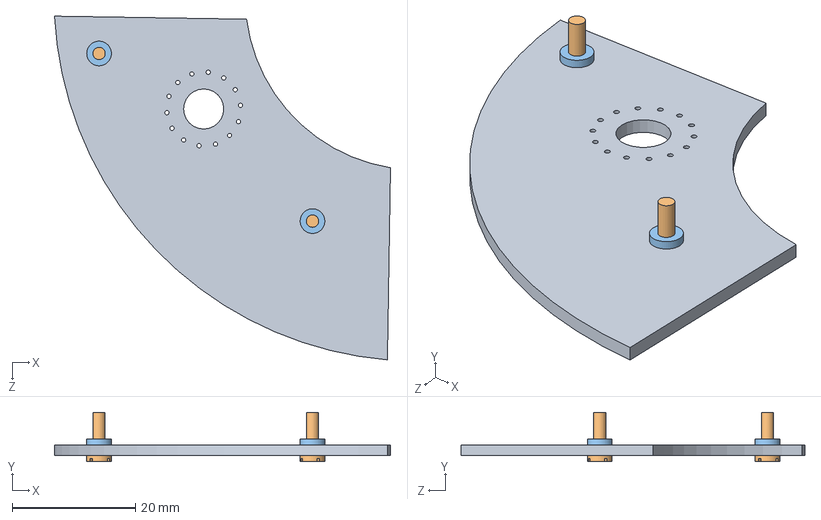
[picture p297: CAD file, 2021-06-03]
PICAP (Jim Connell)/PICAP solidworks/Ciruit assembly 4.SLDPRT.SLDASM
54.5 x 8.00 x 55.7 mm
Ciruitboard2
plastic screw x 2
spacer x 2
