PorterMatt/CherenkovDetector/PICAP (Jim Connell)/PICAP solidworks/edit.SLDASM

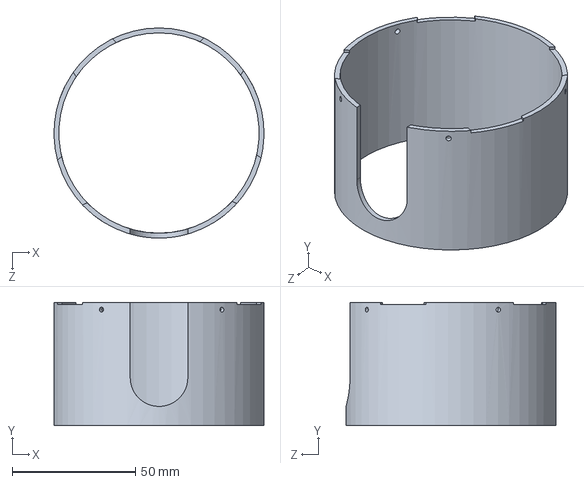
[picture p298: CAD file, 2021-06-03]
PICAP (Jim Connell)/PICAP solidworks/edit.SLDASM
85.0 x 50.0 x 85.1 mm
