PorterMatt/CherenkovDetector/PICAP (Jim Connell)/PICAP solidworks/PICAP.SLDASM

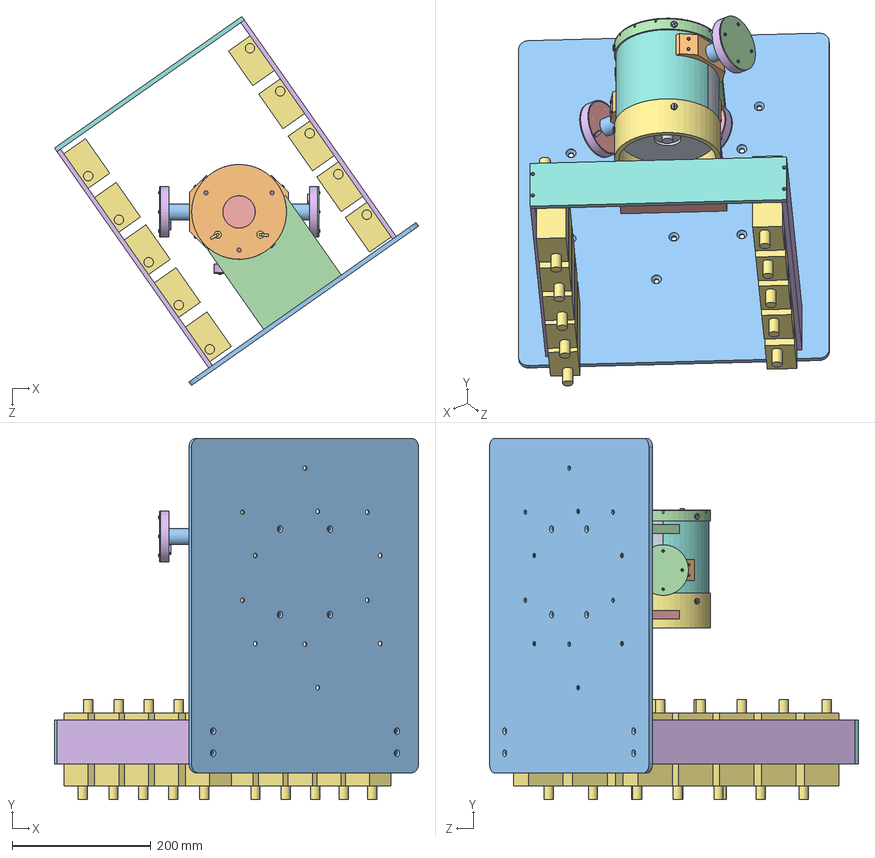
[picture p299: CAD file, 2021-06-03]
PICAP (Jim Connell)/PICAP solidworks/PICAP.SLDASM
525.0 x 521.1 x 532.0 mm
C5
C_PTFE_side
C_PTFE_TB x 2
AL_intube
G_PTFE_inside
G_PTFE_outside
G_PTFE_PMT x 2
G_sint5 x 4
G_PTFE_centerSIDE x 2
G_PTFE_centerT
G_PTFE_bottom
AL_outter
AL_bottom
C_placeholder5
G_PTFE_top
AL_G_cover
PMT x 8
PMT_lead x 8
PMT leads x 8
side cir boards 2 x 8
Mu_metal x 8
Al_pmtbase
AL_D4_holder
SS_D4
ANTIbottom_PTFE_bottom
ANTI_bottom
ANTIbottom_PTFE_inner
AL_D4_PTFE
ANTIside_PTFE_bottom
Bottom_Cover
D4_holder
D4_bottom_plate
ANTIside_PTFE_inner
AL_Outter_PTFE
ANTIside
ANTItop_PTFE_bottom
Anti_top
ANTItop_PTFE_inner
AL_inner_topAnti
MU_PTFE x 4
ANTItop_PTFE_top
MU_PTFE_side
Top_Cover
Gold_foil
columnsTest x 2
Active area test x 3
clip x 6
clipscrews x 12
AL_foil cover
cover ring 2
m3 countersunk x 2
m2x5 x 4
m3x3 x 3
vent x 2
Cylinder1 side mounts
Cylinder2 sidemounts
plate x 3
side pmt holder 1 x 2
side pmt cover full x 3
side pmt mount full x 3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
