PorterMatt/CherenkovDetector/PICAP (Jim Connell)/PICAP solidworks/PICAP_5_Anit_side _assembly.SLDASM

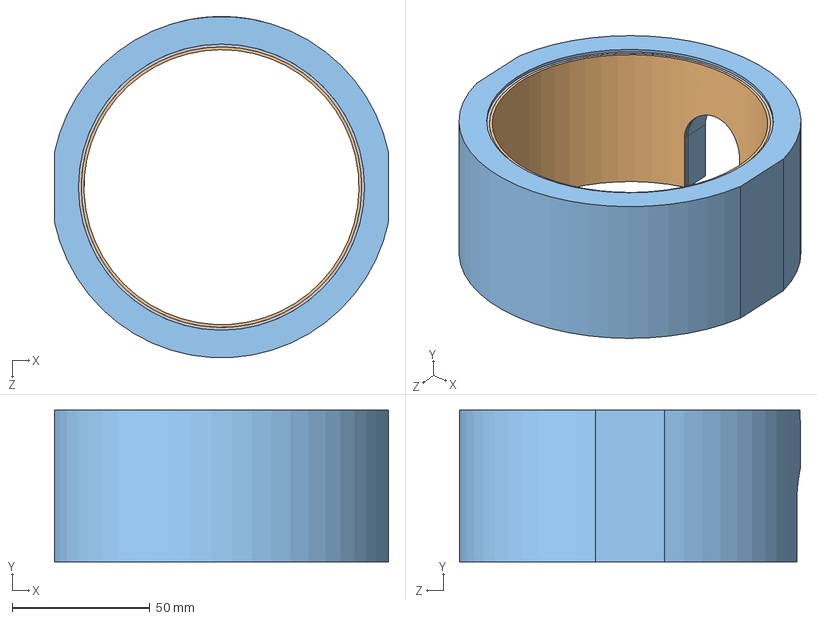
[picture p300: CAD file, 2021-06-03]
PICAP (Jim Connell)/PICAP solidworks/PICAP_5_Anit_side _assembly.SLDASM
121.1 x 55.0 x 123.6 mm
ANTIside_PTFE_inner
AL_Outter_PTFE
ANTIside
