PorterMatt/CherenkovDetector/PICAP (Jim Connell)/PICAP solidworks/Ciruit assembly 1.SLDPRT.SLDASM

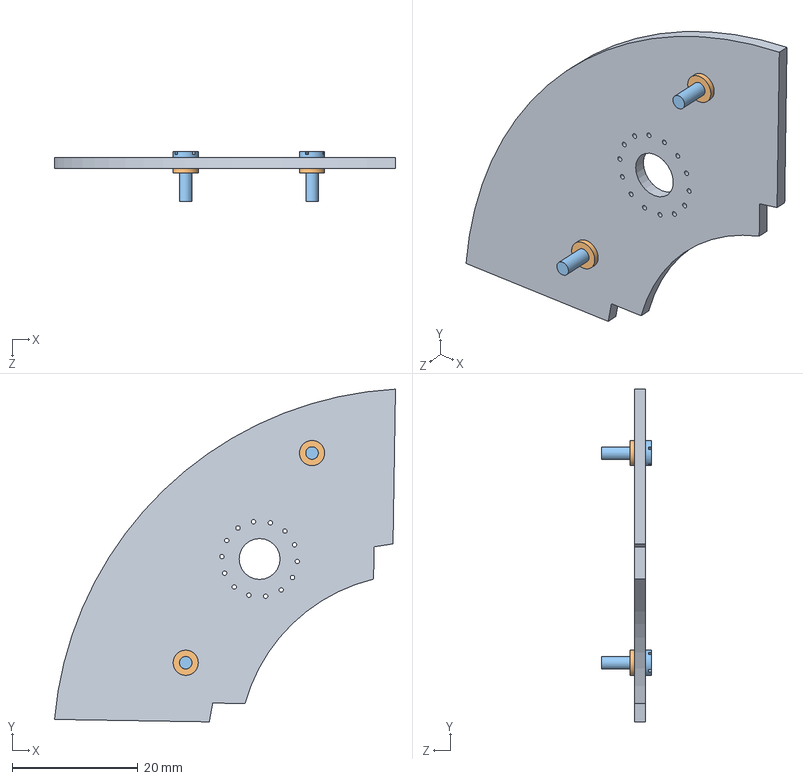
[picture p301: CAD file, 2021-06-03]
PICAP (Jim Connell)/PICAP solidworks/Ciruit assembly 1.SLDPRT.SLDASM
54.2 x 52.9 x 8.00 mm
Ciruitboard1
spacer x 2
plastic screw x 2
