PorterMatt/CherenkovDetector/PICAP (Jim Connell)/PICAP solidworks/cylinder assembly.SLDASM

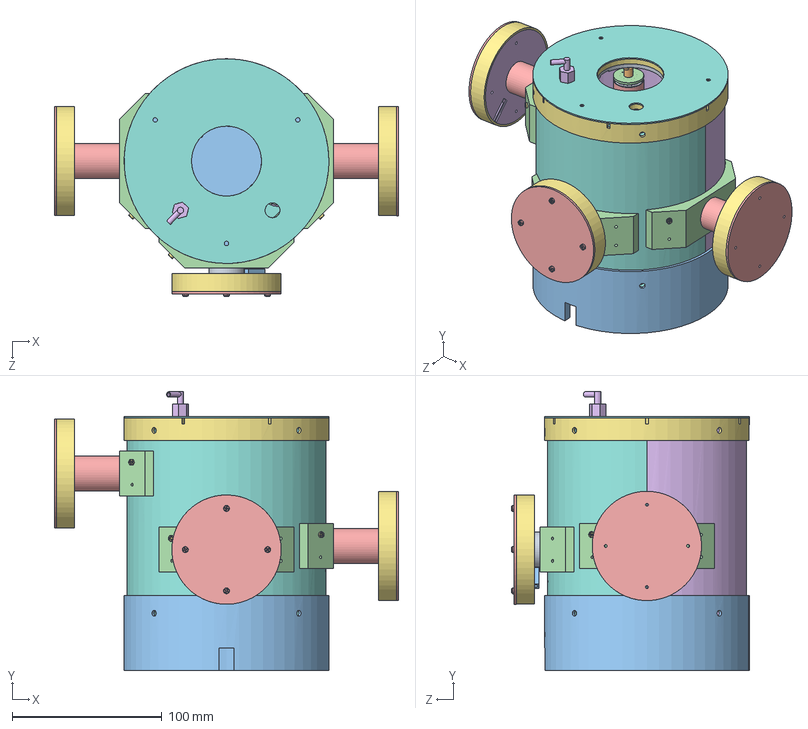
[picture p302: CAD file, 2021-06-03]
PICAP (Jim Connell)/PICAP solidworks/cylinder assembly.SLDASM
229.7 x 186.5 x 158.6 mm
C5
C_PTFE_side
C_PTFE_TB x 2
AL_intube
G_PTFE_inside
G_PTFE_outside
G_PTFE_PMT x 2
G_sint5 x 4
G_PTFE_centerSIDE x 2
G_PTFE_centerT
G_PTFE_bottom
AL_outter
AL_bottom
C_placeholder5
G_PTFE_top
AL_G_cover
PMT x 5
PMT_lead x 5
PMT leads x 5
side cir boards 2 x 5
Mu_metal x 5
Al_pmtbase
M3x6countersunkl x 5
Cylinder2 sidemounts
ANTIside_PTFE_inner
AL_Outter_PTFE
ANTIside
plate x 3
side pmt cover full x 3
side pmt mount full x 3
side pmt tube full x 3
side cir boards
side pmt holder
spacer x 4
Wire guard
spacer_.61 x 4
m2x1.2 x 4
Cylinder1 side mounts
Top_Cover
AL_foil cover
cover ring 2
m2x5 x 2
Bottom_Cover
D4_bottom_plate
side pmt holder 1 x 2
vent
M2x10 x 3
