PorterMatt/CherenkovDetector/PICAP (Jim Connell)/PICAP solidworks/Ciruit assembly NEW.SLDPRT.SLDASM

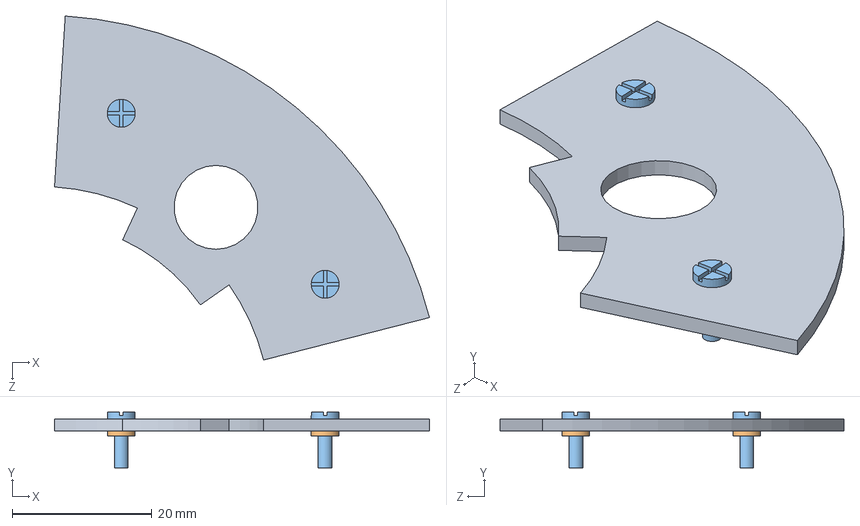
[picture p303: CAD file, 2021-06-03]
PICAP (Jim Connell)/PICAP solidworks/Ciruit assembly NEW.SLDPRT.SLDASM
53.6 x 8.00 x 49.2 mm
Ciruitboar_new
spacer x 2
plastic screw x 2
