PorterMatt/CherenkovDetector/PICAP (Jim Connell)/PICAP solidworks/Cover.SLDASM

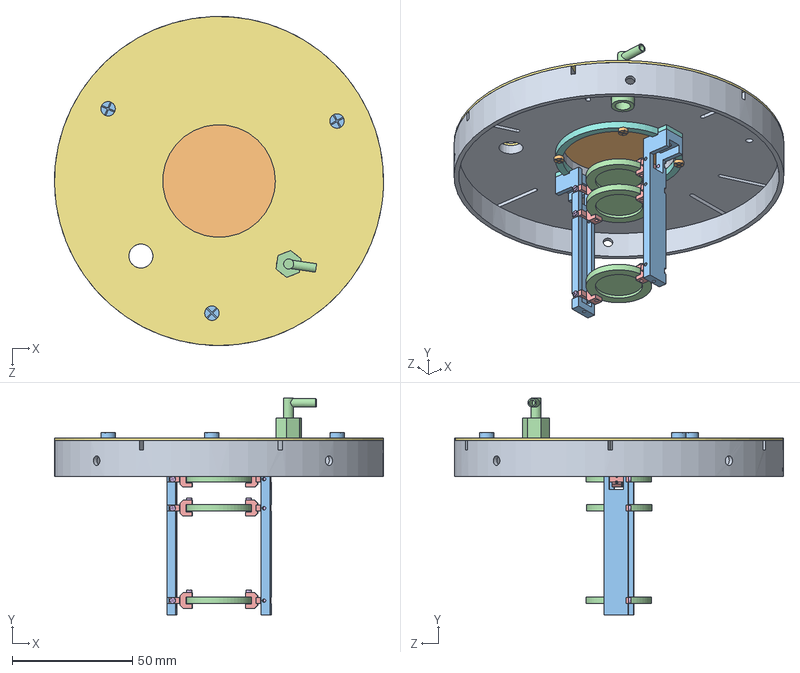
[picture p304: CAD file, 2021-06-03]
PICAP (Jim Connell)/PICAP solidworks/Cover.SLDASM
136.7 x 90.1 x 136.7 mm
Top_Cover
Gold_foil
columnsTest x 2
Active area test x 3
clip x 6
clipscrews x 12
cover ring 2
m3 countersunk x 2
m2x5 x 4
m3x3 x 3
vent
