PorterMatt/CherenkovDetector/PICAP (Jim Connell)/PICAP solidworks/circuit assembly.SLDASM

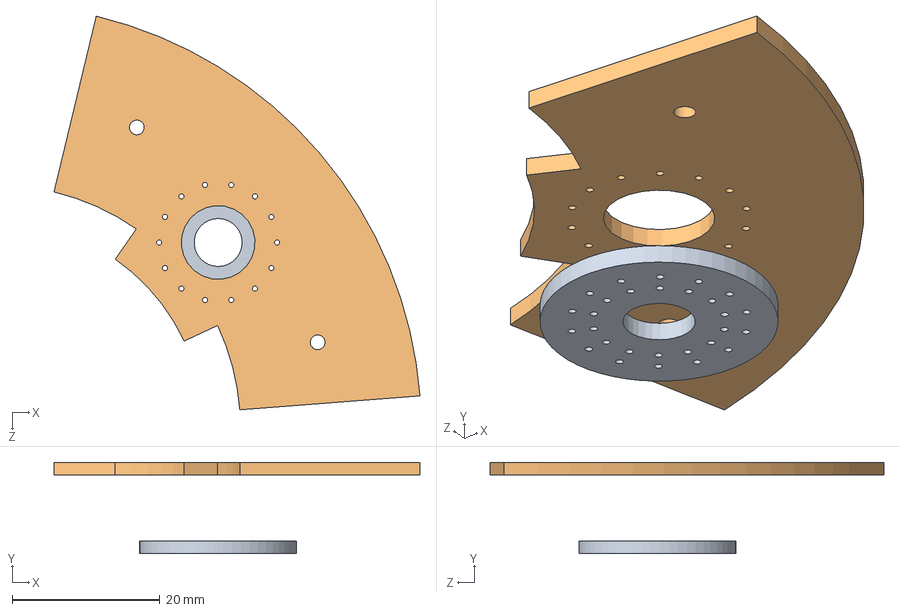
[picture p305: CAD file, 2021-06-03]
PICAP (Jim Connell)/PICAP solidworks/circuit assembly.SLDASM
49.6 x 12.4 x 53.4 mm
side cir boards 2
Ciruitboar_new
