PorterMatt/CherenkovDetector/PICAP (Jim Connell)/PICAP solidworks/PICAP_5_D4_assembly.SLDASM

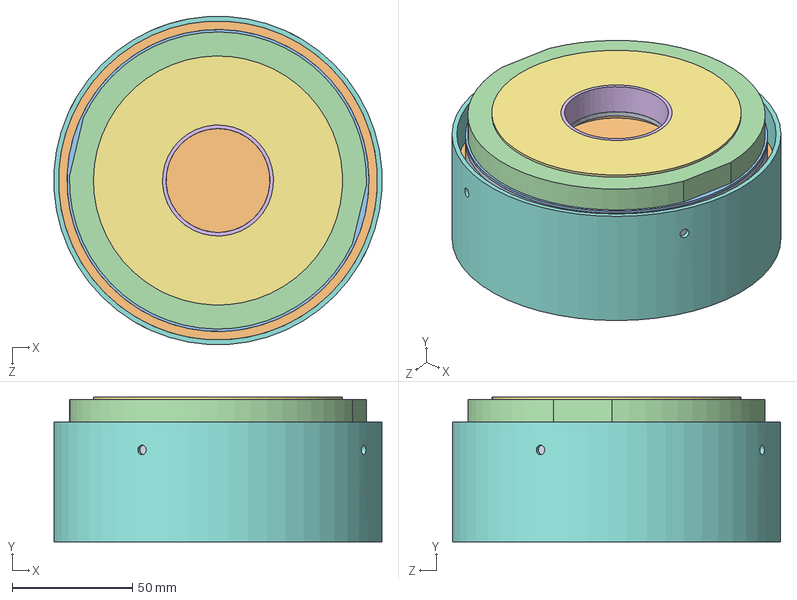
[picture p306: CAD file, 2021-06-03]
PICAP (Jim Connell)/PICAP solidworks/PICAP_5_D4_assembly.SLDASM
136.5 x 60.3 x 136.5 mm
AL_D4_holder
SS_D4
ANTIbottom_PTFE_bottom
ANTI_bottom
ANTIbottom_PTFE_inner
AL_D4_PTFE
ANTIside_PTFE_bottom
Bottom_Cover
D4_bottom_plate
