PorterMatt/CherenkovDetector/Icon Designs/Model1.SLDPRT

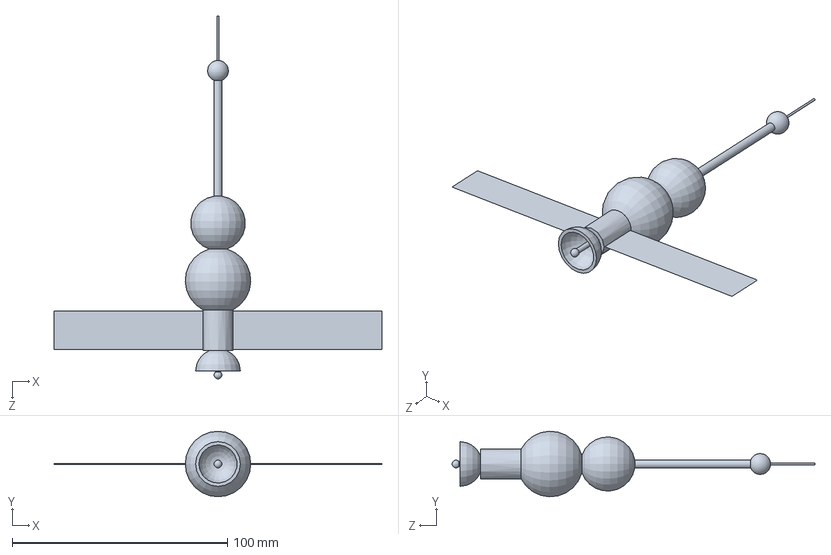
[picture p307: CAD file, 2021-07-20]
Icon Designs/Model1.SLDPRT
152.4 x 30.5 x 168.6 mm
