PorterMatt/CherenkovDetector/PICAP (Jim Connell)/PICAP Documents/BredanShopwork/D4 test assembly/Part1.SLDPRT

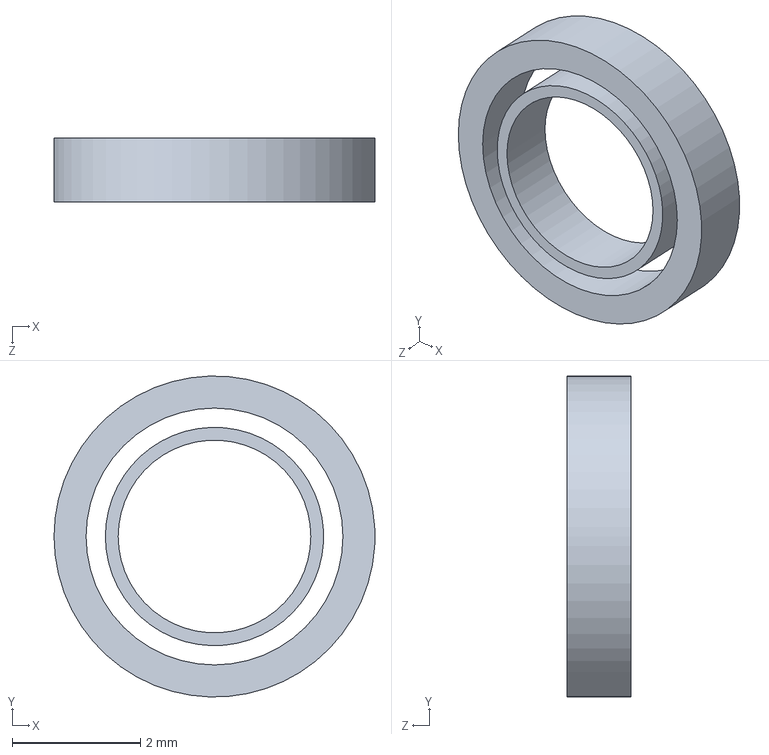
[picture p308: CAD file, 2021-06-03]
PICAP (Jim Connell)/PICAP Documents/BredanShopwork/D4 test assembly/Part1.SLDPRT
5.00 x 5.00 x 1.00 mm
