PorterMatt/CherenkovDetector/PICAP (Jim Connell)/PICAP drawings and BOM/Anti Assembly/A-A01/AL_Outter_PTFE.SLDPRT

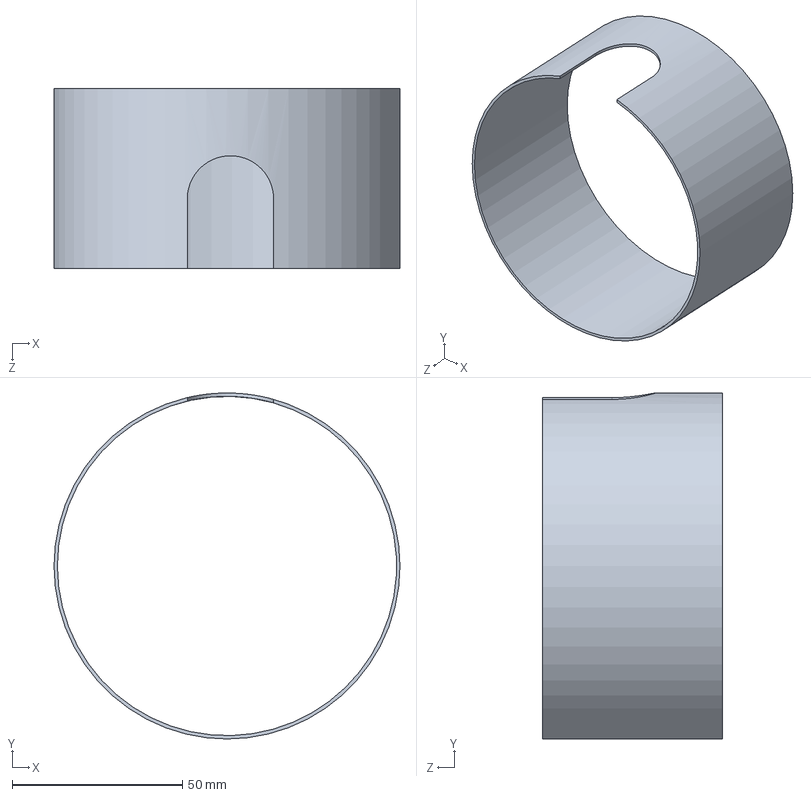
[picture p309: CAD file, 2021-06-03]
PICAP (Jim Connell)/PICAP drawings and BOM/Anti Assembly/A-A01/AL_Outter_PTFE.SLDPRT
101.6 x 101.6 x 53.0 mm
