PorterMatt/CherenkovDetector/PICAP (Jim Connell)/PICAP drawings and BOM/Anti Assembly/A-A07/AL_inner_topAnti.SLDPRT

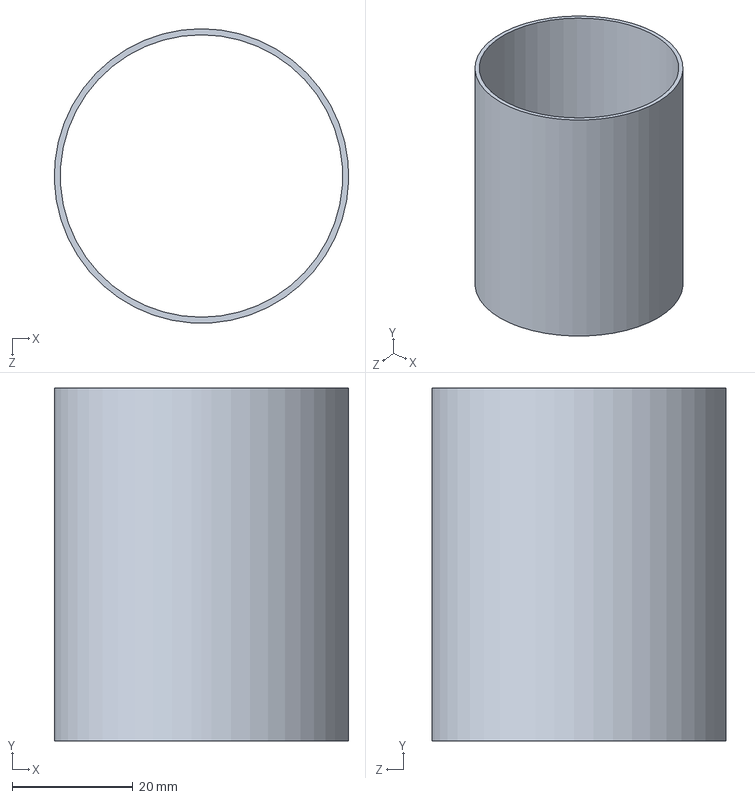
[picture p310: CAD file, 2021-06-03]
PICAP (Jim Connell)/PICAP drawings and BOM/Anti Assembly/A-A07/AL_inner_topAnti.SLDPRT
48.8 x 58.5 x 48.8 mm
