PorterMatt/CherenkovDetector/PICAP (Jim Connell)/PICAP drawings and BOM/Anti Assembly/A-A08/AL_D4_PTFE.SLDPRT

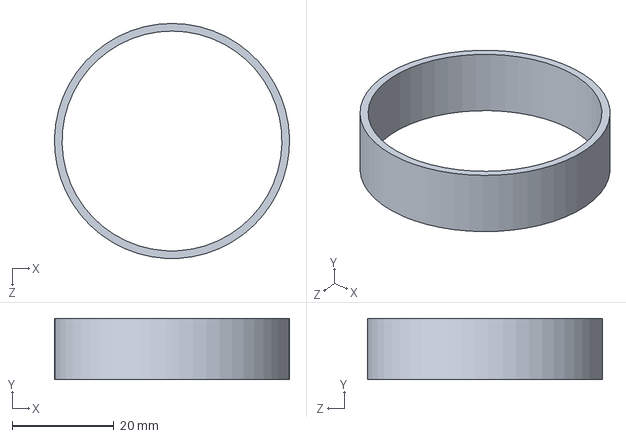
[picture p311: CAD file, 2021-06-03]
PICAP (Jim Connell)/PICAP drawings and BOM/Anti Assembly/A-A08/AL_D4_PTFE.SLDPRT
46.2 x 12.0 x 46.2 mm
