PorterMatt/CherenkovDetector/PICAP (Jim Connell)/PICAP drawings and BOM/Anti Assembly/A-A15/Bottom_Cover.SLDPRT

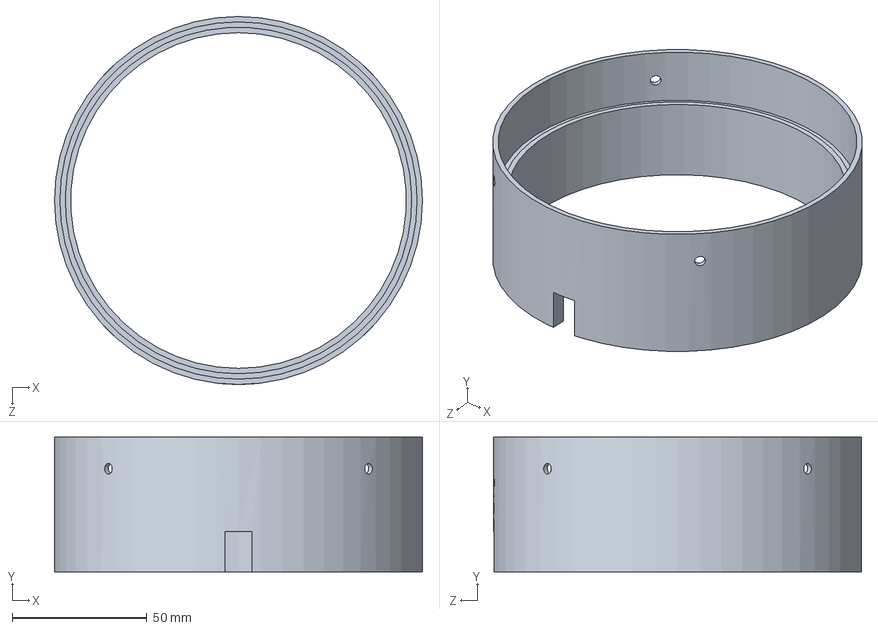
[picture p312: CAD file, 2021-06-03]
PICAP (Jim Connell)/PICAP drawings and BOM/Anti Assembly/A-A15/Bottom_Cover.SLDPRT
136.7 x 50.0 x 136.7 mm
