PorterMatt/CherenkovDetector/PICAP (Jim Connell)/PICAP drawings and BOM/Anti Assembly/A-A17/D4_bottom_plate.SLDPRT

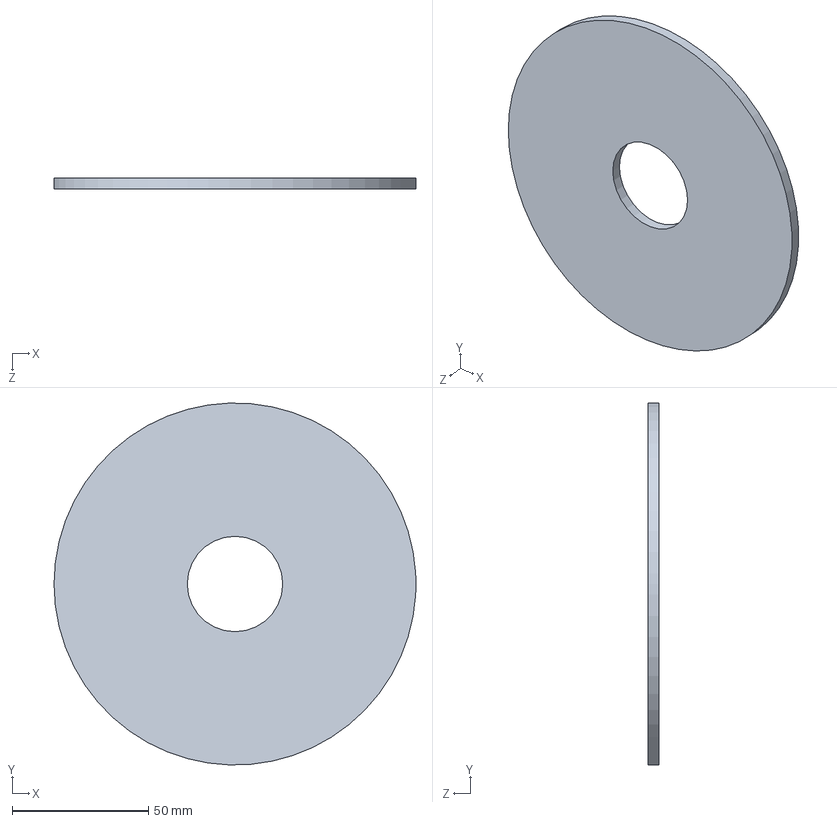
[picture p313: CAD file, 2021-06-03]
PICAP (Jim Connell)/PICAP drawings and BOM/Anti Assembly/A-A17/D4_bottom_plate.SLDPRT
132.7 x 132.7 x 4.00 mm
