PorterMatt/CherenkovDetector/PICAP (Jim Connell)/PICAP drawings and BOM/Anti Assembly/A-P03/ANTIside.SLDPRT

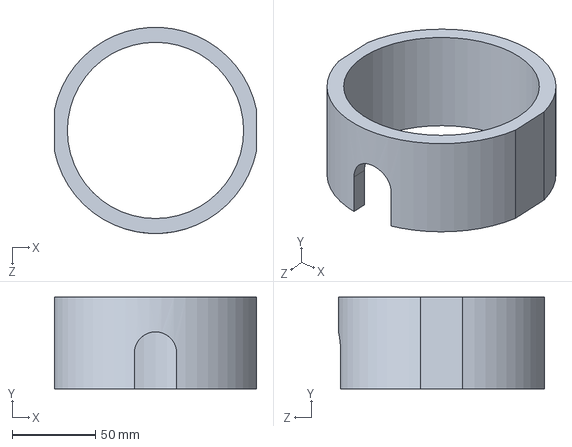
[picture p314: CAD file, 2021-06-03]
PICAP (Jim Connell)/PICAP drawings and BOM/Anti Assembly/A-P03/ANTIside.SLDPRT
121.1 x 55.0 x 123.6 mm
