PorterMatt/CherenkovDetector/PICAP (Jim Connell)/PICAP drawings and BOM/Anti Assembly/A-P04/Anti_top.SLDPRT

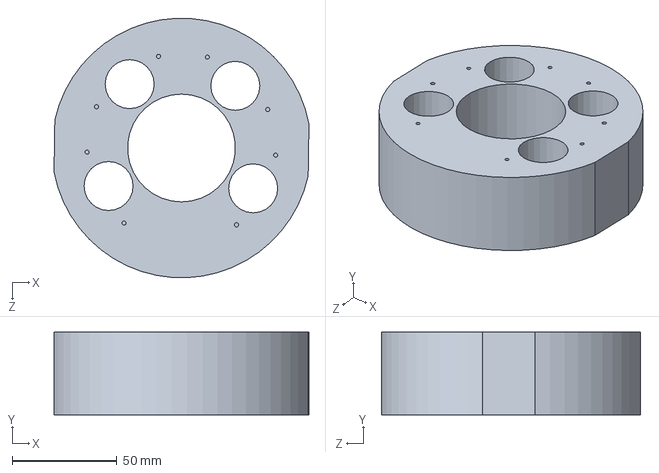
[picture p315: CAD file, 2021-06-03]
PICAP (Jim Connell)/PICAP drawings and BOM/Anti Assembly/A-P04/Anti_top.SLDPRT
121.5 x 39.5 x 123.5 mm
