PorterMatt/CherenkovDetector/PICAP (Jim Connell)/PICAP drawings and BOM/Anti Assembly/A-P12/ANTI_bottom.SLDPRT

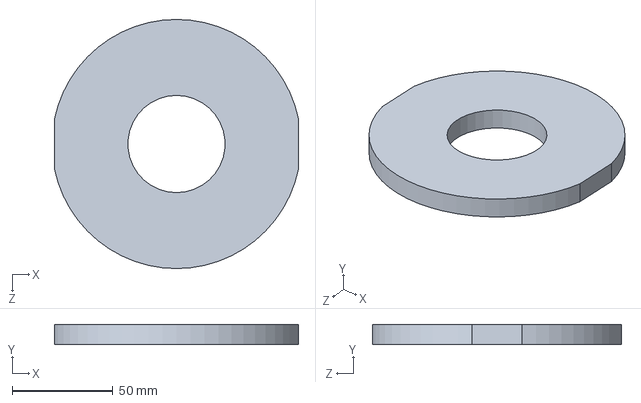
[picture p316: CAD file, 2021-06-03]
PICAP (Jim Connell)/PICAP drawings and BOM/Anti Assembly/A-P12/ANTI_bottom.SLDPRT
121.1 x 10.0 x 123.6 mm
