PorterMatt/CherenkovDetector/PICAP (Jim Connell)/PICAP drawings and BOM/Anti Assembly/A-P13/AL_D4_holder.SLDPRT

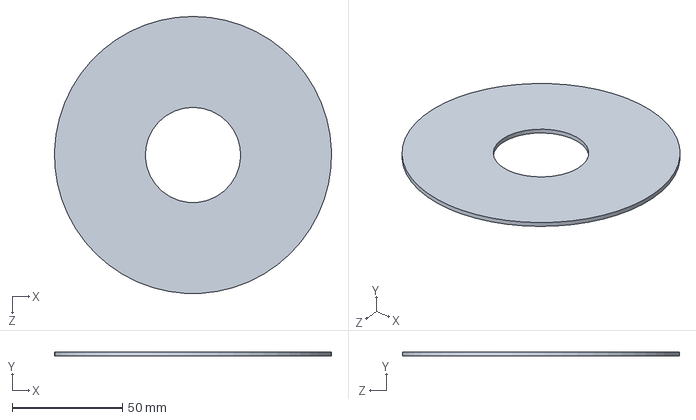
[picture p317: CAD file, 2021-06-03]
PICAP (Jim Connell)/PICAP drawings and BOM/Anti Assembly/A-P13/AL_D4_holder.SLDPRT
125.6 x 2.00 x 125.7 mm
