PorterMatt/CherenkovDetector/PICAP (Jim Connell)/PICAP drawings and BOM/Anti Assembly/A-P14/D4_holder.SLDPRT

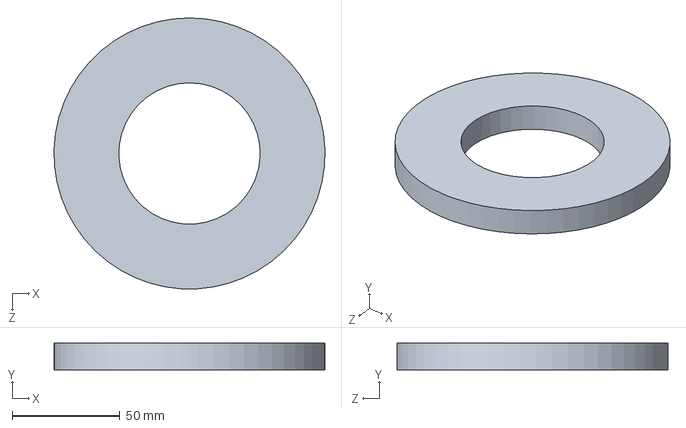
[picture p318: CAD file, 2021-06-03]
PICAP (Jim Connell)/PICAP drawings and BOM/Anti Assembly/A-P14/D4_holder.SLDPRT
125.6 x 12.3 x 125.7 mm
