PorterMatt/CherenkovDetector/PICAP (Jim Connell)/PICAP drawings and BOM/Anti Assembly/A-P16/cover place holder.SLDPRT

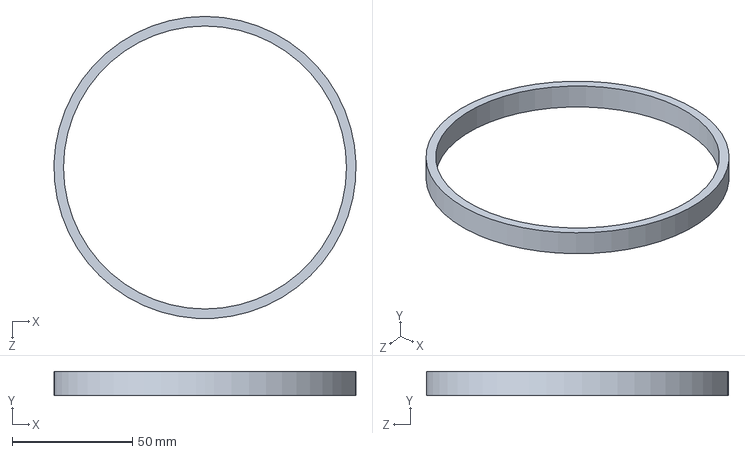
[picture p319: CAD file, 2021-06-03]
PICAP (Jim Connell)/PICAP drawings and BOM/Anti Assembly/A-P16/cover place holder.SLDPRT
125.6 x 10.0 x 125.7 mm
