PorterMatt/CherenkovDetector/PICAP (Jim Connell)/PICAP drawings and BOM/Circuit Boards/Drawings/Ciruitboar_new.DXF

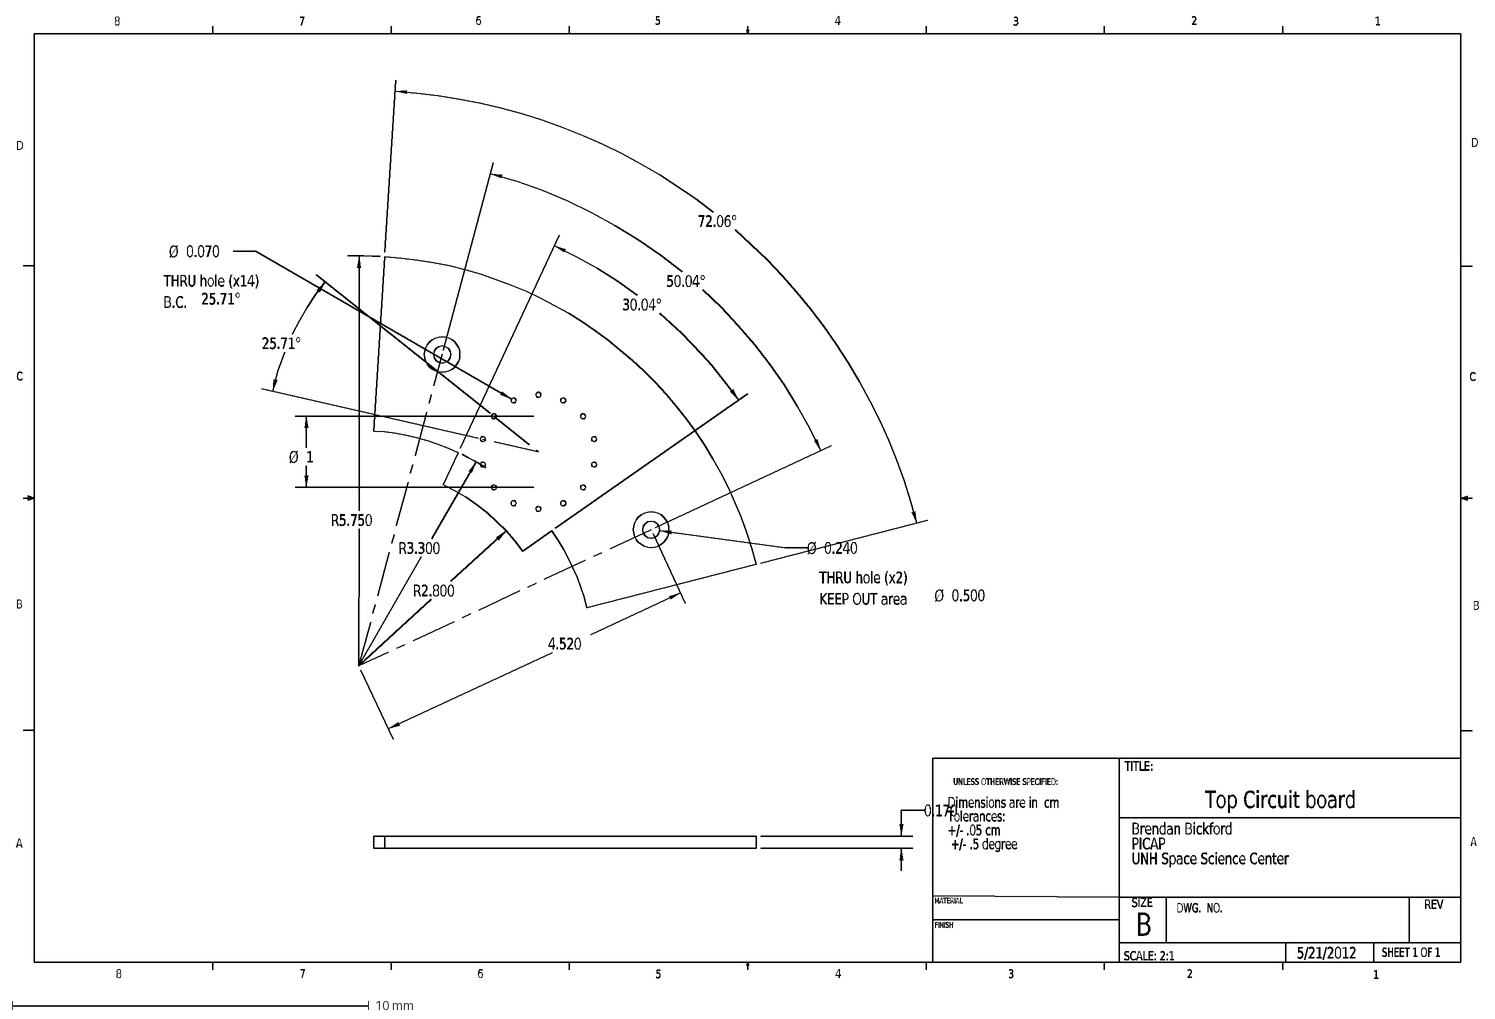
[picture p320: CAD file, 2021-06-03]
PICAP (Jim Connell)/PICAP drawings and BOM/Circuit Boards/Drawings/Ciruitboar_new.DXF
THRU hole (x2)
KEEP OUT area
Ø
0.500
Top Circuit board
THRU hole (x14)
B.C.
25.71°
D
C
B
A
1
2
3
4
5
6
7
8
MATERIAL
FINISH
TITLE:
SIZE
DWG. NO.
REV
SCALE: 2:1
SHEET 1 OF 1
Dimensions are in cm
Tolerances:
+/- .05 cm
+/- .5 degree
UNLESS OTHERWISE SPECIFIED:
5/21/2012
Brendan Bickford
PICAP
UNH Space Science Center
50.04°
4.520
R2.800
R3.300
R5.750
0.240
30.04°
72.06°
0.070
0.170
