PorterMatt/CherenkovDetector/PICAP (Jim Connell)/PICAP drawings and BOM/Cover assembly/C-A01/AL_foil cover.SLDPRT

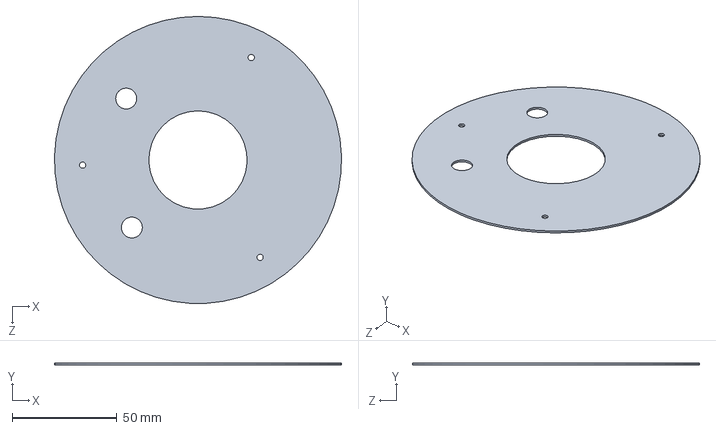
[picture p321: CAD file, 2021-06-03]
PICAP (Jim Connell)/PICAP drawings and BOM/Cover assembly/C-A01/AL_foil cover.SLDPRT
136.7 x 1.00 x 136.7 mm
