PorterMatt/CherenkovDetector/PICAP (Jim Connell)/PICAP drawings and BOM/Cover assembly/C-A02/Top_Cover.SLDPRT

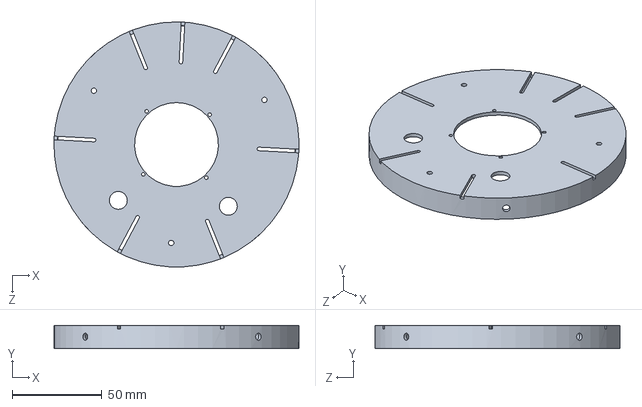
[picture p322: CAD file, 2021-06-03]
PICAP (Jim Connell)/PICAP drawings and BOM/Cover assembly/C-A02/Top_Cover.SLDPRT
136.7 x 13.0 x 136.7 mm
