PorterMatt/CherenkovDetector/PICAP (Jim Connell)/PICAP drawings and BOM/cylinder assembly/Y-A01/Cylinder2 sidemounts.SLDPRT

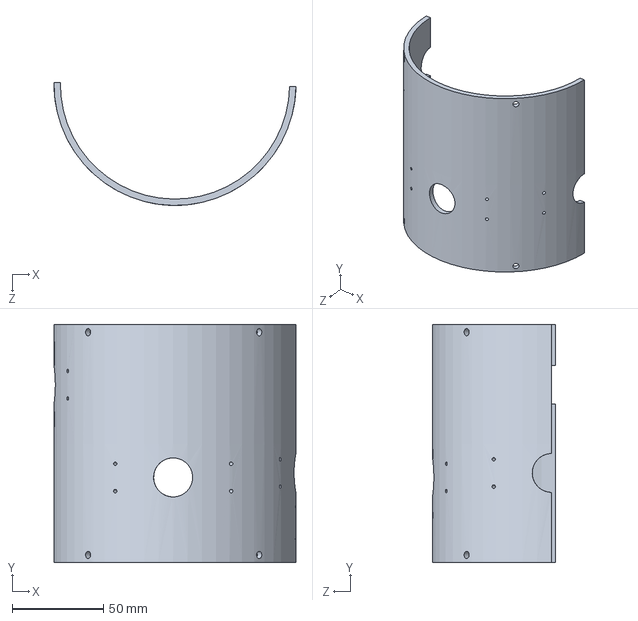
[picture p323: CAD file, 2021-06-03]
PICAP (Jim Connell)/PICAP drawings and BOM/cylinder assembly/Y-A01/Cylinder2 sidemounts.SLDPRT
132.7 x 130.8 x 67.4 mm
