PorterMatt/CherenkovDetector/PICAP (Jim Connell)/PICAP drawings and BOM/EOS drawings/Columnbase.SLDPRT

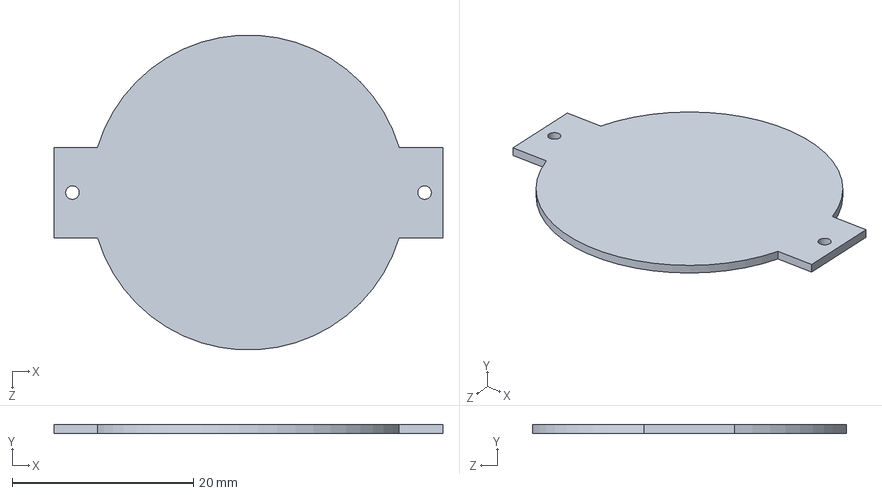
[picture p324: CAD file, 2021-06-03]
PICAP (Jim Connell)/PICAP drawings and BOM/EOS drawings/Columnbase.SLDPRT
42.9 x 1.00 x 34.7 mm
