PorterMatt/CherenkovDetector/PICAP (Jim Connell)/PICAP drawings and BOM/mushroom assembly/M-A01/plate.SLDPRT

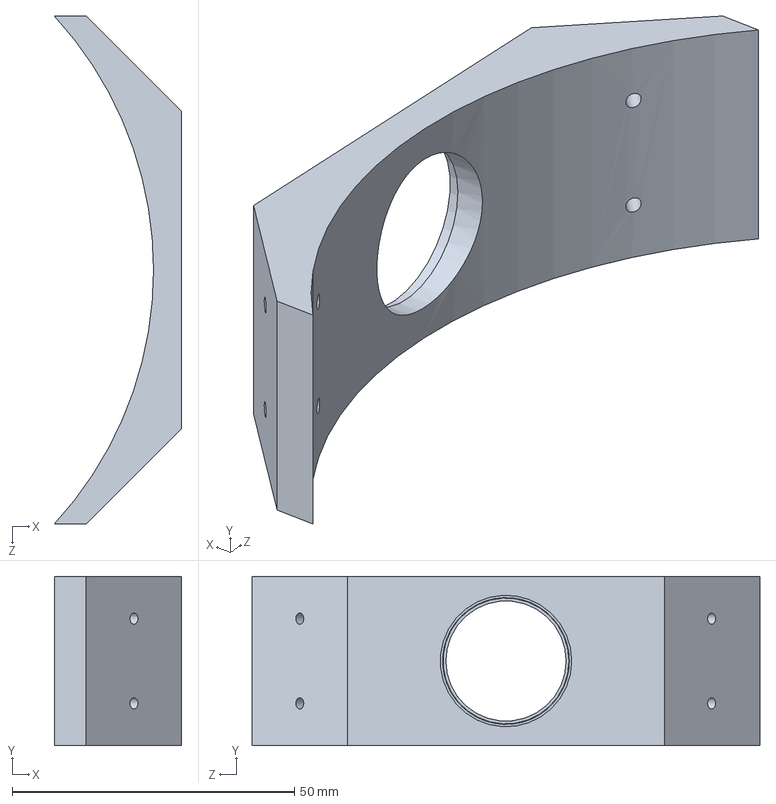
[picture p325: CAD file, 2021-06-03]
PICAP (Jim Connell)/PICAP drawings and BOM/mushroom assembly/M-A01/plate.SLDPRT
22.6 x 30.0 x 90.0 mm
