PorterMatt/CherenkovDetector/PICAP (Jim Connell)/PICAP drawings and BOM/mushroom assembly/M-A02/side pmt holder 1.SLDPRT

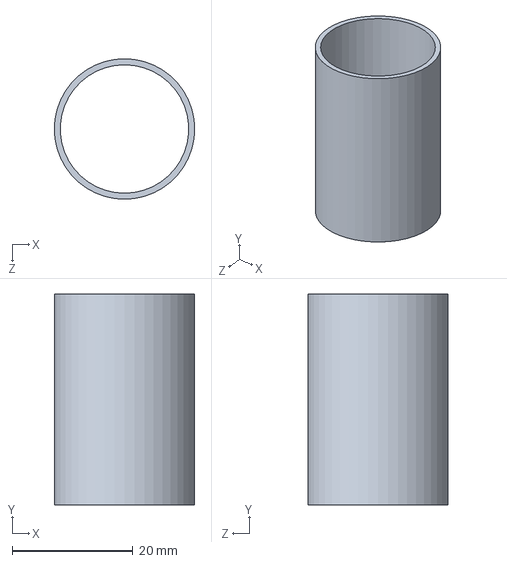
[picture p326: CAD file, 2021-06-03]
PICAP (Jim Connell)/PICAP drawings and BOM/mushroom assembly/M-A02/side pmt holder 1.SLDPRT
23.3 x 35.0 x 23.3 mm
