PorterMatt/CherenkovDetector/PICAP (Jim Connell)/PICAP drawings and BOM/mushroom assembly/M-A08/side pmt holder.SLDPRT

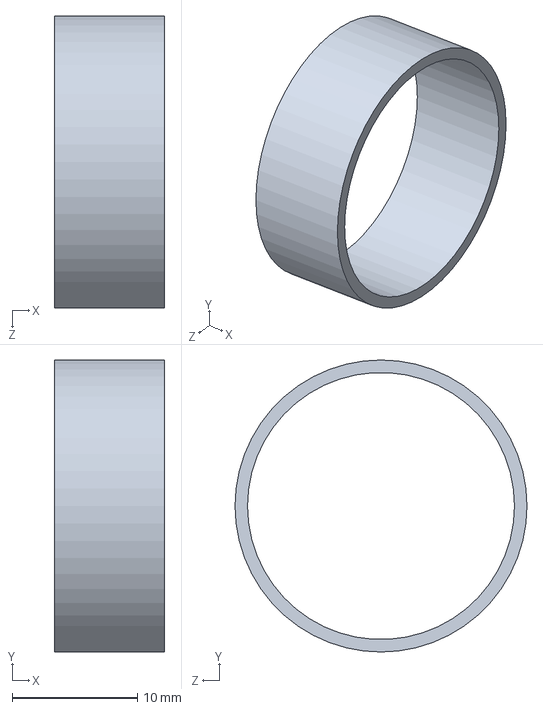
[picture p327: CAD file, 2021-06-03]
PICAP (Jim Connell)/PICAP drawings and BOM/mushroom assembly/M-A08/side pmt holder.SLDPRT
8.80 x 23.3 x 23.3 mm
