PorterMatt/CherenkovDetector/PICAP (Jim Connell)/PICAP drawings and BOM/mushroom assembly/M-A09/Wire guard.SLDPRT

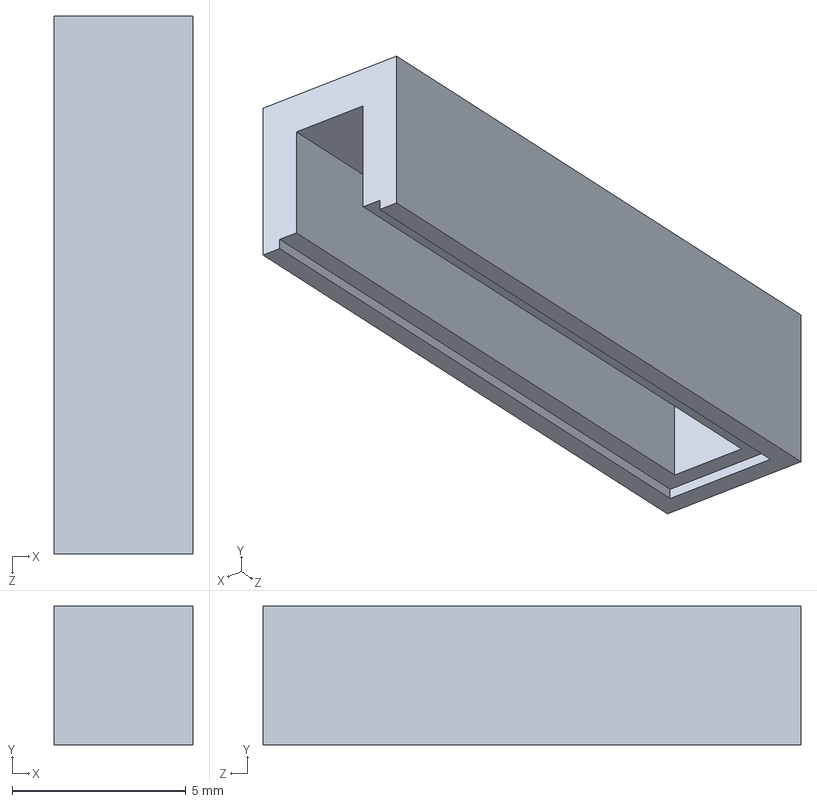
[picture p328: CAD file, 2021-06-03]
PICAP (Jim Connell)/PICAP drawings and BOM/mushroom assembly/M-A09/Wire guard.SLDPRT
4.00 x 4.00 x 15.5 mm
