PorterMatt/CherenkovDetector/PICAP (Jim Connell)/PICAP drawings and BOM/mushroom assembly/M-N06/spacer_.61.SLDPRT

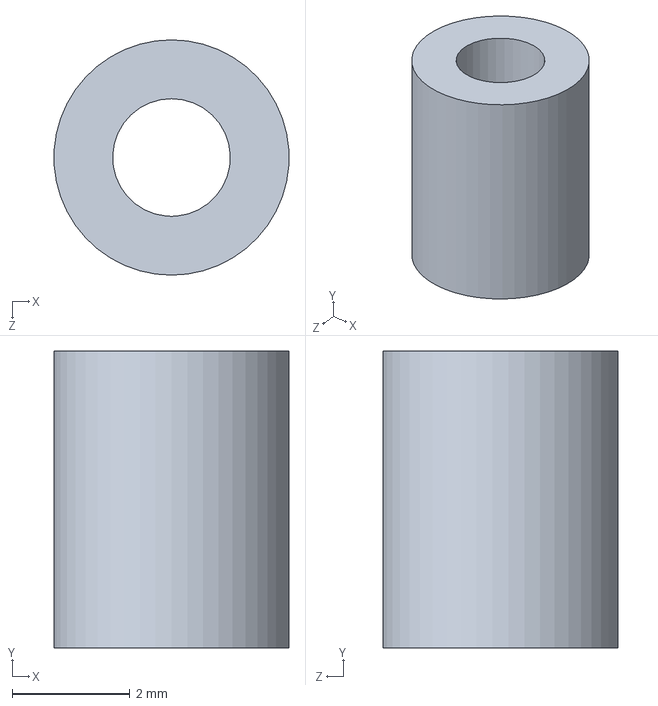
[picture p329: CAD file, 2021-06-03]
PICAP (Jim Connell)/PICAP drawings and BOM/mushroom assembly/M-N06/spacer_.61.SLDPRT
3.99 x 5.05 x 4.00 mm
