PorterMatt/CherenkovDetector/PICAP (Jim Connell)/PICAP drawings and BOM/mushroom assembly/M-N07/spacer.SLDPRT

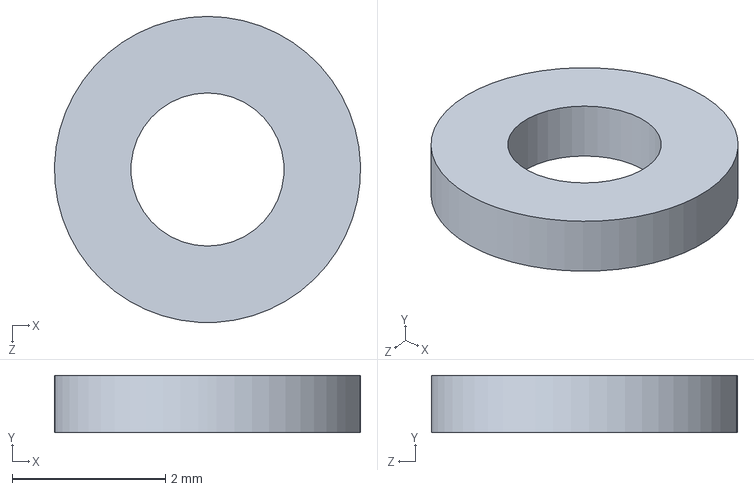
[picture p330: CAD file, 2021-06-03]
PICAP (Jim Connell)/PICAP drawings and BOM/mushroom assembly/M-N07/spacer.SLDPRT
4.00 x 0.75 x 4.00 mm
