PorterMatt/CherenkovDetector/PICAP (Jim Connell)/PICAP drawings and BOM/PTFE drawing/C out.SLDPRT

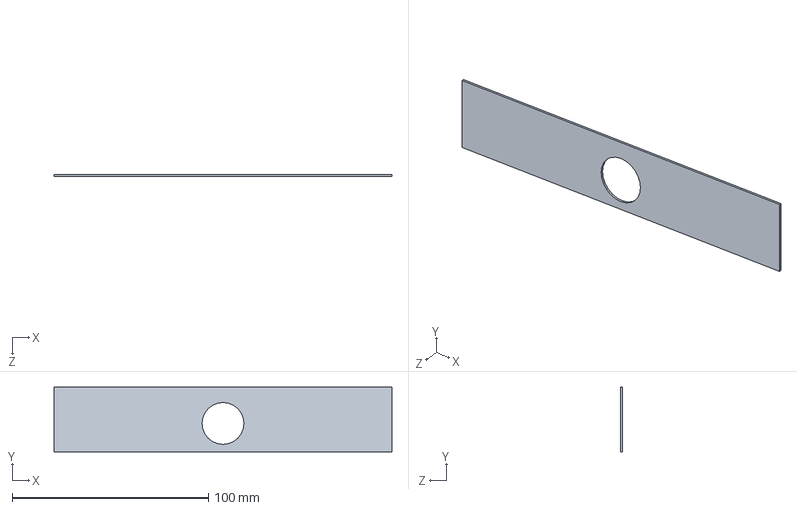
[picture p331: CAD file, 2021-06-03]
PICAP (Jim Connell)/PICAP drawings and BOM/PTFE drawing/C out.SLDPRT
172.1 x 33.0 x 1.00 mm
