PorterMatt/CherenkovDetector/PICAP (Jim Connell)/PICAP drawings and BOM/Scintillator assembly/S-A03/AL_intube.SLDPRT

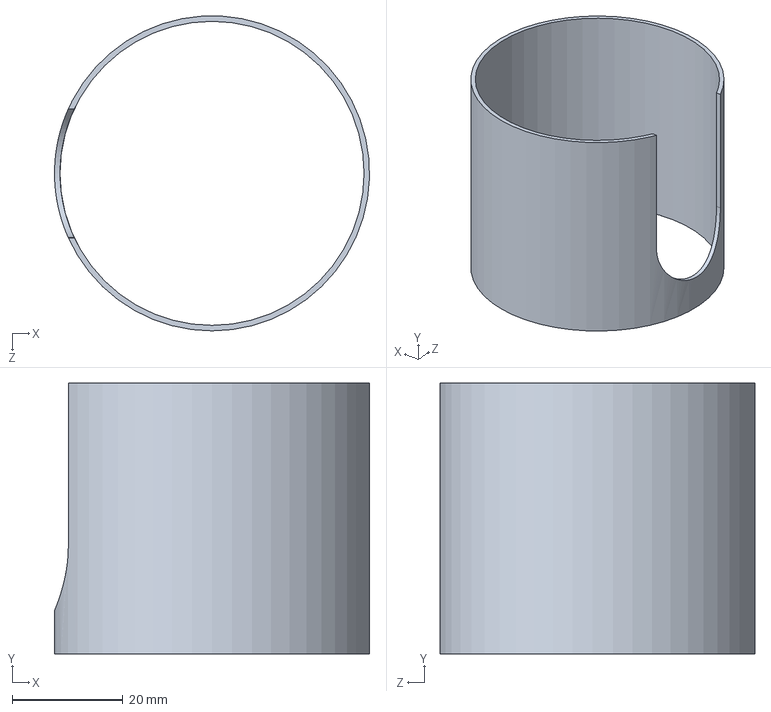
[picture p332: CAD file, 2021-06-03]
PICAP (Jim Connell)/PICAP drawings and BOM/Scintillator assembly/S-A03/AL_intube.SLDPRT
57.0 x 49.0 x 57.0 mm
