PorterMatt/CherenkovDetector/PICAP (Jim Connell)/PICAP drawings and BOM/Scintillator assembly/S-A04/AL_outter.SLDPRT

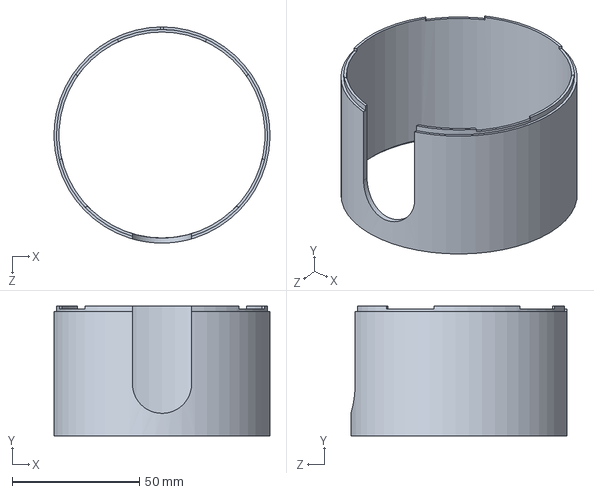
[picture p333: CAD file, 2021-06-03]
PICAP (Jim Connell)/PICAP drawings and BOM/Scintillator assembly/S-A04/AL_outter.SLDPRT
85.0 x 51.0 x 85.1 mm
