PorterMatt/CherenkovDetector/PICAP (Jim Connell)/PICAP drawings and BOM/Scintillator assembly/S-A05/AL_bottom.SLDPRT

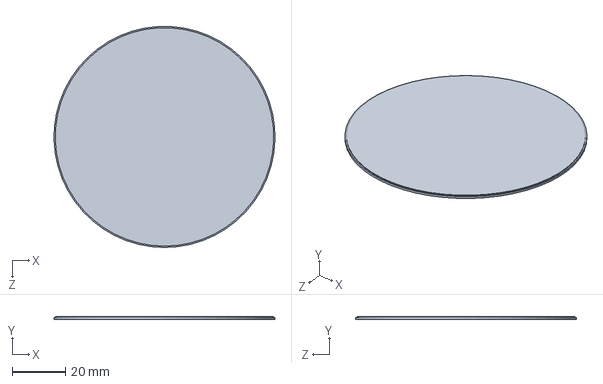
[picture p334: CAD file, 2021-06-03]
PICAP (Jim Connell)/PICAP drawings and BOM/Scintillator assembly/S-A05/AL_bottom.SLDPRT
83.1 x 1.00 x 83.0 mm
