PorterMatt/CherenkovDetector/PICAP (Jim Connell)/PICAP drawings and BOM/Scintillator assembly/S-A06/Al_pmtbase.SLDPRT

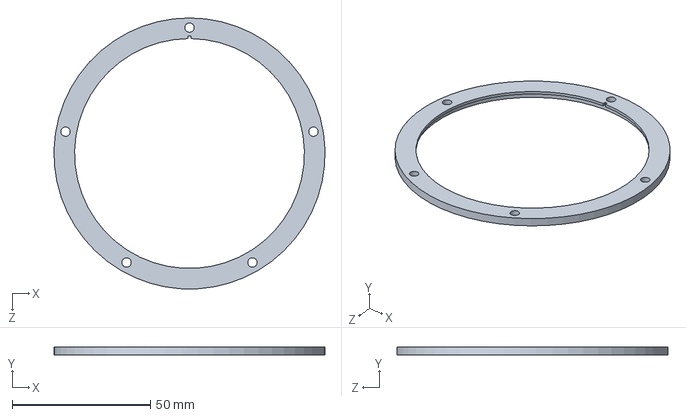
[picture p335: CAD file, 2021-06-03]
PICAP (Jim Connell)/PICAP drawings and BOM/Scintillator assembly/S-A06/Al_pmtbase.SLDPRT
98.0 x 3.00 x 98.0 mm
