PorterMatt/CherenkovDetector/PICAP (Jim Connell)/PICAP drawings and BOM/Scintillator assembly/S-A07/AL_G_cover.SLDPRT

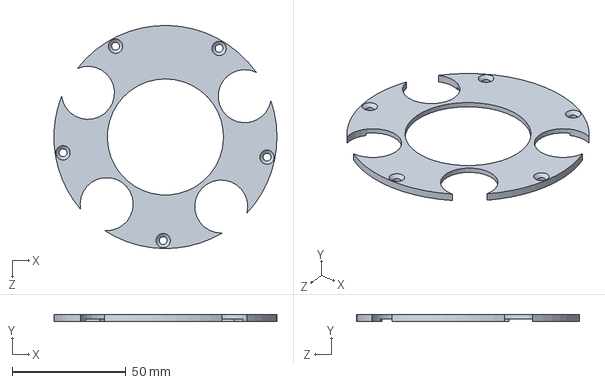
[picture p336: CAD file, 2021-06-03]
PICAP (Jim Connell)/PICAP drawings and BOM/Scintillator assembly/S-A07/AL_G_cover.SLDPRT
97.9 x 3.00 x 98.0 mm
