PorterMatt/CherenkovDetector/PICAP (Jim Connell)/PICAP drawings and BOM/Scintillator assembly/S-P02/C5.SLDPRT

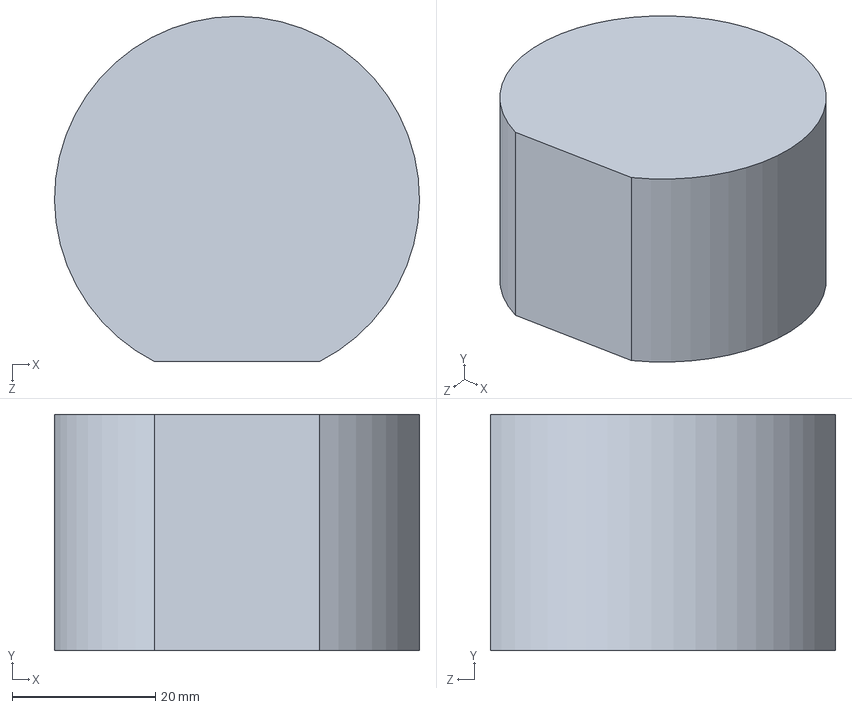
[picture p337: CAD file, 2021-06-03]
PICAP (Jim Connell)/PICAP drawings and BOM/Scintillator assembly/S-P02/C5.SLDPRT
51.0 x 33.0 x 48.2 mm
