PorterMatt/CherenkovDetector/PICAP (Jim Connell)/PICAP drawings and BOM/Scintillator assembly/S-P08/C_placeholder5.SLDPRT

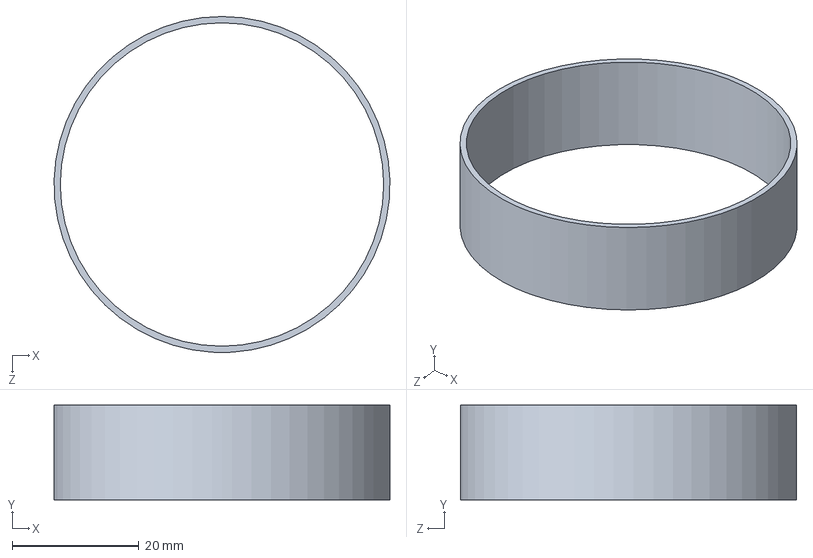
[picture p338: CAD file, 2021-06-03]
PICAP (Jim Connell)/PICAP drawings and BOM/Scintillator assembly/S-P08/C_placeholder5.SLDPRT
53.0 x 15.0 x 53.0 mm
