PorterMatt/CherenkovDetector/PICAP (Jim Connell)/PICAP drawings and BOM/Scintillator assembly/S-T11/G_PTFE_centerT.SLDPRT

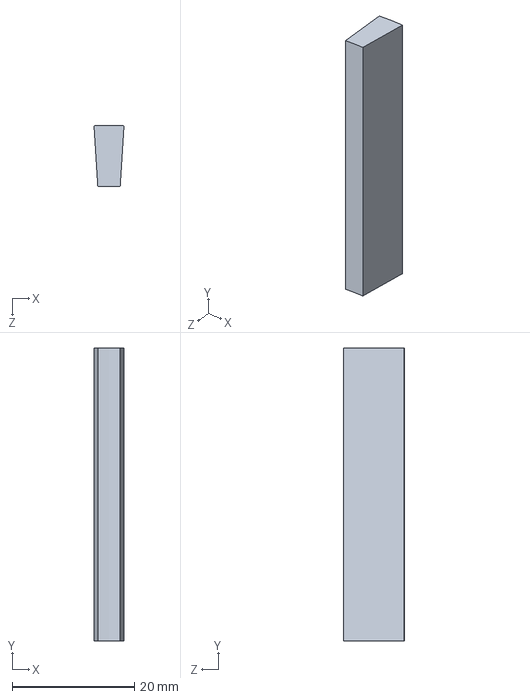
[picture p339: CAD file, 2021-06-03]
PICAP (Jim Connell)/PICAP drawings and BOM/Scintillator assembly/S-T11/G_PTFE_centerT.SLDPRT
4.92 x 48.0 x 10.1 mm
