PorterMatt/CherenkovDetector/PICAP (Jim Connell)/PICAP drawings and BOM/Scintillator assembly/S-T12/G_PTFE_centerSIDE.SLDPRT

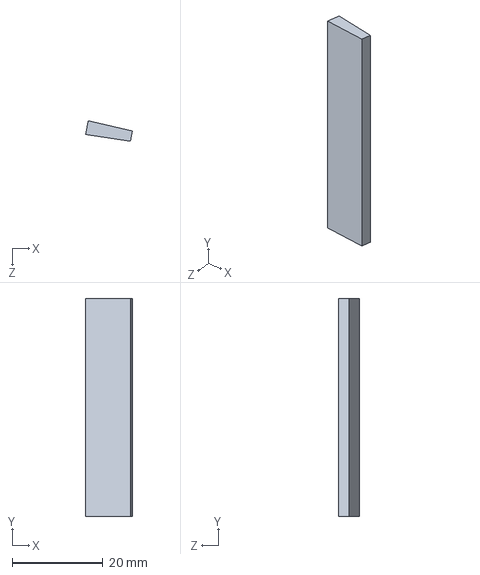
[picture p340: CAD file, 2021-06-03]
PICAP (Jim Connell)/PICAP drawings and BOM/Scintillator assembly/S-T12/G_PTFE_centerSIDE.SLDPRT
10.3 x 48.0 x 4.52 mm
