PorterMatt/CherenkovDetector/PICAP (Jim Connell)/PICAP drawings and BOM/Scintillator assembly/S-T13/G_PTFE_PMT.SLDPRT

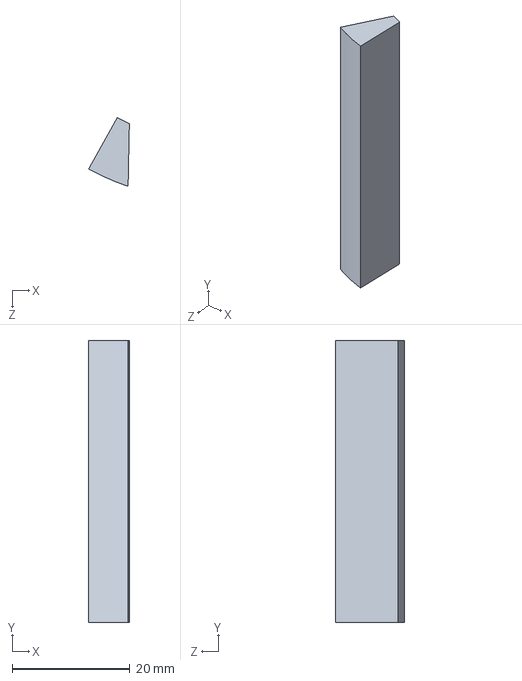
[picture p341: CAD file, 2021-06-03]
PICAP (Jim Connell)/PICAP drawings and BOM/Scintillator assembly/S-T13/G_PTFE_PMT.SLDPRT
6.93 x 48.0 x 11.7 mm
