PorterMatt/CherenkovDetector/Solidworks Assemblies/Delrin_Mount_Bottom.SLDPRT

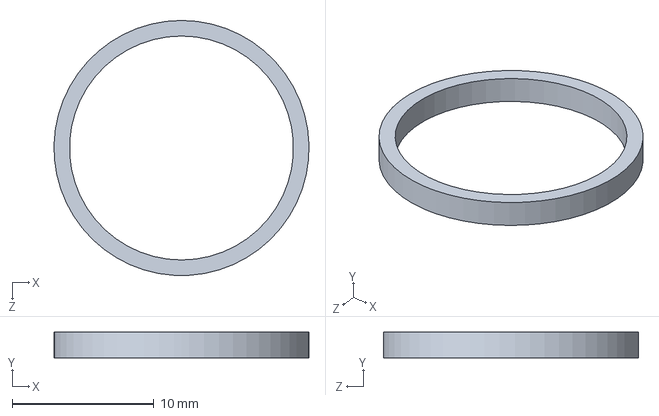
[picture p342: CAD file, 2021-12-23]
Solidworks Assemblies/Delrin_Mount_Bottom.SLDPRT
18.0 x 1.80 x 18.0 mm
