PorterMatt/CherenkovDetector/Solidworks Parts/SSD Parts/Parts/Lightbox_Cap_V3.SLDPRT

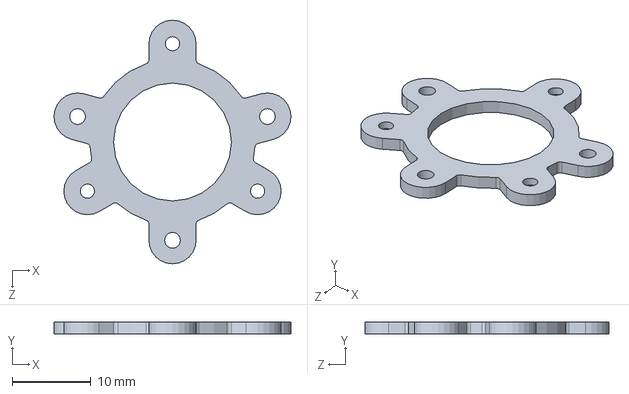
[picture p343: CAD file, 2022-01-09]
Solidworks Parts/SSD Parts/Parts/Lightbox_Cap_V3.SLDPRT
30.1 x 1.50 x 31.0 mm
