PorterMatt/CherenkovDetector/Solidworks Parts/Stack_of_Diamond.SLDPRT

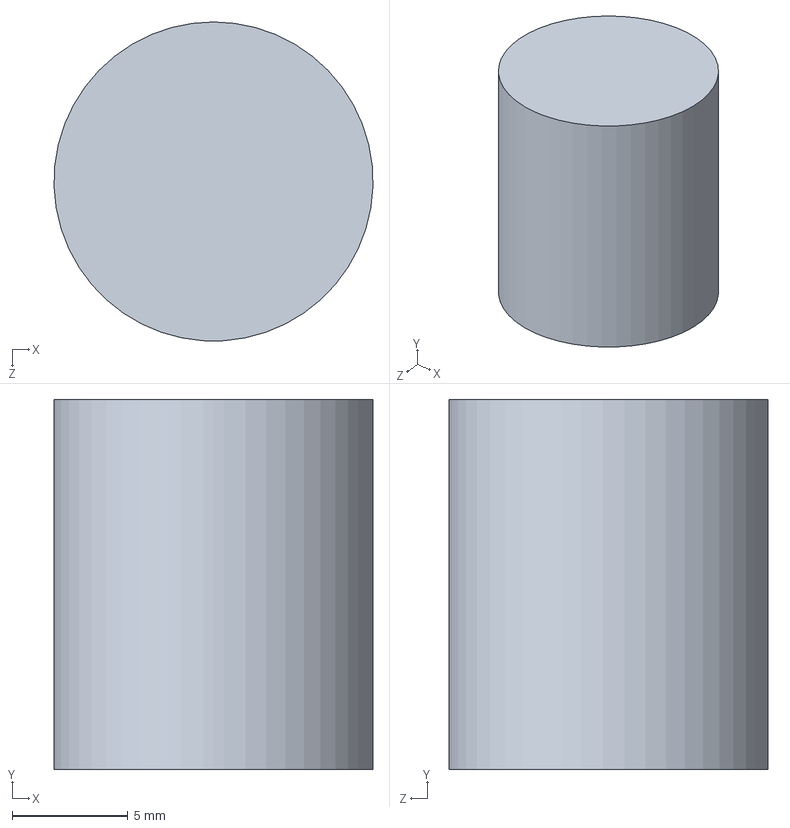
[picture p344: CAD file, 2021-11-19]
Solidworks Parts/Stack_of_Diamond.SLDPRT
13.8 x 16.0 x 13.8 mm
