PorterMatt/CherenkovDetector/Solidworks Parts/Telescope Parts/Module_1_Shell.SLDPRT

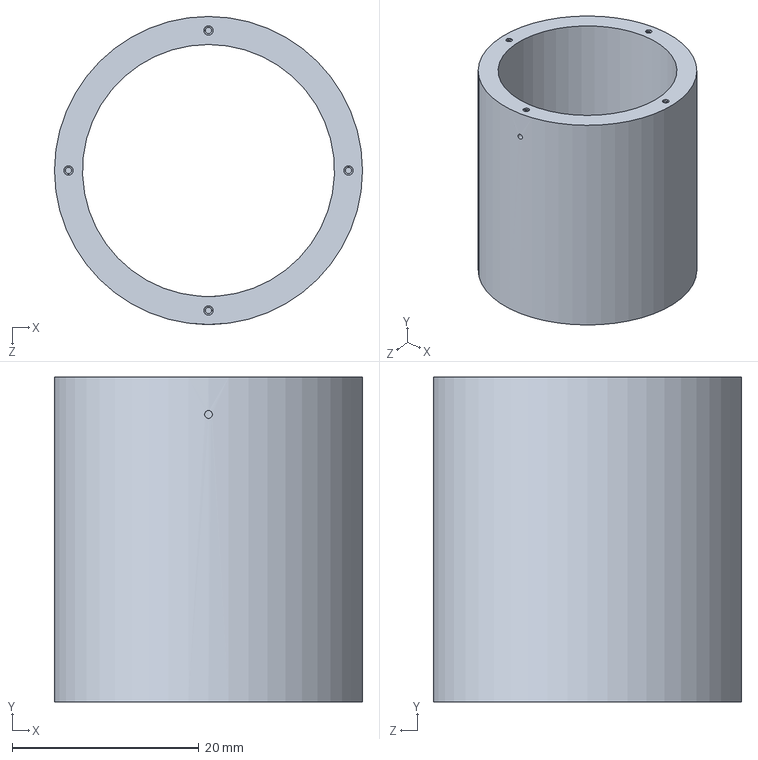
[picture p345: CAD file, 2021-05-11]
Solidworks Parts/Telescope Parts/Module_1_Shell.SLDPRT
33.0 x 34.8 x 33.0 mm
