PorterMatt/CherenkovDetector/Solidworks Parts/Telescope Unparallel Parts/Module_3_Lid_Bottom_UnParallel.SLDPRT

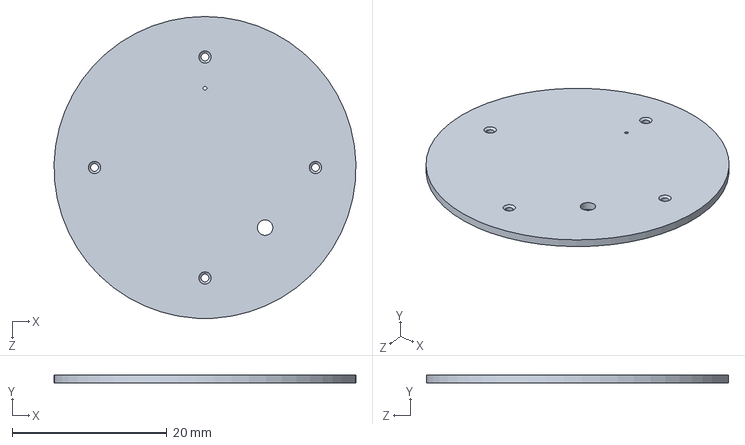
[picture p346: CAD file, 2020-10-16]
Solidworks Parts/Telescope Unparallel Parts/Module_3_Lid_Bottom_UnParallel.SLDPRT
39.0 x 1.00 x 39.1 mm
