PorterMatt/CherenkovDetector/PICAP (Jim Connell)/PICAP drawings and BOM/PTFE drawing/front pmt top.SLDPRT

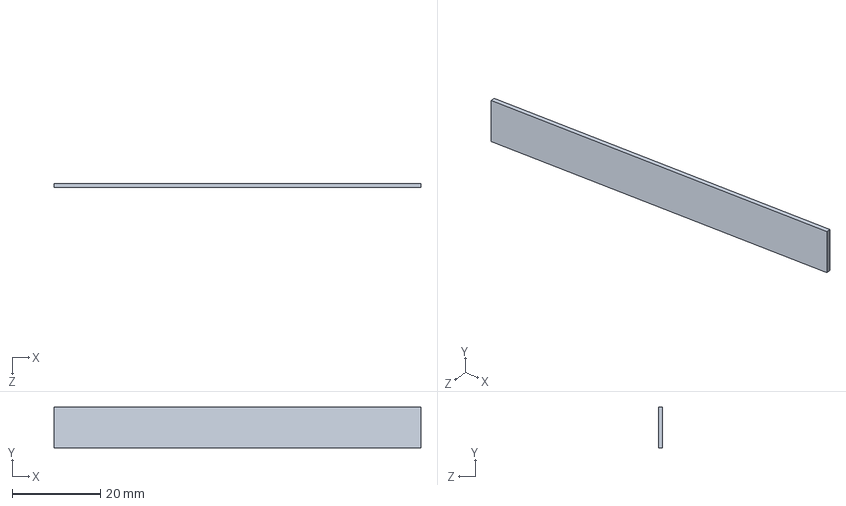
[picture p348: CAD file, 2021-06-03]
PICAP (Jim Connell)/PICAP drawings and BOM/PTFE drawing/front pmt top.SLDPRT
83.0 x 9.23 x 1.02 mm
