PorterMatt/CherenkovDetector/PICAP (Jim Connell)/PICAP solidworks/d4testholer.SLDPRT

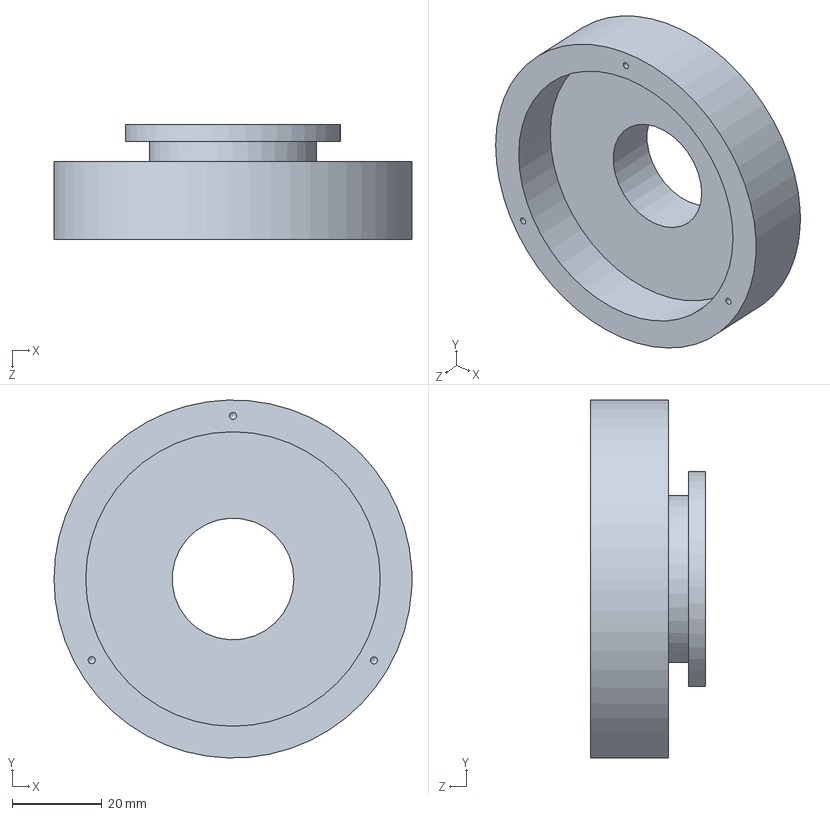
[picture p349: CAD file, 2021-06-07]
PICAP (Jim Connell)/PICAP solidworks/d4testholer.SLDPRT
80.0 x 80.0 x 25.7 mm
