PorterMatt/CherenkovDetector/Solidworks Assemblies/Teflon_Lid_Top.SLDPRT

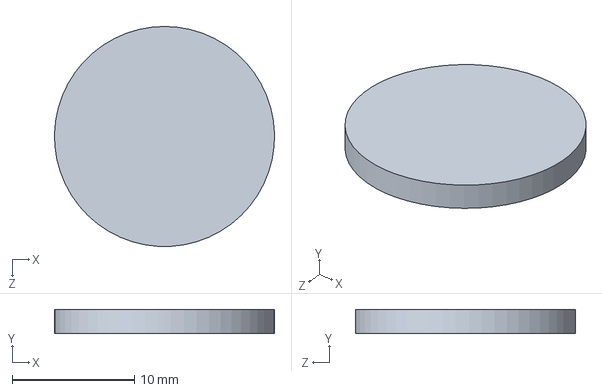
[picture p350: CAD file, 2021-11-19]
Solidworks Assemblies/Teflon_Lid_Top.SLDPRT
18.0 x 2.00 x 18.0 mm
