PorterMatt/CherenkovDetector/Solidworks Parts/PMT_R5610A_Frame.SLDPRT

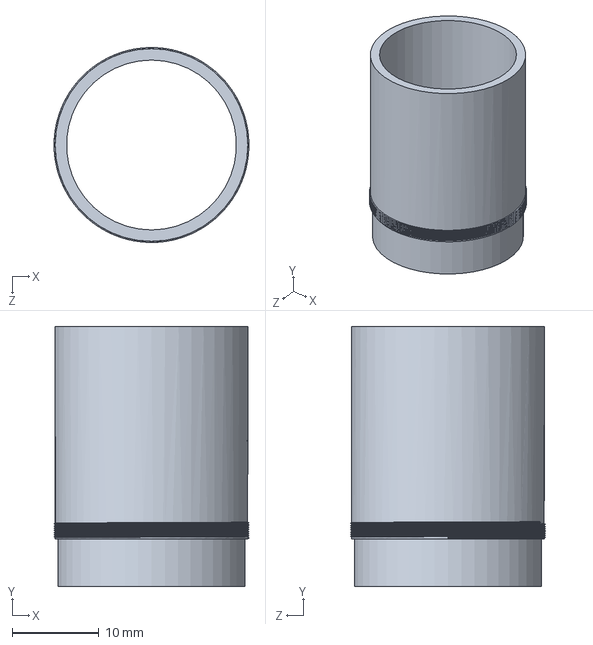
[picture p351: CAD file, 2021-03-24]
Solidworks Parts/PMT_R5610A_Frame.SLDPRT
22.5 x 30.0 x 22.5 mm
