PorterMatt/CherenkovDetector/Solidworks Parts/Telescope Parts/Telescope_Outer_Lid_Top.SLDPRT

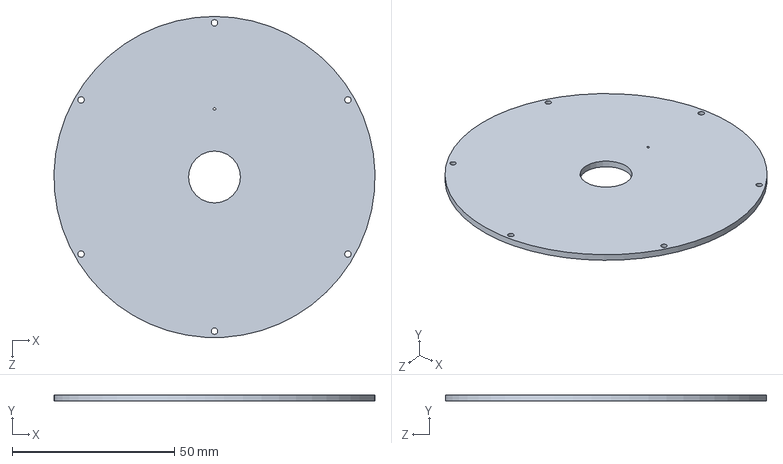
[picture p352: CAD file, 2021-05-11]
Solidworks Parts/Telescope Parts/Telescope_Outer_Lid_Top.SLDPRT
99.0 x 2.00 x 99.0 mm
