PorterMatt/CherenkovDetector/Solidworks Parts/Telescope Unparallel Parts/Telescope_Outer_Shell_UnParallel.SLDPRT

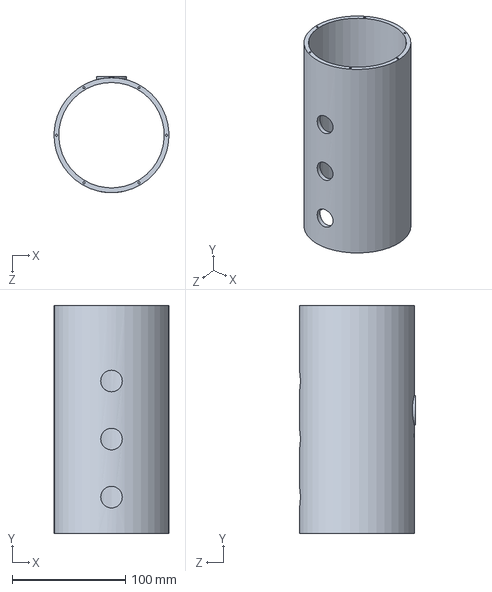
[picture p353: CAD file, 2020-10-16]
Solidworks Parts/Telescope Unparallel Parts/Telescope_Outer_Shell_UnParallel.SLDPRT
101.5 x 201.4 x 102.8 mm
