PorterMatt/CherenkovDetector/PICAP (Jim Connell)/PICAP drawings and BOM/Circuit Boards/Soildworks/leads.93.SLDPRT

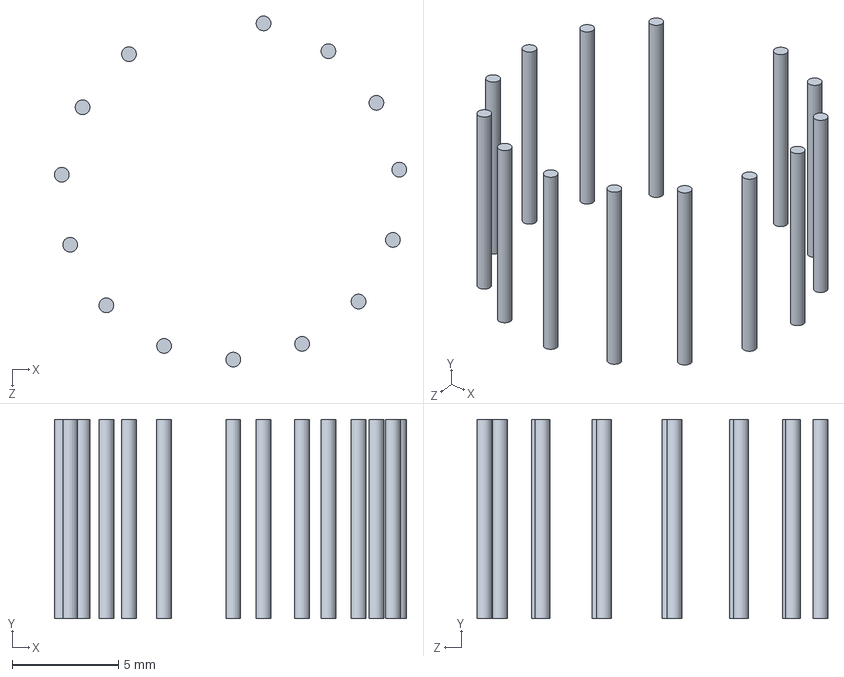
[picture p354: CAD file, 2021-06-03]
PICAP (Jim Connell)/PICAP drawings and BOM/Circuit Boards/Soildworks/leads.93.SLDPRT
16.6 x 9.40 x 16.5 mm
