PorterMatt/CherenkovDetector/PICAP (Jim Connell)/PICAP drawings and BOM/EOS drawings/columnsTest.SLDPRT

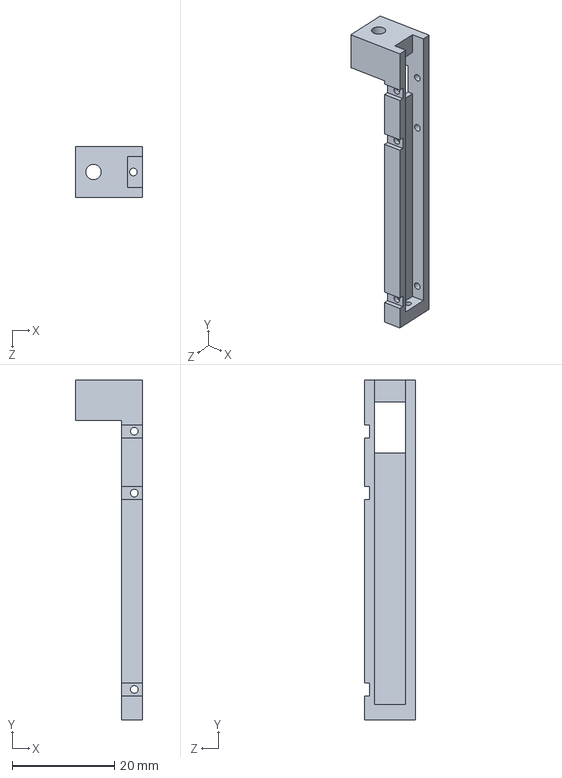
[picture p355: CAD file, 2021-06-03]
PICAP (Jim Connell)/PICAP drawings and BOM/EOS drawings/columnsTest.SLDPRT
13.1 x 66.5 x 10.0 mm
