PorterMatt/CherenkovDetector/PICAP (Jim Connell)/PICAP drawings and BOM/PTFE drawing/anti top in.SLDPRT

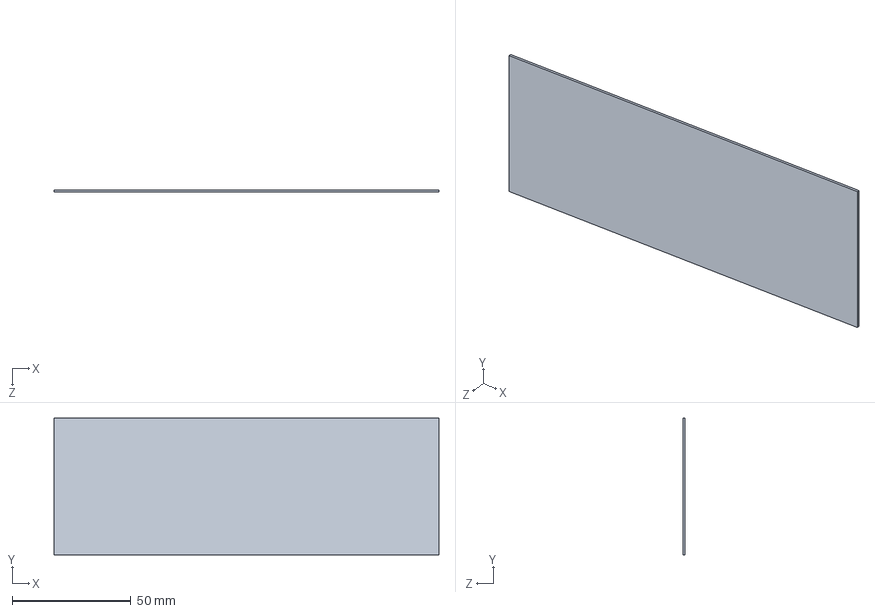
[picture p356: CAD file, 2021-06-03]
PICAP (Jim Connell)/PICAP drawings and BOM/PTFE drawing/anti top in.SLDPRT
162.0 x 57.5 x 1.00 mm
