PorterMatt/CherenkovDetector/PICAP (Jim Connell)/PICAP solidworks/SSDholder.SLDPRT

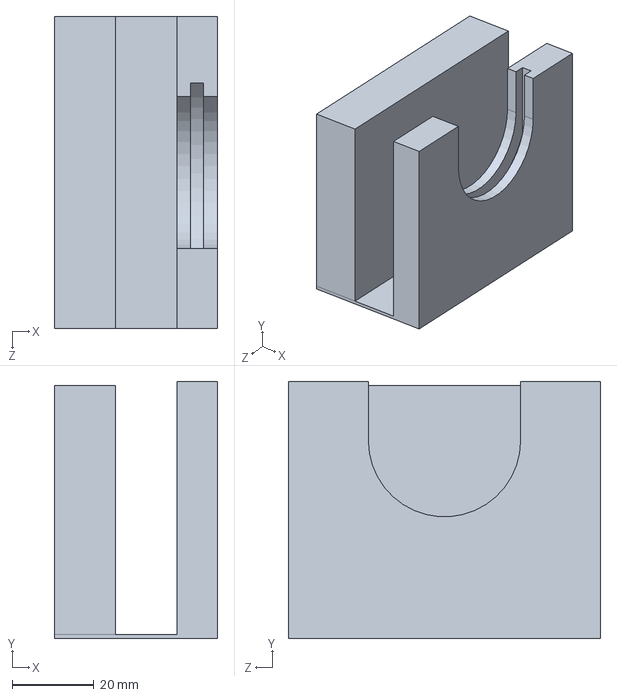
[picture p357: CAD file, 2021-06-07]
PICAP (Jim Connell)/PICAP solidworks/SSDholder.SLDPRT
40.0 x 63.0 x 76.5 mm
