PorterMatt/CherenkovDetector/Solidworks Parts/Source_2.SLDPRT

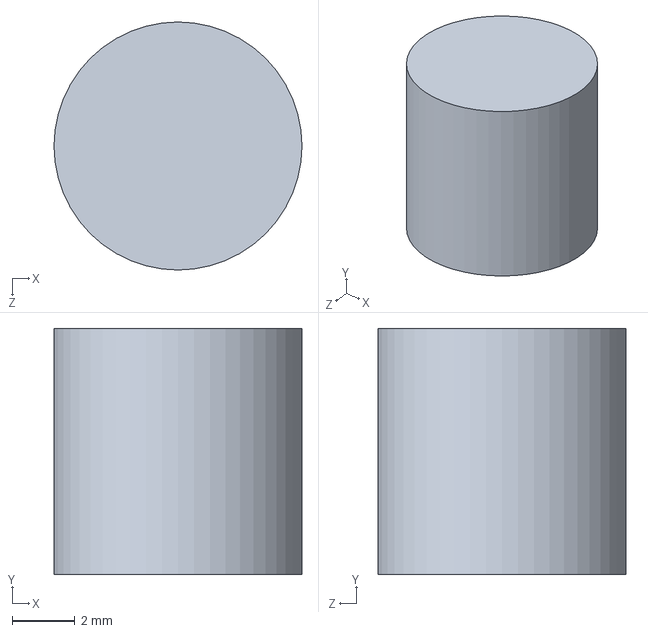
[picture p358: CAD file, 2021-01-11]
Solidworks Parts/Source_2.SLDPRT
7.87 x 7.82 x 7.87 mm
