PorterMatt/CherenkovDetector/Solidworks Parts/SSD Parts/Parts/Scintillator_TopInner.SLDPRT

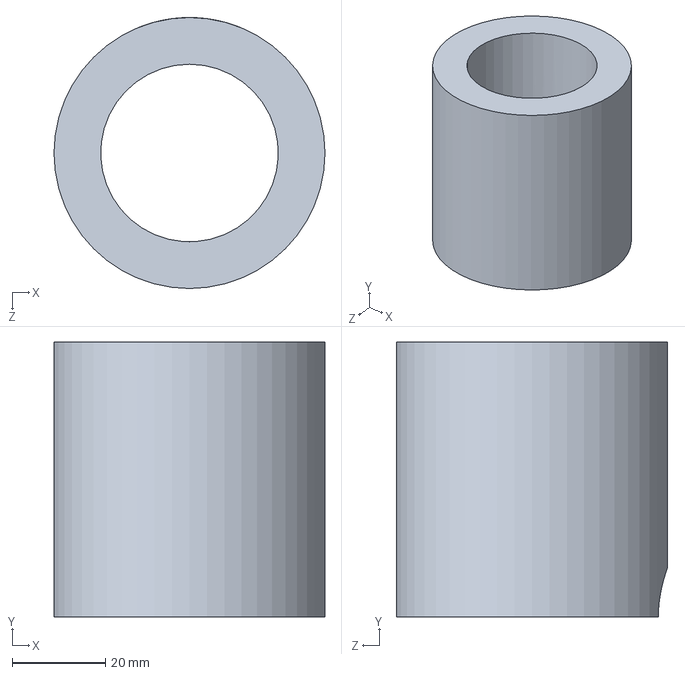
[picture p359: CAD file, 2022-01-09]
Solidworks Parts/SSD Parts/Parts/Scintillator_TopInner.SLDPRT
58.0 x 58.8 x 58.0 mm
