PorterMatt/CherenkovDetector/Solidworks Parts/Telescope Parts/Module_Plastic_Base_Nitrogen_and_Wire.SLDPRT

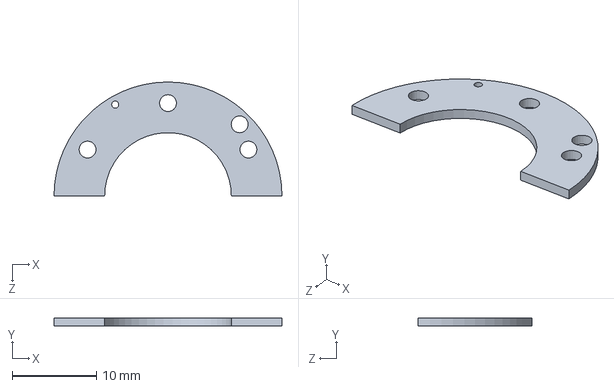
[picture p360: CAD file, 2021-05-11]
Solidworks Parts/Telescope Parts/Module_Plastic_Base_Nitrogen_and_Wire.SLDPRT
27.0 x 1.00 x 13.5 mm
