PorterMatt/CherenkovDetector/Solidworks Parts/Telescope Unparallel Parts/Teflon_Anti_PMT_Gap_Fill_UnParallel.SLDPRT

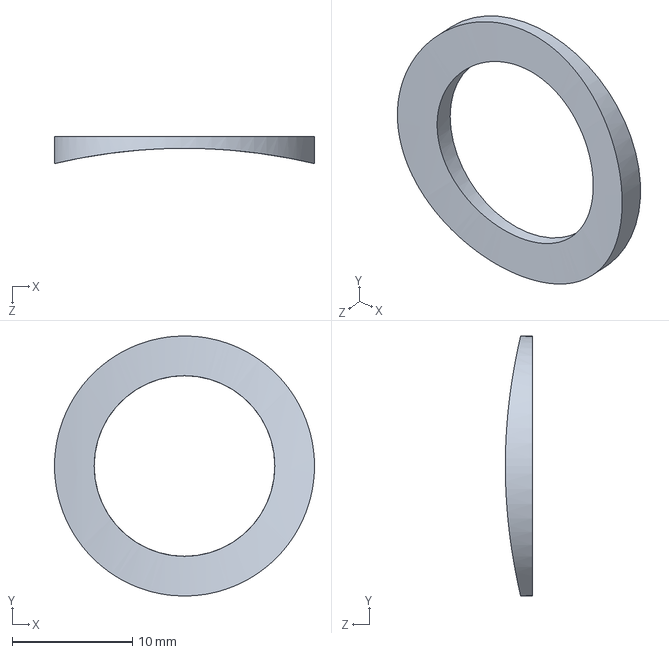
[picture p361: CAD file, 2020-10-16]
Solidworks Parts/Telescope Unparallel Parts/Teflon_Anti_PMT_Gap_Fill_UnParallel.SLDPRT
21.6 x 21.6 x 2.27 mm
