PorterMatt/CherenkovDetector/PICAP (Jim Connell)/PICAP drawings and BOM/PTFE drawing/Front PMT bottom.SLDPRT

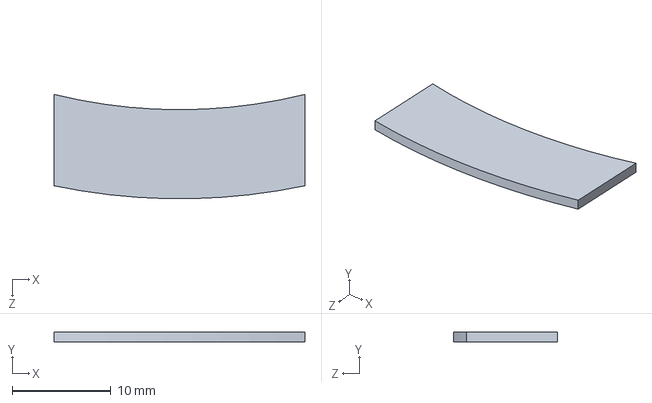
[picture p362: CAD file, 2021-06-03]
PICAP (Jim Connell)/PICAP drawings and BOM/PTFE drawing/Front PMT bottom.SLDPRT
25.4 x 1.02 x 10.5 mm
