PorterMatt/CherenkovDetector/PICAP (Jim Connell)/PICAP solidworks/D4slider.SLDPRT

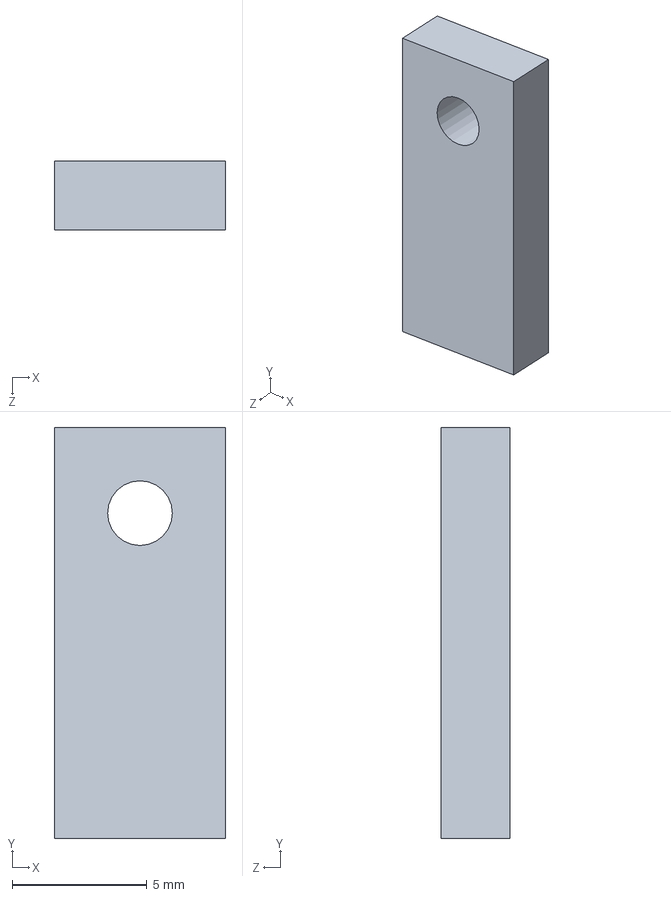
[picture p363: CAD file, 2021-06-07]
PICAP (Jim Connell)/PICAP solidworks/D4slider.SLDPRT
6.35 x 15.2 x 2.54 mm
