PorterMatt/CherenkovDetector/(list of files, cad)

Other CAD files:
PICAP (Jim Connell)/PICAP solidworks/Revised Mushroom assembly drawings/side pmt mount full revised.SLDPRT
PICAP (Jim Connell)/PICAP solidworks/side pmt tube full.SLDPRT
Solidworks Assemblies/Telescope Assembly Parallel/PMT_Assembly_Anti.SLDASM
Solidworks Assemblies/Lightbox_1_Assembly.SLDASM
Solidworks Assemblies/Telescope Assembly Parallel/Telescope_w_Base.SLDASM
Solidworks Parts/SSD Parts/Assemblies/SSD_Stack_Alternate_Assembly.SLDASM
Solidworks Assemblies/Lightbox_Main_Housing_Telescope.SLDPRT
Solidworks Parts/SSD Parts/Parts/Lightbox_MainHousing_TestVersion3.SLDPRT
PICAP (Jim Connell)/PICAP solidworks/side pmt cover full.SLDPRT
PICAP (Jim Connell)/PICAP solidworks/Columnassembly'.SLDASM
PICAP (Jim Connell)/PICAP solidworks/Ciruit assembly 3.SLDPRT.SLDASM
PICAP (Jim Connell)/PICAP solidworks/side pmt mount full.SLDPRT
PICAP (Jim Connell)/PICAP solidworks/Assem1.SLDASM
PICAP (Jim Connell)/PICAP solidworks/Ciruit assembly 2.SLDPRT.SLDASM
PICAP (Jim Connell)/PICAP drawings and BOM/cylinder assembly/Y-A02/Cylinder1 side mounts.SLDPRT
PICAP (Jim Connell)/PICAP drawings and BOM/EOS drawings/cover ring 2.SLDPRT
PICAP (Jim Connell)/PICAP solidworks/Revised Mushroom assembly drawings/plate revised.SLDPRT
Solidworks Assemblies/Teflon_Bottom_Flat.SLDPRT
PICAP (Jim Connell)/PICAP Documents/BredanShopwork/D4 test assembly/D4slider.SLDDRW
PICAP (Jim Connell)/PICAP Documents/BredanShopwork/D4 test assembly/D4spaceerplate.SLDDRW
PICAP (Jim Connell)/PICAP Documents/BredanShopwork/D4 test assembly/Part1.SLDDRW
PICAP (Jim Connell)/PICAP Documents/BredanShopwork/D4 test assembly/d4testholer.SLDDRW
PICAP (Jim Connell)/PICAP drawings and BOM/Anti Assembly/A-A01/Inner bottom tube.SLDDRW
PICAP (Jim Connell)/PICAP drawings and BOM/Anti Assembly/A-A07/Inner top tube.SLDDRW
PICAP (Jim Connell)/PICAP drawings and BOM/Anti Assembly/A-A08/D4 Aluminum Cylinder.SLDDRW
PICAP (Jim Connell)/PICAP drawings and BOM/Anti Assembly/A-A15/BASE.SLDDRW
PICAP (Jim Connell)/PICAP drawings and BOM/Anti Assembly/A-A17/Bottom Plate.SLDDRW
PICAP (Jim Connell)/PICAP drawings and BOM/Anti Assembly/A-P03/Anti Side.SLDDRW
PICAP (Jim Connell)/PICAP drawings and BOM/Anti Assembly/A-P04/Anti Top.SLDDRW
PICAP (Jim Connell)/PICAP drawings and BOM/Anti Assembly/A-P12/Anti Bottom.SLDDRW
PICAP (Jim Connell)/PICAP drawings and BOM/Anti Assembly/A-P13/D4 Plate.SLDDRW
PICAP (Jim Connell)/PICAP drawings and BOM/Anti Assembly/A-P14/Support ring.SLDDRW
PICAP (Jim Connell)/PICAP drawings and BOM/Anti Assembly/A-P16/cover place holder.SLDDRW
PICAP (Jim Connell)/PICAP drawings and BOM/Anti Assembly/Base assembly check.SLDDRW
PICAP (Jim Connell)/PICAP drawings and BOM/Circuit Boards/Drawings/Ciruitboar_new.SLDDRW
PICAP (Jim Connell)/PICAP drawings and BOM/Circuit Boards/Drawings/xy/Side board xy.SLDDRW
PICAP (Jim Connell)/PICAP drawings and BOM/Circuit Boards/Drawings/xy/Top board xy.SLDDRW
PICAP (Jim Connell)/PICAP drawings and BOM/Circuit Boards/Drawings/xy/side cir boards 2.SLDDRW
PICAP (Jim Connell)/PICAP drawings and BOM/Circuit Boards/Soildworks/Topboard.SLDDRW
PICAP (Jim Connell)/PICAP drawings and BOM/Circuit Boards/Soildworks/leads.98.SLDPRT
PICAP (Jim Connell)/PICAP drawings and BOM/Circuit Boards/Soildworks/side cir boards 2.SLDDRW
PICAP (Jim Connell)/PICAP drawings and BOM/Cover assembly/C-A01/Top plate.SLDDRW
PICAP (Jim Connell)/PICAP drawings and BOM/Cover assembly/C-A02/Cover.SLDDRW
PICAP (Jim Connell)/PICAP drawings and BOM/EOS drawings/Al-ring.SLDDRW
PICAP (Jim Connell)/PICAP drawings and BOM/EOS drawings/Column base.SLDDRW
PICAP (Jim Connell)/PICAP drawings and BOM/EOS drawings/columns.SLDDRW
PICAP (Jim Connell)/PICAP drawings and BOM/PICAP board Drawings/Front board.SLDDRW
PICAP (Jim Connell)/PICAP drawings and BOM/PICAP board Drawings/Side board revised.SLDDRW
PICAP (Jim Connell)/PICAP drawings and BOM/PICAP board Drawings/Side board.SLDDRW
PICAP (Jim Connell)/PICAP drawings and BOM/PICAP board Drawings/Top board revised.SLDDRW
PICAP (Jim Connell)/PICAP drawings and BOM/PICAP board Drawings/Top board.SLDDRW
PICAP (Jim Connell)/PICAP drawings and BOM/PTFE drawing/Anti Out.SLDPRT
PICAP (Jim Connell)/PICAP drawings and BOM/PTFE drawing/Bottom Anti in.SLDPRT
PICAP (Jim Connell)/PICAP drawings and BOM/PTFE drawing/G in.SLDPRT
PICAP (Jim Connell)/PICAP drawings and BOM/PTFE drawing/G out.SLDPRT
PICAP (Jim Connell)/PICAP drawings and BOM/PTFE drawing/PMT ptfe.SLDPRT
PICAP (Jim Connell)/PICAP drawings and BOM/PTFE drawing/Side anti in.SLDPRT
PICAP (Jim Connell)/PICAP drawings and BOM/PTFE drawing/drawings/CNC/Anti Out.SLDDRW
PICAP (Jim Connell)/PICAP drawings and BOM/PTFE drawing/drawings/CNC/Bottom Anti in.SLDDRW
PICAP (Jim Connell)/PICAP drawings and BOM/PTFE drawing/drawings/CNC/C out.SLDDRW
PICAP (Jim Connell)/PICAP drawings and BOM/PTFE drawing/drawings/CNC/Side anti in.SLDDRW
PICAP (Jim Connell)/PICAP drawings and BOM/PTFE drawing/drawings/CNC/done/Bottom anti bottom.SLDDRW
PICAP (Jim Connell)/PICAP drawings and BOM/PTFE drawing/drawings/CNC/done/C top and Bottom.SLDDRW
PICAP (Jim Connell)/PICAP drawings and BOM/PTFE drawing/drawings/CNC/done/Front PMT bottom.SLDDRW
PICAP (Jim Connell)/PICAP drawings and BOM/PTFE drawing/drawings/CNC/done/G bottom.SLDDRW
PICAP (Jim Connell)/PICAP drawings and BOM/PTFE drawing/drawings/CNC/done/G top.SLDDRW
PICAP (Jim Connell)/PICAP drawings and BOM/PTFE drawing/drawings/CNC/done/Side anti bottom.SLDDRW
PICAP (Jim Connell)/PICAP drawings and BOM/PTFE drawing/drawings/CNC/done/Top Anti Top.SLDDRW
PICAP (Jim Connell)/PICAP drawings and BOM/PTFE drawing/drawings/CNC/done/Top anti bottom.SLDDRW
PICAP (Jim Connell)/PICAP drawings and BOM/PTFE drawing/drawings/CNC/done/front pmt top.SLDDRW
PICAP (Jim Connell)/PICAP drawings and BOM/PTFE drawing/drawings/Done/G in.SLDDRW
PICAP (Jim Connell)/PICAP drawings and BOM/PTFE drawing/drawings/Done/G out.SLDDRW
PICAP (Jim Connell)/PICAP drawings and BOM/PTFE drawing/drawings/Done/PMT ptfe.SLDDRW
PICAP (Jim Connell)/PICAP drawings and BOM/PTFE drawing/drawings/Done/anti top in.SLDDRW
PICAP (Jim Connell)/PICAP drawings and BOM/PTFE drawing/inch/G out.SLDDRW
PICAP (Jim Connell)/PICAP drawings and BOM/PTFE drawing/inch/anti top in.SLDDRW
PICAP (Jim Connell)/PICAP drawings and BOM/Rotator assembly/AmpColumn.SLDDRW
PICAP (Jim Connell)/PICAP drawings and BOM/Rotator assembly/Place column Back.SLDDRW
PICAP (Jim Connell)/PICAP drawings and BOM/Rotator assembly/Place column front.SLDDRW
PICAP (Jim Connell)/PICAP drawings and BOM/Rotator assembly/TopBar.SLDDRW
PICAP (Jim Connell)/PICAP drawings and BOM/Rotator assembly/baseplate.SLDDRW
PICAP (Jim Connell)/PICAP drawings and BOM/Scintillator assembly/BGO.SLDDRW
PICAP (Jim Connell)/PICAP drawings and BOM/Scintillator assembly/S-A03/Inner Aluminum Cylinder.SLDDRW
PICAP (Jim Connell)/PICAP drawings and BOM/Scintillator assembly/S-A04/Outer Aluminum Cylinder.SLDDRW
PICAP (Jim Connell)/PICAP drawings and BOM/Scintillator assembly/S-A05/Aluminum Plate.SLDDRW
PICAP (Jim Connell)/PICAP drawings and BOM/Scintillator assembly/S-A06/Aluminum top Plate.SLDDRW
PICAP (Jim Connell)/PICAP drawings and BOM/Scintillator assembly/S-A07/Cover TOP.SLDDRW
PICAP (Jim Connell)/PICAP drawings and BOM/Scintillator assembly/S-P02/C5.SLDDRW
PICAP (Jim Connell)/PICAP drawings and BOM/Scintillator assembly/S-P08/Support ring.SLDDRW
PICAP (Jim Connell)/PICAP drawings and BOM/Scintillator assembly/S-T11/PTFE bar top.SLDDRW
PICAP (Jim Connell)/PICAP drawings and BOM/Scintillator assembly/S-T12/Teflon bar side.SLDDRW
PICAP (Jim Connell)/PICAP drawings and BOM/Scintillator assembly/S-T13/Teflon bar bottom.SLDDRW
PICAP (Jim Connell)/PICAP drawings and BOM/Scintillator assembly/Scintillator assembly check.SLDDRW
PICAP (Jim Connell)/PICAP drawings and BOM/baseplate/PICAPTurnPlate.SLDDRW
PICAP (Jim Connell)/PICAP drawings and BOM/baseplate/baseplate.SLDDRW
PICAP (Jim Connell)/PICAP drawings and BOM/cylinder assembly/Shell assembly check.SLDDRW
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
