PorterMatt/CherenkovDetector/PDF files for final production assembly/TECHNICAL DRAWINGS PACKAGE.pdf

TECHNICAL DRAWINGS FOR: | ADIS INSTRUMENT: MECHANICAL HOUSING
SUBMISSION STATUS: | SUBMITTED FOR PRODUCTION
CHARGE: | ADIS Project – Dr. James Connell, UNH Space Science Center
Morse 205B, 862-5096
TABLE OF CONTENTS: | ID# | DRAWING NAME | QTY/ASSEMBLY
| 1-1 | ADIS3 BOTTOM MOUNT | 1
| 2-1 | ADIS3 CLIP BODY (CIRC) | 6
| 2-2 | ADIS3 CLIP BODY (CIRC) – ORTHO | -
| 3-1 | ADIS3 CLIP BODY (ELIP) | 4
| 3-2 | ADIS3 CLIP BODY (ELIP) – ORTHO | -
| 4-1 | ADIS3 TOP MOUNT | 1
| 5-1 | ADIS3 BRASS PIECE | 15
| 6-1 | ADIS3 SUPPORT COLUMN-SIDE | 1
| 6-2 | ADIS3 SUPPORT COLUMN-TOP/BOTTOM | -
| 6-3 | ADIS3 SUPPORT COLUMN-FRONT | -
| 6-4 | ADIS3 SUPPORT COLUMN-BACK | -
| 6-5 | ADIS3 SUPPORT COLUMN (ORTHO) | -
| 7-1 | ADIS3 REF SUPPORT COL-SIDE | 1
| 7-2 | ADIS3 REF SUPPORT COL-TOP/BOTTOM | -
| 7-3 | ADIS3 REF SUPPORT COL-FRONT | -
| 7-4 | ADIS3 REF SUPPORT COL-BACK | -
| 7-5 | ADIS3 REF SUPPORT COL (ORTHO) | -
COMMENTS: | All dimensions are in inches.
