PorterMatt/CherenkovDetector/Screenshots/Assembly.JPG

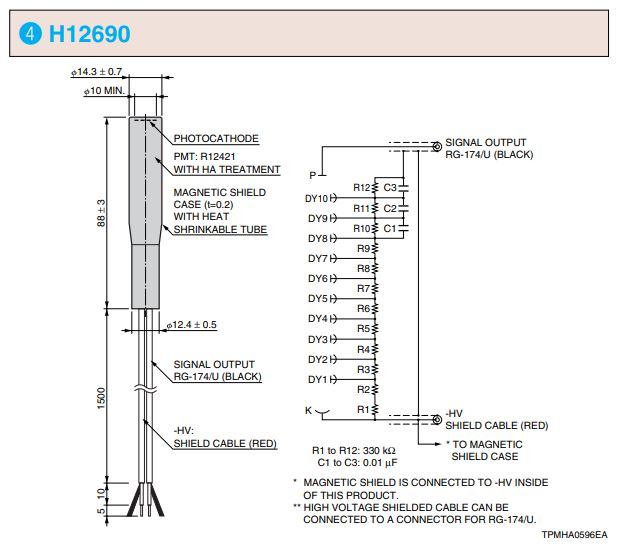
Screenshots/Assembly.JPG
