PorterMatt/CherenkovDetector/PICAP (Jim Connell)/PICAP Documents/Soild State detector tests/43-012B.docx

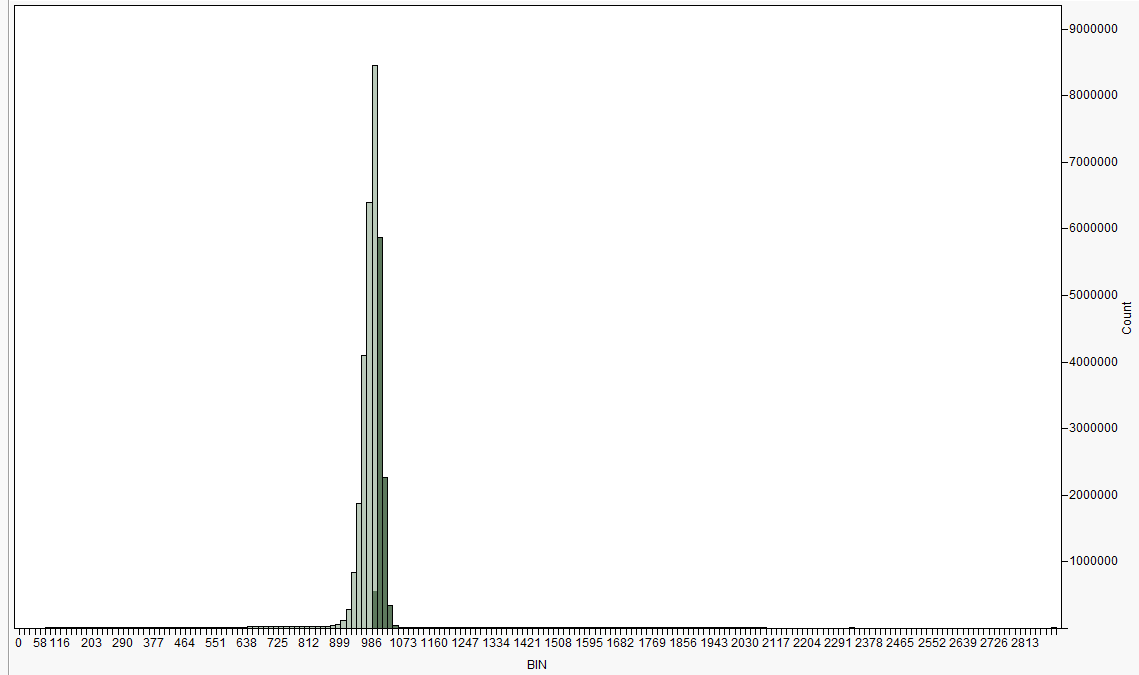
[picture p408: figure]
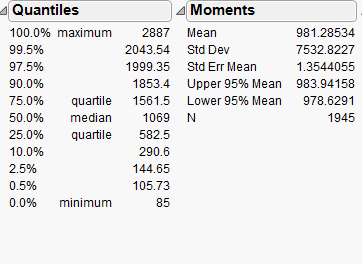
[picture p409: figure]
