PorterMatt/CherenkovDetector/PICAP (Jim Connell)/PICAP Documents/Soild State detector tests/43-014B.docx

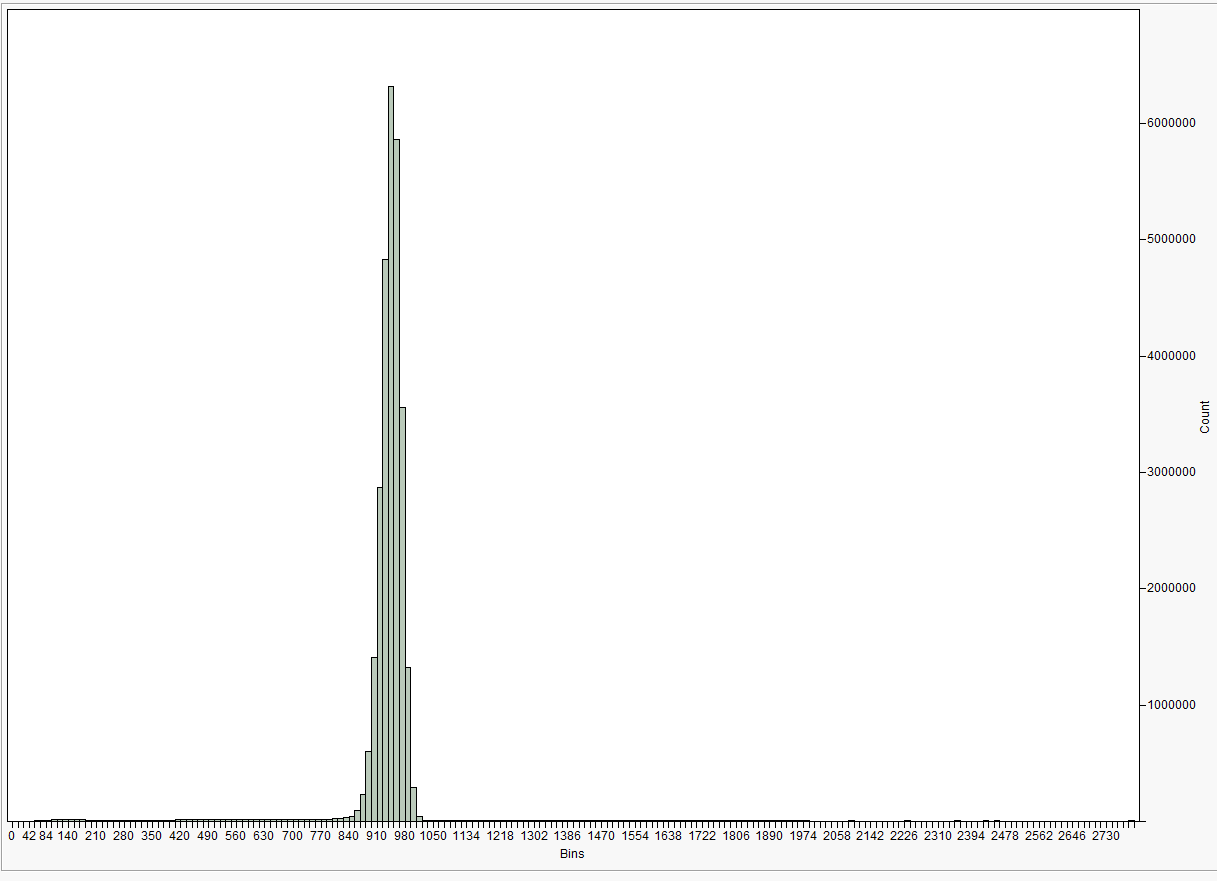
[picture p410: figure]
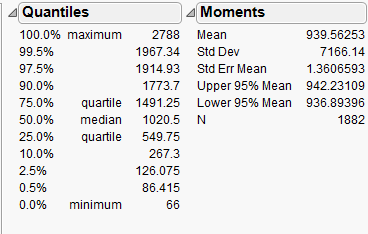
[picture p411: figure]
