PorterMatt/CherenkovDetector/PICAP (Jim Connell)/PICAP Documents/Soild State detector tests/43-014D.docx

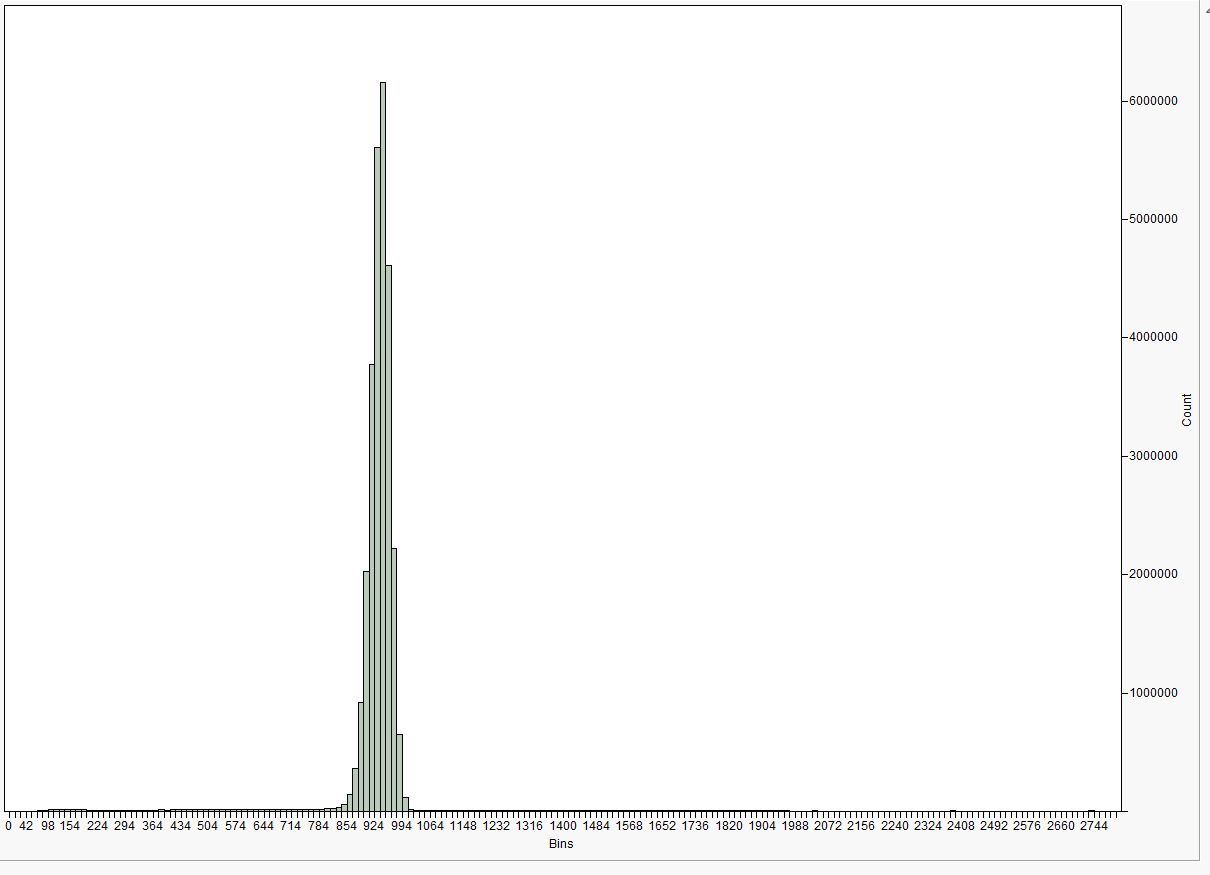
[picture p412: figure]
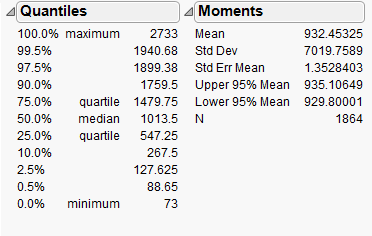
[picture p413: figure]
