PorterMatt/CherenkovDetector/PICAP (Jim Connell)/PICAP Documents/Soild State detector tests/51-098C.docx

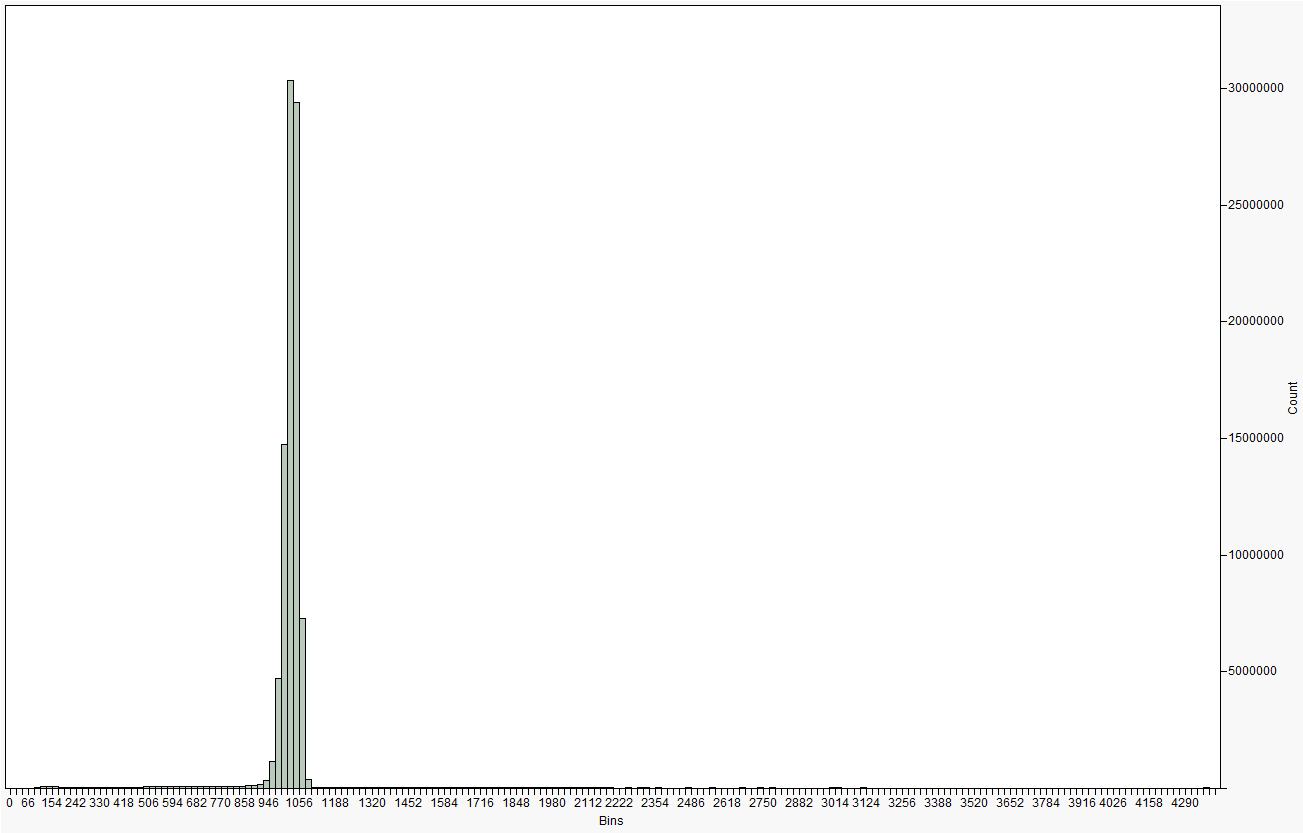
[picture p414: figure]
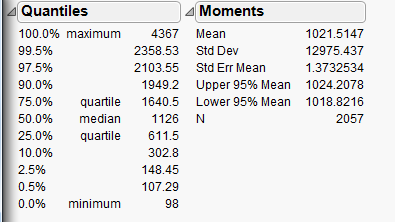
[picture p415: figure]
