PorterMatt/CherenkovDetector/PICAP (Jim Connell)/PICAP Documents/Soild State detector tests/ssd.xlsx

Sheet: 43-012B
0 | 43-012B
0 | 86674
0
0
0
0
0
0
0
0
0
0
0
0
0
0
0
0
0
0
0
0
0
0
0
0
0
0
0
0
0
0
0
0
0
0
0
0
0
0
0
0
0
0
0
0
0
0
0
0
0
0
0
0
0
0
0
0
0
0
0
0
0
0
0
0
0
0
0
0
0
0
0
0
0
0
0
0
0
0
0
0
0
0
1
0
0
0
0
0
0
0
0
0
0
0
0
1
1
17
185
397
481
479
444
452
463
428
402
449
414
395
422
469
419
421
411
394
396
414
447
415
389
392
444
404
396
405
408
371
369
373
412
429
353
398
395
369
364
365
371
387
395
395
383
378
372
374
385
336
391
329
370
359
373
354
335
346
367
351
349
342
347
338
358
344
364
371
337
347
340
321
322
347
327
319
339
289
355
336
335
344
327
309
347
356
319
357
331
326
342
334
319
317
312
337
340
318
301
327
316
357
316
333
295
315
302
324
300
295
310
276
322
331
312
312
311
320
341
303
328
309
323
290
319
336
296
309
322
317
284
303
303
303
269
318
315
301
288
325
327
286
300
303
319
289
311
331
332
289
298
319
289
308
311
318
308
312
325
312
302
300
344
294
310
293
282
320
301
341
335
288
297
301
307
317
272
327
317
325
293
302
318
277
319
277
310
264
314
331
316
297
304
324
325
302
301
312
290
320
299
254
321
317
337
333
328
302
320
303
310
307
317
351
293
299
306
297
303
321
308
300
300
308
293
291
321
309
327
335
352
362
331
296
299
324
318
304
319
318
306
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
