PorterMatt/CherenkovDetector/Solidworks Parts/SSD Parts/Drawings/Lightbox_TestMount_V2.pdf

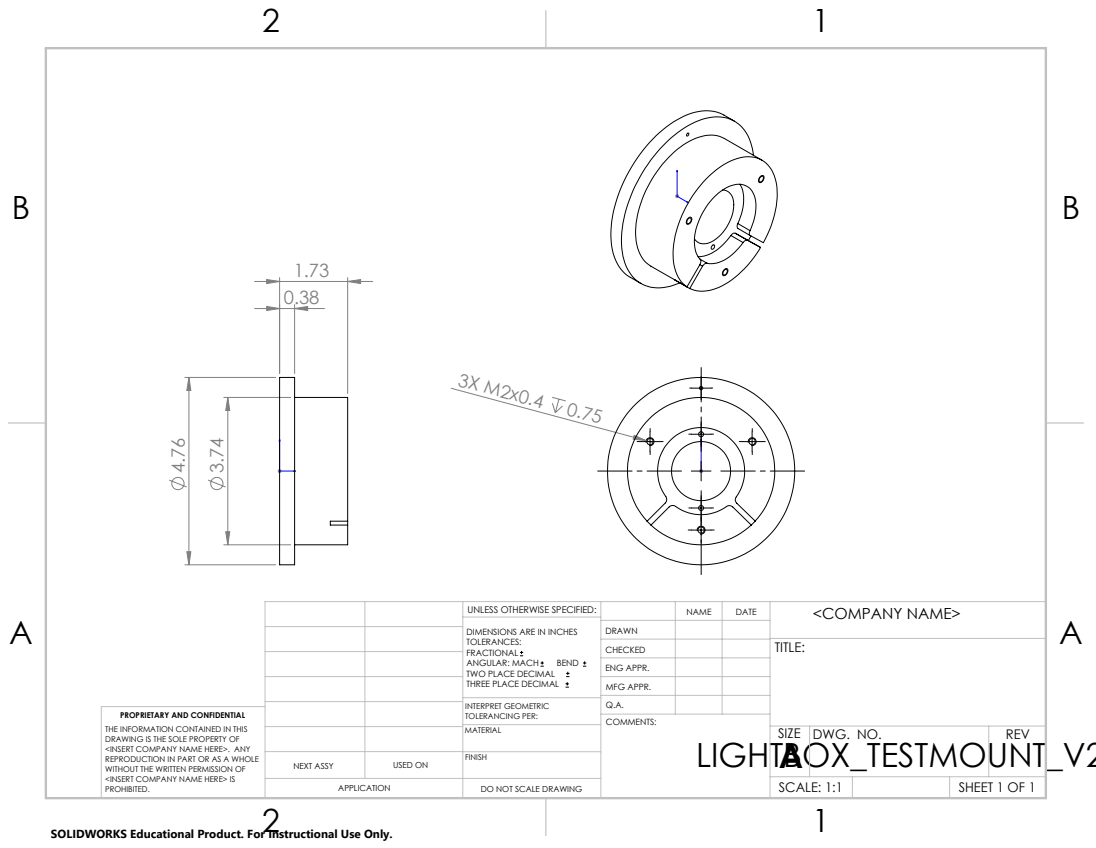
[picture p416: page 1]

UNLESS OTHERWISE SPECIFIED: | | NAME | DATE | <COMPANY NAME>
DIMENSIONS ARE IN INCHES TOLERANCES: FRACTIONAL ANGULAR: MACH BEND TWO PLACE DECIMAL THREE PLACE DECIMAL | DRAWN

CHECKED | | | TITLE:

ENG APPR.
MFG APPR.

INTERPRET GEOMETRIC TOLERANCING PER: | Q.A.

PROPRIETARY AND CONFIDENTIAL
THE INFORMATION CONTAINED IN THIS
DRAWING IS THE SOLE PROPERTY OF
<INSERT COMPANY NAME HERE>. ANY
REPRODUCTION IN PART OR AS A WHOLE
WITHOUT THE WRITTEN PERMISSION OF
<INSERT COMPANY NAME HERE> IS
PROHIBITED.

USED ON | MATERIAL | | SIZE A | DWG. NO. | REV

NEXT ASSY | | FINISH

APPLICATION | DO NOT SCALE DRAWING | | SCALE: 1:1 | | SHEET 1 OF 1

SOLIDWORKS Educational Product. For Instructional Use Only.
