PorterMatt/CherenkovDetector/PICAP (Jim Connell)/PICAP drawings and BOM/PICAP board Drawings/Front board.PDF

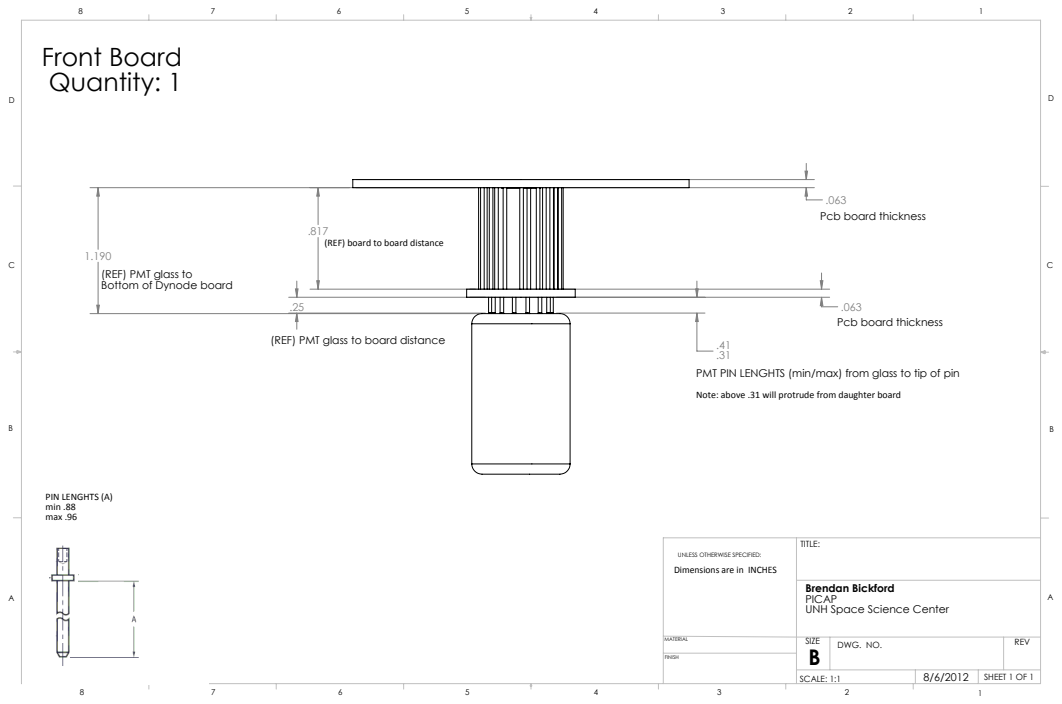
[picture p417: page 1]
Front Board Quantity: 1; PIN LENGHTS (A) min .88 max .96; DWG. NO.; REV; SCALE: 1:1; SHEET 1 OF 1

Pcb board thickness

(REF) board to board distance

(REF) PMT glass to
Bottom of Dynode board

(REF) PMT glass to board distance

PMT PIN LENGHTS (min/max) from glass to tip of pin
Note: above .31 will protrude from daughter board

UNLESS OTHERWISE SPECIFIED:
Dimensions are in INCHES

Brendan Bickford
PICAP
UNH Space Science Center
