PorterMatt/CherenkovDetector/PICAP (Jim Connell)/PICAP drawings and BOM/PICAP board Drawings/Side board revised.PDF

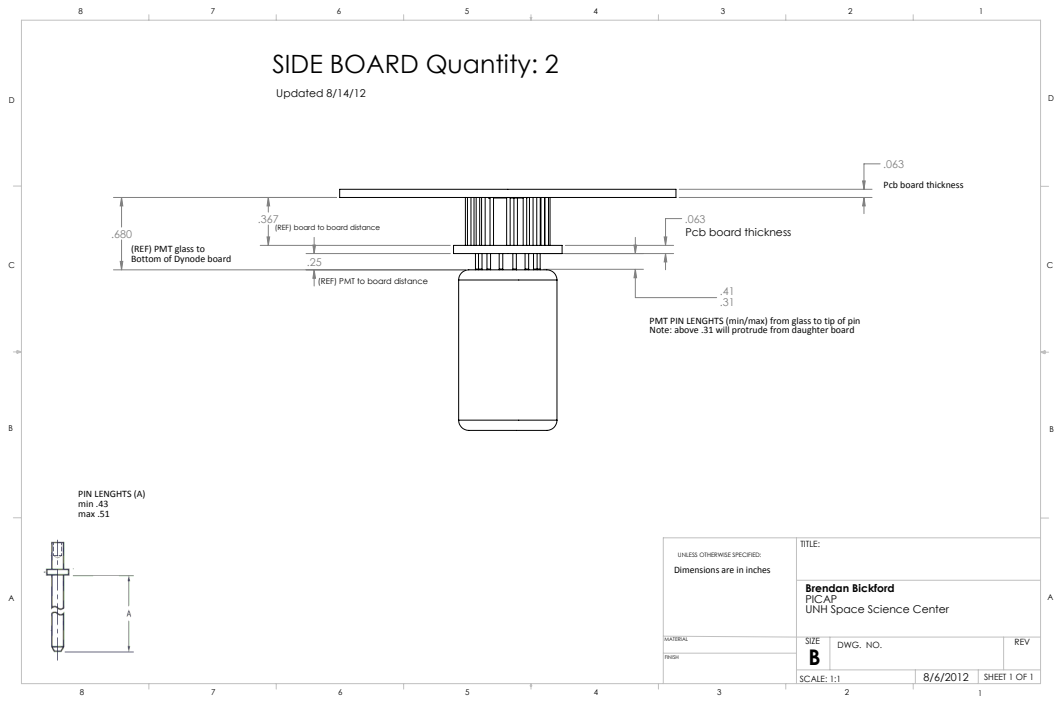
[picture p418: page 1]
PIN LENGHTS (A) min .43 max .51; Updated 8/14/12; DWG. NO.; REV; SCALE: 1:1; SHEET 1 OF 1

SIDE BOARD Quantity: 2

Pcb board thickness

(REF) board to board distance

(REF) PMT glass to
Bottom of Dynode board

(REF) PMT to board distance

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

UNLESS OTHERWISE SPECIFIED:
Dimensions are in inches

Brendan Bickford
PICAP
UNH Space Science Center
