PorterMatt/CherenkovDetector/PICAP (Jim Connell)/PICAP drawings and BOM/PICAP board Drawings/Top board revised.PDF

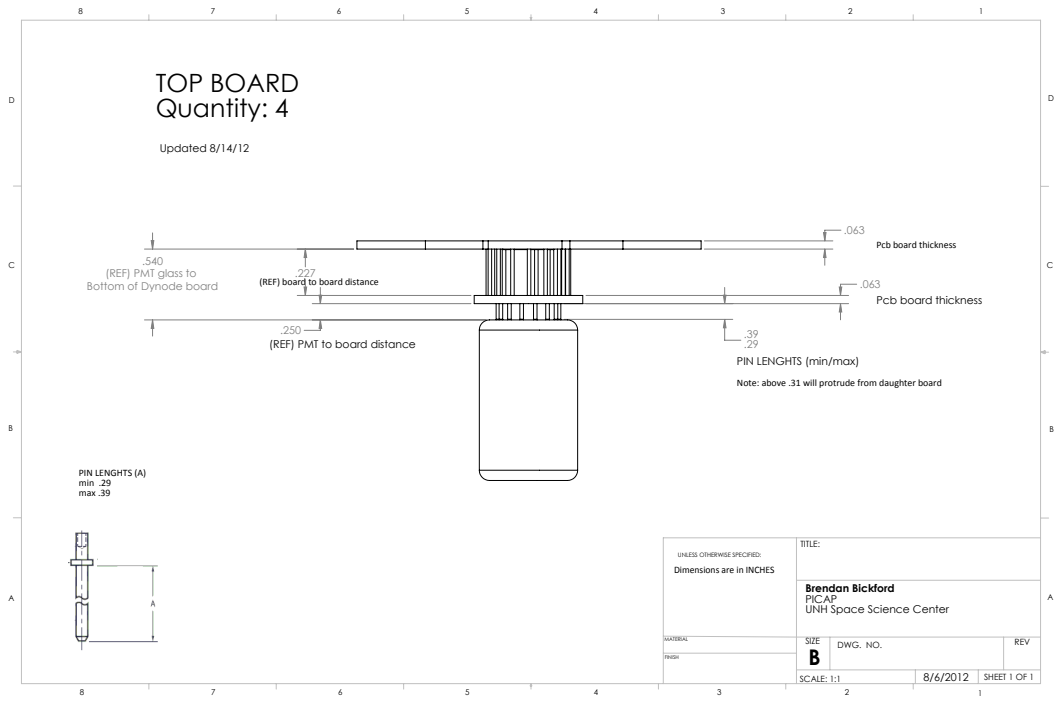
[picture p419: page 1]
TOP BOARD Quantity: 4; PIN LENGHTS (A) min .29 max .39; Updated 8/14/12; DWG. NO.; REV; SCALE: 1:1; SHEET 1 OF 1

Pcb board thickness

(REF) PMT glass to
Bottom of Dynode board

(REF) board to board distance

(REF) PMT to board distance

PIN LENGHTS (min/max)
Note: above .31 will protrude from daughter board

UNLESS OTHERWISE SPECIFIED:
Dimensions are in INCHES

Brendan Bickford
PICAP
UNH Space Science Center
