PorterMatt/CherenkovDetector/Solidworks Drawings/Lightbox/PDF_Lightbox/Lightbox_1_Assembly.pdf

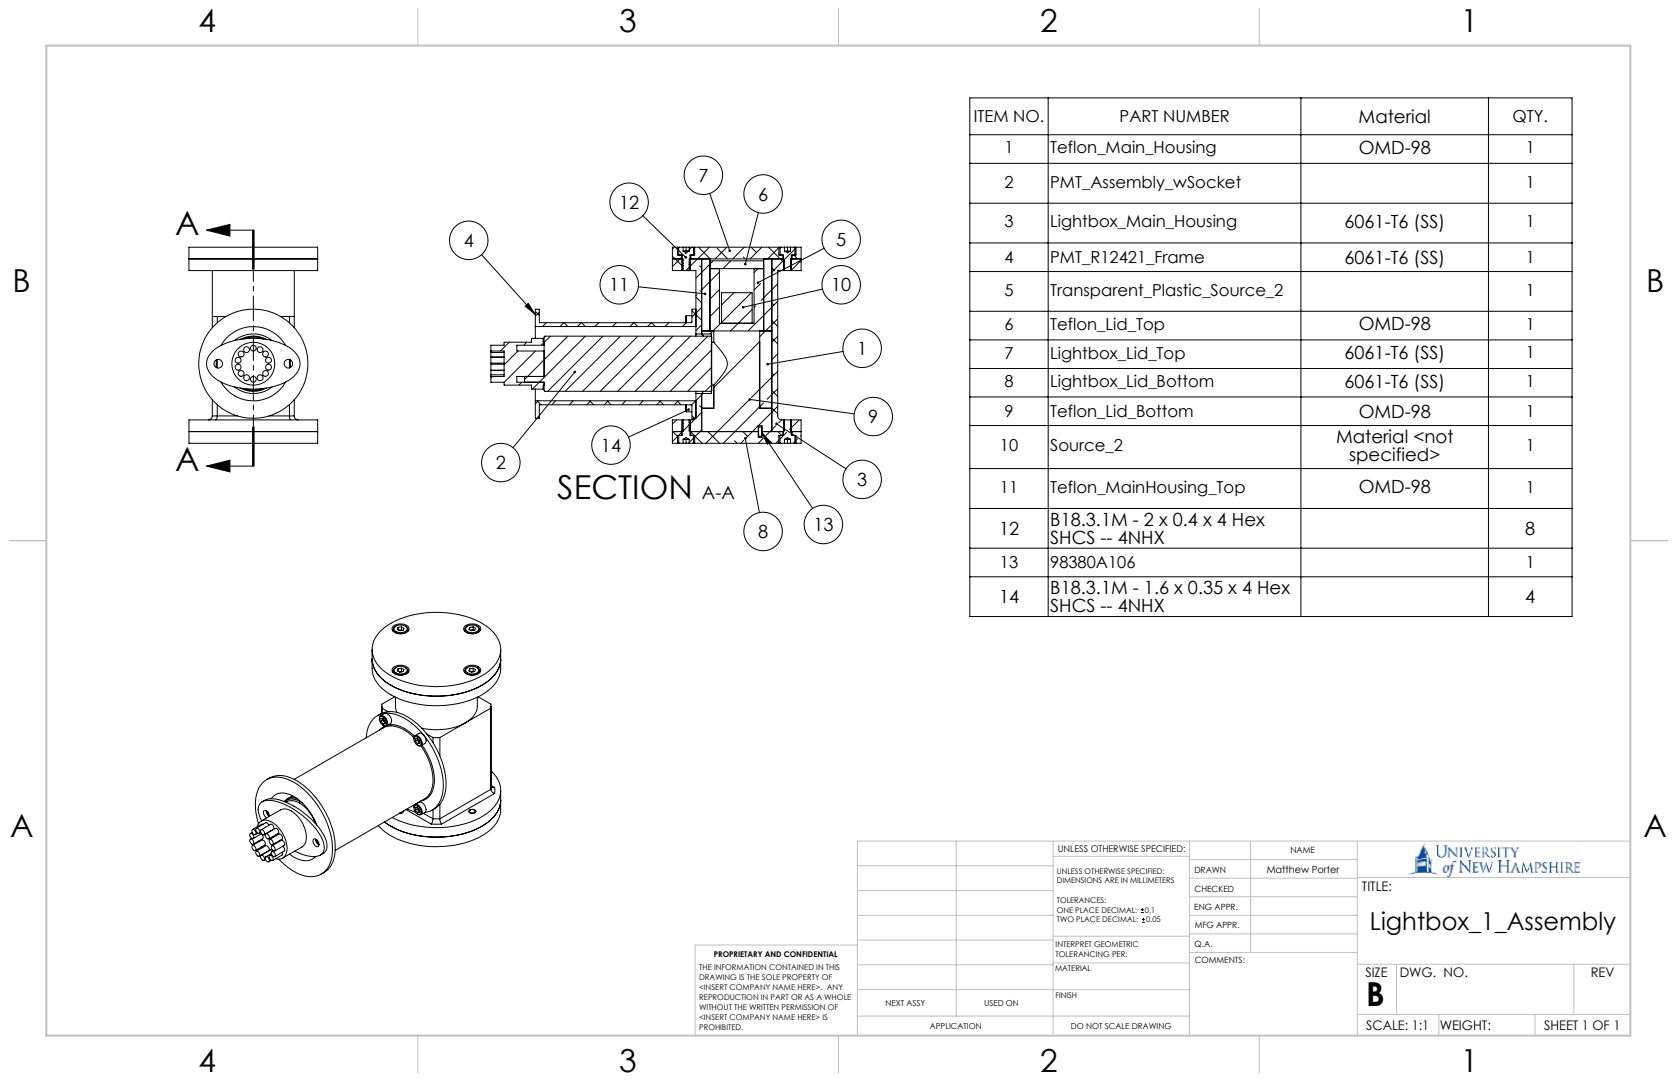
[picture p420: page 1]
SECTION A-A

ITEM NO. | PART NUMBER | Material | QTY.
1 | Teflon_Main_Housing | OMD-98 | 1
2 | PMT_Assembly_wSocket | | 1
3 | Lightbox_Main_Housing | 6061-T6 (SS) | 1
4 | PMT_R12421_Frame | 6061-T6 (SS) | 1
5 | Transparent_Plastic_Source_2 | | 1
6 | Teflon_Lid_Top | OMD-98 | 1
7 | Lightbox_Lid_Top | 6061-T6 (SS) | 1
8 | Lightbox_Lid_Bottom | 6061-T6 (SS) | 1
9 | Teflon_Lid_Bottom | OMD-98 | 1
10 | Source_2 | Material <not specified> | 1

11 | Teflon_MainHousing_Top | OMD-98 | 1
12 | B18.3.1M - 2 x 0.4 x 4 Hex SHCS -- 4NHX | | 8

13 | 98380A106 | | 1
14 | B18.3.1M - 1.6 x 0.35 x 4 Hex SHCS -- 4NHX | | 4

UNLESS OTHERWISE SPECIFIED: | | NAME
UNLESS OTHERWISE SPECIFIED: DIMENSIONS ARE IN MILLIMETERS TOLERANCES: ONE PLACE DECIMAL: 0.1 TWO PLACE DECIMAL: 0.05 | DRAWN | Matthew Porter

CHECKED | | TITLE: Lightbox_1_Assembly

ENG APPR.
MFG APPR.

INTERPRET GEOMETRIC TOLERANCING PER: | Q.A.
MATERIAL | | SIZE B | DWG. NO. | REV

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

NEXT ASSY | USED ON | FINISH

APPLICATION | DO NOT SCALE DRAWING | | SCALE: 1:1 | WEIGHT: | SHEET 1 OF 1
