PorterMatt/CherenkovDetector/PICAP (Jim Connell)/PICAP drawings and BOM/Cover assembly/C-A02/Cover.PDF

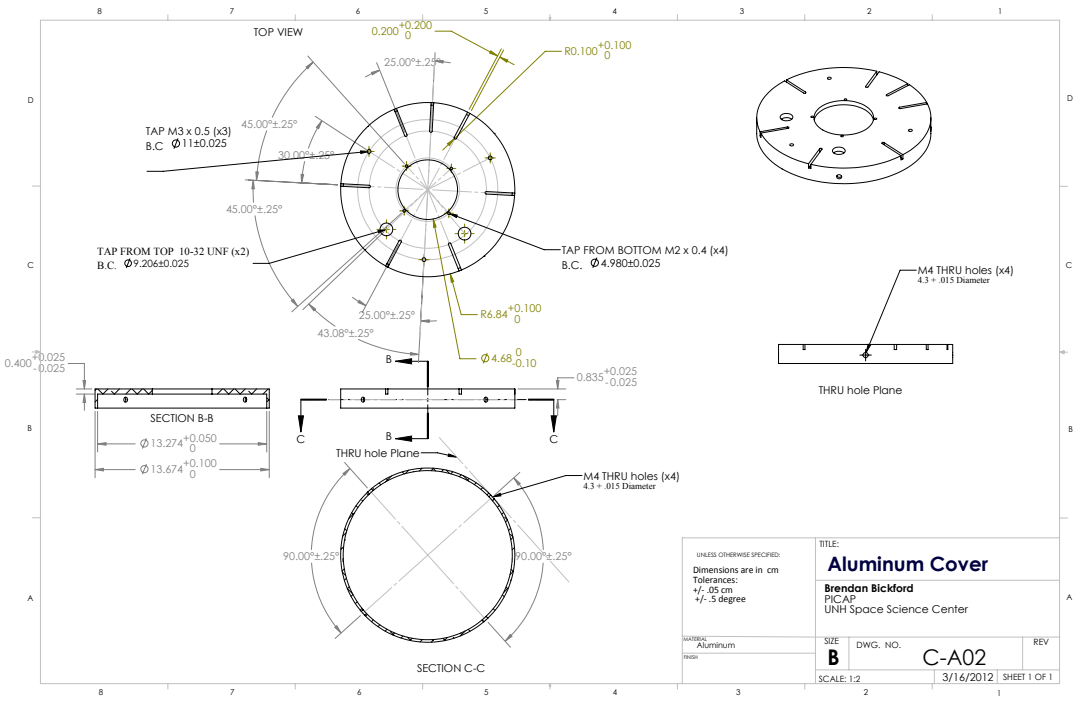
[picture p421: page 1]
TAP M3 x 0.5 (x3); SECTION B-B; SECTION C-C; M4 THRU holes (x4) 4.3 + .015 Diameter; TOP VIEW; DWG. NO.; REV; SCALE: 1:2; SHEET 1 OF 1; Aluminum Cover

TAP FROM TOP 10-32 UNF (x2)

TAP FROM BOTTOM M2 x 0.4 (x4)

THRU hole Plane

UNLESS OTHERWISE SPECIFIED:
Dimensions are in cm
Tolerances:
+/- .5 degree

Brendan Bickford
PICAP
UNH Space Science Center
