PorterMatt/CherenkovDetector/PICAP (Jim Connell)/PICAP drawings and BOM/Circuit Boards/Drawings/xy/Side board xy.PDF

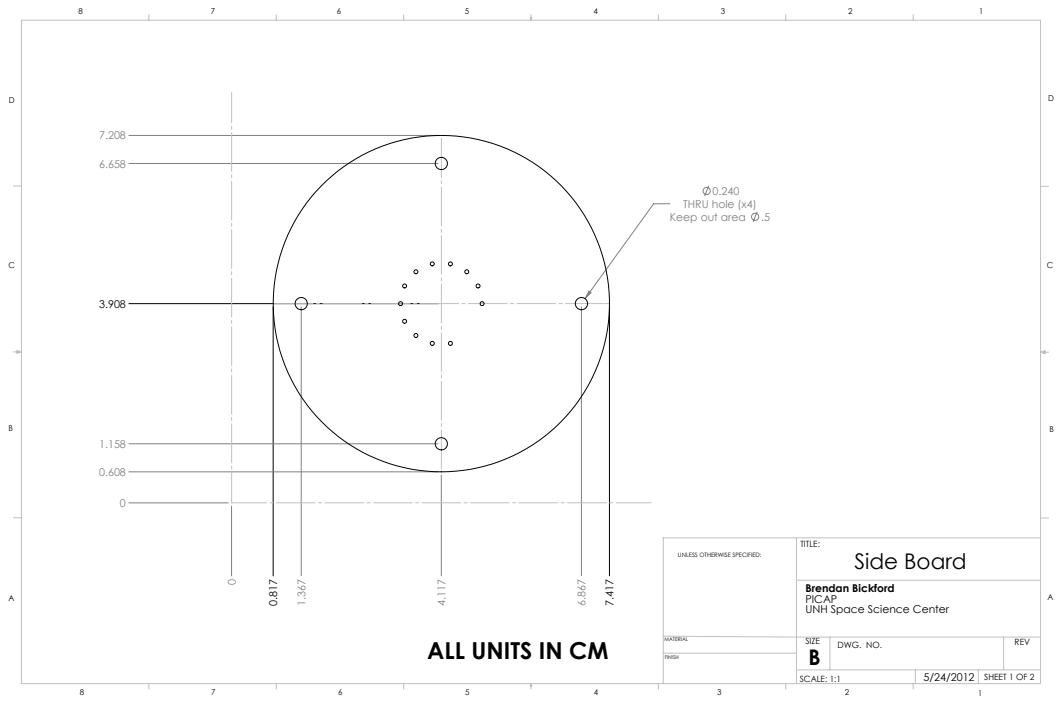
[picture p422: page 1]
Side Board; DWG. NO.; REV; SCALE: 1:1; SHEET 1 OF 2

THRU hole (x4)
Keep out area .5

UNLESS OTHERWISE SPECIFIED:

ALL UNITS IN CM

Brendan Bickford
PICAP
UNH Space Science Center

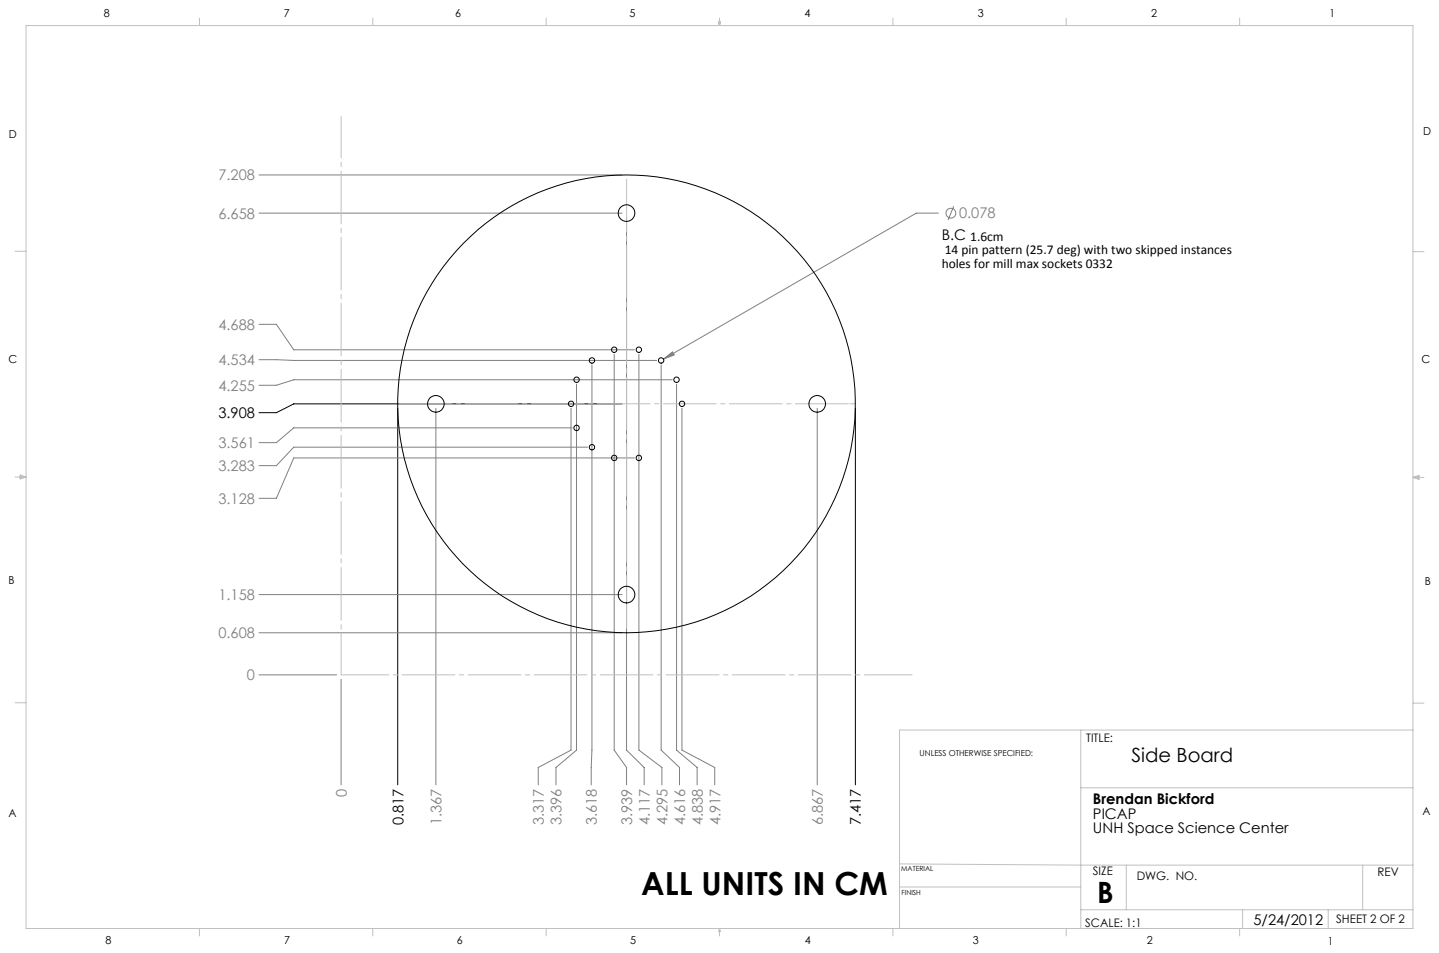
[picture p423: page 2]
Side Board; DWG. NO.; REV; SCALE: 1:1; SHEET 2 OF 2

14 pin pattern (25.7 deg) with two skipped instances
holes for mill max sockets 0332

UNLESS OTHERWISE SPECIFIED:

ALL UNITS IN CM

Brendan Bickford
PICAP
UNH Space Science Center
