PorterMatt/CherenkovDetector/PICAP (Jim Connell)/PICAP drawings and BOM/Circuit Boards/Drawings/xy/side cir boards 2.PDF

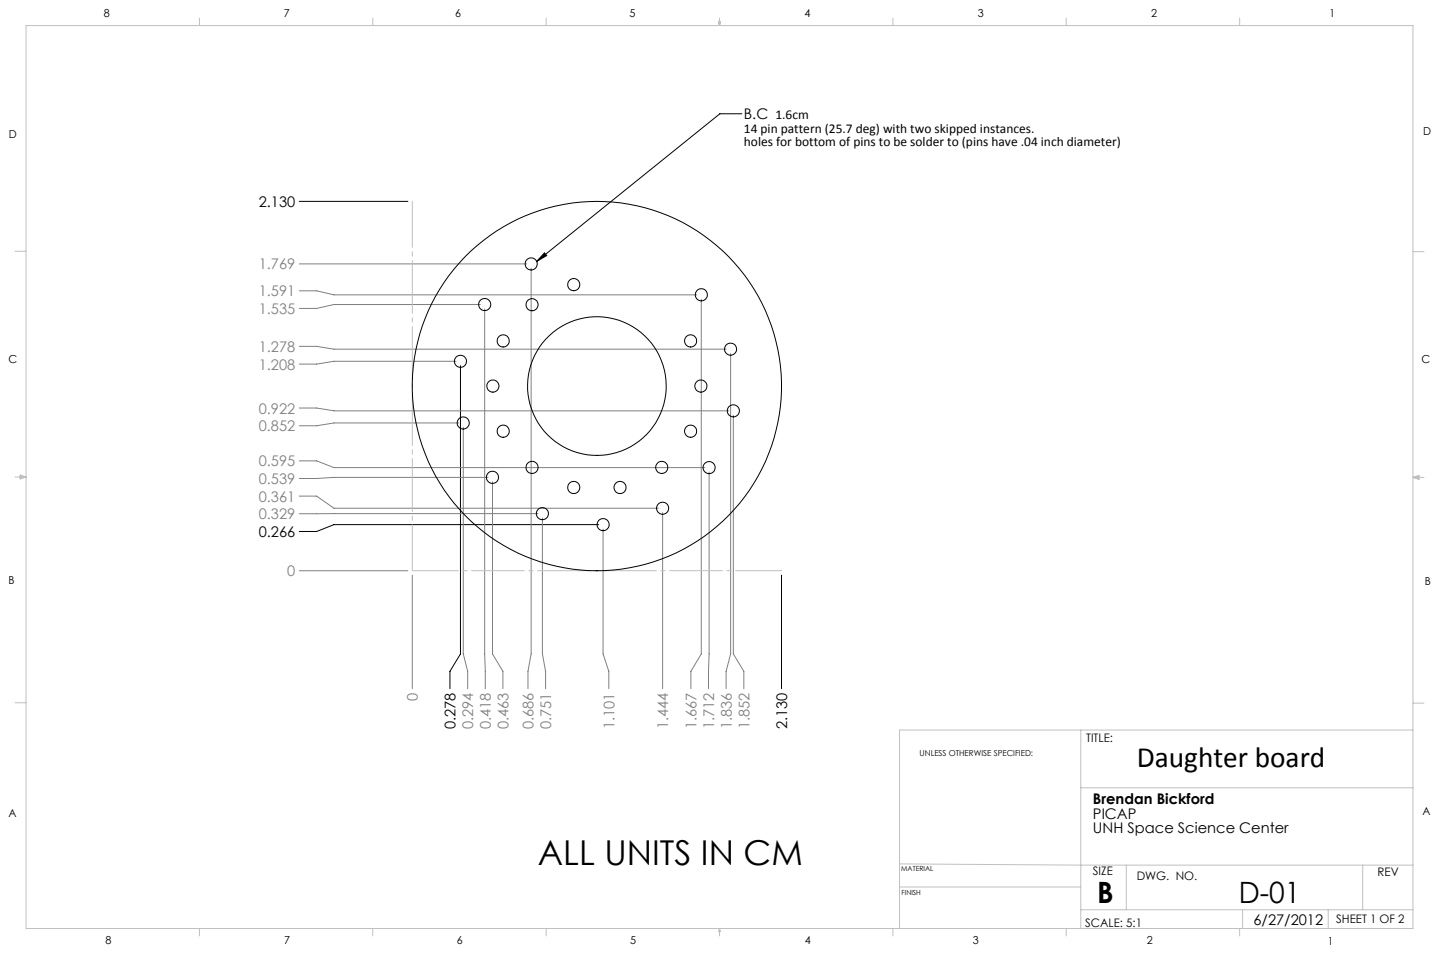
[picture p424: page 1]
DWG. NO.; REV; SCALE: 5:1; SHEET 1 OF 2; Daughter board

14 pin pattern (25.7 deg) with two skipped instances.
holes for bottom of pins to be solder to (pins have .04 inch diameter)

UNLESS OTHERWISE SPECIFIED:

Brendan Bickford
PICAP
UNH Space Science Center

ALL UNITS IN CM

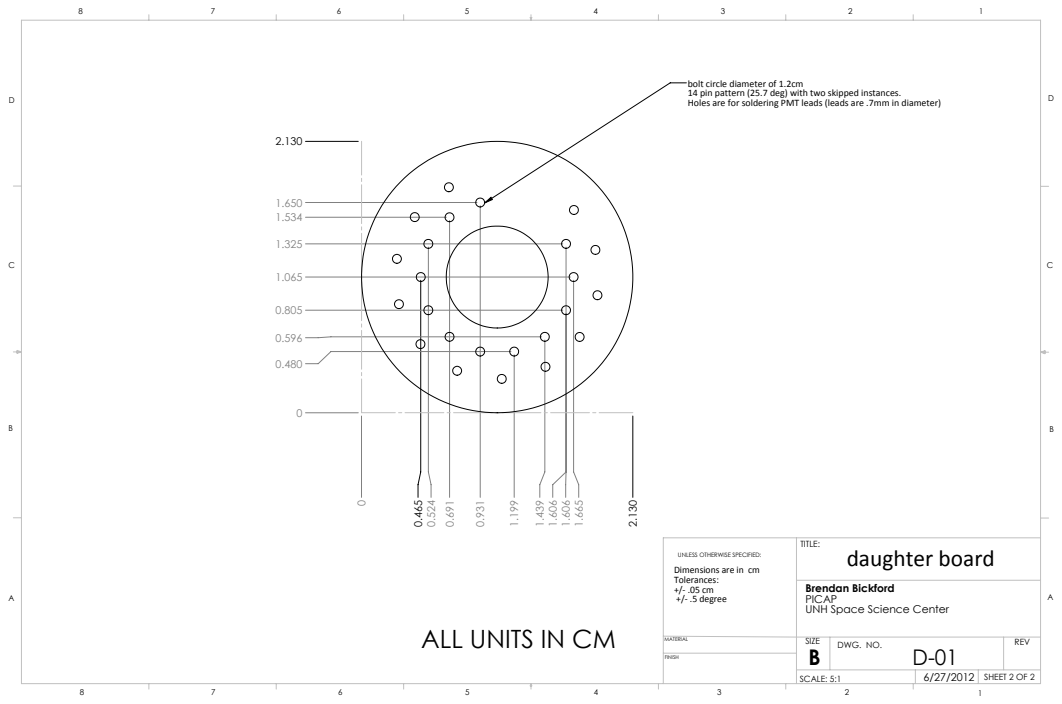
[picture p425: page 2]
Holes are for soldering PMT leads (leads are .7mm in diameter); DWG. NO.; REV; SCALE: 5:1; SHEET 2 OF 2; daughter board

bolt circle diameter of 1.2cm
14 pin pattern (25.7 deg) with two skipped instances.

UNLESS OTHERWISE SPECIFIED:
Dimensions are in cm
Tolerances:
+/- .5 degree

Brendan Bickford
PICAP
UNH Space Science Center

ALL UNITS IN CM
