PorterMatt/CherenkovDetector/PICAP (Jim Connell)/PICAP drawings and BOM/Circuit Boards/Drawings/xy/Top board xy.PDF

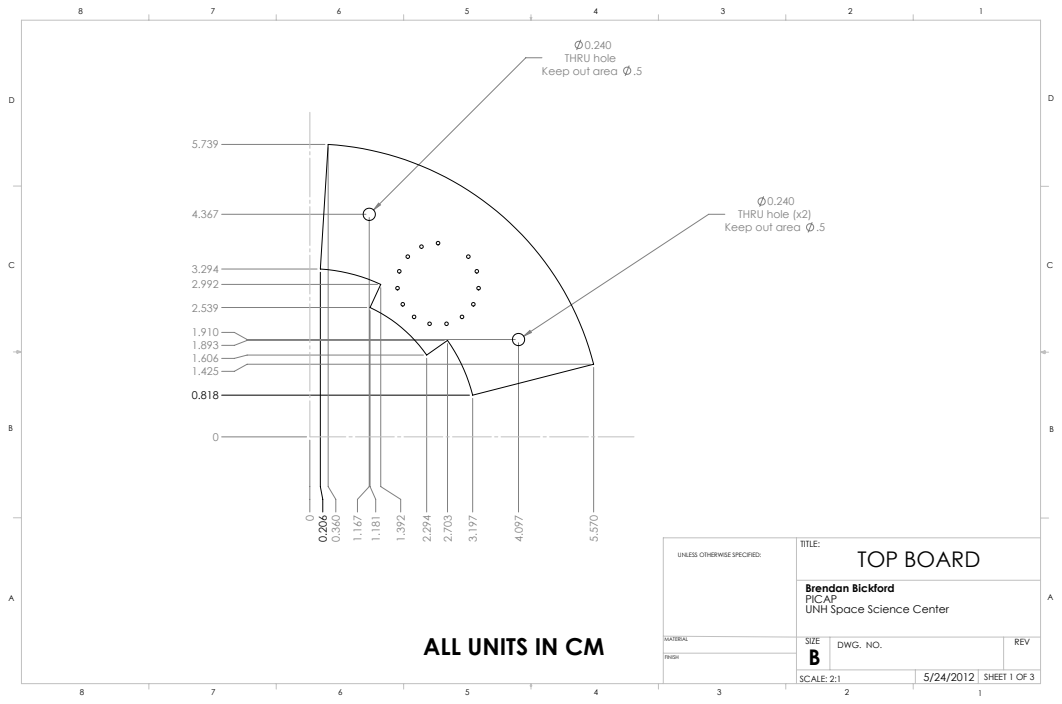
[picture p426: page 1]
TOP BOARD; DWG. NO.; REV; SCALE: 2:1; SHEET 1 OF 3

THRU hole
Keep out area .5

THRU hole (x2)

UNLESS OTHERWISE SPECIFIED:

Brendan Bickford
PICAP
UNH Space Science Center

ALL UNITS IN CM

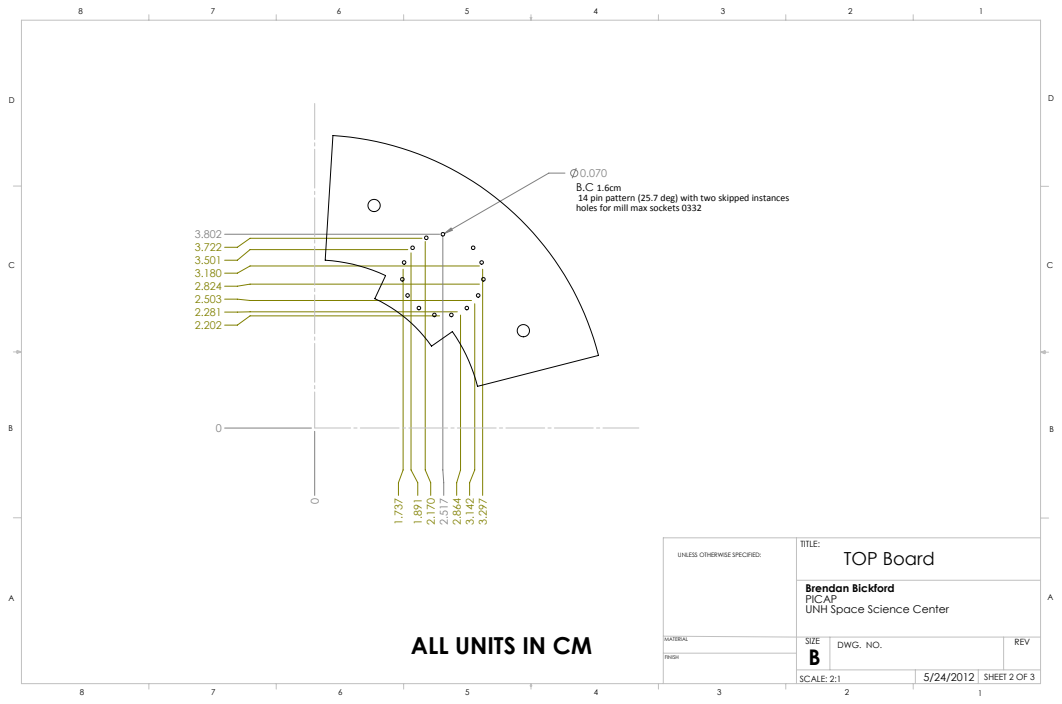
[picture p427: page 2]
TOP Board; DWG. NO.; REV

14 pin pattern (25.7 deg) with two skipped instances
holes for mill max sockets 0332

UNLESS OTHERWISE SPECIFIED:

Brendan Bickford
PICAP
UNH Space Science Center

ALL UNITS IN CM

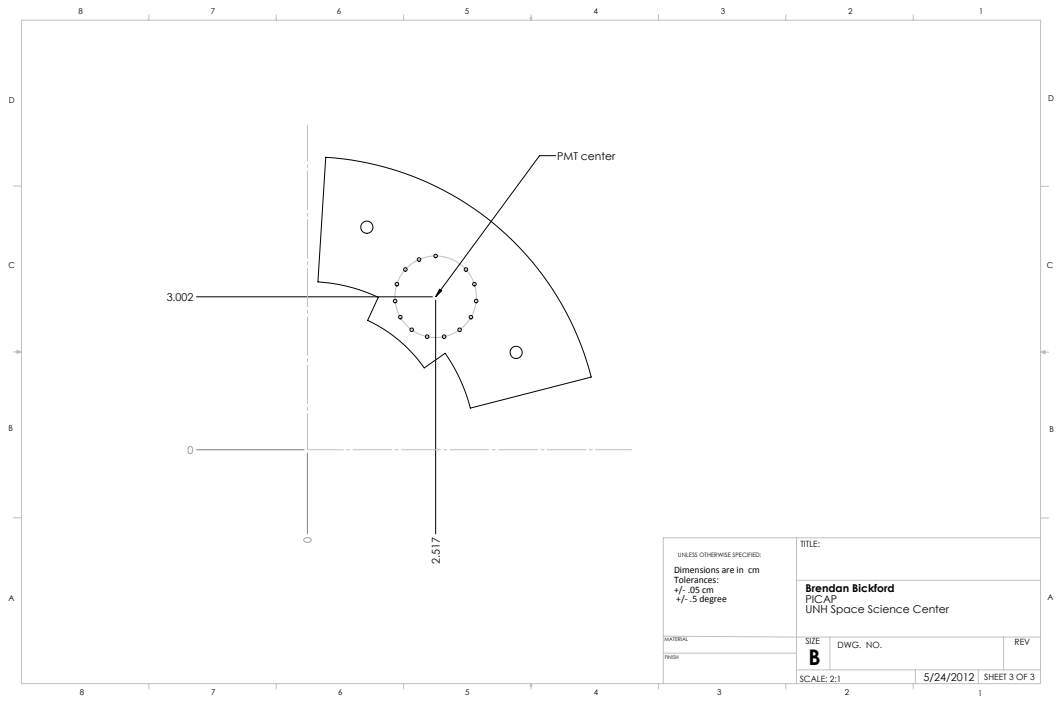
[picture p428: page 3]
PMT center; DWG. NO.; REV

UNLESS OTHERWISE SPECIFIED:
Dimensions are in cm
Tolerances:
+/- .5 degree

Brendan Bickford
PICAP
UNH Space Science Center
