PorterMatt/CherenkovDetector/Solidworks Drawings/Lightbox/PDF_Lightbox/Lightbox_Main_Housing.pdf

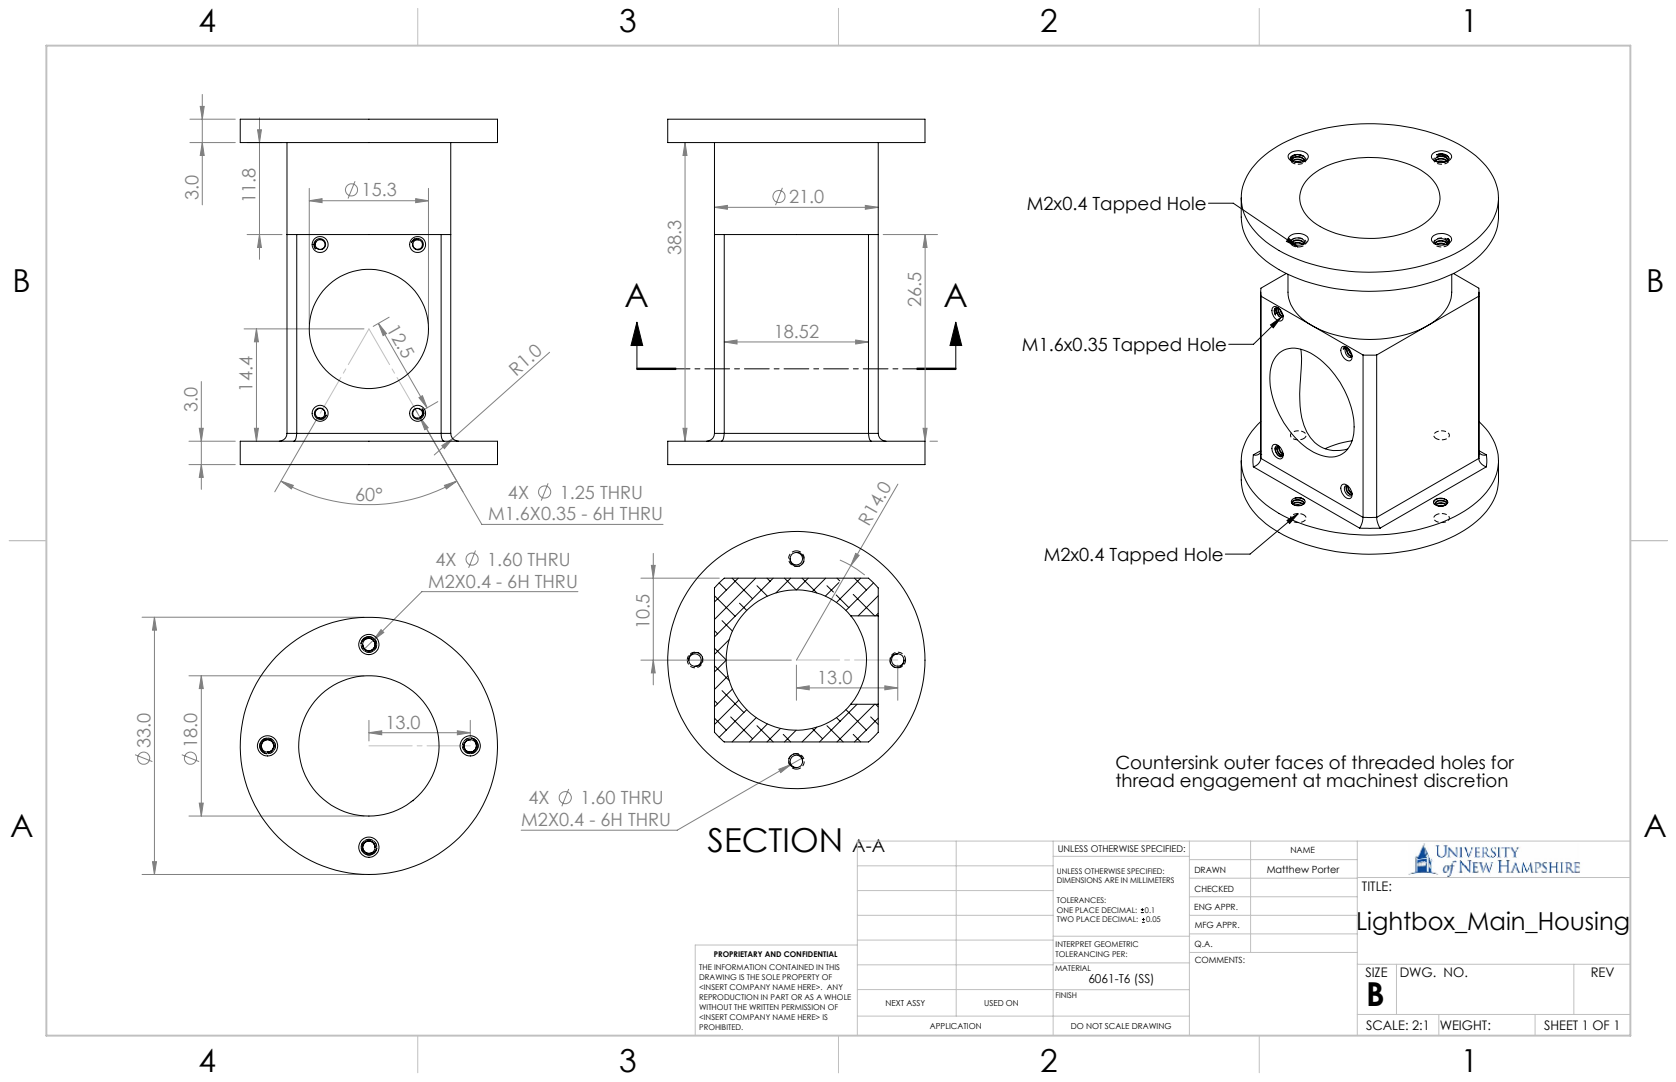
[picture p429: page 1]
M2x0.4 Tapped Hole; M1.6x0.35 Tapped Hole; 1.25 THRU; M1.6X0.35 - 6H THRU; 1.60 THRU; M2X0.4 - 6H THRU; SECTION A-A

Countersink outer faces of threaded holes for
thread engagement at machinest discretion

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

CHECKED | | TITLE: Lightbox_Main_Housing

ENG APPR.
MFG APPR.

INTERPRET GEOMETRIC TOLERANCING PER: | Q.A.
MATERIAL 6061-T6 (SS) | | SIZE B | DWG. NO. | REV

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

NEXT ASSY | USED ON | FINISH

APPLICATION | DO NOT SCALE DRAWING | | SCALE: 2:1 | WEIGHT: | SHEET 1 OF 1
