PorterMatt/CherenkovDetector/PDF files for final production assembly/Pro_ENGINEER - ADIS3_BOTTOM_DISK_MOUNT.pdf

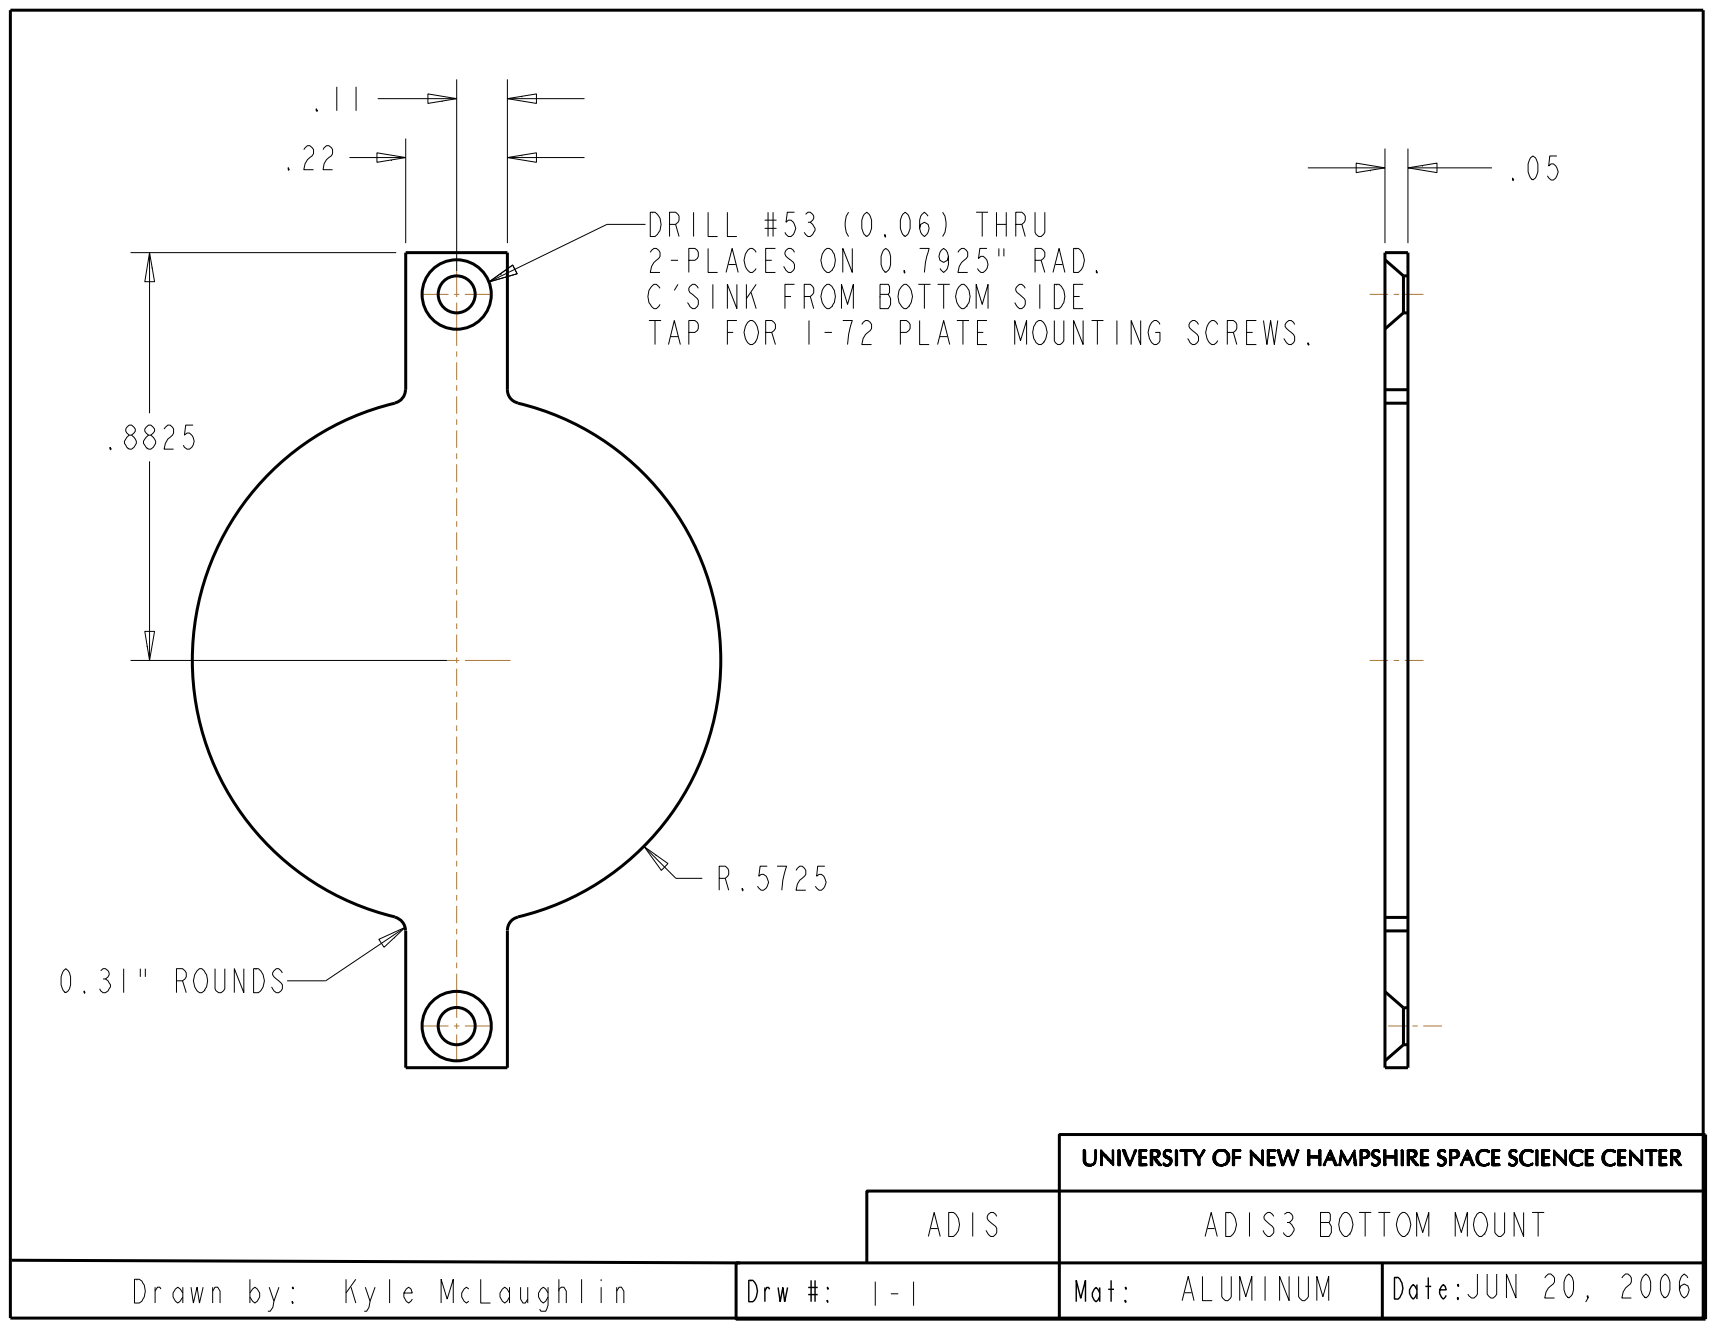
[picture p430: page 1]
