PorterMatt/CherenkovDetector/PDF files for final production assembly/Pro_ENGINEER - ADIS3_BRASS_PIECE.pdf

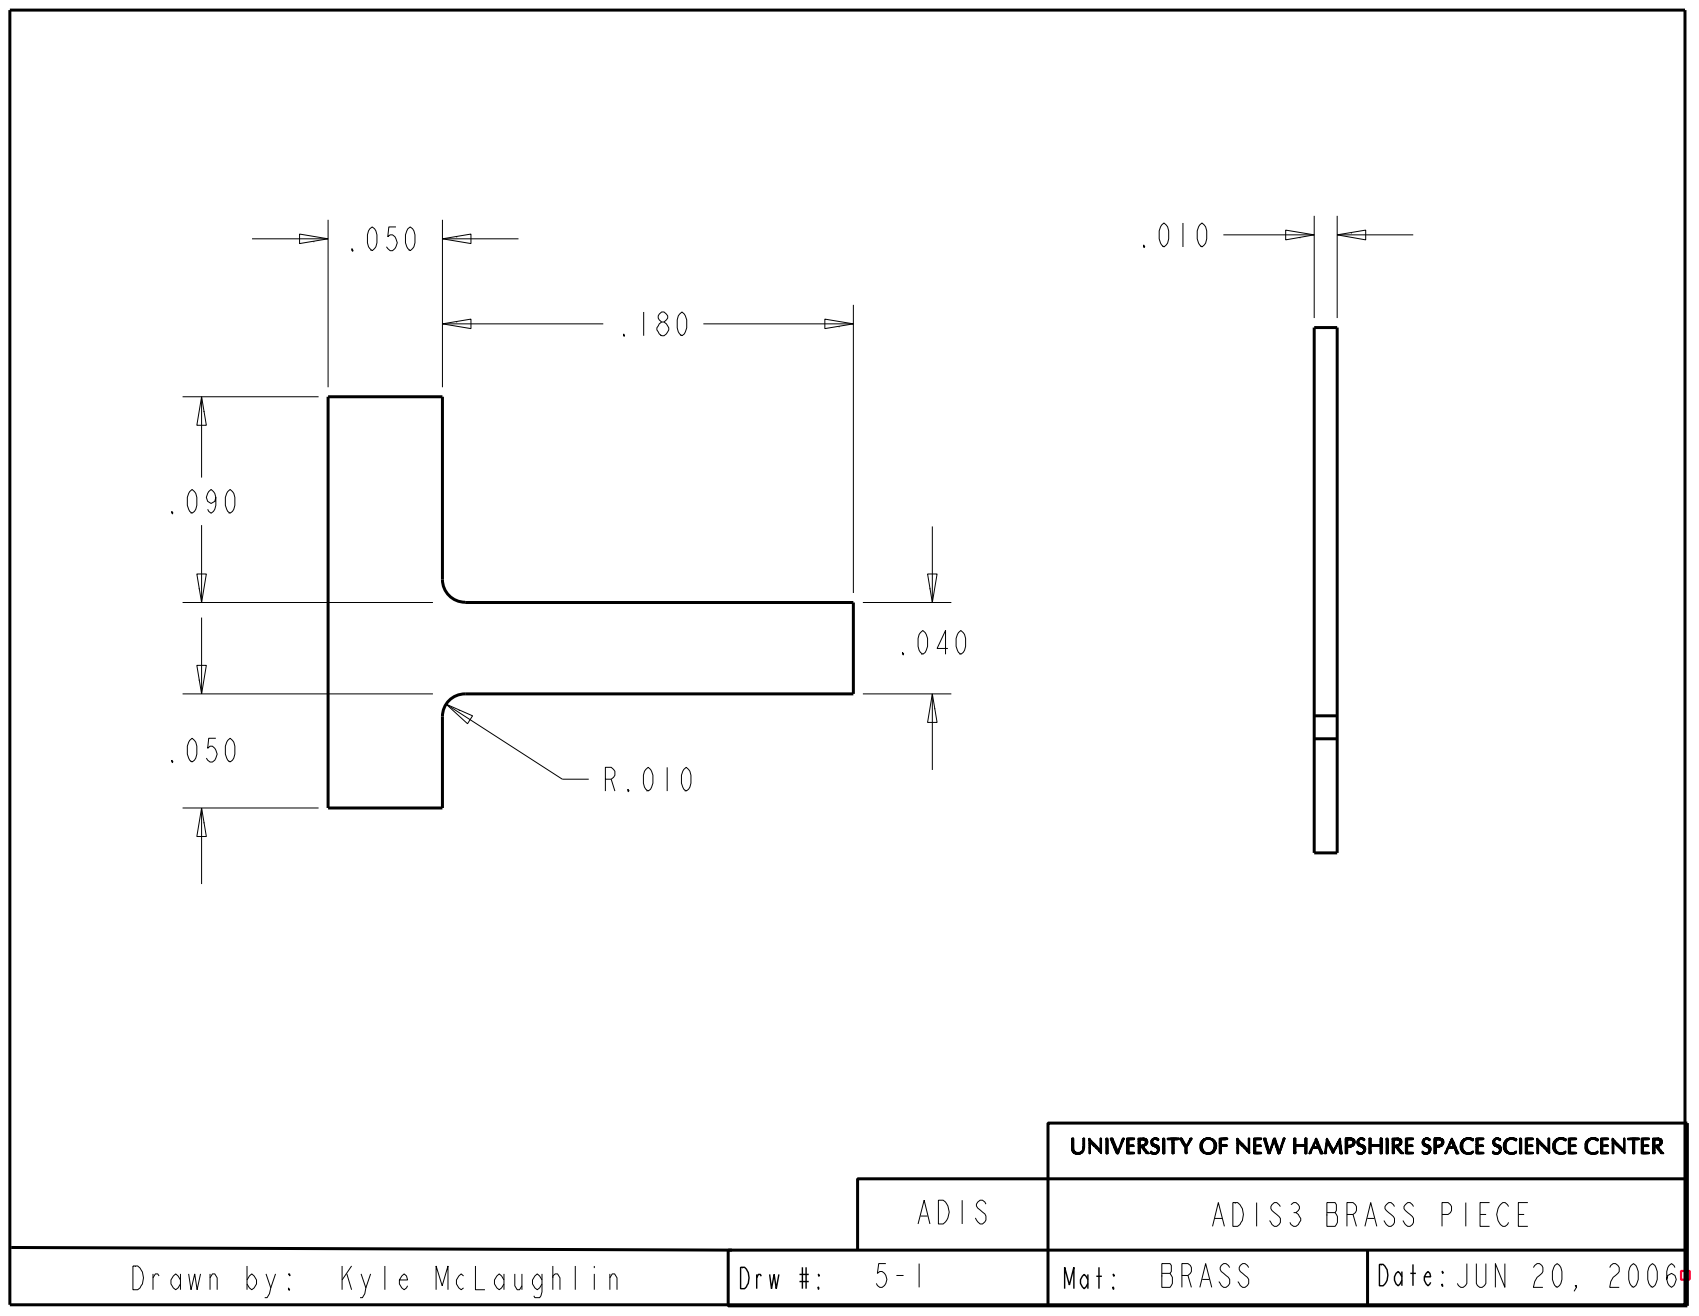
[picture p431: page 1]
