PorterMatt/CherenkovDetector/PDF files for final production assembly/Pro_ENGINEER - ADIS3_CLIP_BODY_CIRCLE.pdf

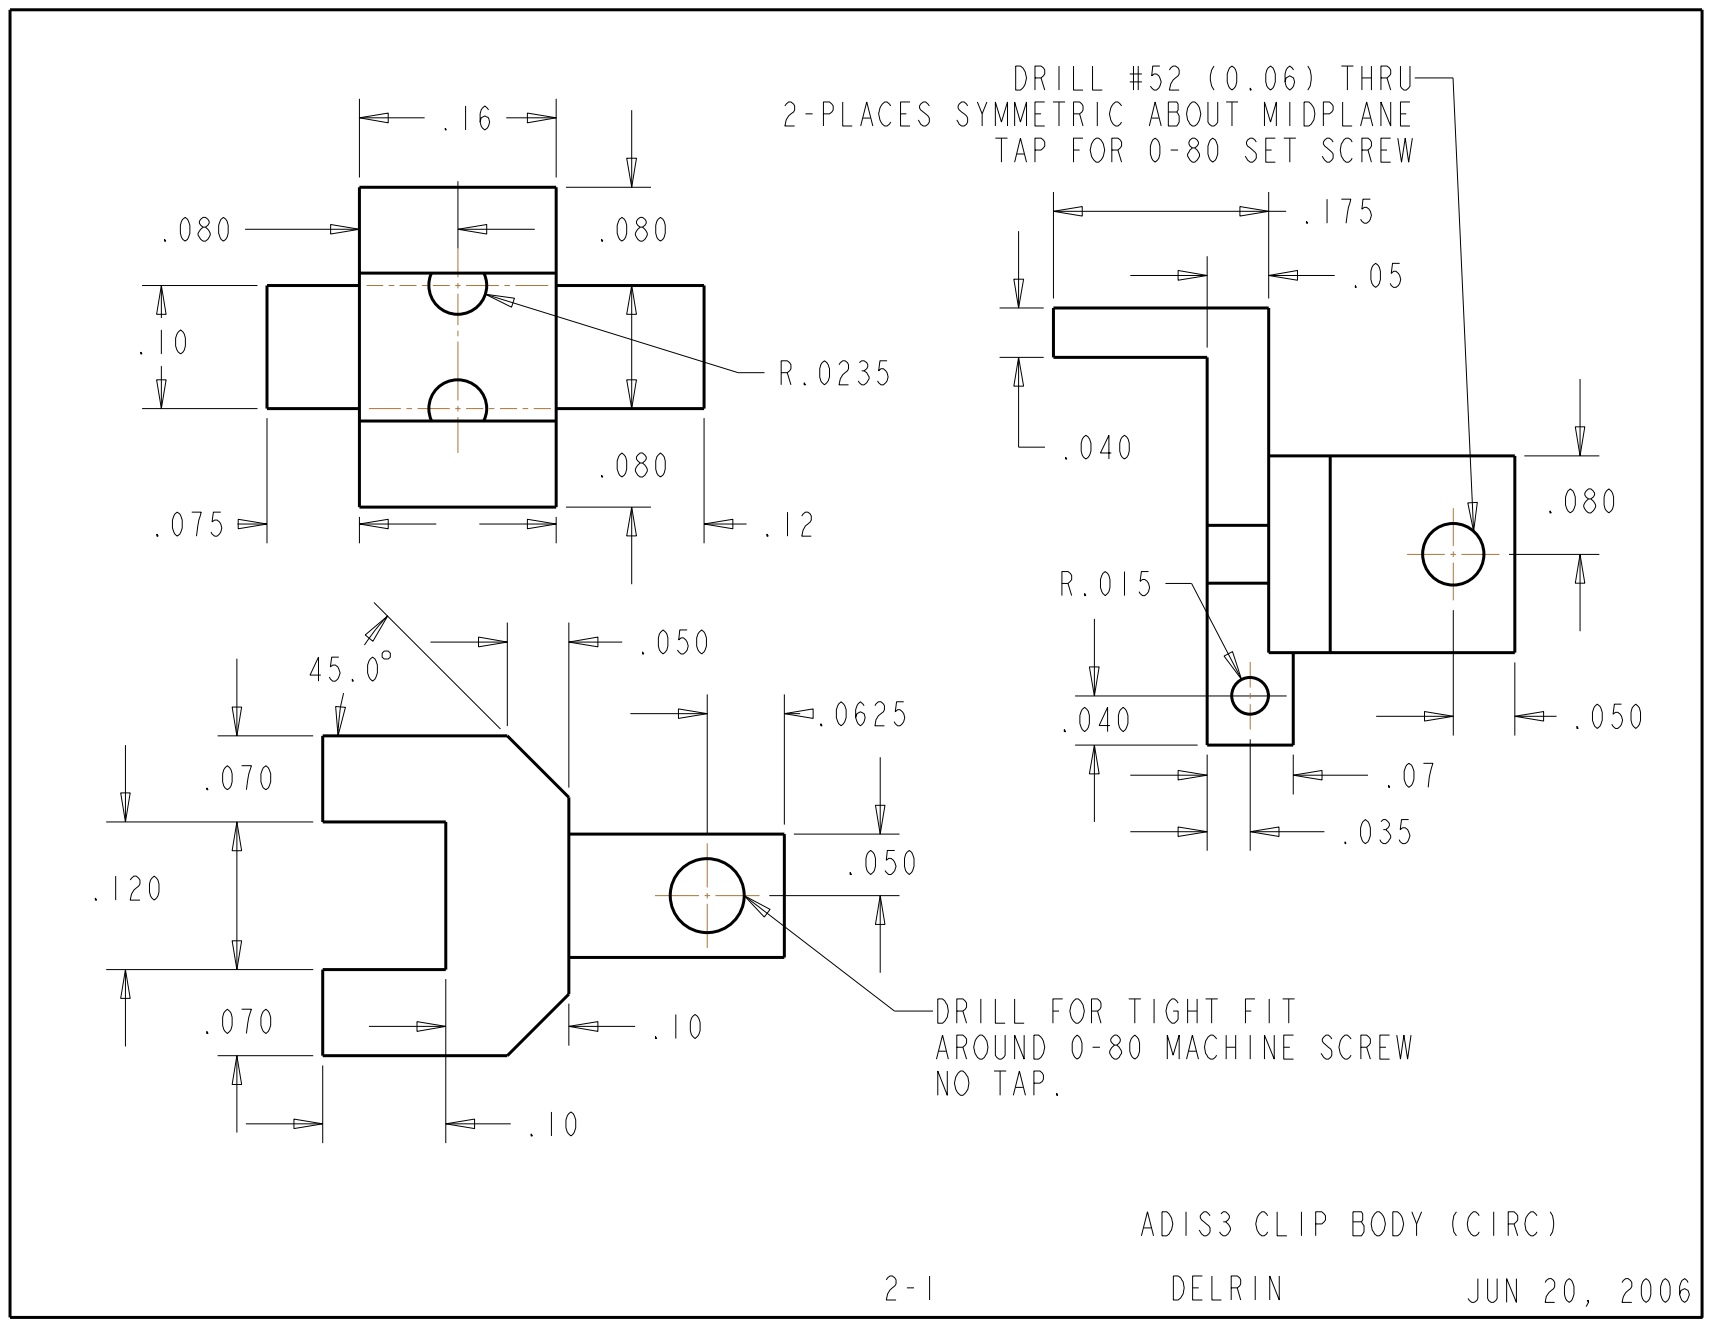
[picture p432: page 1]
