PorterMatt/CherenkovDetector/PDF files for final production assembly/Pro_ENGINEER - ADIS3_CLIP_BODY_CIRCULAR_ORTH.pdf

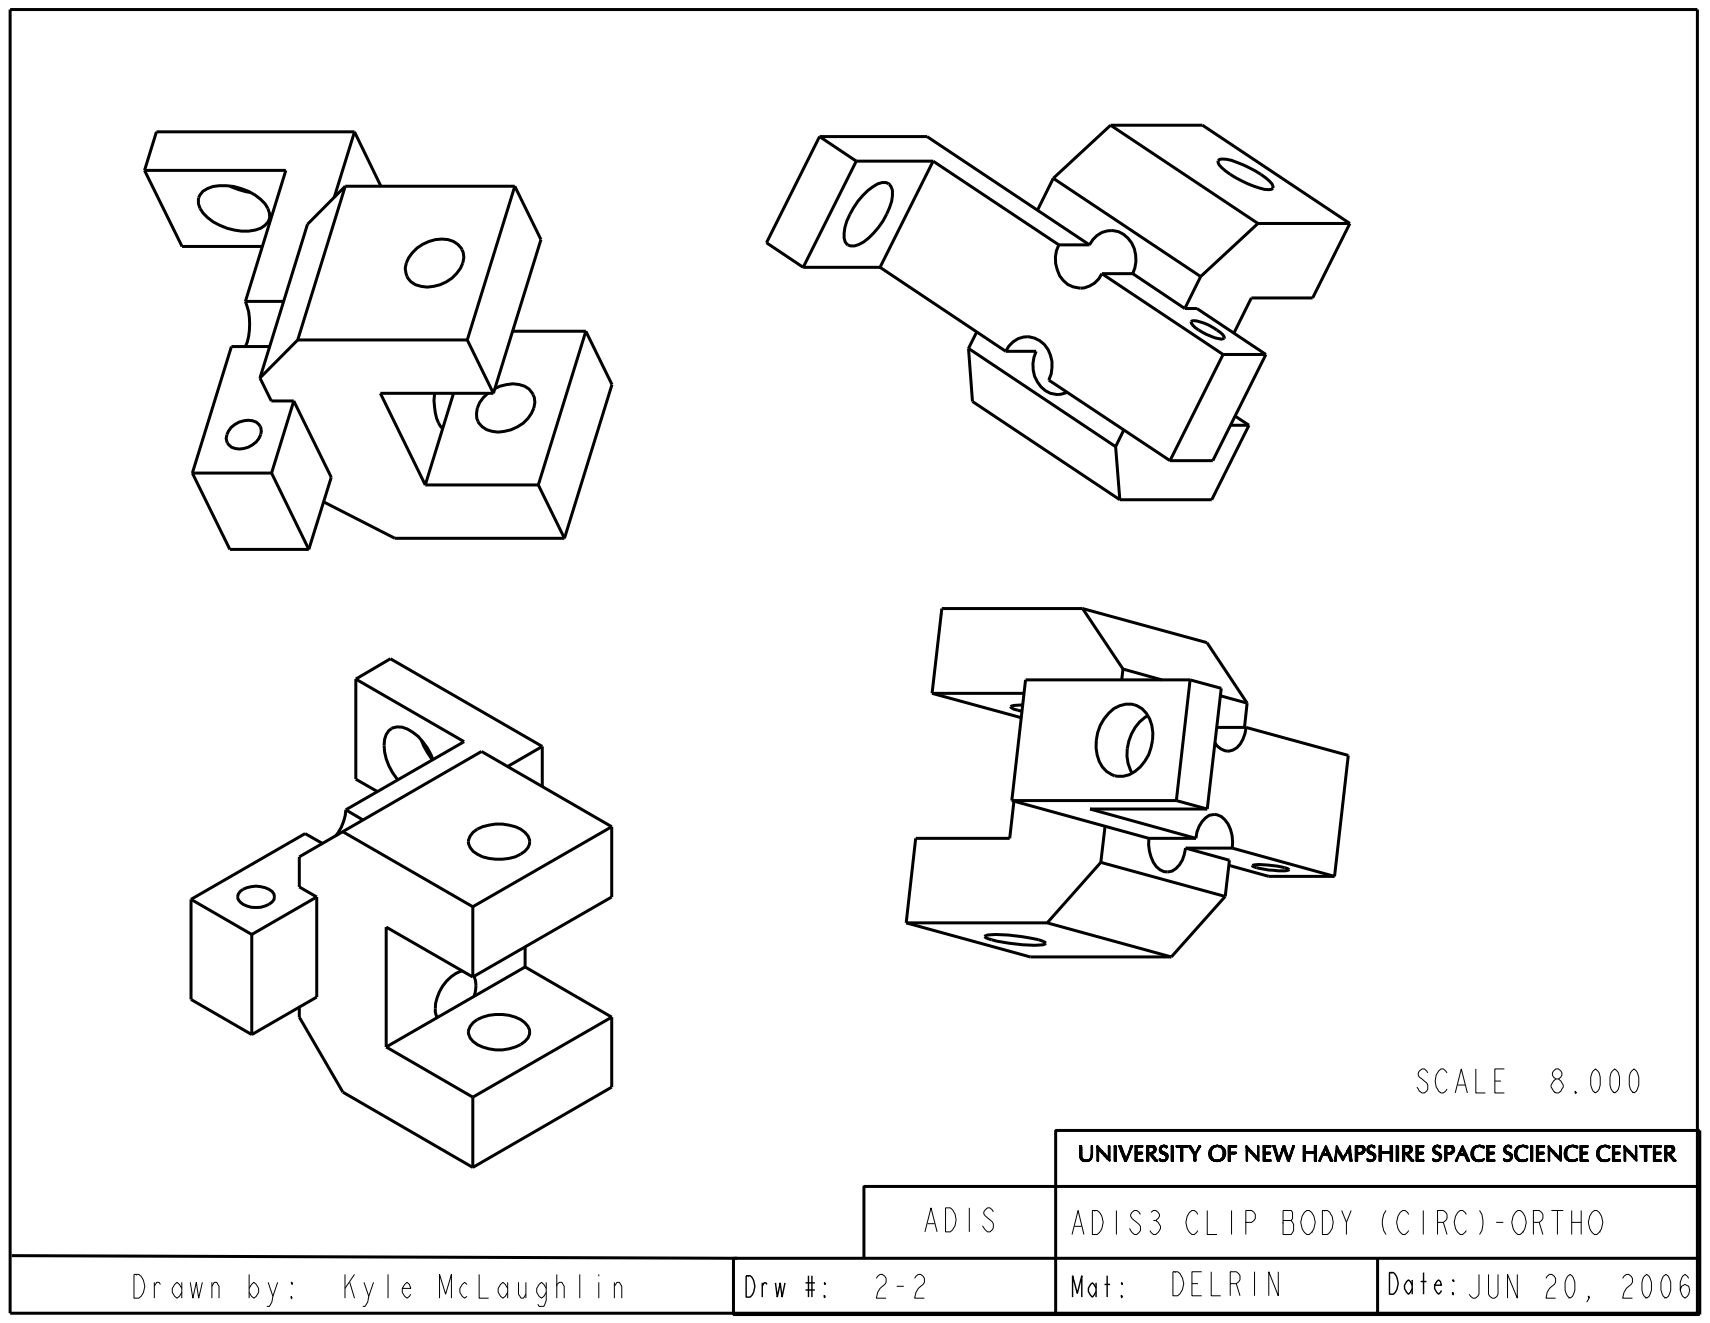
[picture p433: page 1]
