PorterMatt/CherenkovDetector/PDF files for final production assembly/Pro_ENGINEER - ADIS3_CLIP_BODY_ELIP_ORTHO.pdf

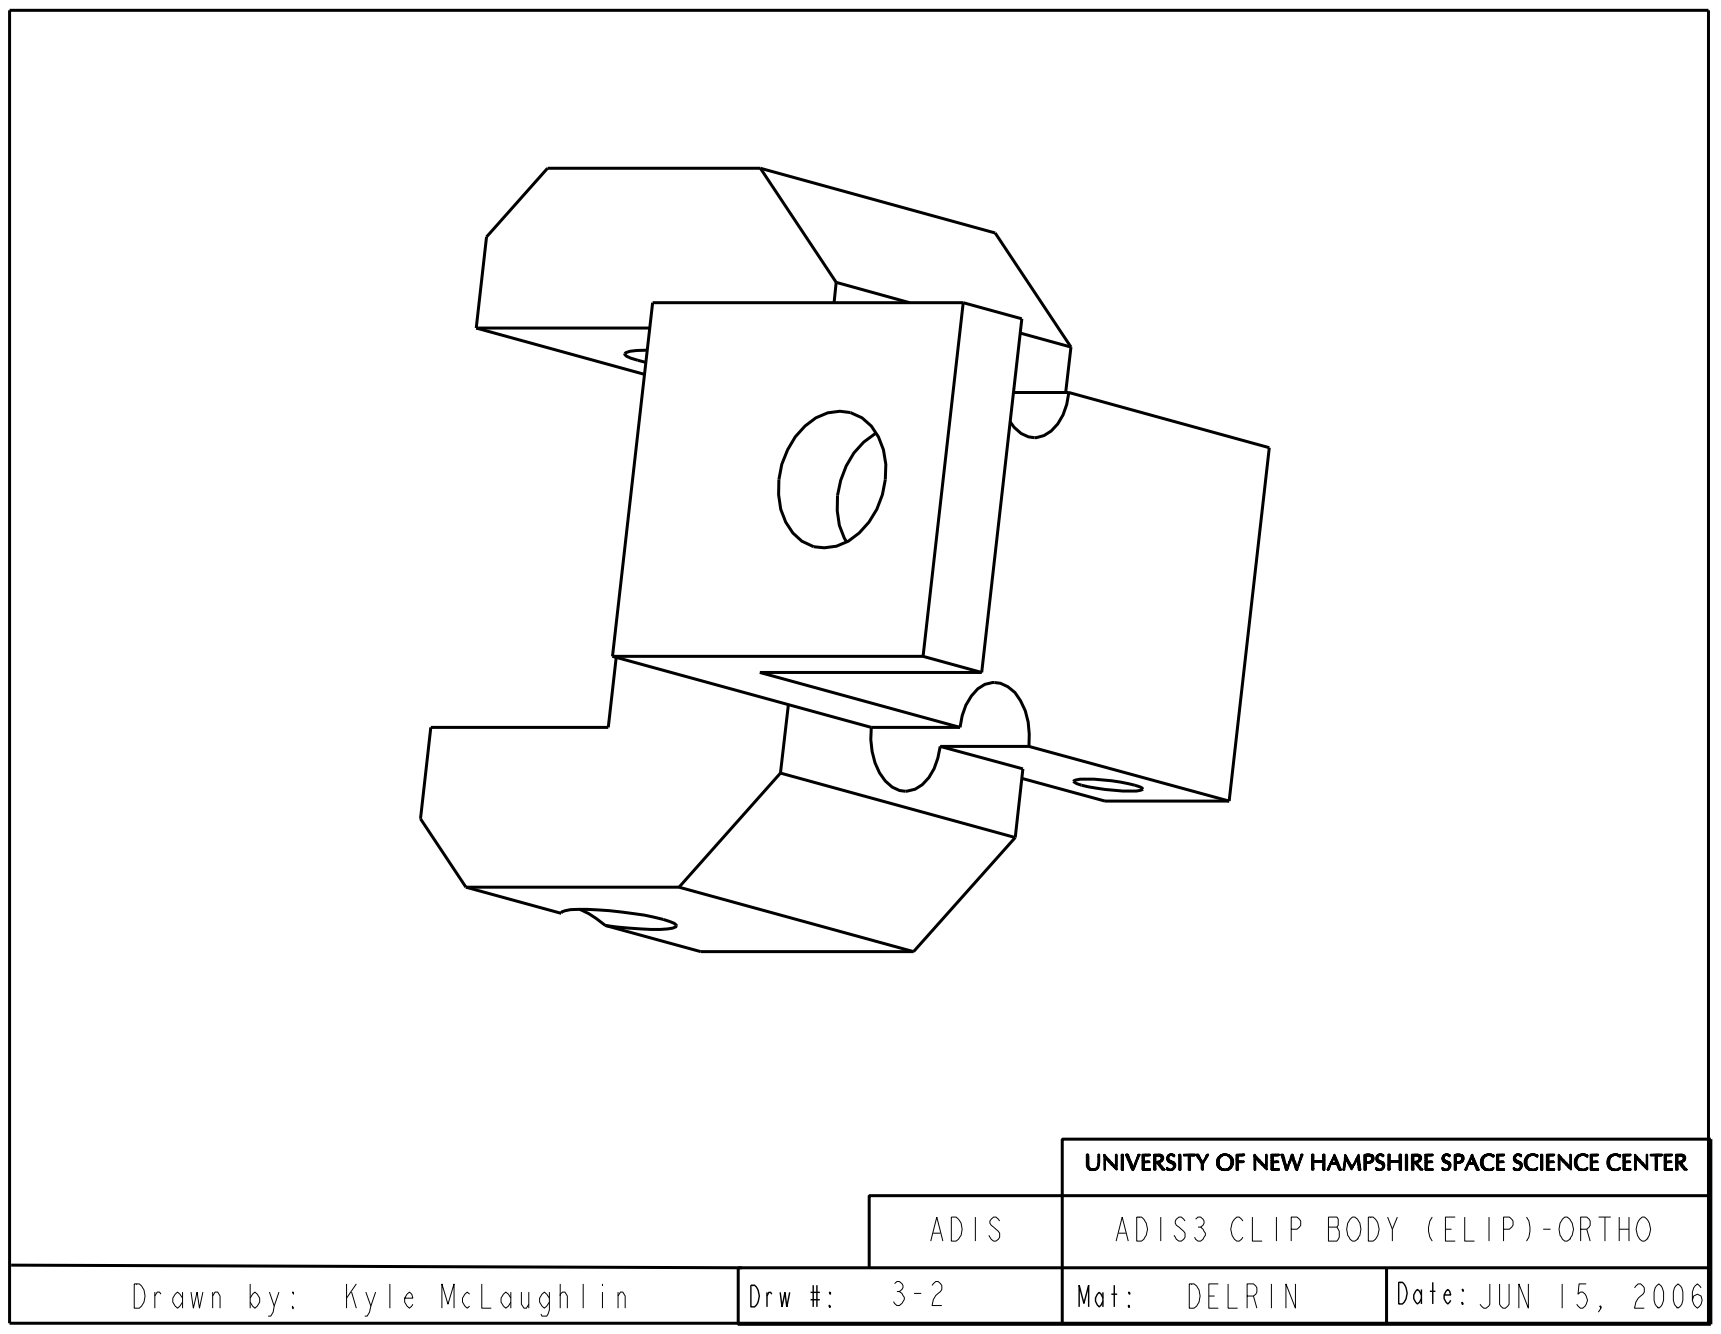
[picture p434: page 1]
