PorterMatt/CherenkovDetector/PDF files for final production assembly/Pro_ENGINEER - ADIS3_CLIP_BODY_ELLIP.pdf

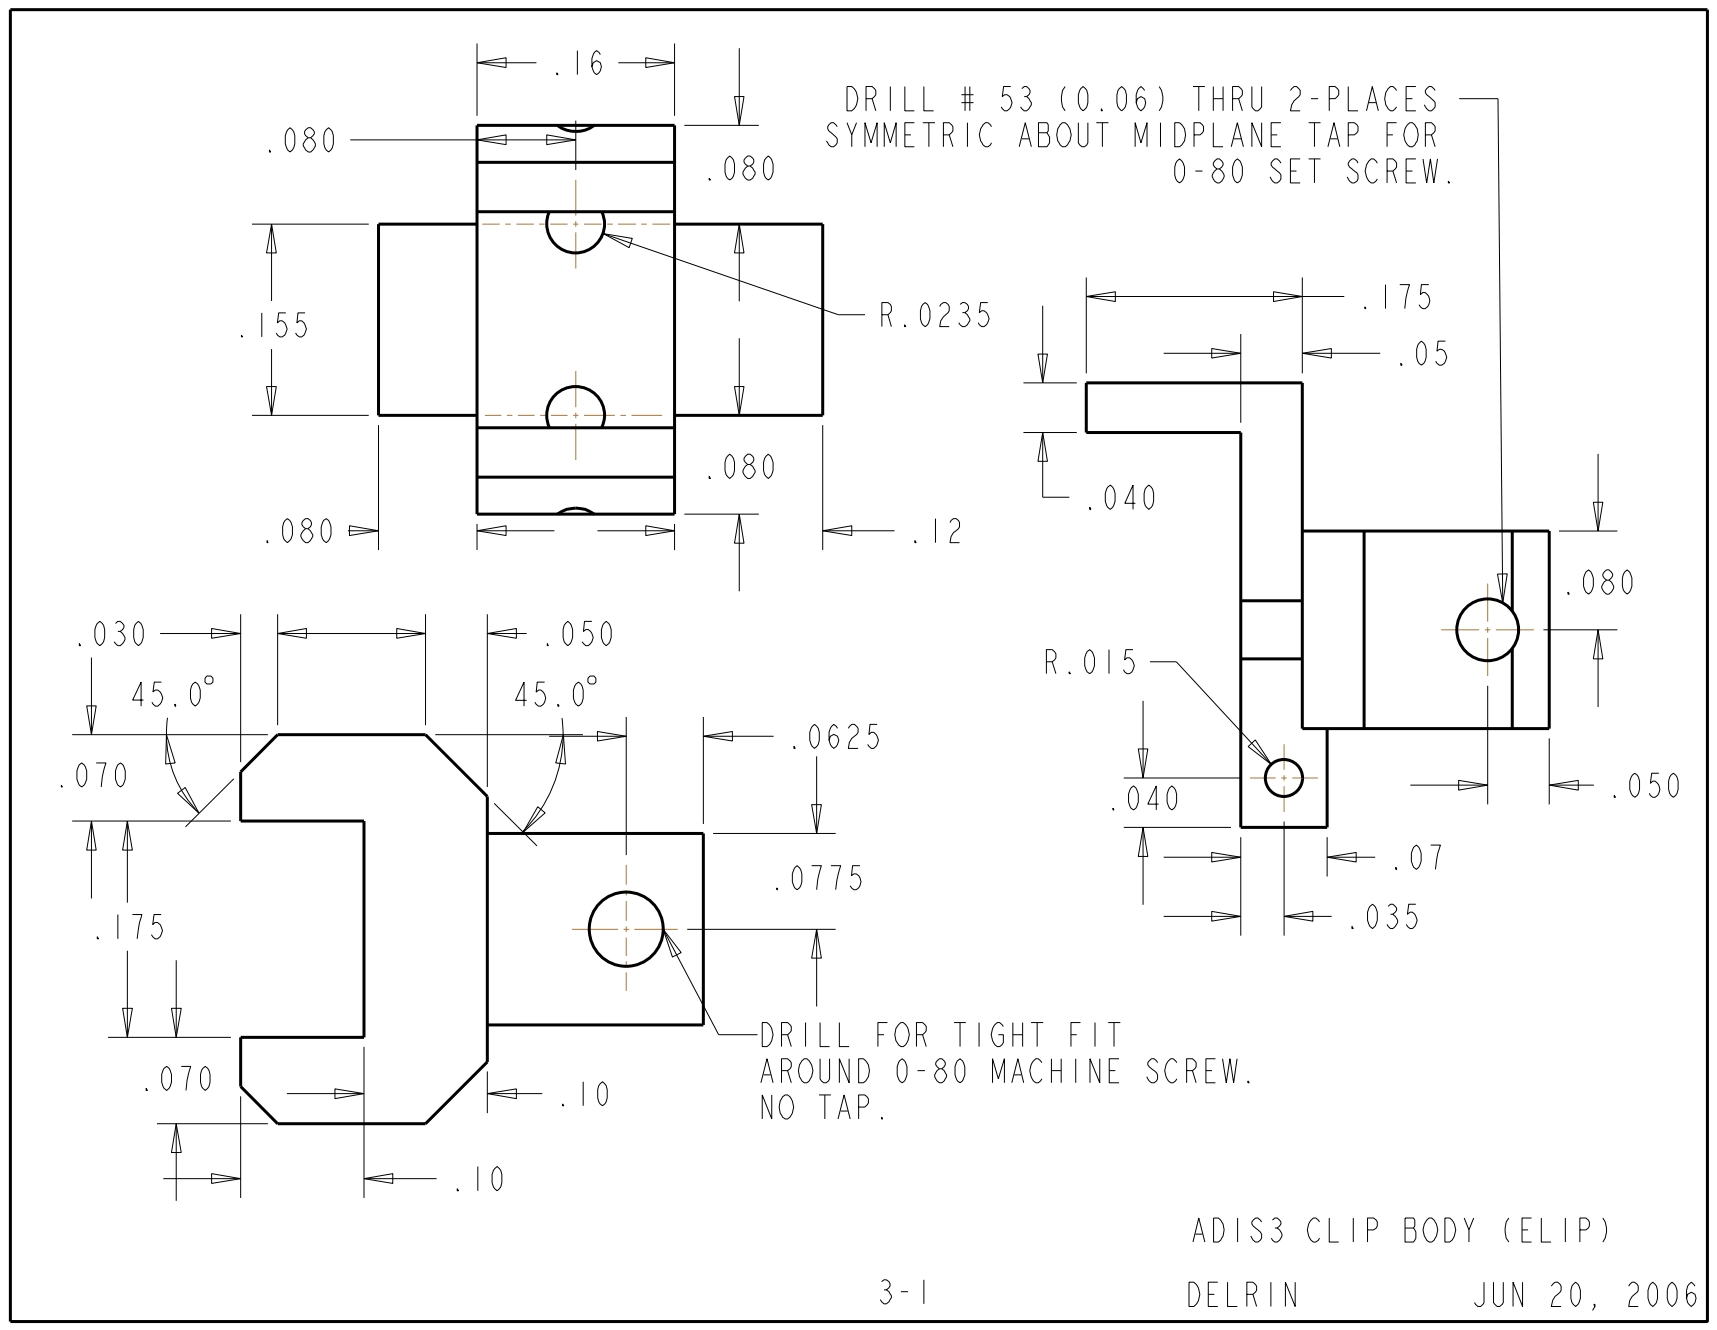
[picture p435: page 1]
