PorterMatt/CherenkovDetector/PDF files for final production assembly/Pro_ENGINEER - ADIS3_FULL_COLUMN.pdf

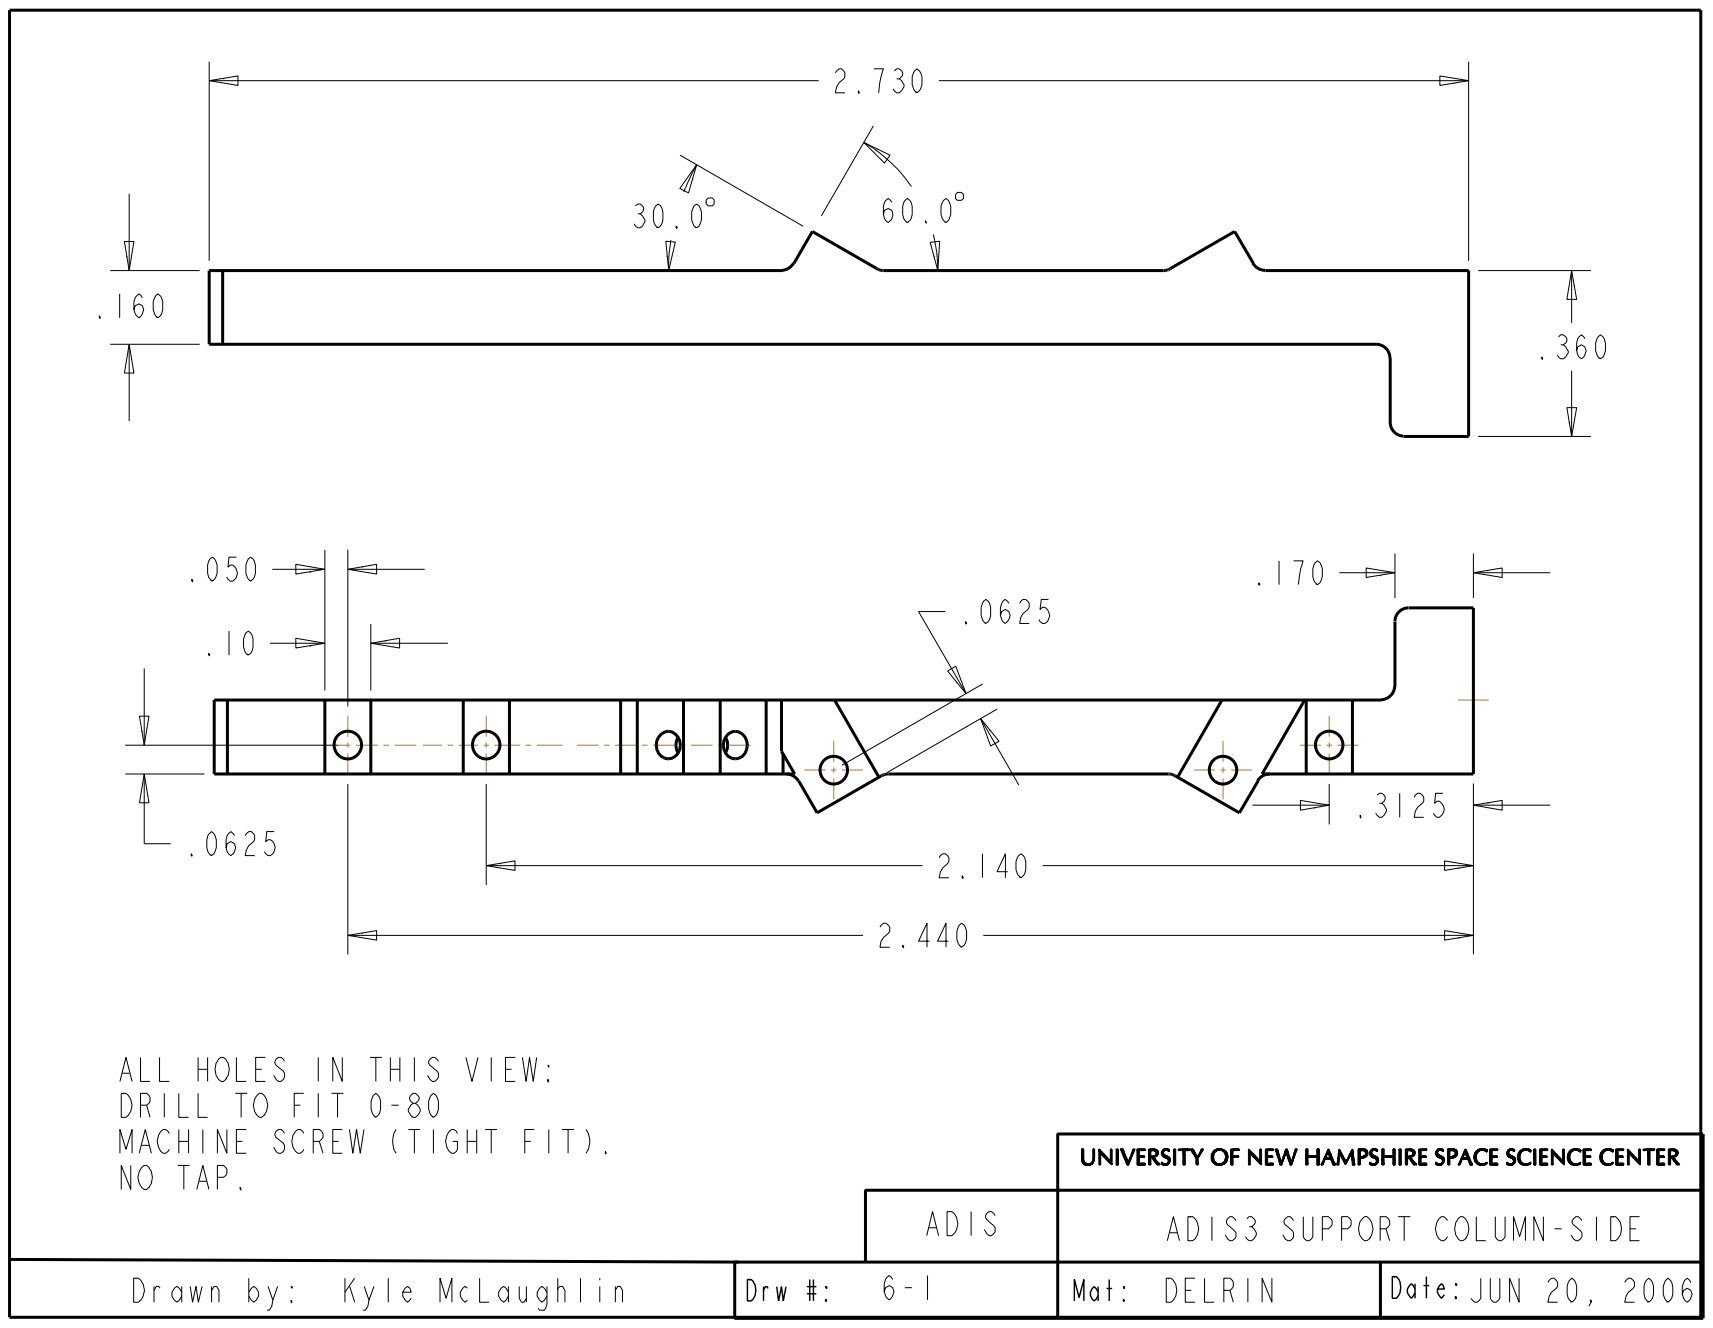
[picture p436: page 1]
