PorterMatt/CherenkovDetector/PDF files for final production assembly/Pro_ENGINEER - ADIS3_FULL_COLUMN2.pdf

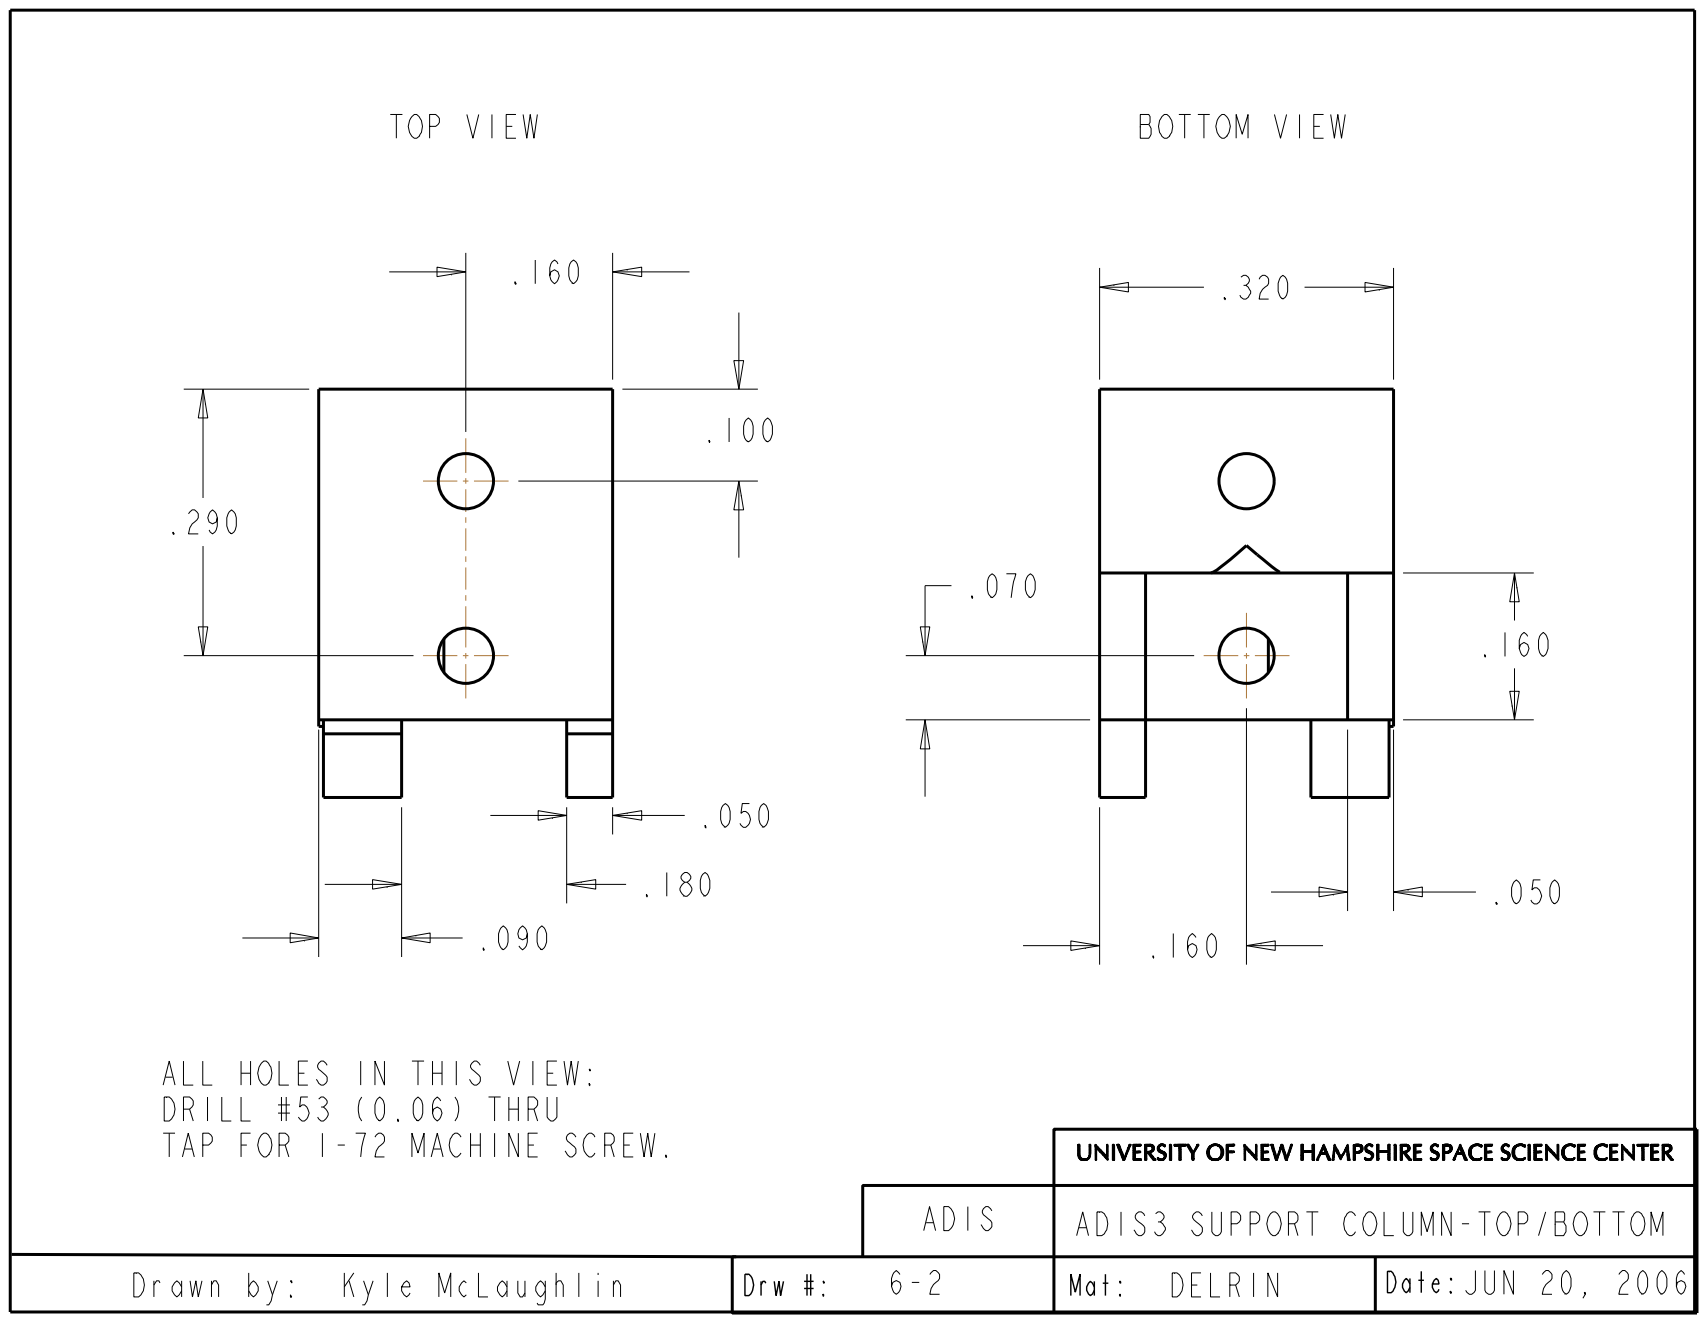
[picture p437: page 1]
