PorterMatt/CherenkovDetector/PDF files for final production assembly/Pro_ENGINEER - ADIS3_FULL_COLUMN3.pdf

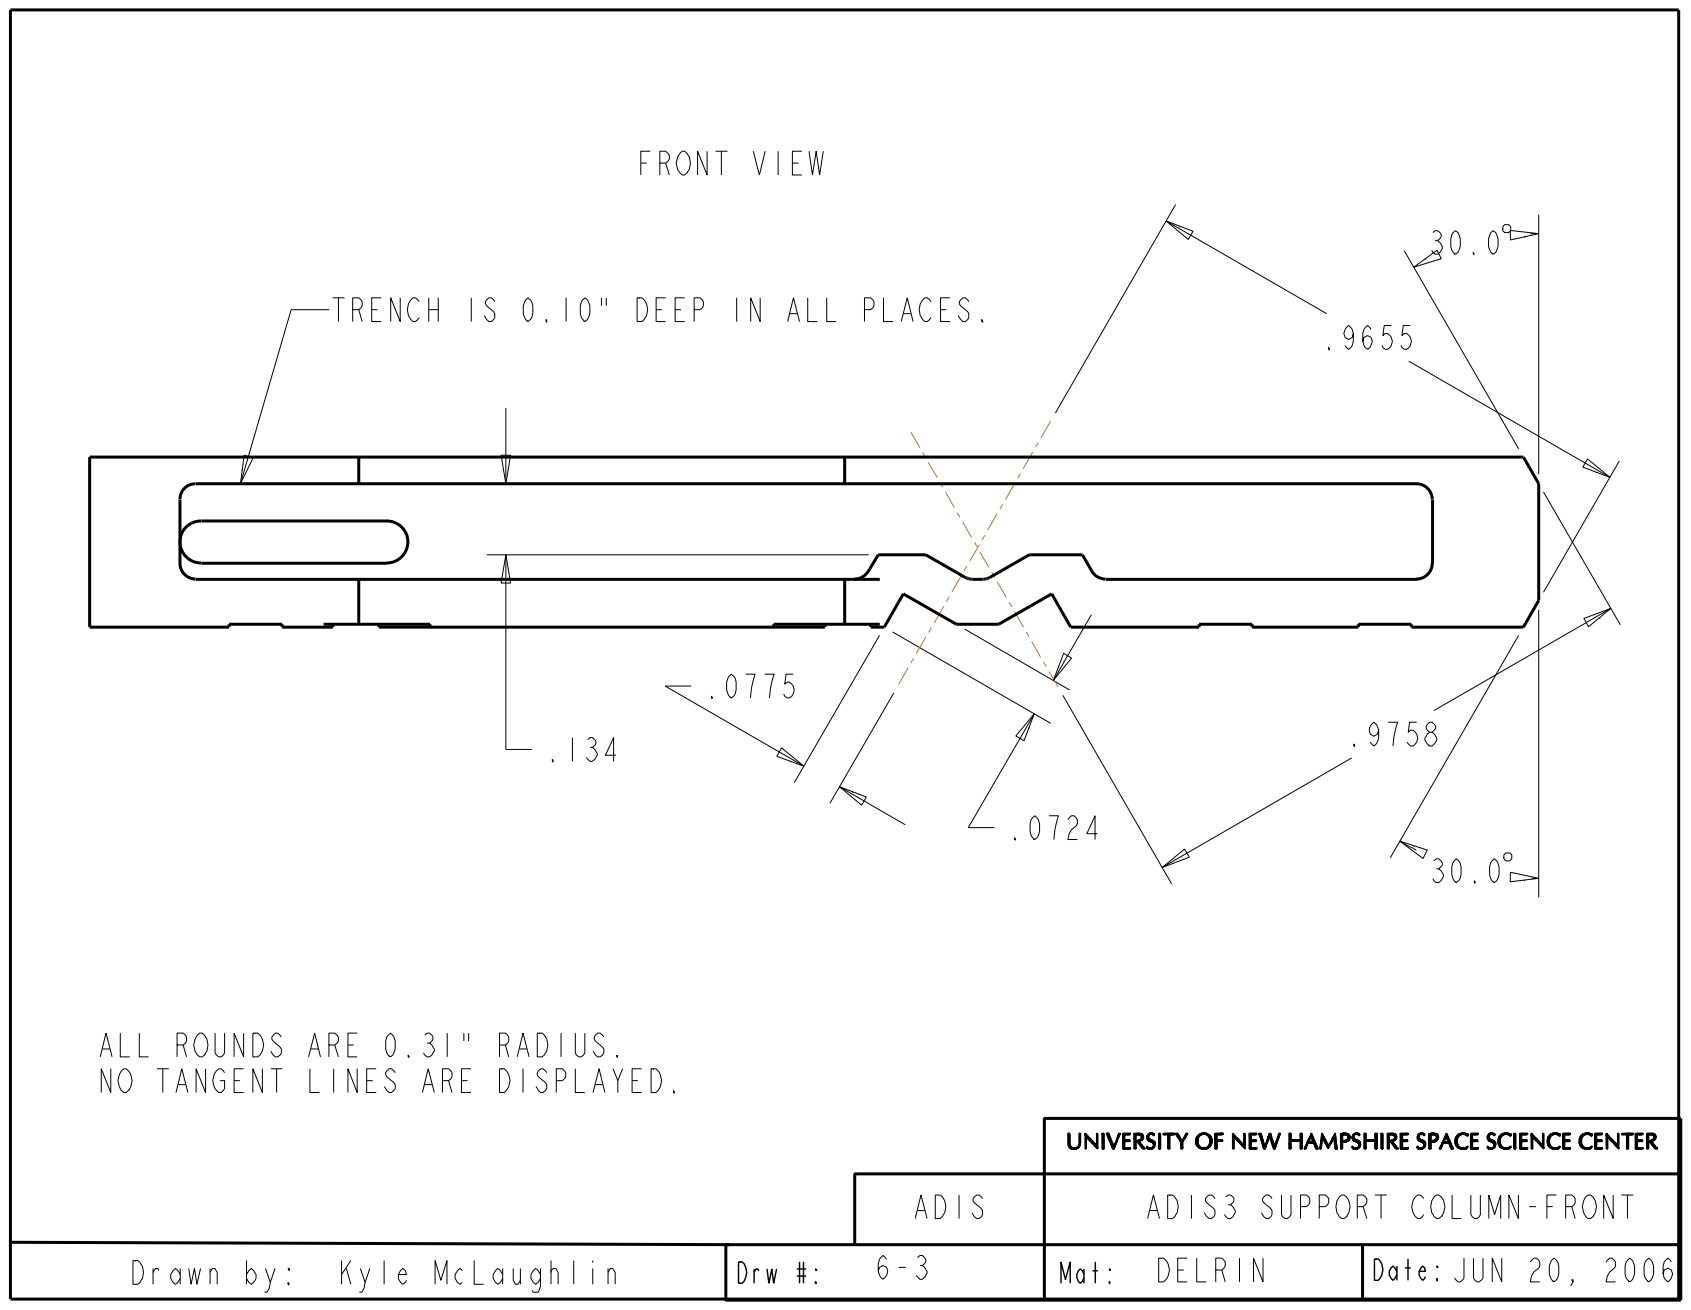
[picture p438: page 1]
