PorterMatt/CherenkovDetector/PDF files for final production assembly/Pro_ENGINEER - ADIS3_FULL_COLUMN4.pdf

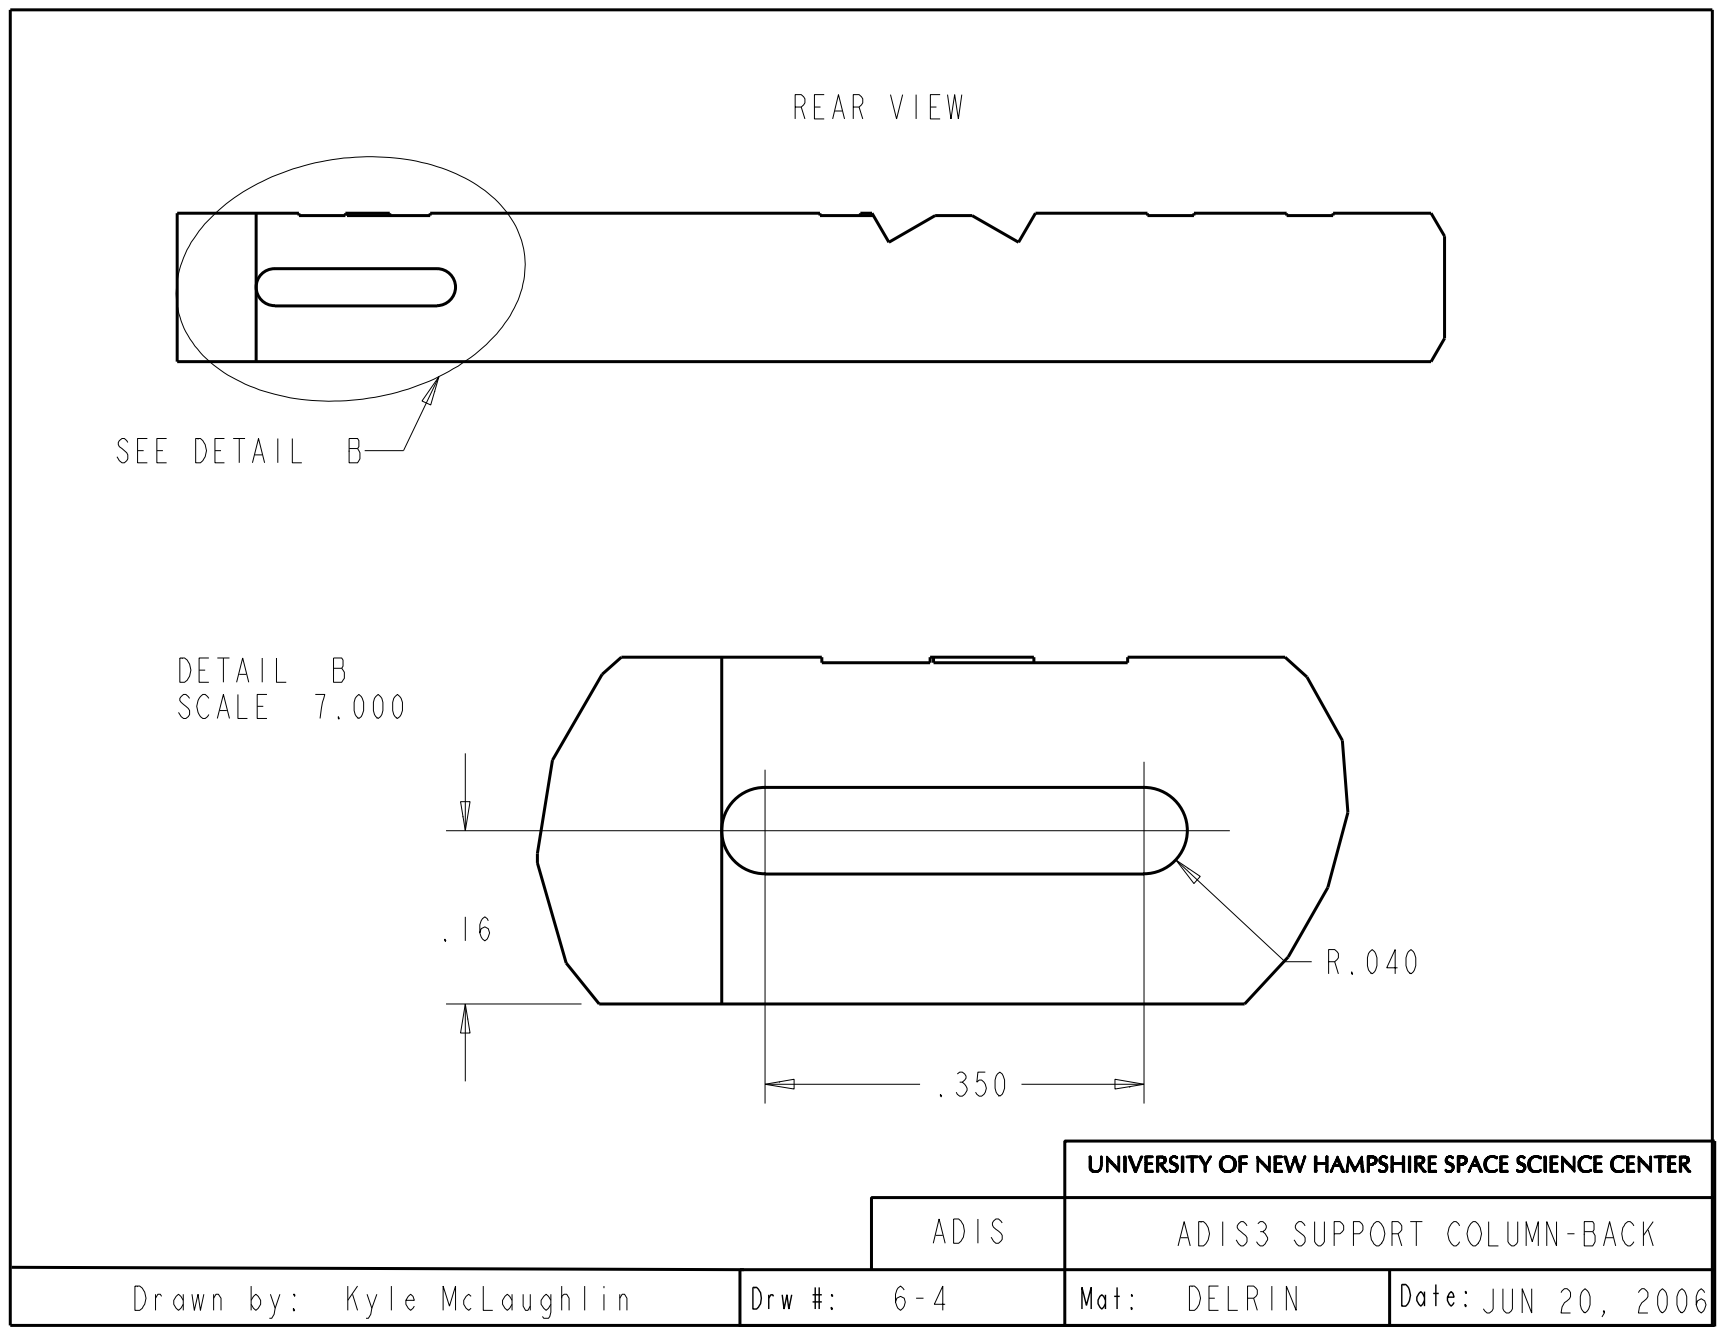
[picture p439: page 1]
