PorterMatt/CherenkovDetector/PDF files for final production assembly/Pro_ENGINEER - ADIS3_FULL_COLUMN5.pdf

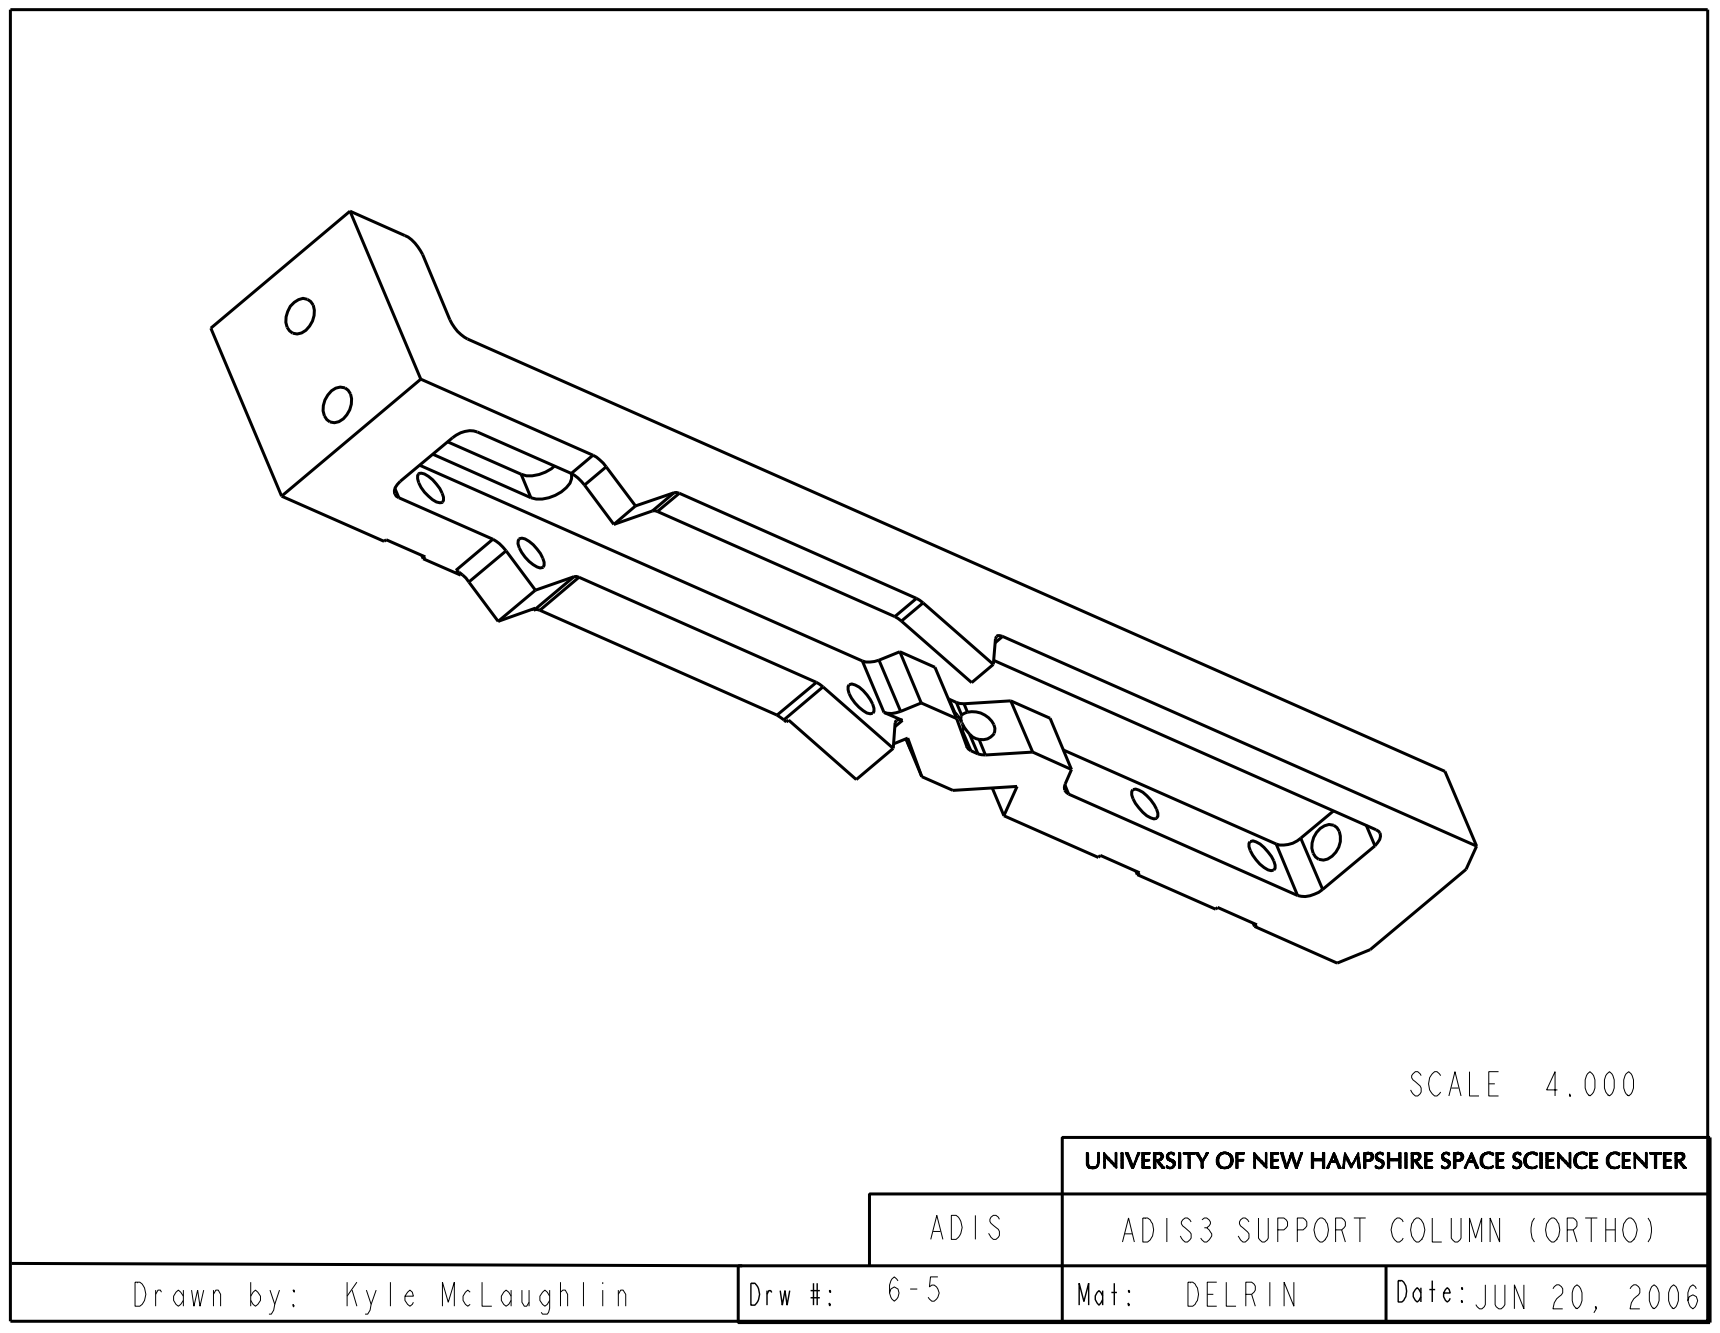
[picture p440: page 1]
