PorterMatt/CherenkovDetector/PDF files for final production assembly/Pro_ENGINEER - ADIS3_TOP_MOUNTING_RING.pdf

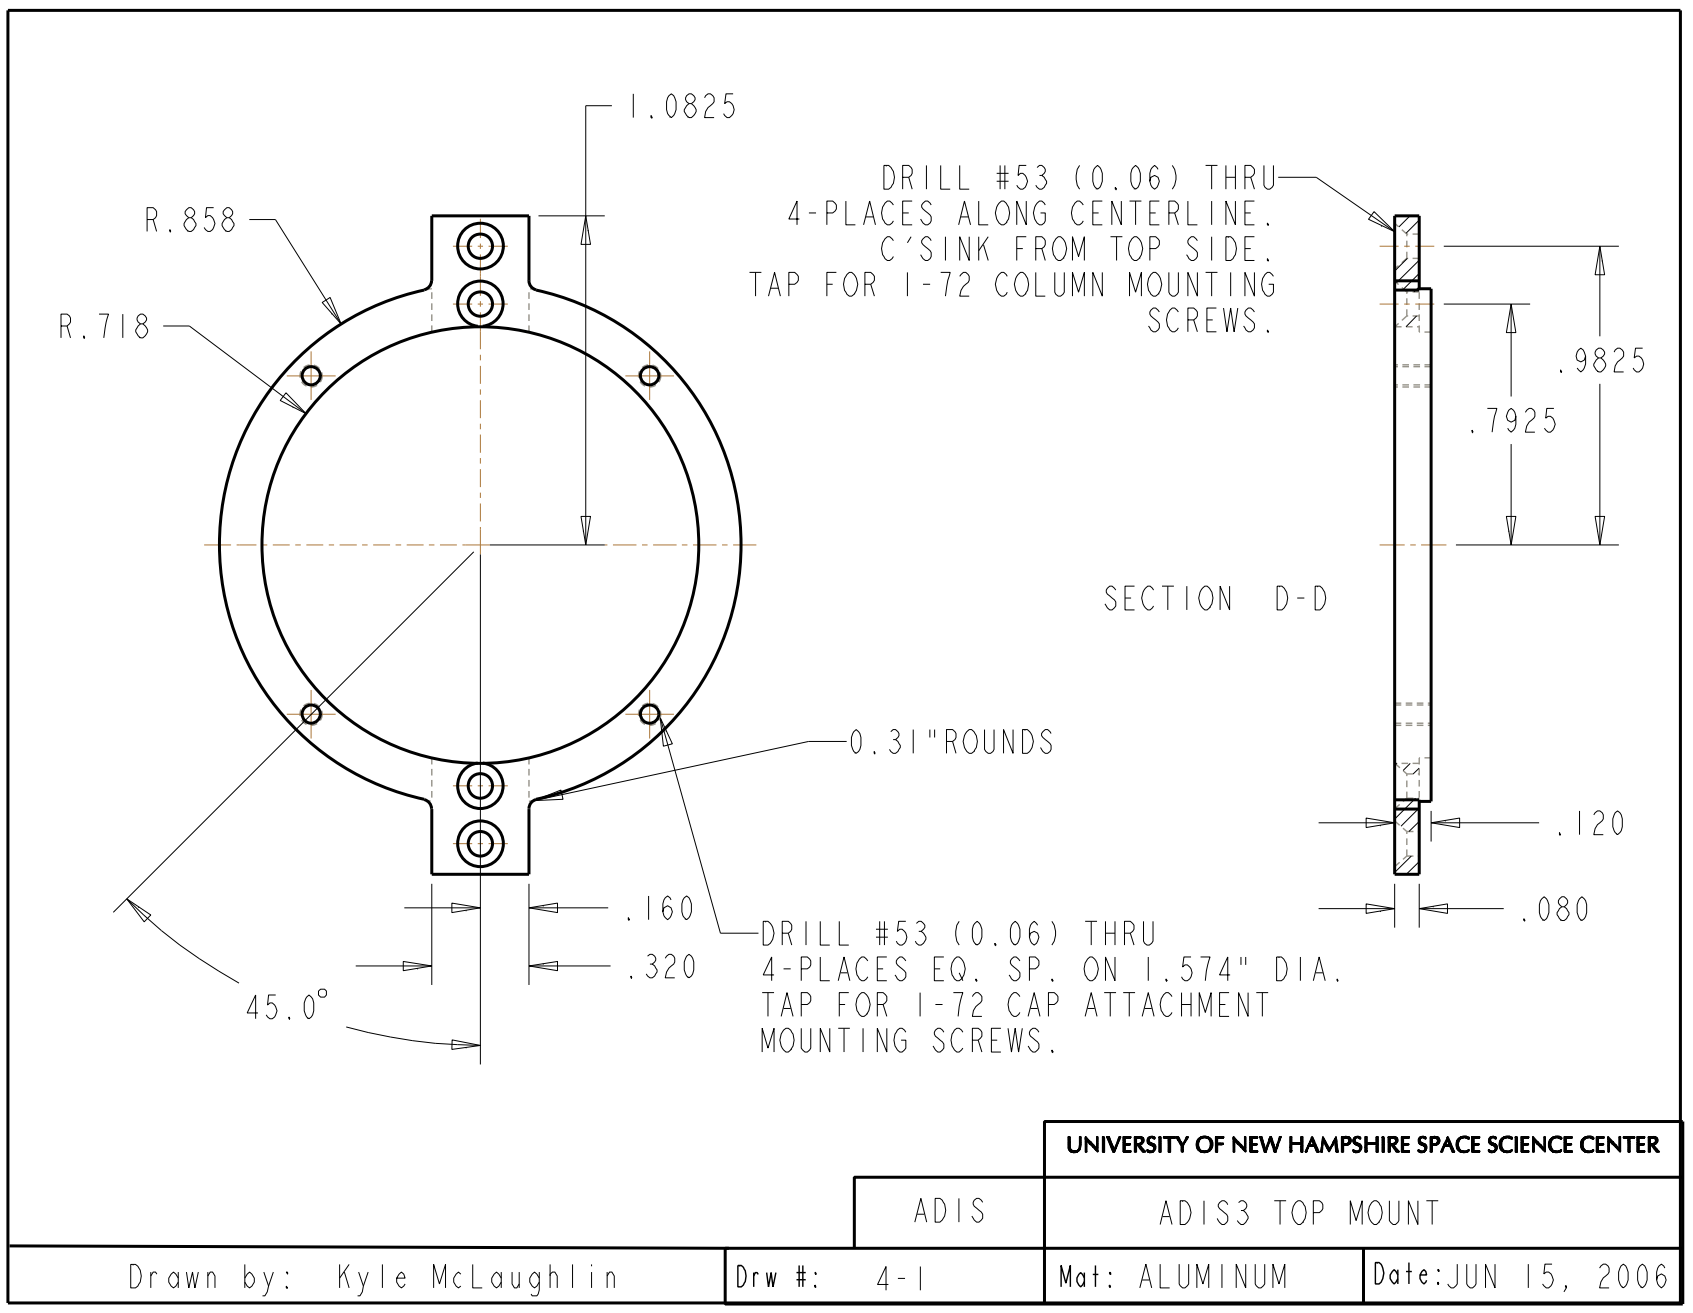
[picture p446: page 1]
