PorterMatt/CherenkovDetector/PICAP (Jim Connell)/PICAP drawings and BOM/Scintillator assembly/BGO drawing.PDF

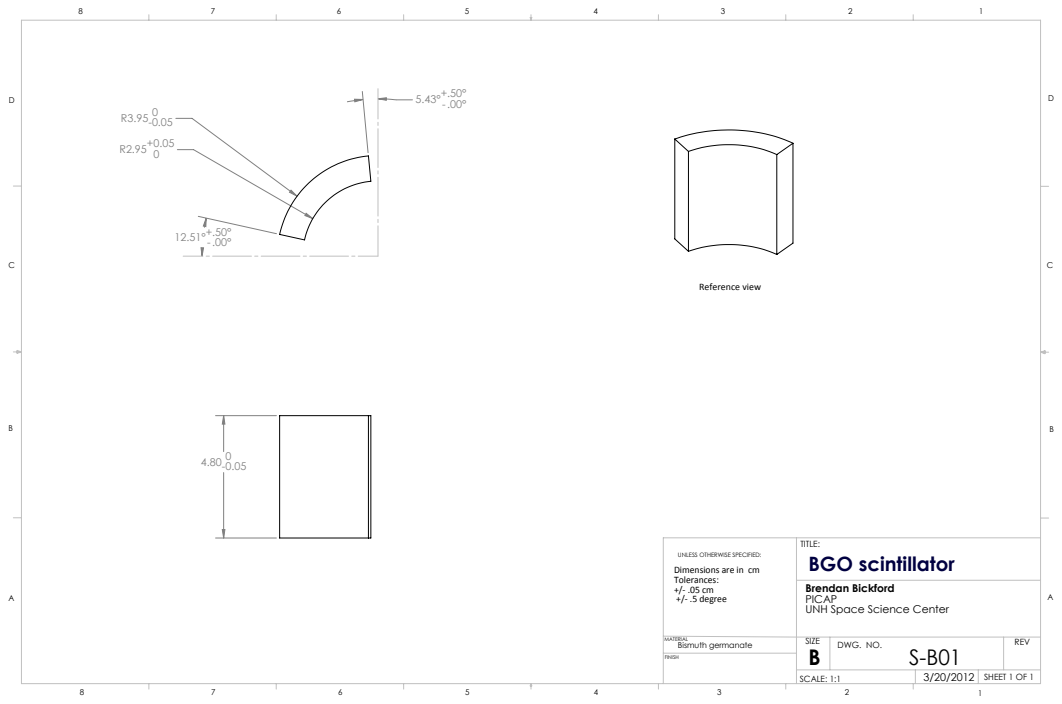
[picture p447: page 1]
Reference view; Bismuth germanate; DWG. NO.; REV; SCALE: 1:1; SHEET 1 OF 1; BGO scintillator

UNLESS OTHERWISE SPECIFIED:
Dimensions are in cm
Tolerances:
+/- .5 degree

Brendan Bickford
PICAP
UNH Space Science Center
