PorterMatt/CherenkovDetector/R12421-300-Y002_ Dimensional Outline.pdf

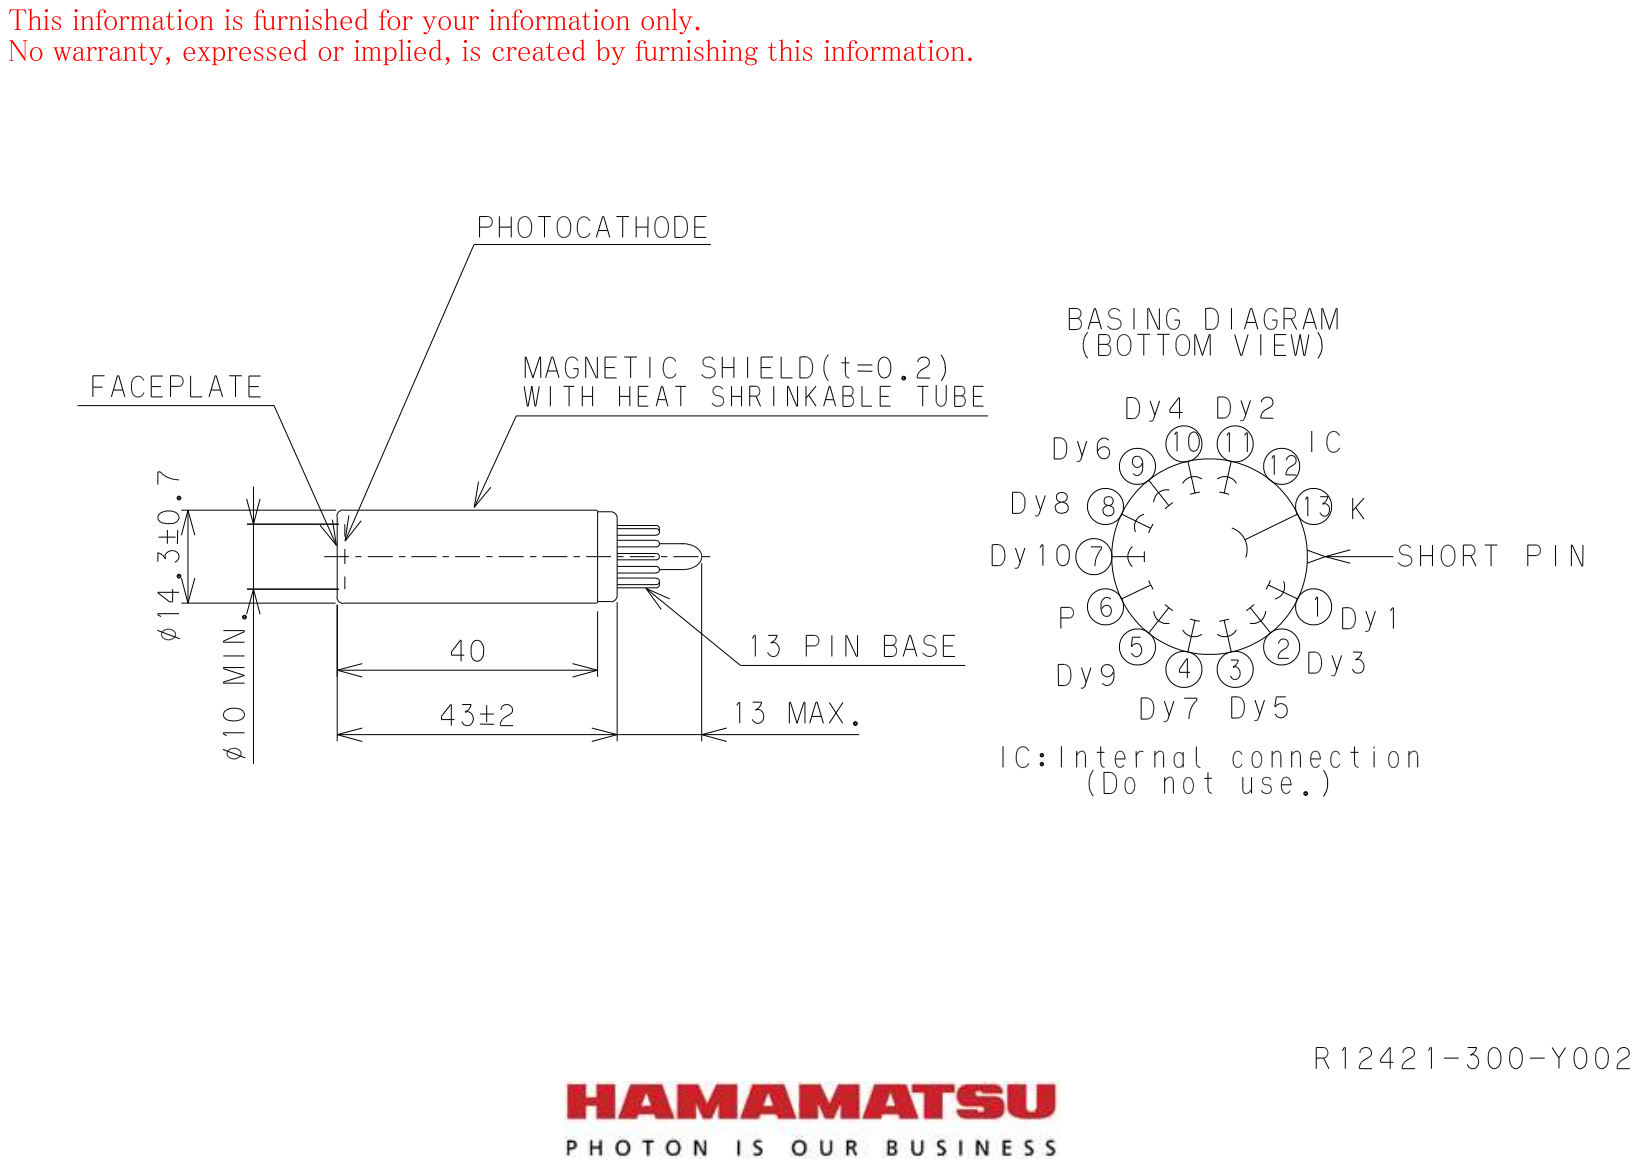
[picture p448: page 1]
