PorterMatt/CherenkovDetector/(commit log)

2020-10-03 Solidworks 2020 Update
    [Anticoincidence_Plastic.SLDDRW, Anticoincidence_Plastic.SLDPRT, Base_Bottom.SLDPRT, Base_Clip.SLDPRT, Cherenkov_Template.SLDPRT, Lightbox_1_Assembly.SLDASM, Lightbox_1_Assembly.SLDDRW, Lightbox_2_Assembly.SLDASM]
2020-10-03 2020 Update
    [Lightbox_1_Assembly.SLDASM, Lightbox_Lid_Top.SLDPRT]
2020-10-07 10/7 Update
    [91430A145_18-8 STAINLESS STEEL SLOTTED SCREWS.SLDPRT, Lightbox_1_Assembly.SLDASM, Lightbox_2_Assembly.SLDASM, Lightbox_Lid_Bottom.SLDPRT, Module_1.SLDASM, Module_2.SLDASM, Module_3.SLDASM, PMT_R12421_Frame.SLDPRT]
2020-10-14 10/14 Unparallel assembly
    [Anticoincidence_Plastic.SLDPRT, Lightbox_1_Assembly.SLDASM, Lightbox_1_Test_Stand.SLDASM, Lightbox_2_Assembly.SLDASM, Lightbox_Volume_Outside.SLDASM, Module_1.SLDASM, Module_1_Plastic.SLDASM, Module_1_Plastic_UnParallel.SLDASM]
2020-11-03 Design Review Changes
    [90910A922_LOW-PROFILE BUTTON HEAD TORX MACHINE SCREW.SLDPRT, Lightbox_1_Assembly.SLDASM, Lightbox_1_Test_Stand.SLDASM, Lightbox_2_Assembly.SLDASM, Lightbox_Lid_Bottom.SLDPRT, Lightbox_Lid_Bottom_Test.SLDPRT, Lightbox_Lid_Top.SLDPRT, Lightbox_Lid_Top_Test.SLDPRT]
2020-12-11 Peer Review Final Changes
    [98380A106_416 STAINLESS STEEL DOWEL PINS.SLDPRT, Lightbox_1_Assembly.SLDASM, Lightbox_Lid_Bottom.SLDPRT, Lightbox_Lid_Top.SLDPRT, Lightbox_Main_Housing.SLDPRT, PMT_R12421.SLDPRT, PMT_R12421_Frame.SLDPRT, PMT_Socket.SLDPRT]
2020-12-27 Lightbox Drawings Completed
    [Lightbox_1_Assembly.SLDASM, Lightbox_1_Assembly.SLDDRW]
2020-12-27 Added Pack and Go
    [Lightbox_1_Assembly.SLDASM]
2021-01-11 PDF Drawings
    [Lightbox_1_Assembly.SLDASM, Lightbox_1_Assembly.SLDDRW, Lightbox_Lid_Bottom.SLDDRW, Source_2.SLDPRT, Transparent_Plastic_Source_2.SLDDRW, Transparent_Plastic_Source_2.SLDPRT]
2021-01-14 Graphite Inserts now Equalize Pressure
    [Lightbox_1_Assembly.SLDASM, Lightbox_1_Assembly_Flat.SLDASM, Lightbox_Main_Housing.SLDPRT, PMT_Assembly_wSocket.SLDASM, PMT_R12421.SLDPRT, PMT_R12421_Frame.SLDPRT, Teflon_Lid_Bottom.SLDPRT, Teflon_Lid_Bottom_Flat.SLDPRT]
2021-01-25 Screw Update
    [Lightbox_1_Assembly_Flat.SLDASM, Lightbox_Main_Housing.SLDPRT]
2021-01-25 Drawings Finished
    [Lightbox_1_Assembly.SLDASM, Lightbox_1_Assembly.SLDDRW, Lightbox_1_Assembly_Flat.SLDASM, Lightbox_Lid_Bottom.SLDDRW, Lightbox_Lid_Bottom.SLDPRT, Lightbox_Lid_Top.SLDDRW, Lightbox_Lid_Top.SLDPRT, Lightbox_Main_Housing.SLDDRW]
2021-01-26 Finalized Drawings
    [Lightbox_1_Assembly.SLDASM, Lightbox_1_Assembly.SLDDRW, Lightbox_Main_Housing.SLDDRW, Lightbox_Main_Housing.SLDPRT]
2021-01-27 Finally Final Drawings - Xometry Order
    [Lightbox_1_Assembly.SLDASM, Lightbox_1_Assembly_Flat.SLDASM, Lightbox_2_Top.SLDASM, Lightbox_Lid.SLDDRW, Lightbox_Lid.SLDPRT, Lightbox_Lid_Bottom.SLDDRW, Lightbox_Lid_Bottom.SLDPRT, Lightbox_Lid_Top.SLDDRW]
2021-03-24 Updating Telescope
    [Anticoincidence_Plastic.SLDPRT, Lightbox_1_Assembly.SLDASM, Lightbox_Lid_Bottom.SLDPRT, Lightbox_Lid_Top.SLDPRT, Lightbox_Main_Housing.SLDPRT, Lightbox_Main_Housing_Insert.SLDPRT, Module_1.SLDASM, Module_1_Lid_Bottom.SLDPRT]
2021-04-12 New Lightbox w/ SSD included
    [Lightbox_1_Assembly_Telescope_CombinedSSD.SLDASM, Lightbox_Main_Housing_Telescope_CombinedSSD.SLDPRT, Module_2_Shell.SLDPRT, Teflon_Lid_Bottom_Flat_Combined.SLDPRT, Teflon_Lid_Top.SLDPRT, Teflon_Main Housing_Combined.SLDPRT, Teflon_Main Housing_Combined_Bottom.SLDPRT]
2021-04-13 4/13 Pt 2
    [Anticoincidence_Plastic.SLDPRT, Metal_Columns.SLDPRT, Module_1.SLDASM, Module_1_Brass_Holder.SLDPRT, Module_1_Lid_Top.SLDPRT, Module_1_Plastic.SLDASM, Teflon_Anti_Inner_Sleeve.SLDPRT, Teflon_Anti_Lid_Bottom.SLDPRT]
2021-04-18 4/18 Changes
    [Lightbox_1_Assembly.SLDASM, Lightbox_1_Assembly_Flat.SLDASM, Lightbox_1_Assembly_Telescope_CombinedSSD.SLDASM, Lightbox_2_Assembly.SLDASM, Module_1.SLDASM, Module_1_Plastic.SLDASM, Module_2_Lid_Top_Combined.SLDPRT, Teflon_Anti_Inner_Sleeve.SLDPRT]
2021-05-04 Alice Changes 5/4
    [Lightbox_1_Assembly_Telescope_CombinedSSD.SLDASM, Module_1_Volume.SLDPRT, Telescope_Assembly_Parallel.SLDASM]
2021-05-05 Finalized Nitrogen Calculations
    [Lightbox_1_Assembly_Telescope_CombinedSSD.SLDASM, Module_2_Volume.SLDPRT, Telescope_Assembly_Parallel.SLDASM, Telescope_Assembly_Parallel_Volume_Mod1.SLDPRT]
2021-05-11 Fixed Wire holes and nitrogen holes
    [Lightbox_1_Assembly_Telescope_CombinedSSD.SLDASM, Lightbox_Main_Housing_Telescope_CombinedSSD.SLDPRT, Module_1.SLDASM, Module_1_Lid_Bottom.SLDPRT, Module_1_Plastic.SLDASM, Module_1_Shell.SLDPRT, Module_2_Lid_Bottom_Combined.SLDPRT, Module_2_Lid_Top_Combined.SLDPRT]
2021-06-03 Added Old Project Files
    [25mm MCP detector.SLDPRT, 8020-1010.SLDPRT, 8020-4080-DEFAULT.SLDPRT, 8020-4107-DEFAULT.SLDPRT, 8020-4118-DEFAULT.SLDPRT, 8020-4265.SLDPRT, 90degClip.SLDPRT, AL_D4_PTFE.SLDPRT]
2021-06-07 6/7 Update
    [Lightbox_TestMount.SLDPRT, SSD_Model.SLDPRT]
2021-06-24 SSD Mount Updates
    [Lightbox_TestMount_V2.SLDPRT, SSD_BrassContact.SLDPRT]
2021-06-30 Adding Shop Computer
    [25mm MCP detector.SLDPRT, Al2O3-TU-C-1000.SLDPRT, Al2O3-TU-C-250.SLDPRT, Al2O3-TU-C-500.SLDPRT, Aluminum MCP Signal Ground Cup.SLDPRT, Aluminum Spider.SLDPRT, Delrin Front Grid Support for joining tubes.SLDPRT, Delrin Front Grid Support.SLDPRT]
2021-06-30 Fixing Filename Length
    [Front Grid Section Assy.SLDASM, Front Grid Section Tube.SLDPRT, Front Grid Support Ring.SLDPRT, Front Grid at chassis ground.SLDPRT, Front Grid.SLDPRT, Instrument Stand.SLDPRT, MCP Anode Plate.SLDPRT, MCP and Spider Assembly.SLDASM]
2021-06-30 Test Mount Changes
    [Lightbox_TestMount_V2.SLDPRT]
2021-07-07 SSD Parts
    [Lightbox_TestMount_V1.SLDPRT, Lightbox_TestMount_V2.SLDPRT, SSD_Alternate_Clasp.SLDPRT, SSD_BrassContact.SLDPRT, SSD_Guard.SLDPRT, SSD_LClasp.SLDPRT, SSD_Model.SLDPRT, SSD_Mount_Cap.SLDPRT]
2021-07-16 Design Icons
    [Model1.SLDPRT]
2021-07-20 Design Changes
    [Model1.SLDPRT]
2021-07-27 SSD Test Mount Changes
    [91292A337_18-8 Stainless Steel Socket Head Screw.SLDPRT, Lightbox_TestMount_V1.SLDPRT, Lightbox_TestMount_V2.SLDPRT, Reference Size for Stack.SLDPRT, SSD_Alternate_Clasp.SLDPRT, SSD_BrassContact.SLDPRT, SSD_Clasp_V1.SLDPRT, SSD_Clasp_V2.SLDPRT]
2021-07-27 Mount Changes
    [SSD_Contact_Stack_V2.SLDPRT, SSD_Module_V3.SLDASM, SSD_Stack_Cap.SLDPRT, SSD_Stack_Full_V3.SLDASM]
2021-07-30 Stack Changes
    [SSD_Clasp_V3.SLDPRT, SSD_Module_V3.SLDASM, SSD_Stack_Cap.SLDPRT, SSD_Stack_Full_V3.SLDASM]
2021-09-02 Fixing Errors
    [PEEK washer.SLDPRT, ringed anode.SLDPRT]
2021-10-08 Delete Nano-Dust Analyzer (NDA) (Bruno Pape) directory
    Filename issues are more trouble than it's worth
    [25mm MCP detector.SLDPRT, 8020-1010.SLDPRT, 8020-4080-DEFAULT.SLDPRT, 8020-4107-DEFAULT.SLDPRT, 8020-4118-DEFAULT.SLDPRT, 8020-4265.SLDPRT, 90degClip.SLDPRT, Al2O3-TU-C-1000.SLDPRT]
2021-10-12 Xometry Changes
    [Lightbox1_Module_V2.SLDASM, Lightbox_MainHousing_V3.SLDPRT, Lightbox_TestMount_V2.SLDDRW, Lightbox_TestMount_V2.SLDPRT, SSD_Module_V3.SLDASM, SSD_Stack_Full_V5.SLDASM, SSD_Test_Assembly.SLDASM, Telescope_Size_Reference_V4.SLDASM]
2022-01-09 Telescope Shell Updates
    [91292A311_18-8 Stainless Steel Socket Head Screw.SLDPRT, 92010A781_Passivated 18-8 Stainless Steel Phillips Flat Head Screw.SLDPRT, 92010A815_Passivated 18-8 Stainless Steel Phillips Flat Head Screw.SLDPRT, 92855A841_18-8 Stainless Steel Low-Profile Socket Head Screws.SLDPRT, Aluminum_LeftOuterShell.SLDPRT, Aluminum_OuterShell.SLDPRT, Aluminum_RightOuterShell.SLDPRT, Lightbox1_Module_V2.SLDASM]
